sinje0816/stamping_press/SYEI_stamping_press_system/new_stamping_press/new/INVERTERBRACKET/EWR14S01-變頻器固定座.PDF

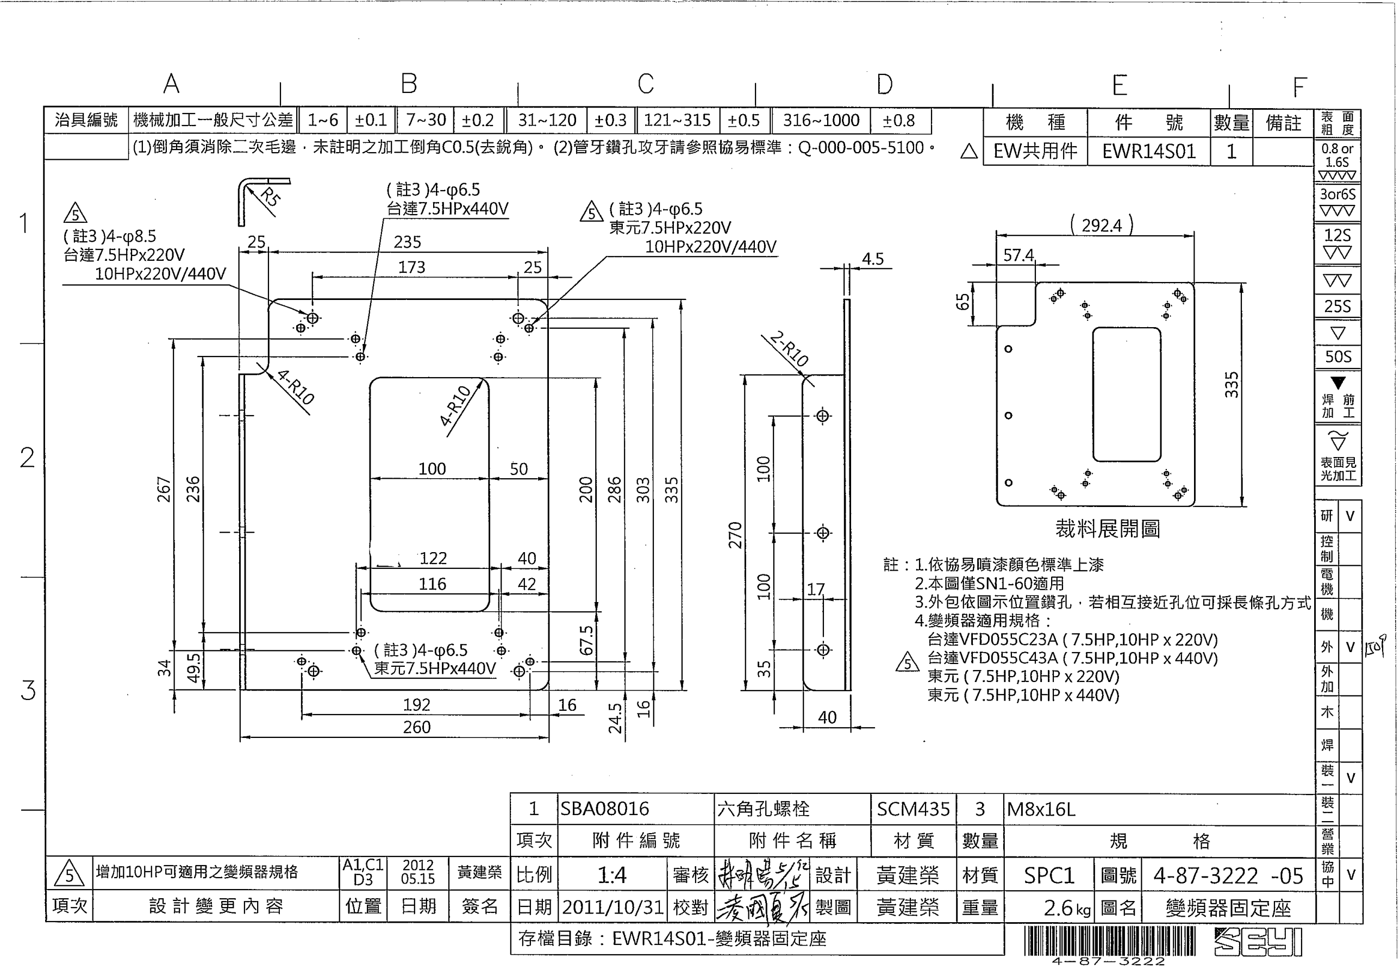
[picture p1: page 1]
