sinje0816/stamping_press/SYEI_stamping_press_system/協易杯bead/dist/seyi/T溝詳圖.png

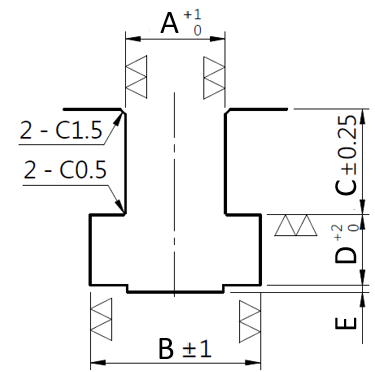
SYEI_stamping_press_system/協易杯bead/dist/seyi/T溝詳圖.png
