sinje0816/stamping_press/SYEI_stamping_press_system/組立尺寸.xlsx

Sheet: Assembly
編號 | 零件1 | 零件2 | 尺寸 | 平面 | 偏移方式
1 | FRAME35.1 | FRAME1.1 | 0 | xy plane | 1 | 0
2 | FRAME35.1 | FRAME1.1 | apv['FRAME1']["B"] | yz plane | 0
3 | FRAME35.1 | FRAME1.1 | (apv['FRAME22']['D']-Ass_A)/2+(apv['FRAME1']['CC']/2) | zx plane | 1
4 | FRAME2.1 | FRAME1.1 | 0 | xy plane | 0
5 | FRAME2.1 | FRAME1.1 | 0 | yz plane | 0
6 | FRAME2.1 | FRAME1.1 | -(apv['FRAME22']['D']+(apv['FRAME1']['CC']/2)+(apv['FRAME2']['CC']/2)) | zx plane | 0
7 | FRAME35.2 | FRAME2.1 | apv['FRAME35']['K']-apv['FRAME35']['L'] | xy plane | 0
8 | FRAME35.2 | FRAME2.1 | -(apv['FRAME2']['B']) | yz plane | 0
9 | FRAME35.2 | FRAME2.1 | (apv['FRAME22']['D']-Ass_A)/2+apv['FRAME2']['CC']/2 | zx plane | 0
10 | FRAME10.1 | FRAME1.1 | 0 | xy plane | 1
11 | FRAME10.1 | FRAME1.1 | -(apv['FRAME10']['B']) | yz plane | 0
12 | FRAME10.1 | FRAME1.1 | (apv['FRAME22']['D']-Ass_A)/2+apv['FRAME1']['CC']/2 | zx plane | 1
13 | FRAME10.2 | FRAME2.1 | apv["FRAME10"]["K(2)"] | xy plane | 0
14 | FRAME10.2 | FRAME2.1 | -(apv['FRAME10']['B']) | yz plane | 0
15 | FRAME10.2 | FRAME2.1 | (apv['FRAME22']['D']-Ass_A)/2+apv['FRAME2']['CC']/2 | zx plane | 0
16 | FRAME22.1 | FRAME35.1 | -((apv['FRAME1']['E']-apv['FRAME1']['DD'])-apv['FRAME22']['A(1)']-apv['FRAME22']['A(2)']) | xy plane | 1
17 | FRAME22.1 | FRAME35.1 | apv['FRAME22']['O'] | yz plane | 0
18 | FRAME22.1 | FRAME1.1 | apv['FRAME22']['D']+apv['FRAME1']['CC']/2 | zx plane | 0
19 | FRAME33.1 | FRAME1.1 | 0 | xy plane | 0
20 | FRAME33.1 | FRAME1.1 | -(apv['FRAME1']['B']-apv['FRAME33']['B']) | yz plane | 0
21 | FRAME33.1 | FRAME1.1 | -(apv['FRAME33']['K']+apv['FRAME1']['CC']/2) | zx plane | 0
22 | FRAME34.1 | FRAME2.1 | 0 | xy plane | 0
23 | FRAME34.1 | FRAME2.1 | -(apv['FRAME2']['B']-apv['FRAME34']['B']) | yz plane | 0
24 | FRAME34.1 | FRAME2.1 | apv['FRAME2']['CC']/2 | zx plane | 0
25 | FRAME7.1 | FRAME2.1 | -((apv['FRAME2']['E']-apv['FRAME2']['DD'])-apv['FRAME7']['A']-apv['FRAME7']['Y']) | xy plane | 0
26 | FRAME7.1 | FRAME2.1 | -(apv["FRAME2"]["B"]-Ass_B) | yz plane | 0
27 | FRAME7.1 | FRAME2.1 | Ass_E | zx plane | 0
28 | FRAME19.1 | FRAME1.1 | -((apv['FRAME1']['E']-apv['FRAME19']['D']) | xy plane | 0
29 | FRAME19.1 | FRAME1.1 | -(apv['FRAME1']['B']-Ass_C) | yz plane | 0
30 | FRAME19.1 | FRAME1.1 | -(apv['FRAME1']['CC']/2+apv['FRAME19']['AH']) | zx plane | 0
31 | FRAME19.2 | FRAME2.1 | -((apv['FRAME1']['E']-apv['FRAME19']['D']) | xy plane | 0
32 | FRAME19.2 | FRAME2.1 | -(apv['FRAME2']['B']-Ass_C) | yz plane | 0
33 | FRAME19.2 | FRAME2.1 | apv['FRAME2']['CC']/2 | zx plane | 0
34 | FRAME9.1 | FRAME2.1 | 0 | xy plane | 0
35 | FRAME9.1 | FRAME2.1 | 0 | yz plane | 0
36 | FRAME9.1 | FRAME2.1 | apv['FRAME2']['CC']/2 | zx plane | 0
37 | FRAME8.1 | FRAME1.1 | -Acc_D | xy plane | 0
38 | FRAME8.1 | FRAME1.1 | -(apv['FRAME1']['B']-Ass_B-apv['FRAME8']['B']) | yz plane | 0
39 | FRAME8.1 | FRAME1.1 | -Ass_E | zx plane | 1
40 | FRAME30.1 | FRAME2.1 | apv['FRAME2']['A']-apv['FRAME30']['A'] | xy plane | 0
41 | FRAME30.1 | FRAME2.1 | -(apv['FRAME2']['F']-(apv['FRAME30']['M']/2)) | yz plane | 0
42 | FRAME30.1 | FRAME2.1 | apv['FRAME2']['CC']/2 | zx plane | 0
43 | FRAME3.1 | FRAME1.1 | -(apv['FRAME1']['A']-apv['FRAME3']['A']) | xy plane | 0
44 | FRAME3.1 | FRAME1.1 | -(apv['FRAME1']['F']-Ass_F) | yz plane | 0
45 | FRAME3.1 | FRAME1.1 | -(apv['FRAME1']['CC']/2+apv['FRAME3']['B']) | zx plane | 0
46 | FRAME4.1 | FRAME2.1 | -(apv['FRAME2']['A']-apv['FRAME4']['A']) | xy plane | 0
47 | FRAME4.1 | FRAME2.1 | -(apv['FRAME2']['F']-Ass_G) | yz plane | 0
48 | FRAME4.1 | FRAME2.1 | apv['FRAME2']['CC']/2 | zx plane | 0
49 | FRAME31.1 | FRAME4.1 | -(apv['FRAME4']['A']-apv['FRAME4']['a']-apv['FRAME4']['b']/2) | xy plane | 0
50 | FRAME31.1 | FRAME4.1 | -(apv['FRAME4']['C']-Ass_H) | yz plane | 0
51 | FRAME31.1 | FRAME4.1 | apv['FRAME4']['B']/2-apv['FRAME4']['b']/2 | zx plane | 0
52 | FRAME27.1 | FRAME1.1 | -(apv['FRAME1']['A']-apv['FRAME27']['A']) | xy plane | 0
53 | FRAME27.1 | FRAME1.1 | -(apv['FRAME1']['F']-apv['FRAME27']['B']-apv['FRAME30']['M']-apv['FRAME27']['J']) | yz plane | 0
54 | FRAME27.1 | FRAME1.1 | -(apv['FRAME1']['CC']/2) | zx plane | 0
55 | FRAME27_1.1 | FRAME2.1 | -(apv['FRAME2']['A']-apv['FRAME27_1']['A']) | xy plane | 0
56 | FRAME27_1.1 | FRAME2.1 | -(apv['FRAME2']['F']-apv['FRAME27_1']['B']-apv['FRAME30']['M']-apv['FRAME27_1']['J']) | yz plane | 0
57 | FRAME27_1.1 | FRAME2.1 | apv['FRAME27_1']['I']+apv['FRAME2']['CC']/2 | zx plane | 0
58 | FRAME24.1 | FRAME30.1 | -(apv['FRAME30']['A']-apv['FRAME24']['B']) | xy plane | 0
59 | FRAME24.1 | FRAME30.1 | apv['FRAME24']['A']+apv['FRAME30']['M']/2 | yz plane | 0
60 | FRAME24.1 | FRAME30.1 | apv['FRAME30']['E']-(apv['FRAME24']['I']-apv['FRAME2']['CC']) | zx plane | 0
61 | FRAME24_1.1 | FRAME30.1 | -(apv['FRAME30']['A']-apv['FRAME24']['B']) | xy plane | 0
62 | FRAME24_1.1 | FRAME30.1 | apv['FRAME24']['A']+apv['FRAME30']['M']/2 | yz plane | 0
63 | FRAME24_1.1 | FRAME30.1 | (apv['FRAME24']['I']-apv['FRAME2']['CC']) | zx plane | 0
64 | FRAME11.1 | FRAME3.1 | -(apv['FRAME3']['A']-apv['FRAME3']['E']-apv['FRAME11']['A']/2) | xy plane | 0
65 | FRAME11.1 | FRAME3.1 | apv['FRAME3']['O']+Ass_I | yz plane | 0
66 | FRAME11.1 | FRAME3.1 | apv['FRAME3']['B']/2+apv['FRAME11']['A']/2 | zx plane | 0
67 | FRAME36.1 | FRAME4.1 | -((Ass_J-apv['FRAME36']['A']/2)+(apv['FRAME4']['A']-apv['FRAME4']['a'])) | xy plane | 0
68 | FRAME36.1 | FRAME4.1 | -(apv['FRAME4']['K']) | yz plane | 0
69 | FRAME36.1 | FRAME4.1 | apv['FRAME4']['B']-apv['FRAME36']['D'] | zx plane | 0
70 | FRAME5.1 | FRAME2.1 | -(apv['FRAME2']['A']-apv['FRAME2']['bbbbb']-Ass_K) | xy plane | 0
71 | FRAME5.1 | FRAME2.1 | apv['FRAME5']['A']+Ass_L+apv['FRAME32']['C'] | yz plane | 1
72 | FRAME5.1 | FRAME2.1 | apv['FRAME2']['CC'])/2 | zx plane | 0
73 | FRAME32.1 | FRAME2.1 | -(apv['FRAME2']['A']-apv['FRAME2']['bbbbb']-Ass_K-apv['FRAME32']['A']) | xy plane | 0
74 | FRAME32.1 | FRAME2.1 | -(Ass_L) | yz plane | 0
75 | FRAME32.1 | FRAME2.1 | apv['FRAME2']['CC'])/2 | zx plane | 0
76 | FRAME18.1 | FRAME1.1 | -(apv['FRAME1']['A']-apv['FRAME1']['bbbbb']-Ass_M-apv['FRAME18']['F']) | xy plane | 0
77 | FRAME18.1 | FRAME1.1 | -(apv['FRAME18']['A']+Ass_N) | yz plane | 0
78 | FRAME18.1 | FRAME1.1 | -(apv['FRAME1']['CC'])/2) | zx plane | 0
79 | FRAME26.1 | FRAME18.1 | apv['FRAME26']['B'] | xy plane | 0
80 | FRAME26.1 | FRAME18.1 | -Ass_O | yz plane | 1
81 | FRAME26.1 | FRAME18.1 | 0 | zx plane | 1
82 | FRAME26.2 | FRAME18.1 | apv['FRAME26']['B'] | xy plane | 0
83 | FRAME26.2 | FRAME18.1 | -(apv['FRAME18']['A']-(Ass_O+apv['FRAME26']['I'])) | yz plane | 1
84 | FRAME26.2 | FRAME18.1 | 0 | zx plane | 1
85 | FRAME25.1 | FRAME4.1 | -((Ass_J-apv['FRAME25']['B']/2)+(apv['FRAME4']['A']-apv['FRAME4']['a'])) | xy plane | 0
86 | FRAME25.1 | FRAME4.1 | -(apv['FRAME4']['K']) | yz plane | 0
87 | FRAME25.1 | FRAME4.1 | Ass_P+apv['FRAME4']['B']/2 | zx plane | 0
88 | FRAME6.1 | FRAME4.1 | Ass_Q-(apv['FRAME4']['A']-apv['FRAME4']['a'])-apv['FRAME6']['E']/2 | xy plane | 0
89 | FRAME6.1 | FRAME4.1 | 0 | yz plane | 1
90 | FRAME6.1 | FRAME4.1 | -(apv['FRAME4']['B']/2-apv['FRAME6']['f']) | zx plane | 1
91 | FRAME6.2 | FRAME4.1 | Ass_Q-(apv['FRAME4']['A']-apv['FRAME4']['a'])-apv['FRAME6']['E']/2 | xy plane | 0
92 | FRAME6.2 | FRAME4.1 | apv['FRAME6']['i'] | yz plane | 1
93 | FRAME6.2 | FRAME4.1 | apv['FRAME4']['B']/2+apv['FRAME6']['f'] | zx plane | 0
94 | FRAME29.1 | FRAME4.1 | -(Ass_Q+(apv['FRAME4']['A']-apv['FRAME4']['a'])-apv['FRAME29']['A']/2) | xy plane | 0
95 | FRAME29.1 | FRAME4.1 | apv['FRAME29']['B'] | yz plane | 0
96 | FRAME29.1 | FRAME4.1 | apv['FRAME4']['B']/2-apv['FRAME6']['e']+apv['FRAME29']['A']/2 | zx plane | 0
97 | FRAME29.2 | FRAME4.1 | -(Ass_Q+(apv['FRAME4']['A']-apv['FRAME4']['a'])-apv['FRAME29']['A']/2) | xy plane | 0
98 | FRAME29.2 | FRAME4.1 | apv['FRAME29']['B'] | yz plane | 0
99 | FRAME29.2 | FRAME4.1 | apv['FRAME4']['B']/2+apv['FRAME6']['e']+apv['FRAME29']['A']/2 | zx plane | 0
100 | FRAME20.1 | FRAME2.1 | -(apv['FRAME1']['A']-apv['FRAME1']['bbbbb']-Ass_R-apv['FRAME20']['H']) | xy plane | 0
101 | FRAME20.1 | FRAME2.1 | -(apv['FRAME20']['A']+Ass_N) | yz plane | 0
102 | FRAME20.1 | FRAME2.1 | apv['FRAME20']['B']+apv['FRAME1']['CC']/2 | zx plane | 0
103 | FRAME26.3 | FRAME20.1 | apv['FRAME26']['B'] | xy plane | 0
104 | FRAME26.3 | FRAME20.1 | Ass_O+apv['FRAME26']['I'] | yz plane | 0
105 | FRAME26.3 | FRAME20.1 | -(apv['FRAME20']['B']) | zx plane | 0
106 | FRAME26.4 | FRAME20.1 | apv['FRAME26']['B'] | xy plane | 0
107 | FRAME26.4 | FRAME20.1 | apv['FRAME20']['A']-Ass_O | yz plane | 0
108 | FRAME26.4 | FRAME20.1 | -(apv['FRAME20']['B']) | zx plane | 0
109 | FRAME14.1 | FRAME2.1 | -(apv['FRAME2']['A']-apv['FRAME30']['A']-Ass_S-apv['FRAME14']['g3']) | xy plane | 0
110 | FRAME14.1 | FRAME2.1 | apv['FRAME2']['F']-apv['FRAME2']['G']-apv['FRAME14']['B']-apv['FRAME2']['FF'] | yz plane | 1
111 | FRAME14.1 | FRAME2.1 | apv['FRAME14']['A']+apv['FRAME2']['CC']/2 | zx plane | 0
112 | FRAME17.1 | FRAME1.1 | -(apv['FRAME1']['A']-apv['FRAME30']['A']-Ass_S-apv['FRAME17']['g3']) | xy plane | 0
113 | FRAME17.1 | FRAME1.1 | apv['FRAME1']['F']-apv['FRAME1']['G']-apv['FRAME17']['B']-apv['FRAME2']['FF'] | yz plane | 1
114 | FRAME17.1 | FRAME1.1 | -(apv['FRAME2']['CC']/2) | zx plane | 0
115 | FRAME15.1 | FRAME1.1 | -(apv['FRAME1']['A']-apv['FRAME30']['A']-Ass_S-apv['FRAME17']['g3']) | xy plane | 0
116 | FRAME15.1 | FRAME1.1 | apv['FRAME1']['F']-apv['FRAME1']['G']-Ass_T | yz plane | 1
117 | FRAME15.1 | FRAME1.1 | apv['FRAME3']['B']/2-Ass_U+apv['FRAME1']['CC']/2-apv['FRAME15']['B'] | zx plane | 1
118 | FRAME15.2 | FRAME2.1 | -(apv['FRAME2']['A']-apv['FRAME30']['A']-Ass_S-apv['FRAME17']['g3']) | xy plane | 0
119 | FRAME15.2 | FRAME2.1 | apv['FRAME2']['F']-apv['FRAME2']['G']-Ass_T | yz plane | 1
120 | FRAME15.2 | FRAME2.1 | -(apv['FRAME3']['B']/2-Ass_U+apv['FRAME1']['CC']/2) | zx plane | 1
121 | FRAME13.1 | FRAME2.1 | -(apv['FRAME2']['A']-apv['FRAME30']['A']-(apv['FRAME17']['g3']-apv['FRAME17']['g2'])-apv['FRAME13']['k']-apv['FRAME13']['j']-Ass_V-Ass_S) | xy plane | 0
122 | FRAME13.1 | FRAME2.1 | apv['FRAME2']['F']-apv['FRAME2']['G']-apv['FRAME2']['FF'] | yz plane | 1
123 | FRAME13.1 | FRAME2.1 | -apv['FRAME1']['CC']/2 | zx plane | 1
124 | FRAME16.1 | FRAME1.1 | -(apv['FRAME2']['A']-apv['FRAME30']['A']-(apv['FRAME17']['g3']-apv['FRAME17']['g2'])-apv['FRAME13']['k']-apv['FRAME13']['j']-Ass_V-Ass_S) | xy plane | 0
125 | FRAME16.1 | FRAME1.1 | apv['FRAME2']['F']-apv['FRAME2']['G'] | yz plane | 1
126 | FRAME16.1 | FRAME1.1 | apv['FRAME1']['CC']/2+apv['FRAME13']['E'] | zx plane | 1
127 | FRAME21.1 | FRAME1.1 | apv['FRAME2']['A']-apv['FRAME30']['A']-(apv['FRAME17']['g3']-apv['FRAME17']['g2'])-apv['FRAME13']['k']-apv['FRAME13']['j']-Ass_V-Ass_S | xy plane | 1
128 | FRAME21.1 | FRAME1.1 | apv['FRAME2']['F']-apv['FRAME2']['G']-Ass_T-apv['FRAME21']['D'] | yz plane | 0
129 | FRAME21.1 | FRAME1.1 | -(apv['FRAME3']['B']/2-Ass_U+apv['FRAME1']['CC']/2-apv['FRAME21']['C']) | zx plane | 0
130 | FRAME21.2 | FRAME2.1 | apv['FRAME2']['A']-apv['FRAME30']['A']-(apv['FRAME17']['g3']-apv['FRAME17']['g2'])-apv['FRAME13']['k']-apv['FRAME13']['j']-Ass_V-Ass_S | xy plane | 1
131 | FRAME21.2 | FRAME2.1 | apv['FRAME2']['F']-apv['FRAME2']['G']-Ass_T-apv['FRAME21']['D'] | yz plane | 0
132 | FRAME21.2 | FRAME2.1 | -(apv['FRAME3']['B']/2-Ass_U+apv['FRAME1']['CC']/2) | zx plane | 0
133 | FRAME38.1 | FRAME19.2 | -(apv['FRAME19']['A']-Ass_W-apv['FRAME38']['A']-apv['FRAME3']['C']) | xy plane | 0
134 | FRAME38.1 | FRAME19.2 | Ass_X | yz plane | 1
135 | FRAME38.1 | FRAME19.2 | -(apv['FRAME19']['AH']+apv['FRAME38']['B']) | zx plane | 1
136 | FRAME12.1 | FRAME3.1 | 0 | xy plane | 0
137 | FRAME12.1 | FRAME3.1 | -(apv['FRAME3']['O']) | yz plane | 1
138 | FRAME12.1 | FRAME3.1 | apv['FRAME19']['AH'] | zx plane | 0
139 | FRAME38.2 | FRAME19.1 | -(apv['FRAME19']['A']-Ass_W-apv['FRAME38']['A']-apv['FRAME3']['C']) | xy plane | 0
140 | FRAME38.2 | FRAME19.1 | -(Ass_X+apv["FRAME38"]["C"]) | yz plane | 0
141 | FRAME38.2 | FRAME19.1 | -(apv['FRAME38']['B']) | zx plane | 0
142 | FRAME37.1 | FRAME2.1 | -(apv["FRAME2"]["A"]-apv["FRAME2"]["ffff"]-apv["FRAME37"]["A"]/2) | xy plane | 0
143 | FRAME37.1 | FRAME2.1 | -(apv["FRAME2"]["F"]-apv["FRAME2"]["eeee"]-apv["FRAME37"]["A"]/2) | yz plane | 0
144 | FRAME37.1 | FRAME2.1 | apv["FRAME2"]["CC"]/2 | zx plane | 0
145 | FRAME23.1 | FRAME1.1 | -(apv["FRAME1"]["E"]-apv["FRAME1"]["FF"]-apv["FRAME23"]["I"]) | xy plane | 0
146 | FRAME23.1 | FRAME1.1 | -(apv['FRAME1']['B']-apv['FRAME23']['B'])-zeta | yz plane | 0
147 | FRAME23.1 | FRAME1.1 | -(apv['FRAME1']['CC']/2+apv['FRAME23']['A']) | zx plane | 1
148 | FRAME23.2 | FRAME1.1 | -(apv["FRAME1"]["E"]-apv["FRAME1"]["FF"]-apv["FRAME23"]["I"]) | xy plane | 0
149 | FRAME23.2 | FRAME1.1 | -(apv["FRAME23"]["B"]/2+assmebly_par['Ass_Y']) | yz plane | 0
150 | FRAME23.2 | FRAME1.1 | -(apv['FRAME1']['CC']/2+apv['FRAME23']['A']) | zx plane | 1
151 | FRAME23.3 | FRAME2.1 | -(apv["FRAME1"]["E"]-apv["FRAME1"]["FF"]-apv["FRAME23"]["I"]) | xy plane | 0
152 | FRAME23.3 | FRAME2.1 | (apv['FRAME2']['B']-apv['FRAME23']['B'])+zeta | yz plane | 1
153 | FRAME23.3 | FRAME2.1 | -(apv['FRAME2']['CC']/2+apv['FRAME23']['A']) | zx plane | 0
154 | FRAME23.4 | FRAME2.1 | -(apv["FRAME1"]["E"]-apv["FRAME1"]["FF"]-apv["FRAME23"]["I"]) | xy plane | 0
155 | FRAME23.4 | FRAME2.1 | (apv["FRAME23"]["B"]/2+assmebly_par['Ass_Y']) | yz plane | 1
156 | FRAME23.4 | FRAME2.1 | -(apv['FRAME2']['CC']/2+apv['FRAME23']['A']) | zx plane | 0
158 | FRAME28.1 | FRAME30.1 | 0 | xy plane | 0
159 | FRAME28.1 | FRAME30.1 | apv["FRAME30"]["M"]/2+apv["FRAME28"]["A"] | yz plane | 0
160 | FRAME28.1 | FRAME30.1 | apv["FRAME27"]["I"] | zx plane | 0
161 | FRAME41.1 | FRAME1.1 |  | xy plane
162 | FRAME41.1 | FRAME1.1 |  | yz plane
163 | FRAME41.1 | FRAME1.1 |  | zx plane
164 | FRAME41.2 | FRAME2.1 |  | xy plane
165 | FRAME41.2 | FRAME2.1 |  | yz plane
166 | FRAME41.2 | FRAME2.1 |  | zx plane
167 | FRAME42.1 | FRAME1.1 |  | xy plane
168 | FRAME42.1 | FRAME1.1 |  | yz plane
169 | FRAME42.1 | FRAME1.1 |  | zx plane
170 | FRAME42.2 | FRAME2.1 |  | xy plane
171 | FRAME42.2 | FRAME2.1 |  | yz plane
172 | FRAME42.2 | FRAME2.1 |  | zx plane
173 | FRAME50.1 | FRAME4.1 |  | xy plane
174 | FRAME50.1 | FRAME4.1 |  | yz plane
175 | FRAME50.1 | FRAME4.1 |  | zx plane
176 | FRAME49.1 | FRAME4.1 |  | xy plane
177 | FRAME49.1 | FRAME4.1 |  | yz plane
178 | FRAME49.1 | FRAME4.1 |  | zx plane
179 | FRAME48.1 | FRAME8.1 |  | xy plane
180 | FRAME48.1 | FRAME8.1 |  | yz plane
181 | FRAME48.1 | FRAME8.1 |  | zx plane
182 | FRAME48.2 | FRAME8.1 |  | xy plane
183 | FRAME48.2 | FRAME8.1 |  | yz plane
184 | FRAME48.2 | FRAME8.1 |  | zx plane
185 | FRAME23.5 | FRAME22.1 |  | xy plane
186 | FRAME23.5 | FRAME22.1 |  | yz plane
187 | FRAME23.5 | FRAME22.1 |  | zx plane
188 | FRAME47.1 | FRAME22.1 |  | xy plane
189 | FRAME47.1 | FRAME7.1 |  | yz plane
190 | FRAME47.1 | FRAME22.1 |  | zx plane
191 | FRAME45.1 | FRAME13.1 |  | xy plane
192 | FRAME45.1 | FRAME13.1 |  | yz plane
193 | FRAME45.1 | FRAME13.1 |  | zx plane
194 | FRAME45.2 | FRAME13.2 |  | xy plane
195 | FRAME45.2 | FRAME13.2 |  | yz plane
196 | FRAME45.2 | FRAME13.2 |  | zx plane
197 | FRAME43.1 | FRAME13.1 |  | xy plane
198 | FRAME43.1 | FRAME13.1 |  | yz plane
199 | FRAME43.1 | FRAME13.1 |  | zx plane
200 | FRAME43.2 | FRAME13.2 |  | xy plane
201 | FRAME43.2 | FRAME13.2 |  | yz plane
202 | FRAME43.2 | FRAME13.2 |  | zx plane
203 | FRAME29.3 | FRAME4.1 |  | xy plane
204 | FRAME29.3 | FRAME4.1 |  | yz plane
205 | FRAME29.3 | FRAME4.1 |  | zx plane
206 | FRAME29.4 | FRAME4.1 |  | xy plane
207 | FRAME29.4 | FRAME4.1 |  | yz plane
208 | FRAME29.4 | FRAME4.1 |  | zx plane
209 | FRAME54.1 | FRAME30.1 |  | xy plane
210 | FRAME54.1 | FRAME30.1 |  | yz plane
211 | FRAME54.1 | FRAME30.1 |  | zx plane
212 | FRAME52.1 | FRAME22.1 |  | xy plane
213 | FRAME52.1 | FRAME22.1 |  | yz plane
214 | FRAME52.1 | FRAME22.1 |  | zx plane
215 | FRAME52.2 | FRAME22.1 |  | xy plane
216 | FRAME52.2 | FRAME22.1 |  | yz plane
217 | FRAME52.2 | FRAME22.1 |  | zx plane
218 | FRAME53.1 | FRAME11.1 |  | xy plane
219 | FRAME53.1 | FRAME11.1 |  | yz plane
220 | FRAME53.1 | FRAME11.1 |  | zx plane
221 | FRAME53_1.1 | FRAME11.1 |  | xy plane
222 | FRAME53_1.1 | FRAME11.1 |  | yz plane
223 | FRAME53_1.1 | FRAME11.1 |  | zx plane
224 | crankshaft.1 | FRAME30.1 |  | xy plane
225 | crankshaft.1 | FRAME30.2 |  | yz plane
226 | crankshaft.1 | FRAME30.3 |  | zx plane
227 | S_i.CON_ROD_CAP_list[i]+'.1' | crankshaft.1 |  | xy plane
228 | S_i.CON_ROD_CAP_list[i]+'.1' | crankshaft.1 |  | yz plane
229 | S_i.CON_ROD_CAP_list[i]+'.1' | crankshaft.1 |  | zx plane
230 | S_i.CON_ROD_BASE_list[i]+'.1' | crankshaft.1 |  | xy plane
231 | S_i.CON_ROD_BASE_list[i]+'.1' | crankshaft.1 |  | yz plane
232 | S_i.CON_ROD_BASE_list[i]+'.1' | crankshaft.1 |  | zx plane
233 | S_i.CON_ROD_list[i] | S_i.CON_ROD_CAP_list[i]+'.1' |  | xy plane
234 | S_i.CON_ROD_list[i] | S_i.CON_ROD_CAP_list[i]+'.1' |  | yz plane
235 | S_i.CON_ROD_list[i] | S_i.CON_ROD_CAP_list[i]+'.1' |  | zx plane
236 | S_i.PANEL_list[i]+'.1' | crankshaft.1 |  | xy plane
237 | S_i.PANEL_list[i]+'.1' | crankshaft.1 |  | yz plane
238 | S_i.PANEL_list[i]+'.1' | crankshaft.1 |  | zx plane
239 | S_i.POINTER_list[i]+'.1' | S_i.PANEL_list[i]+'.1' |  | xy plane
240 | S_i.POINTER_list[i]+'.1' | S_i.PANEL_list[i]+'.1' |  | yz plane
241 | S_i.POINTER_list[i]+'.1' | S_i.PANEL_list[i]+'.1' |  | zx plane
242 | S_i.COVER_list[i]+'.1' | FRAME1.1 |  | xy plane
243 | S_i.COVER_list[i]+'.1' | FRAME1.1 |  | yz plane
244 | S_i.COVER_list[i]+'.1' | FRAME1.1 |  | zx plane
245 | S_i.PLUG_list+'.1' | S_i.COVER_list[i]+'.1' |  | xy plane
246 | S_i.PLUG_list+'.1' | S_i.COVER_list[i]+'.1' |  | yz plane
247 | S_i.PLUG_list+'.1' | S_i.COVER_list[i]+'.1' |  | zx plane
248 | S_i.slide_gib_list_left+'.1' | FRAME1.1 |  | xy plane
249 | S_i.slide_gib_list_left+'.1' | FRAME1.1 |  | yz plane
250 | S_i.slide_gib_list_left+'.1' | FRAME1.1 |  | zx plane
251 | S_i.slide_gib_list_right+'.1' | S_i.slide_gib_list_left+'.1' |  | xy plane
252 | S_i.slide_gib_list_right+'.1' | S_i.slide_gib_list_left+'.1' |  | yz plane
253 | S_i.slide_gib_list_right+'.1' | S_i.slide_gib_list_left+'.1' |  | zx plane
254 | 'OGASKL060_OIL_LEVEL_GAUGE.1' | FRAME1.1 |  | xy plane
255 | 'OGASKL060_OIL_LEVEL_GAUGE.1' | FRAME1.1 |  | yz plane
256 | 'OGASKL060_OIL_LEVEL_GAUGE.1' | FRAME1.1 |  | zx plane
257 | S_i.OIL_LEVEL_GAUGE_list_CON_ROD+'.1' | S_i.CON_ROD_list[i]+'.1' |  | xy plane
258 | S_i.OIL_LEVEL_GAUGE_list_CON_ROD+'.1' | S_i.CON_ROD_list[i]+'.1' |  | yz plane
259 | S_i.OIL_LEVEL_GAUGE_list_CON_ROD+'.1' | S_i.CON_ROD_list[i]+'.1' |  | zx plane
260 | 'EWR60S01_ELECTRIC_BOX_PLATE.1' | 'FRAME2.1' |  | xy plane
261 | 'EWR60S01_ELECTRIC_BOX_PLATE.1' | 'FRAME2.1' |  | yz plane
262 | 'EWR60S01_ELECTRIC_BOX_PLATE.1' | 'FRAME2.1' |  | zx plane
263 | 'EWR60S01_ELECTRIC_BOX_PLATE.2' | 'EWR60S01_ELECTRIC_BOX_PLATE.1' |  | xy plane
264 | 'EWR60S01_ELECTRIC_BOX_PLATE.2' | 'EWR60S01_ELECTRIC_BOX_PLATE.1' |  | yz plane
265 | 'EWR60S01_ELECTRIC_BOX_PLATE.2' | 'EWR60S01_ELECTRIC_BOX_PLATE.1' |  | zx plane
266 | S_i.ELECTRIC_BOX_list_normal[i]+'.1' | 'EWR60S01_ELECTRIC_BOX_PLATE.1' |  | xy plane
267 | S_i.ELECTRIC_BOX_list_normal[i]+'.1' | 'EWR60S01_ELECTRIC_BOX_PLATE.1' |  | yz plane
268 | S_i.ELECTRIC_BOX_list_normal[i]+'.1' | 'EWR60S01_ELECTRIC_BOX_PLATE.1' |  | zx plane
269 | S_i.PANEL_BOX_BRACKET_list_normal[i] + '.1' | S_i.ELECTRIC_BOX_list_normal[i]+'.1' |  | xy plane
270 | S_i.PANEL_BOX_BRACKET_list_normal[i] + '.1' | S_i.ELECTRIC_BOX_list_normal[i]+'.1' |  | yz plane
271 | S_i.PANEL_BOX_BRACKET_list_normal[i] + '.1' | S_i.ELECTRIC_BOX_list_normal[i]+'.1' |  | zx plane
272 | S_i.PANEL_BOX_list_normal[i] + '.1' | S_i.PANEL_BOX_BRACKET_list_normal[i] + '.1' |  | xy plane
273 | S_i.PANEL_BOX_list_normal[i] + '.1' | S_i.PANEL_BOX_BRACKET_list_normal[i] + '.1' |  | yz plane
274 | S_i.PANEL_BOX_list_normal[i] + '.1' | S_i.PANEL_BOX_BRACKET_list_normal[i] + '.1' |  | zx plane
275 | S_i.CONTROL_PANEL_list_normal[i] + '.1' | S_i.PANEL_BOX_list_normal[i] + '.1' |  | xy plane
276 | S_i.CONTROL_PANEL_list_normal[i] + '.1' | S_i.PANEL_BOX_list_normal[i] + '.1' |  | yz plane
277 | S_i.CONTROL_PANEL_list_normal[i] + '.1' | S_i.PANEL_BOX_list_normal[i] + '.1' |  | zx plane
278 | EGPSSGD1000IS_MOUNT_FILTER | FRAME1.1 |  | xy plane
279 | EGPSSGD1000IS_MOUNT_FILTER | FRAME1.1 |  | yz plane
280 | EGPSSGD1000IS_MOUNT_FILTER | FRAME1.1 |  | zx plane
281 | S_i.TRADEMARK_NAMEPLATE_list_normal[i]+'.1' | FRAME1.1 |  | xy plane
282 | S_i.TRADEMARK_NAMEPLATE_list_normal[i]+'.1' | FRAME1.1 |  | yz plane
283 | S_i.TRADEMARK_NAMEPLATE_list_normal[i]+'.1' | FRAME1.1 |  | zx plane
284 | S_i.TRADEMARK_NAMEPLATE_list_normal[i]+'.2' | FRAME2.1 |  | xy plane
285 | S_i.TRADEMARK_NAMEPLATE_list_normal[i]+'.2' | FRAME2.1 |  | yz plane
286 | S_i.TRADEMARK_NAMEPLATE_list_normal[i]+'.2' | FRAME2.1 |  | zx plane
287 | S_i.NAME_PLATE_list_normal[i]+'.1' | FRAME1.1 |  | xy plane
288 | S_i.NAME_PLATE_list_normal[i]+'.1' | FRAME1.1 |  | yz plane
289 | S_i.NAME_PLATE_list_normal[i]+'.1' | FRAME1.1 |  | zx plane
290 | S_i.GUARD_FLYWHEEL_list_normal[i]+'.1' | FRAME30.1 |  | xy plane
291 | S_i.GUARD_FLYWHEEL_list_normal[i]+'.1' | FRAME30.1 |  | yz plane
292 | S_i.GUARD_FLYWHEEL_list_normal[i]+'.1' | FRAME30.1 |  | zx plane
293 | BALL_SCREW.1 | OGASKL060_OIL_LEVEL_GAUGE.1 |  | xy plane
294 | BALL_SCREW.1 | OGASKL060_OIL_LEVEL_GAUGE.1 |  | yz plane
295 | BALL_SCREW.1 | OGASKL060_OIL_LEVEL_GAUGE.1 |  | zx plane
296 | S_i.PORTABLE_STAND_list[stamping_press_type]+'.1' | 'FRAME22.1' |  | xy plane
297 | S_i.PORTABLE_STAND_list[stamping_press_type]+'.1' | 'FRAME22.1' |  | yz plane
298 | S_i.PORTABLE_STAND_list[stamping_press_type]+'.1' | 'FRAME22.1' |  | zx plane
299 | S_i.OPERATION_BOX_list_normal[stamping_press_type] + '.1' | S_i.PORTABLE_STAND_list[stamping_press_type] + '.1' |  | xy plane
300 | S_i.OPERATION_BOX_list_normal[stamping_press_type] + '.1' | S_i.PORTABLE_STAND_list[stamping_press_type] + '.1' |  | yz plane
301 | S_i.OPERATION_BOX_list_normal[stamping_press_type] + '.1' | S_i.PORTABLE_STAND_list[stamping_press_type] + '.1' |  | zx plane
302 | S_i.BEARING_HOUSING_list[stamping_press_type] + '.1' | FRAME30.1 |  | xy plane
303 | S_i.BEARING_HOUSING_list[stamping_press_type] + '.1' | FRAME30.1 |  | yz plane
304 | S_i.BEARING_HOUSING_list[stamping_press_type] + '.1' | FRAME30.1 |  | zx plane
305 | plate.1 | FRAME22.1 |  | xy plane
306 | plate.1 | FRAME22.1 |  | yz plane
307 | plate.1 | FRAME22.1 |  | zx plane
308 | S_i.SLIDE_list_normal[stamping_press_type] + '.1' | plate.1 |  | xy plane
309 | S_i.SLIDE_list_normal[stamping_press_type] + '.1' | plate.1 |  | yz plane
310 | S_i.SLIDE_list_normal[stamping_press_type] + '.1' | plate.1 |  | zx plane
311 | S_i.BALANCER_list[stamping_press_type] + '.1' | 'FRAME1.1' |  | xy plane
312 | S_i.BALANCER_list[stamping_press_type] + '.1' | 'FRAME1.1' |  | yz plane
313 | S_i.BALANCER_list[stamping_press_type] + '.1' | 'FRAME1.1' |  | zx plane
314 | S_i.BALANCER_list[stamping_press_type] + '.2' | S_i.BALANCER_list[stamping_press_type] + '.1' |  | xy plane
315 | S_i.BALANCER_list[stamping_press_type] + '.2' | S_i.BALANCER_list[stamping_press_type] + '.1' |  | yz plane
316 | S_i.BALANCER_list[stamping_press_type] + '.2' | S_i.BALANCER_list[stamping_press_type] + '.1' |  | zx plane
317 | S_i.OIL_LEVEL_GAUGE_list_SLIDE[stamping_press_type] + '.1' | S_i.SLIDE_list_normal[stamping_press_type] + '.1' |  | xy plane
318 | S_i.OIL_LEVEL_GAUGE_list_SLIDE[stamping_press_type] + '.1' | S_i.SLIDE_list_normal[stamping_press_type] + '.1' |  | yz plane
319 | S_i.OIL_LEVEL_GAUGE_list_SLIDE[stamping_press_type] + '.1' | S_i.SLIDE_list_normal[stamping_press_type] + '.1' |  | zx plane
320 | S_i.OIL_LEVEL_GAUGE_list_SLIDE[stamping_press_type] + '.2' | S_i.SLIDE_list_normal[stamping_press_type] + '.1' |  | xy plane
321 | S_i.OIL_LEVEL_GAUGE_list_SLIDE[stamping_press_type] + '.2' | S_i.SLIDE_list_normal[stamping_press_type] + '.1' |  | yz plane
322 | S_i.OIL_LEVEL_GAUGE_list_SLIDE[stamping_press_type] + '.2' | S_i.SLIDE_list_normal[stamping_press_type] + '.1' |  | zx plane
323 | S_i.MOTOR_BRACKET_HP_list[stamping_press_type]+'.1' | 'FRAME20.1' |  | xy plane
324 | S_i.MOTOR_BRACKET_HP_list[stamping_press_type]+'.1' | 'FRAME20.1' |  | yz plane
325 | S_i.MOTOR_BRACKET_HP_list[stamping_press_type]+'.1' | 'FRAME20.1' |  | zx plane
326 | S_i.MOTOR_list[stamping_press_type]+'.1' | S_i.MOTOR_BRACKET_HP_list[stamping_press_type]+'.1' |  | xy plane
327 | S_i.MOTOR_list[stamping_press_type]+'.1' | S_i.MOTOR_BRACKET_HP_list[stamping_press_type]+'.1' |  | yz plane
328 | S_i.MOTOR_list[stamping_press_type]+'.1' | S_i.MOTOR_BRACKET_HP_list[stamping_press_type]+'.1' |  | zx plane
329 | 'MZW8702_WIRE_CASING.1' | S_i.ELECTRIC_BOX_list_normal[stamping_press_type] + '.1' |  | xy plane
330 | 'MZW8702_WIRE_CASING.1' | S_i.ELECTRIC_BOX_list_normal[stamping_press_type] + '.1' |  | yz plane
331 | 'MZW8702_WIRE_CASING.1' | S_i.ELECTRIC_BOX_list_normal[stamping_press_type] + '.1' |  | zx plane
332 | '43N6603_WIRE_CASING.1.1' | 'FRAME2.1' |  | xy plane
333 | '43N6603_WIRE_CASING.1.1' | 'FRAME2.1' |  | yz plane
334 | '43N6603_WIRE_CASING.1.1' | 'FRAME2.1' |  | zx plane
335 | '43N6604_WIRE_CASING.1' | '43N6603_WIRE_CASING.1.1' |  | xy plane
336 | '43N6604_WIRE_CASING.1' | '43N6603_WIRE_CASING.1.1' |  | yz plane
337 | '43N6604_WIRE_CASING.1' | '43N6603_WIRE_CASING.1.1' |  | zx plane
338 | 'FRAME_WIRE_CASING.1' | 'FRAME2.1' |  | xy plane
339 | 'FRAME_WIRE_CASING.1' | 'FRAME2.1' |  | yz plane
340 | 'FRAME_WIRE_CASING.1' | 'FRAME2.1' |  | zx plane
341 | 防震腳 | FRAME10.1 |  | xy plane
342 | 防震腳 | FRAME10.1 |  | yz plane
343 | 防震腳 | FRAME10.1 |  | zx plane
344 | 防震腳 | FRAME10.2 |  | xy plane
345 | 防震腳 | FRAME10.2 |  | yz plane
346 | 防震腳 | FRAME10.2 |  | zx plane
347 | 防震腳 | FRAME35.1 |  | xy plane
348 | 防震腳 | FRAME35.1 |  | yz plane
349 | 防震腳 | FRAME35.1 |  | zx plane
350 | 防震腳 | FRAME35.2 |  | xy plane
351 | 防震腳 | FRAME35.2 |  | yz plane
352 | 防震腳 | FRAME35.2 |  | zx plane
353 | S_i.INVERTER_D_S_list[stamping_press_type] + '.1' | FRAME2.1 |  | xy plane
354 | S_i.INVERTER_D_S_list[stamping_press_type] + '.1' | FRAME2.1 |  | yz plane
355 | S_i.INVERTER_D_S_list[stamping_press_type] + '.1' | FRAME2.1 |  | zx plane
356 | FRAME6.1 | FRAME19.1 |  | xy plane
357 | FRAME6.1 | FRAME19.1 |  | yz plane
358 | FRAME6.1 | FRAME19.1 |  | zx plane
359 | FRAME6.2 | FRAME19.2 |  | xy plane
360 | FRAME6.2 | FRAME19.2 |  | yz plane
361 | FRAME6.2 | FRAME19.2 |  | zx plane
362 | FRAME3.1 | FRAME11.1 |  | xy plane
363 | FRAME3.1 | FRAME11.1 |  | yz plane
364 | FRAME3.1 | FRAME11.1 |  | zx plane
365 | FRAME23_1.1 | FRAME22.1 |  | xy plane
366 | FRAME23_1.1 | FRAME22.1 |  | yz plane
367 | FRAME23_1.1 | FRAME22.1 |  | zx plane
368 | FRAME15.1 | FRAME1.1 |  | xy plane
369 | FRAME15.1 | FRAME1.1 |  | yz plane
370 | FRAME15.1 | FRAME1.1 |  | zx plane
371 | FRAME15.2 | FRAME2.1 |  | xy plane
372 | FRAME15.2 | FRAME2.1 |  | yz plane
373 | FRAME15.2 | FRAME2.1 |  | zx plane
374 | FRAME15.3 | FRAME1.1 |  | xy plane
375 | FRAME15.3 | FRAME1.1 |  | yz plane
376 | FRAME15.3 | FRAME1.1 |  | zx plane
377 | FRAME15.4 | FRAME2.1 |  | xy plane
378 | FRAME15.4 | FRAME2.1 |  | yz plane
379 | FRAME15.4 | FRAME2.1 |  | zx plane
380 | FRAME29.1 | FRAME4.1 |  | xy plane
381 | FRAME29.1 | FRAME4.1 |  | yz plane
382 | FRAME29.1 | FRAME4.1 |  | zx plane
383 | FRAME29.2 | FRAME4.1 |  | xy plane
384 | FRAME29.2 | FRAME4.1 |  | yz plane
385 | FRAME29.2 | FRAME4.1 |  | zx plane
386 | FRAME43.1 | FRaME13.1 |  | xy plane
387 | FRAME43.1 | FRaME13.1 |  | yz plane
388 | FRAME43.1 | FRaME13.1 |  | zx plane
389 | FRAME43.2 | FRAME 13_1.1 |  | xy plane
390 | FRAME43.2 | FRAME 13_1.1 |  | yz plane
391 | FRAME43.2 | FRAME 13_1.1 |  | zx plane
392 | FRAME47.1 | FRAME22.1 |  | xy plane
393 | FRAME47.1 | FRAME7.1 |  | yz plane
394 | FRAME47.1 | FRAME22.1 |  | zx plane
395 | FRAME48.1 | FRAME8.1 |  | xy plane
396 | FRAME48.1 | FRAME8.1 |  | yz plane
397 | FRAME48.1 | FRAME8.1 |  | zx plane
398 | FRAME48.2 | FRAME8.1 |  | xy plane
399 | FRAME48.2 | FRAME8.1 |  | yz plane
400 | FRAME48.2 | FRAME8.1 |  | zx plane
401 | FRAME49.1 | FRAME4.1 |  | xy plane
402 | FRAME49.1 | FRAME4.1 |  | yz plane
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
 |  |  |  | yz plane
 |  |  |  | zx plane
 |  |  |  | xy plane
 |  |  |  | yz plane
 |  |  |  | zx plane
 |  |  |  | xy plane
 |  |  |  | yz plane
 |  |  |  | zx plane
 |  |  |  | xy plane
 |  |  |  | yz plane
 |  |  |  | zx plane
 |  |  |  | xy plane
 |  |  |  | yz plane
 |  |  |  | zx plane

Sheet: Assembly_value
 | 25 | 35 | 45 | 60 | 80 | 110 | 160 | 200 | 250
Ass_A | 464 | 566 | 570 | 544 | 544 | 674 | 740 | 890 | 970
Ass_B | 286 | 290 | 330 | 330 | 440 | 520 | 560 | 608 | 730
Ass_C | 631 | 655 | 706 | 748 | 827 | 1010 | 1109 | 1180 | 1360
Ass_D | 648 | 622 | 596 | 678 | 658 | 630 | 622 | 700 | 685
Ass_E | 59.5 | 61 | 67.5 | 74 | 22.5 | 115 | 27.5 | 135 | 137.5
Ass_F | 305 | 328 | 355 | 395 | 435 | 510 | 595 | 621 | 706
Ass_G | 628 | 665 | 712 | 768 | 810 | 1011 | 1124 | 1197 | 1340
Ass_H | 12 | 12 | 0 | 0 | 0 | 0 | 0 | 0 | 0
Ass_I | 10 | 8 | 5 | 8 | 16 | 33 | 24 | 44 | 20
Ass_J | 250 | 297 | 330 | 348 | 353.5 | 448 | 487 | 565 | 636
Ass_K | 820 | 950 | 1016 | 1080 | 1180 | 1340 | 1587 | 1814 | 1990
Ass_L | 8 | 8 | 8 | 8 | 8 | 8 | 8 | 8 | 8
Ass_M | 200 | 250 | 250 | 280 | 320 | 360 | 320 | 490 | 593
Ass_N | 25 | 54 | 37 | 92 | 161 | 180 | 221 | 204 | 228.5
Ass_O | 10 | 10 | 10 | 10 | 15 | 15 | 20 | 20 | 10
Ass_P | 98 | 94 | 88 | 88 | 0 | 0 | 0 | 0 | 0
Ass_Q | 191.5 | 231.73 | 260.4 | 272.24 | 272.24 | 272.24 | 470 | 395 | 315
Ass_R | 180 | 230 | 230 | 260 | 300 | 360 | 330 | 490 | 613
Ass_S | 115 | 115 | 110 | 105 | 125 | 120 | 128 | 150 | 150
Ass_T | 86.3 | 96.3 | 106.3 | 112 | 125 | 130 | 140 | 151 | 160.3
Ass_U | 167 | 217.5 | 224 | 245 | 285 | 335 | 365 | 443 | 490
Ass_V | 165 | 190 | 240 | 315 | 360 | 470 | 480 | 600 | 750
Ass_W | 392 | 408 | 400 | 416 | 452 | 470 | 550 | 570 | 740
Ass_X | 90 | 54 | 47 | 28 | 32 | 80 | 76 | 80 | 45
Ass_Y | 236 | 240 | 280 | 280 | 365 | 445 | 485 | 530 | 650
Ass_Z | 15 | 15 | 15 | 15 | 15 | 15 | 10 | 10 | 10
Ass_AA | 50 | 50 | 50 | 50 | 100 | 100 | 100 | 100 | 105
Ass_AB | 0 | 0 | 0 | 0 | 110 | 145 | 210 | 270 | 305
Ass_AC | 0 | 0 | 0 | 0 | 200 | 195 | 310 | 290 | 310
Ass_AD | 0 | 0 | 0 | 0 | 135 | 159 | 219 | 279 | 324
Ass_AE | 0 | 0 | 0 | 0 | 280 | 259 | 364 | 329 | 354
Ass_AF | 0 | 0 | 0 | 0 | 179 | 222 | 222 | 275 | 305
Ass_AI | 0 | 0 | 0 | 160 | 180 | 240 | 240 | 300 | 375
Ass_AJ | 0 | 0 | 0 | 0 | 0 | 80 | 0 | 51 | 80
Ass_AK | 0 | 0 | 0 | 0 | 0 | 700 | 0 | 900 | 1000
Ass_AL | 143 | 145 | 165 | 165 | 220 | 260 | 280 | 304 | 365
Ass_AM | 0 | 0 | 0 | 0 | 0 | 180 | 0 | 0 | 180
Ass_AN | 0 | 0 | 0 | 0 | 0 | 260 | 0 | 307.5 | 346

Sheet: STP_Assembly_value
 | 25 | 35 | 45 | 60 | 80 | 110 | 160 | 200 | 250
C_R_XY | 0 | 0 | 0 | 0 | 0 | 160 | 0 | 205 | 235
P_XY | 6 | 6 | 6 | 6 | 6 | 6 | 6 | 6 | 6
P_YZ | 0 | 0 | 0 | 0 | 0 | 250 | 0 | 280 | 305
P_ZX | 0 | 0 | 0 | 0 | 0 | 120 | 0 | 120 | 120
SGL_YZ | 0 | 0 | 0 | 0 | 0 | 22.5 | 0 | 22 | 24.4 | 24.4
SGL_ZX | 0 | 0 | 0 | 0 | 0 | 145 | 0 | 175 | 170
SGR_ZX | 0 | 0 | 0 | 0 | 0 | 805 | 0 | 1055 | 1140
OLG_F_XY | 0 | 0 | 0 | 0 | 0 | 15 | 0 | 15 | 15
OLG_F_YZ | 0 | 0 | 0 | 0 | 0 | 12.5 | 0 | 12.5 | 12.5
OLG_F_ZX | 0 | 0 | 0 | 0 | 0 | 13 | 0 | 13 | 13
PLG_C_XY | 0 | 0 | 0 | 0 | 0 | 90 | 0 | 111 | 178
PLG_C_YZ | 0 | 0 | 0 | 0 | 0 | 106 | 0 | 130.5 | 156
PLG_C_ZX | 0 | 0 | 0 | 0 | 0 | 14 | 0 | 14.11 | 14
EBP_XY | 0 | 0 | 0 | 0 | 0 | 72 | 0 | 72 | 72
EBP_YZ | 0 | 0 | 0 | 0 | 0 | 37.5 | 0 | 37.5 | 37.5
EB_XY | 0 | 0 | 0 | 0 | 0 | 1034 | 0 | 1037 | 1034
EB_YZ | 0 | 0 | 0 | 0 | 0 | 100 | 0 | 100 | 100
PBB_XY | 0 | 0 | 0 | 0 | 0 | 182 | 0 | 100 | 102 | 108
PBB_YZ | 0 | 0 | 0 | 0 | 0 | 297 | 0 | 1266 | 1527 | 1527
PBB_ZX | 0 | 0 | 0 | 0 | 0 | 241 | 0 | 316 | 316 | 321
PB_XY | 0 | 0 | 0 | 0 | 0 | 485 | 0 | 485 | 485
PB_YZ | 0 | 0 | 0 | 0 | 0 | 15 | 0 | 15 | 15
PB_ZX | 0 | 0 | 0 | 0 | 0 | 10 | 0 | 10 | 10
CP_XY | 0 | 0 | 0 | 0 | 0 | 4 | 0 | 4 | 4
CP_YZ | 0 | 0 | 0 | 0 | 0 | 137 | 0 | 137 | 137
CP_ZX | 0 | 0 | 0 | 0 | 0 | 4 | 0 | 4 | 4
TN_XY | 162 | 194 | 197 | 225 | 233 | 260 | 330 | 380 | 592
TN_YZ | 345 | 365 | 417 | 440 | 530 | 560 | 660 | 722 | 779
TN_2_YZ | 0 | 0 | 0 | 0 | 0 | 405 | 0 | 480 | 540
NP_XY | 29 | 50 | 50 | 55 | 60 | 178.1 | 110 | 141 | 297.4
NP_ZX | 0 | 0 | 0 | 0 | 0 | 734 | 0 | 843.5 | 907
NP_YZ | 0 | 0 | 0 | 0 | 0 | 0.1 | 0 | 0.1 | 0.1
GF_XY | 0 | 0 | 0 | 0 | 0 | 1570 | 0 | 1808 | 1907 |  | 1907
GF_ZX | 0 | 0 | 0 | 0 | 0 | 920 | 0 | 1190 | 1267.5 |  | 1257.5
C_YZ | 0 | 0 | 0 | 0 | 0 | 20 | 0 | 26 | 29
C_ZX | 0 | 0 | 0 | 0 | 0 | 15 | 0 | 15 | 22.5
PS_XY | 0 | 0 | 0 | 0 | 0 | 12.5 | 0 | 12.5 | 12.5
PS_ZX | 0 | 0 | 0 | 0 | 0 | 65 | 0 | 65 | 65
OB_YZ | 0 | 0 | 0 | 0 | 0 | 151.212 | 0 | 150.5 | 150.5 |  | 150.5
OB_ZX | 0 | 0 | 0 | 0 | 0 | 512.7 | 0 | 595.2 | 595.2
BH_YZ | 0 | 0 | 0 | 0 | 0 | 58 | 0 | 158 | 78.5 |  | 78.5
PANEL_YZ | 0 | 0 | 0 | 0 | 0 | 86 | 0 | -6 | 86
B_XY | 0 | 0 | 0 | 0 | 0 | 39 | 0 | 51 | 54 |  | 39
B_YZ | 0 | 0 | 0 | 0 | 0 | 70 | 0 | 90 | 90
B_ZX | 0 | 0 | 0 | 0 | 0 | 105 | 0 | 145 | 159.5 |  | 159.5
B2_ZX | 0 | 0 | 0 | 0 | 0 | 690 | 0 | 880 | 926
OLS_XY | 0 | 0 | 0 | 0 | 0 | 497 | 0 | 627 | 667
OLS_YZ | 0 | 0 | 0 | 0 | 0 | 0 | 0 | 0 | 100
OLS_ZX | 0 | 0 | 0 | 0 | 0 | 304 | 0 | 421 | 469
OLS2_XY | 0 | 0 | 0 | 0 | 0 | 353 | 0 | 375 | 407
OLS2_YZ | 0 | 0 | 0 | 0 | 0 | 0 | 0 | 0 | 100
OLS2_ZX | 0 | 0 | 0 | 0 | 0 | 181 | 0 | 261 | 271
MB_XY | 0 | 0 | 0 | 0 | 0 | 67 | 0 | 67 | 73
MB_YZ | 0 | 0 | 0 | 0 | 0 | 0 | 0 | 320 | 370
MB_ZX | 0 | 0 | 0 | 0 | 0 | 40 | 0 | 870 | 880
M_XY | 0 | 0 | 0 | 0 | 0 | 148 | 0 | 179 | 205
M_YZ | 0 | 0 | 0 | 0 | 0 | 113 | 0 | 505 | 550.5
M_ZX | 0 | 0 | 0 | 0 | 0 | 320 | 0 | 460 | 480
EW_XY | 0 | 0 | 0 | 0 | 0 | 900 | 0 | 900 | 900
EW_YZ | 0 | 0 | 0 | 0 | 0 | 300 | 0 | 300 | 300
EF_ZX | 0 | 0 | 0 | 0 | 0 | 42.5 | 0 | 42.5 | 42.5
EE_ZX | 0 | 0 | 0 | 0 | 0 | 42.5 | 0 | 42.5 | 42.5
AVG_E_XY | 0 | 0 | 0 | 0 | 0 | 79 | 0 | 0 | 107
AVG_U_XY | 0 | 0 | 0 | 0 | 0 | 98.425 | 0 | 0 | 130.175
AVG_S_XY | 0 | 0 | 0 | 0 | 0 | 55 | 0 | 0 | 95
BS_XY | 299 | 324 | 358 | 360 | 408 | 495 | 565 | 627 | 667
