sinje0816/stamping_press/SYEI_stamping_press_system/new_stamping_press/new/EJECTOR_UNIT/65.吹氣吹料組件/412RR02-吹氣吹料組件.SLDASM

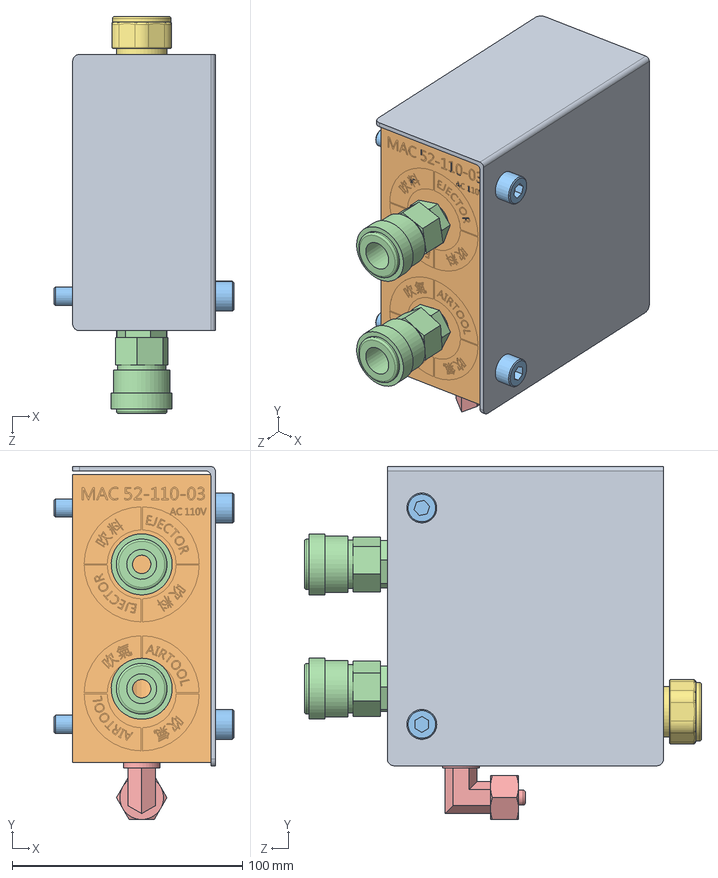
[picture p3: CAD file, 2024-01-15]
SYEI_stamping_press_system/new_stamping_press/new/EJECTOR_UNIT/65.吹氣吹料組件/412RR02-吹氣吹料組件.SLDASM
78.0 x 153.3 x 172.5 mm
複製 of 392P01-蓋板^412RR02-吹氣吹料組件
複製 of SVAMA220311-電磁閥^412RR02-吹氣吹料組件
複製 of SBA08070-六角孔螺栓^412RR02-吹氣吹料組件 x 2
複製 of QJA03-快速接頭^412RR02-吹氣吹料組件 x 2
複製 of TC08C0312-外牙肘管飛速接頭^412RR02-吹氣吹料組件
複製 of PLGS03-六角孔旋塞^412RR02-吹氣吹料組件 x 2
複製 of 01A021222SQ-電磁閥轉接頭^412RR02-吹氣吹料組件
