sinje0816/stamping_press/SYEI_stamping_press_system/new_stamping_press/new/SAFETY_BLOCK/40.安全桿/Y01A017209HQ-安全開關.sldasm

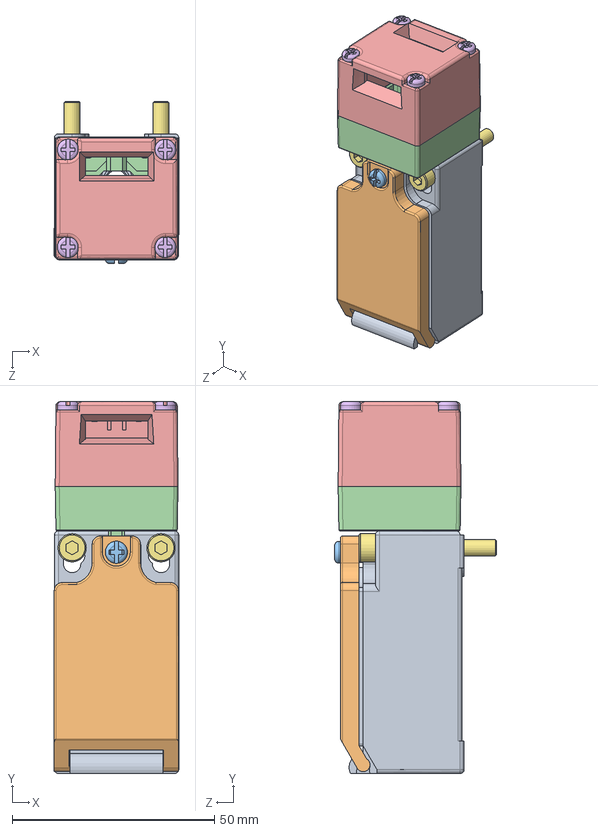
[picture p4: CAD file, 2023-12-20]
SYEI_stamping_press_system/new_stamping_press/new/SAFETY_BLOCK/40.安全桿/Y01A017209HQ-安全開關.sldasm
30.9 x 92.1 x 40.1 mm
複製 of EDH-CA-001R^複製 of 01A017209HQ-安全開關_Y01A017209HQ-安全開關
複製 of EDH-CO-002R^複製 of 01A017209HQ-安全開關_Y01A017209HQ-安全開關
複製 of EDH-TB-005^複製 of 01A017209HQ-安全開關_Y01A017209HQ-安全開關
複製 of EK-CA-003R_Issue_C-20140221-增加肋柱^複製 of 01A017209HQ-安全開關_Y01A017209HQ-安全開關
複製 of EK-CO-003_EK-CO-003_03^複製 of 01A017209HQ-安全開關_Y01A017209HQ-安全開關
複製 of PEKTB003^複製 of 01A017209HQ-安全開關_Y01A017209HQ-安全開關 x 4
複製 of SBA04030-六角孔螺栓^Y01A017209HQ-安全開關 x 2
