sinje0816/stamping_press/SYEI_stamping_press_system/new_stamping_press/new/KNOCK_OUT_BAR/Y32G3901-下料棒.STEP

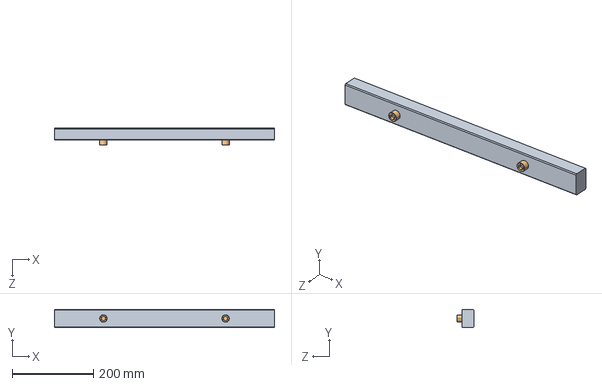
[picture p5: CAD file, 2024-01-15]
SYEI_stamping_press_system/new_stamping_press/new/KNOCK_OUT_BAR/Y32G3901-下料棒.STEP
540.0 x 45.0 x 42.0 mm
複製 of 32G3901-下料棒^Y32G3901-下料棒
ｽﾆｻs of SBA12016-､ｻｨ､､ﾕﾁｳｮ鷽Y32G3901-､Uｮﾆｴﾎ_SBA12016 x 2
