sinje0816/stamping_press/SYEI_stamping_press_system/new_stamping_press/new/SAFETY_BLOCK/160R13010-安全桿+YOCBR20-安全桿座.STEP

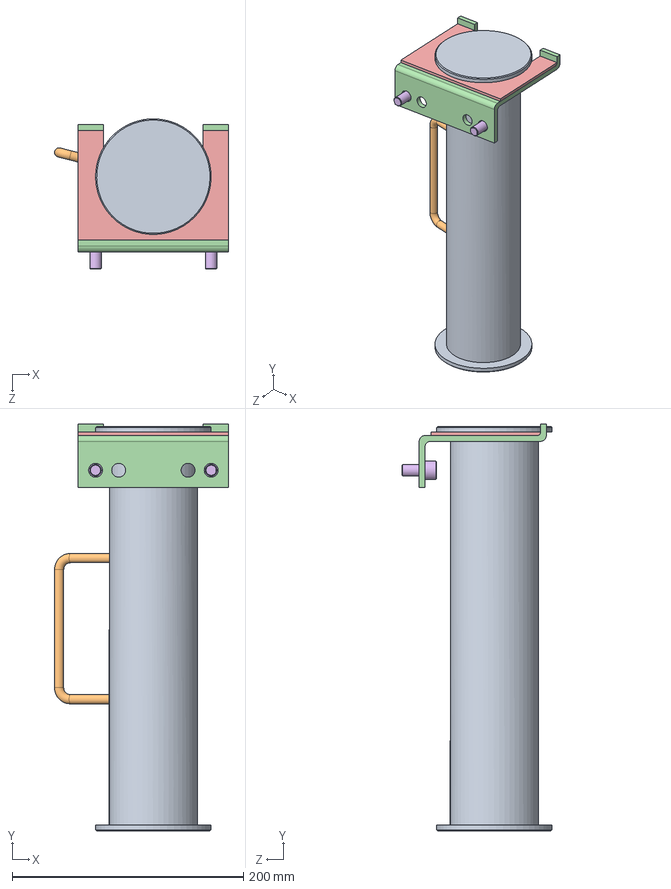
[picture p6: CAD file, 2023-12-20]
SYEI_stamping_press_system/new_stamping_press/new/SAFETY_BLOCK/160R13010-安全桿+YOCBR20-安全桿座.STEP
150.5 x 352.0 x 130.0 mm
複製 of 160R13010-安全桿^160R13010-安全桿+YOCBR20-安全桿座
複製 of OCBR20-安全桿座^複製 of YOCBR20-安全桿座_160R13010-安全桿+YOCBR20-安全桿座
複製 of SBA10020-六角孔螺栓^複製 of YOCBR20-安全桿座_160R13010-安全桿+YOCBR20-安全桿座_SBA10020-六角孔螺栓 x 2
