sinje0816/stamping_press/SYEI_stamping_press_system/new_stamping_press/new/SAFETY_BLOCK/40.安全桿/YOCBR20-安全桿座.STEP

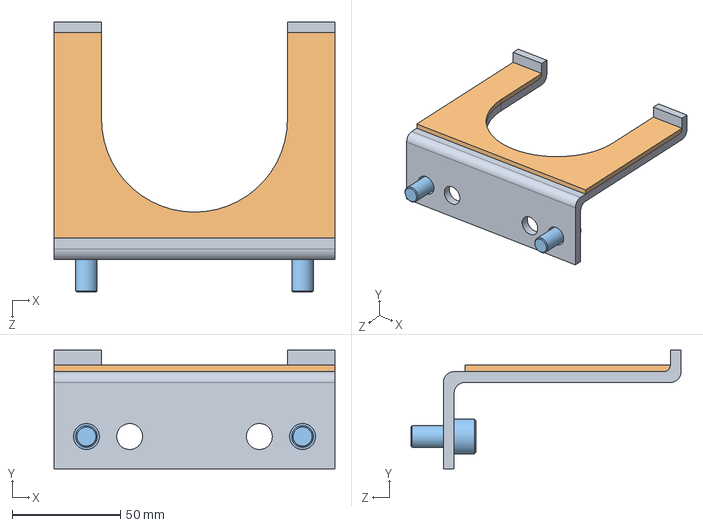
[picture p7: CAD file, 2023-12-20]
SYEI_stamping_press_system/new_stamping_press/new/SAFETY_BLOCK/40.安全桿/YOCBR20-安全桿座.STEP
130.0 x 55.0 x 125.0 mm
複製 of OCBR20-安全桿座^YOCBR20-安全桿座
複製 of SBA10020-六角孔螺栓^YOCBR20-安全桿座_SBA10020-六角孔螺栓 x 2
