sinje0816/stamping_press/SYEI_stamping_press_system/new_stamping_press/new/SlideKnockout_Bracket/Y32G4402-頂桿鎖緊座.STEP

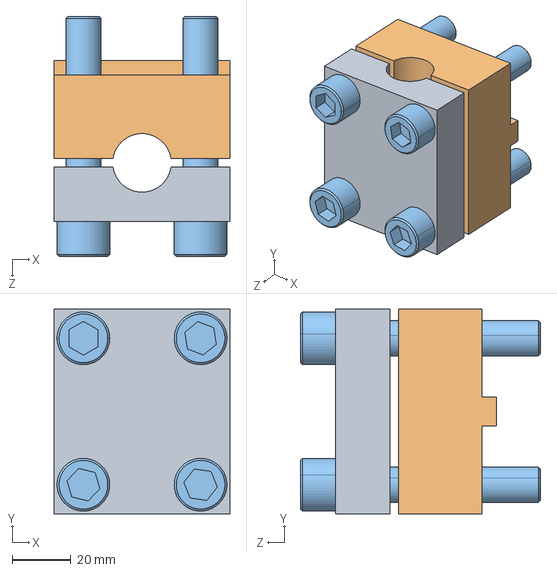
[picture p8: CAD file, 2024-01-15]
SYEI_stamping_press_system/new_stamping_press/new/SlideKnockout_Bracket/Y32G4402-頂桿鎖緊座.STEP
60.0 x 70.0 x 82.0 mm
狡籹 of 32G4402-郴膘玛候畒^Y32G4402-郴膘玛候畒
複製 of SBA12070-六角孔螺栓^Y32G4402-頂桿鎖緊座_SBA12070 x 4
