sinje0816/stamping_press/SYEI_stamping_press_system/new_stamping_press/new/SlideKnockout_StrikePin/YGAA3859-下料頂桿.STEP

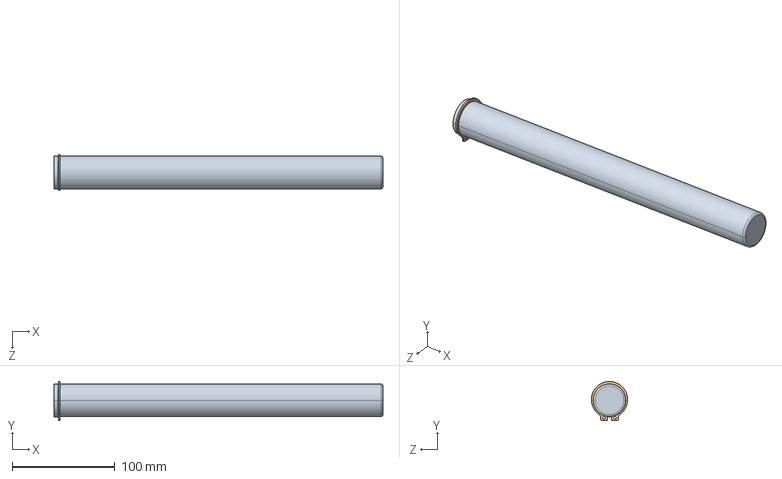
[picture p9: CAD file, 2024-01-15]
SYEI_stamping_press_system/new_stamping_press/new/SlideKnockout_StrikePin/YGAA3859-下料頂桿.STEP
320.0 x 38.0 x 35.3 mm
複製 of GAA3859-下料頂桿^YGAA3859-下料頂桿
複製 of CSS032-C型扣環(軸用)^YGAA3859-下料頂桿_16[Φ32軸用]
