sinje0816/stamping_press/SYEI_stamping_press_system/new_stamping_press/new/KNOCK_OUT_BAR/Y412G01-下料棒.STEP

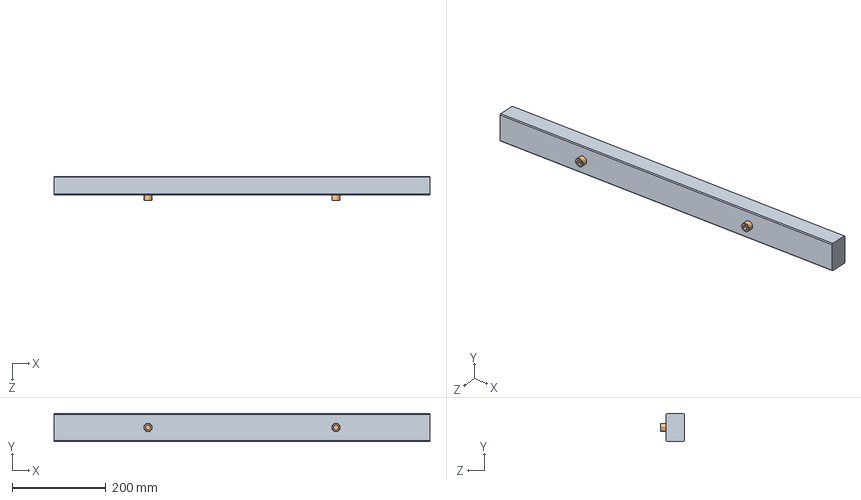
[picture p10: CAD file, 2024-01-15]
SYEI_stamping_press_system/new_stamping_press/new/KNOCK_OUT_BAR/Y412G01-下料棒.STEP
800.0 x 60.0 x 52.0 mm
複製 of 412G01-下料棒^Y412G01-下料棒
ｽﾆｻs of SBA12016-､ｻｨ､､ﾕﾁｳｮ鷽Y412G01-､Uｮﾆｴﾎ_SBA12016 x 2
