sinje0816/stamping_press/SYEI_stamping_press_system/new_stamping_press/new/SAFETY_BLOCK/30W71-安全桿+YOCBR20-安全桿座.STEP

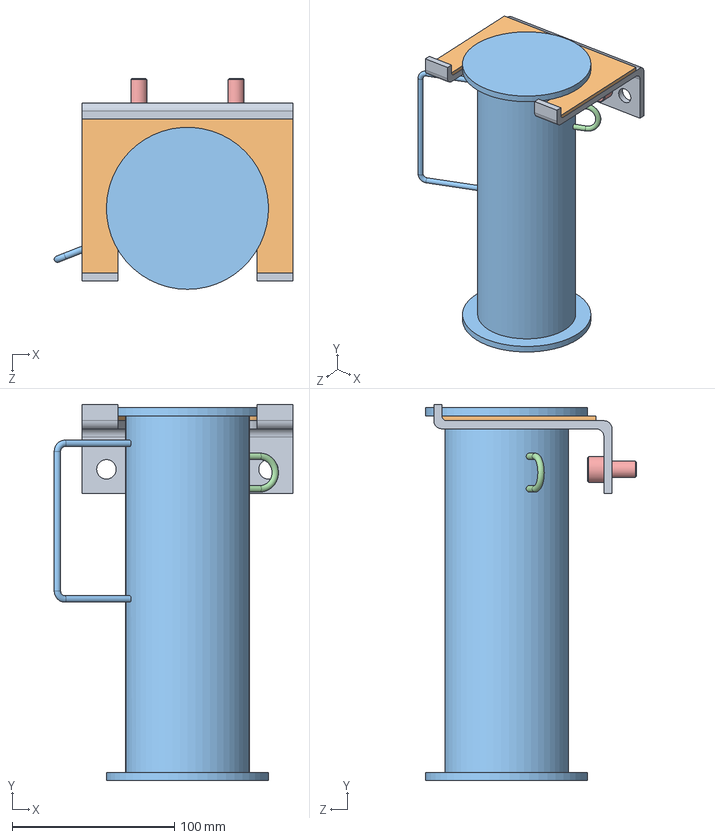
[picture p11: CAD file, 2023-12-20]
SYEI_stamping_press_system/new_stamping_press/new/SAFETY_BLOCK/30W71-安全桿+YOCBR20-安全桿座.STEP
147.2 x 232.0 x 130.0 mm
複製 of OCBR20-安全桿座^30W71-安全桿+YOCBR20-安全桿座
複製 of 30W71-安全桿^30W71-安全桿+YOCBR20-安全桿座
複製 of SBA10020-六角孔螺栓^30W71-安全桿+YOCBR20-安全桿座_SBA10020-六角孔螺栓 x 2
