sinje0816/stamping_press/SYEI_stamping_press_system/new_stamping_press/new/SAFETY_BLOCK/40.安全桿/160R13010-安全桿.STEP

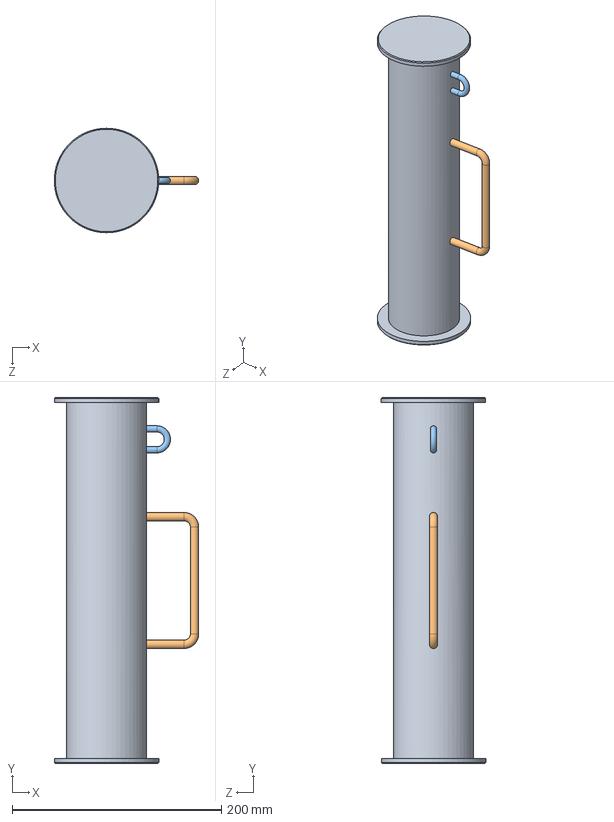
[picture p12: CAD file, 2023-12-20]
SYEI_stamping_press_system/new_stamping_press/new/SAFETY_BLOCK/40.安全桿/160R13010-安全桿.STEP
138.1 x 350.0 x 100.0 mm
