sinje0816/stamping_press/SYEI_stamping_press_system/new_stamping_press/new/SlideKnockout_Bracket/Y45G4402-頂桿鎖緊座.STEP

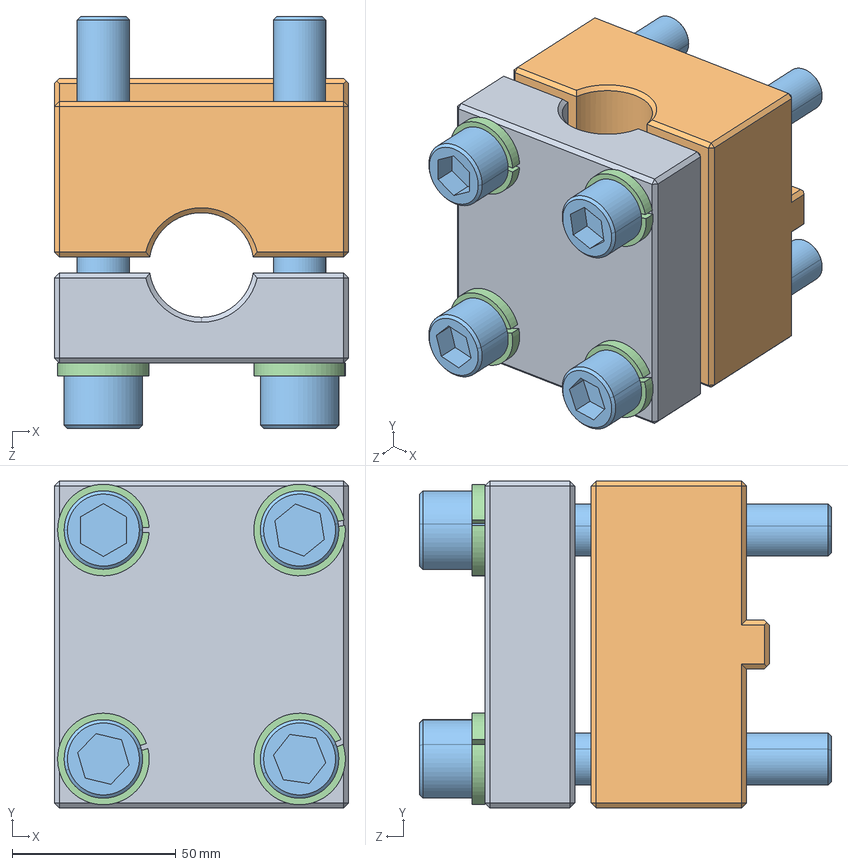
[picture p13: CAD file, 2024-01-15]
SYEI_stamping_press_system/new_stamping_press/new/SlideKnockout_Bracket/Y45G4402-頂桿鎖緊座.STEP
90.0 x 100.0 x 126.0 mm
狡籹 of 45G4402-郴膘玛候畒^Y45G4402-郴膘玛候畒
複製 of SBA16110-六角孔螺栓^Y45G4402-頂桿鎖緊座_SBA16110 x 4
狡籹 of SWA16-紆庐乖伴^Y45G4402-郴膘玛候畒_SWA16 x 4
