sinje0816/stamping_press/SYEI_stamping_press_system/new_stamping_press/new/SlideKnockout_StrikePin/Y30G0003S01-下料頂桿.STEP

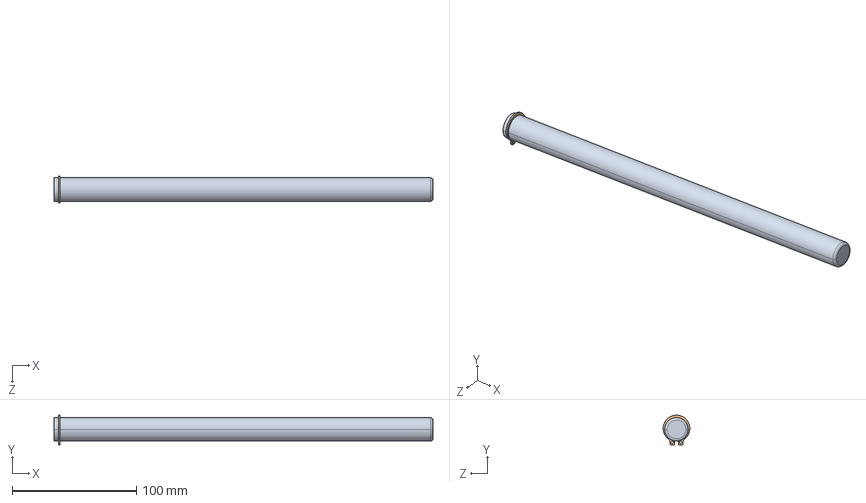
[picture p14: CAD file, 2024-01-15]
SYEI_stamping_press_system/new_stamping_press/new/SlideKnockout_StrikePin/Y30G0003S01-下料頂桿.STEP
305.0 x 23.9 x 21.5 mm
複製 of 30G0003S01-下料頂桿^Y30G0003S01-下料頂桿
複製 of CSS019-C型扣環(軸用)^Y30G0003S01-下料頂桿_10[Φ19軸用]
