sinje0816/stamping_press/SYEI_stamping_press_system/new_stamping_press/new/KNOCK_OUT_BAR/Y392G01-下料棒.STEP

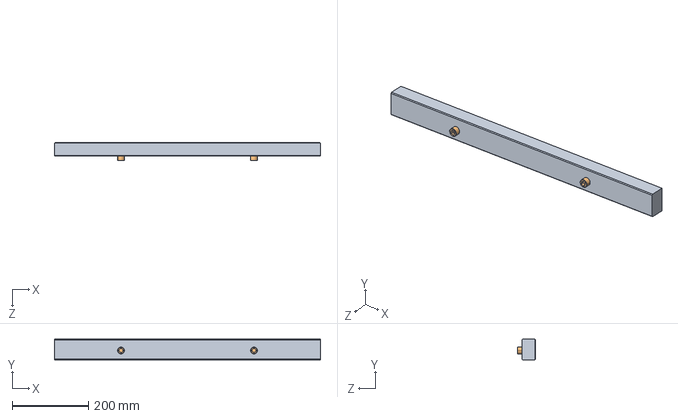
[picture p15: CAD file, 2024-01-15]
SYEI_stamping_press_system/new_stamping_press/new/KNOCK_OUT_BAR/Y392G01-下料棒.STEP
700.0 x 55.0 x 48.0 mm
複製 of 392G01-下料棒^Y392G01-下料棒
ｽﾆｻs of SBA12016-､ｻｨ､､ﾕﾁｳｮ鷽Y392G01-､Uｮﾆｴﾎ_SBA12016 x 2
