sinje0816/stamping_press/SYEI_stamping_press_system/new_stamping_press/new/SlideKnockout_Bracket/Y37G4402-頂桿鎖緊座.STEP

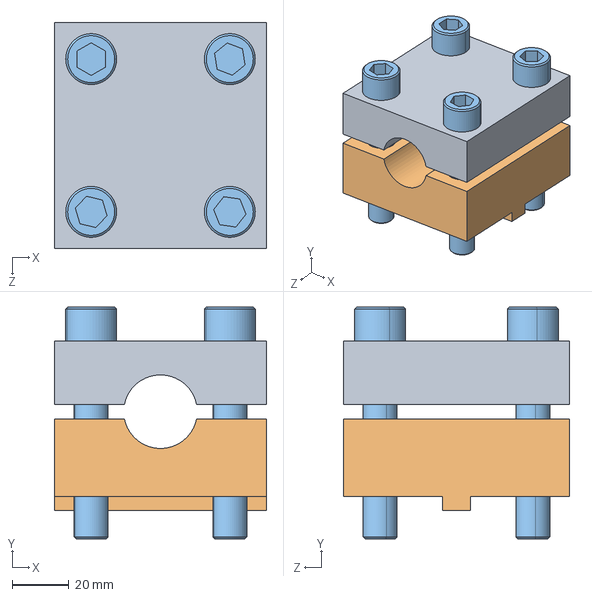
[picture p16: CAD file, 2024-01-15]
SYEI_stamping_press_system/new_stamping_press/new/SlideKnockout_Bracket/Y37G4402-頂桿鎖緊座.STEP
75.0 x 82.0 x 80.0 mm
狡籹 of 37G4402-郴膘玛候畒^Y372G01-郴膘玛候畒
複製 of SBA12070-六角孔螺栓^Y372G01-頂桿鎖緊座_SBA12070 x 4
