sinje0816/stamping_press/SYEI_stamping_press_system/new_stamping_press/new/KNOCK_OUT_BAR/Y47G0001-下料棒.STEP

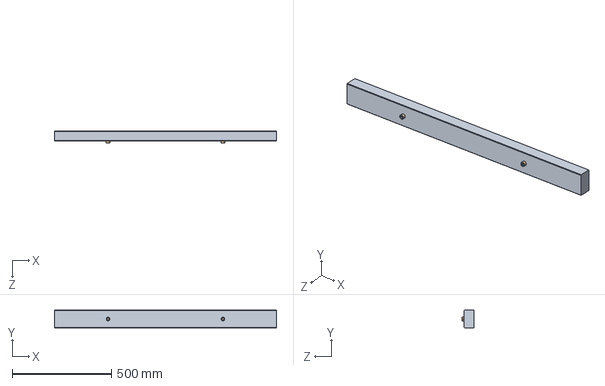
[picture p18: CAD file, 2024-01-15]
SYEI_stamping_press_system/new_stamping_press/new/KNOCK_OUT_BAR/Y47G0001-下料棒.STEP
1120.0 x 90.0 x 62.0 mm
複製 of 47G0001-下料棒^Y47G0001-下料棒
ｽﾆｻs of SBA12020-､ｻｨ､､ﾕﾁｳｮ鷽Y47G0001-､Uｮﾆｴﾎ_SBA12020 x 2
