sinje0816/stamping_press/SYEI_stamping_press_system/new_stamping_press/new/SAFETY_BLOCK/40.安全桿/30W71-安全桿.STEP

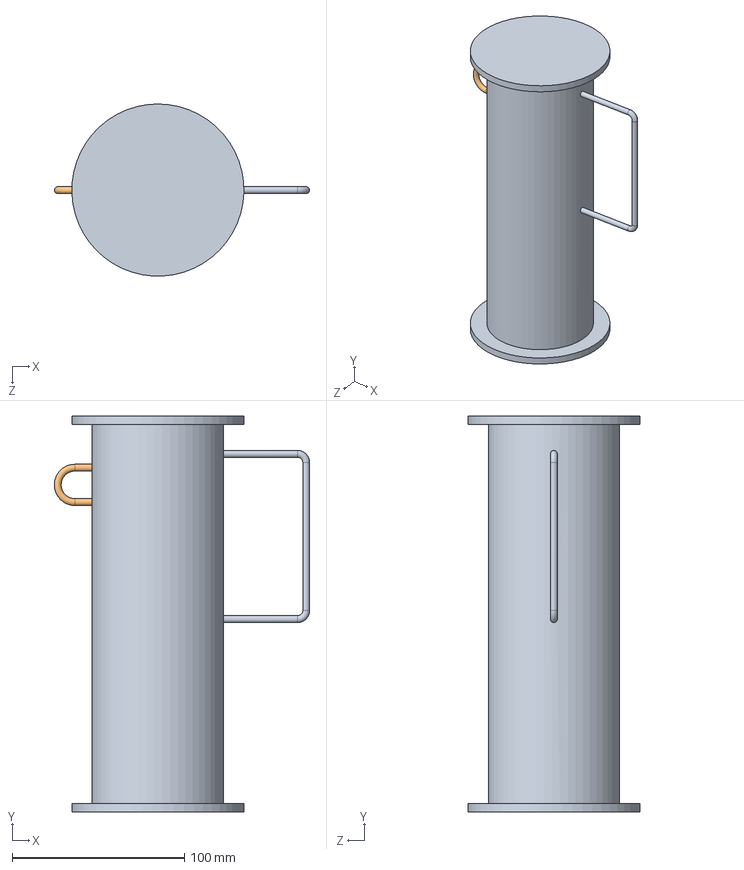
[picture p19: CAD file, 2023-12-20]
SYEI_stamping_press_system/new_stamping_press/new/SAFETY_BLOCK/40.安全桿/30W71-安全桿.STEP
148.3 x 230.0 x 99.9 mm
