sinje0816/stamping_press/SYEI_stamping_press_system/new_stamping_press/new/SlideKnockout_Bracket/Y472G02-頂桿座.STEP

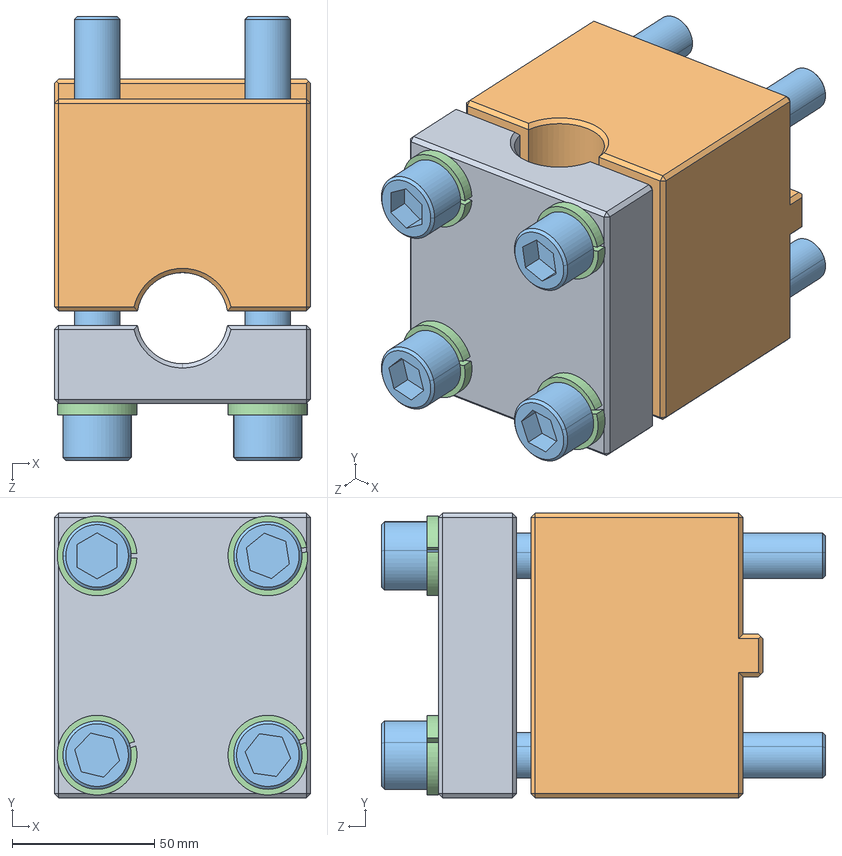
[picture p20: CAD file, 2024-01-15]
SYEI_stamping_press_system/new_stamping_press/new/SlideKnockout_Bracket/Y472G02-頂桿座.STEP
90.0 x 100.0 x 156.0 mm
472G02-頂桿座
複製 of SBA16140-六角孔螺栓^Y472G02-頂桿座_SBA16140 x 4
複製 of SWA16-彈簧墊圈^Y472G02-頂桿座_SWA16 x 4
