sinje0816/stamping_press/SYEI_stamping_press_system/new_stamping_press/new/SlideKnockout_StrikePin/Y39G0002S01-下料頂桿.STEP

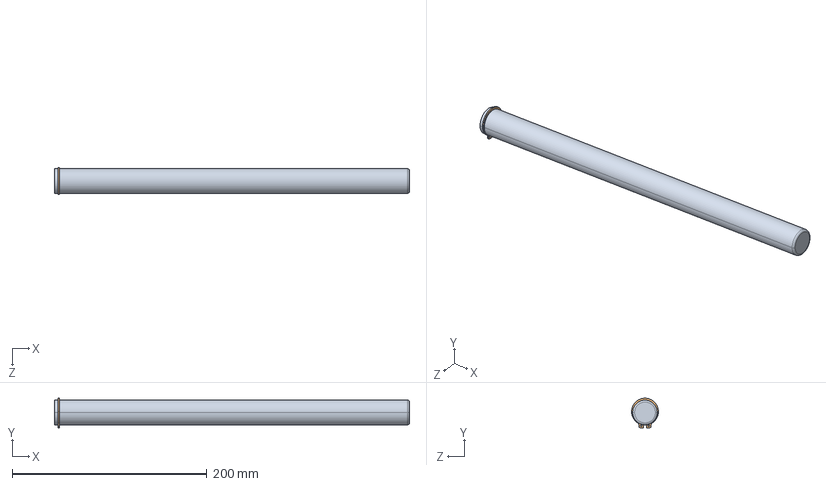
[picture p21: CAD file, 2024-01-15]
SYEI_stamping_press_system/new_stamping_press/new/SlideKnockout_StrikePin/Y39G0002S01-下料頂桿.STEP
365.0 x 30.5 x 27.7 mm
複製 of 39G0002S01-下料頂桿^Y39G0002S01-下料頂桿
複製 of CSS025-C型扣環(軸用)^Y39G0002S01-下料頂桿_13[Φ25軸用]
