sinje0816/stamping_press/SYEI_stamping_press_system/new_stamping_press/new/KNOCK_OUT_BAR/Y342G01-下料棒.STEP

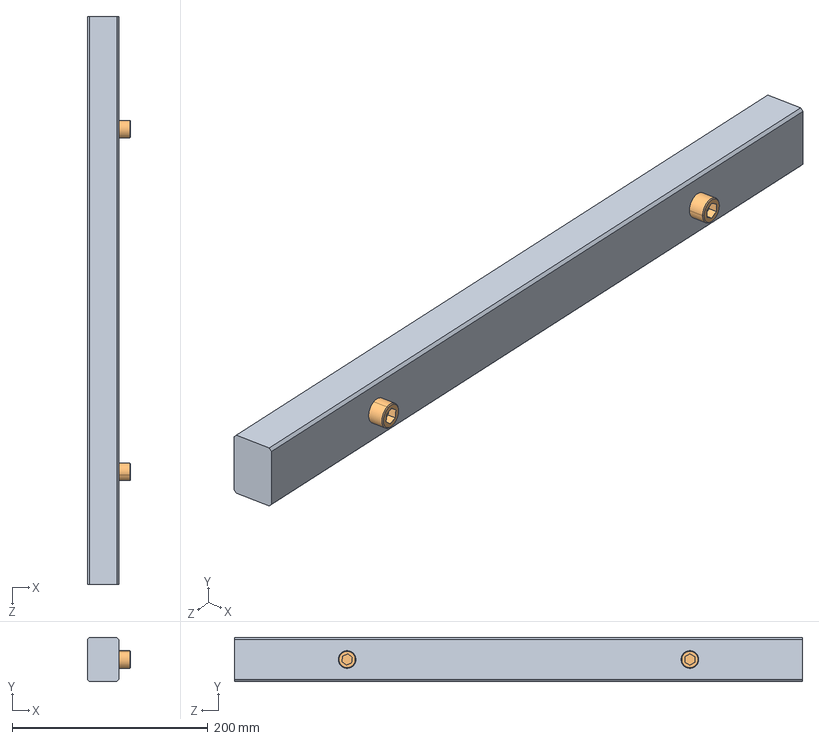
[picture p22: CAD file, 2024-01-15]
SYEI_stamping_press_system/new_stamping_press/new/KNOCK_OUT_BAR/Y342G01-下料棒.STEP
44.0 x 45.0 x 580.0 mm
複製 of 342G01-下料棒^Y342G01-下料棒
ｽﾆｻs of SBA12016-､ｻｨ､､ﾕﾁｳｮ鷽Y342G01-､Uｮﾆｴﾎ_SBA12016 x 2
