sinje0816/stamping_press/SYEI_stamping_press_system/new_stamping_press/new/SlideKnockout_StrikePin/YGAA3854S01-下料頂桿.STEP

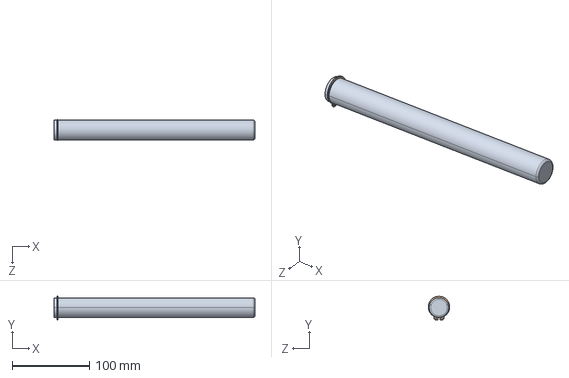
[picture p23: CAD file, 2024-01-15]
SYEI_stamping_press_system/new_stamping_press/new/SlideKnockout_StrikePin/YGAA3854S01-下料頂桿.STEP
260.0 x 30.5 x 27.7 mm
複製 of GAA3854S01-下料頂桿^YGAA3854S01-下料頂桿
複製 of CSS025-C型扣環(軸用)^YGAA3854S01-下料頂桿_13[Φ25軸用]
