sinje0816/stamping_press/SYEI_stamping_press_system/new_stamping_press/new/KNOCK_OUT_BAR/Y43G3901-下料棒.STEP

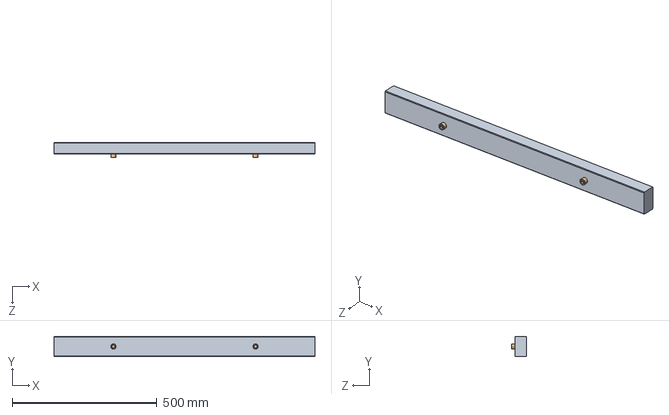
[picture p24: CAD file, 2024-01-15]
SYEI_stamping_press_system/new_stamping_press/new/KNOCK_OUT_BAR/Y43G3901-下料棒.STEP
900.0 x 70.0 x 52.0 mm
複製 of 43G3901-下料棒^Y43G3901-下料棒
ｽﾆｻs of SBA12020-､ｻｨ､､ﾕﾁｳｮ鷽Y43G3901-､Uｮﾆｴﾎ_SBA12020 x 2
