sinje0816/stamping_press/SYEI_stamping_press_system/new_stamping_press/new/SlideKnockout_StrikePin/472G05-下料頂桿(P).STEP

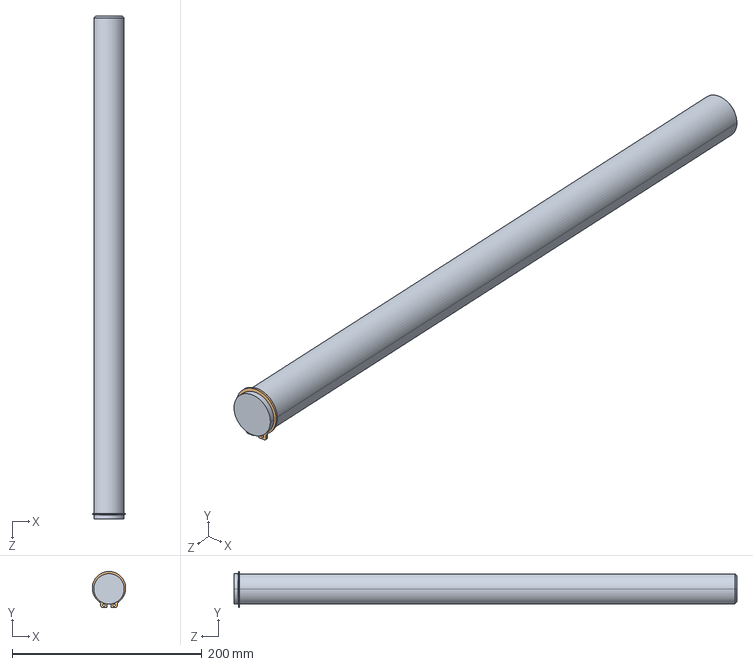
[picture p27: CAD file, 2024-01-15]
SYEI_stamping_press_system/new_stamping_press/new/SlideKnockout_StrikePin/472G05-下料頂桿(P).STEP
35.3 x 38.0 x 530.0 mm
複製 of 472G05-下料頂桿(P)^Y472G05-下料頂桿
複製 of CSS032-C型扣環(軸用)^Y472G05-下料頂桿_16[Φ32軸用]
