sinje0816/stamping_press/SYEI_stamping_press_system/new_stamping_press/new/KNOCK_OUT_BAR/Y452G01-下料棒.STEP

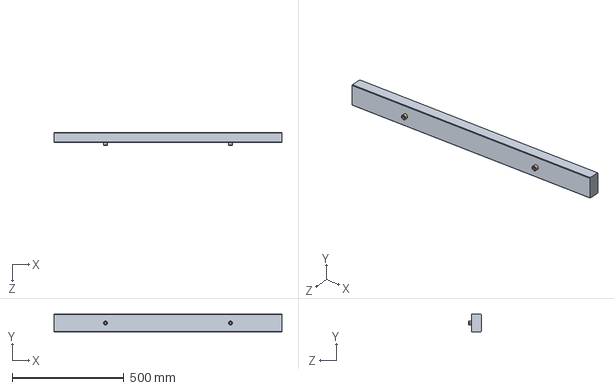
[picture p28: CAD file, 2024-01-15]
SYEI_stamping_press_system/new_stamping_press/new/KNOCK_OUT_BAR/Y452G01-下料棒.STEP
1020.0 x 80.0 x 57.0 mm
複製 of 452G01-下料棒^Y452G01-下料棒
ｽﾆｻs of SBA12020-､ｻｨ､､ﾕﾁｳｮ鷽Y452G01-､Uｮﾆｴﾎ_SBA12020 x 2
