sinje0816/stamping_press/SYEI_stamping_press_system/new_stamping_press/new/SlideKnockout_StrikePin/YGAA3850-下料頂桿.STEP

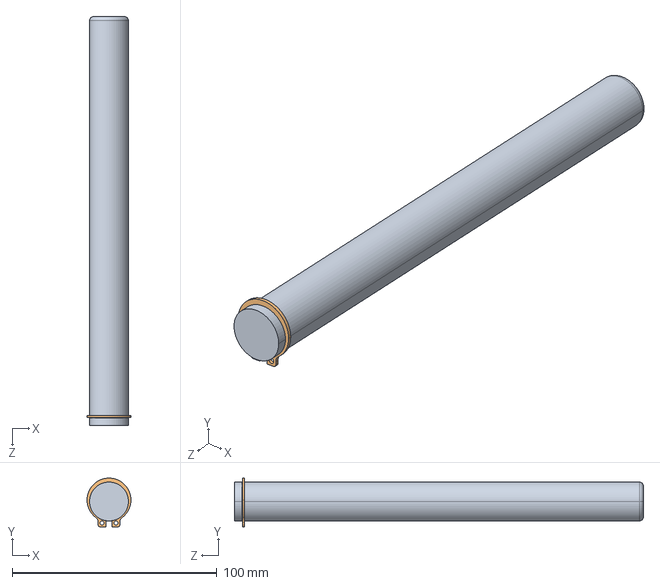
[picture p29: CAD file, 2024-01-15]
SYEI_stamping_press_system/new_stamping_press/new/SlideKnockout_StrikePin/YGAA3850-下料頂桿.STEP
21.5 x 23.9 x 200.0 mm
複製 of GAA3850-下料頂桿^YGAA3850
複製 of CSS019-C型扣環(軸用)^YGAA3850_10[Φ19軸用]
