sinje0816/stamping_press/SYEI_stamping_press_system/new_stamping_press/new/KNOCK_OUT_BAR/Y30G3901-下料棒.STEP

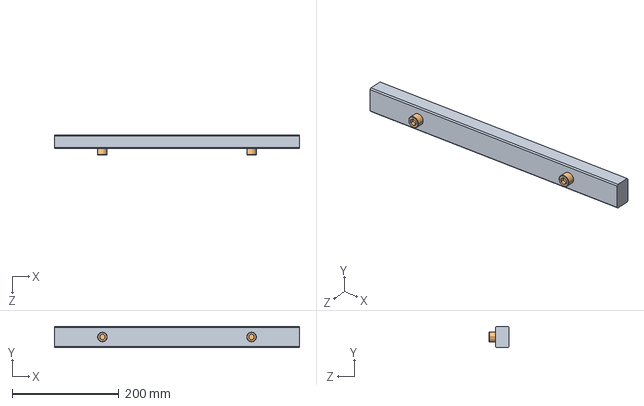
[picture p30: CAD file, 2024-01-15]
SYEI_stamping_press_system/new_stamping_press/new/KNOCK_OUT_BAR/Y30G3901-下料棒.STEP
460.0 x 40.0 x 38.0 mm
複製 of 30G3901-下料棒^30G3901-下料棒
ｽﾆｻs of SBA12016-､ｻｨ､､ﾕﾁｳｮ鷽30G3901-､Uｮﾆｴﾎ_SBA12016 x 2
