sinje0816/stamping_press/SYEI_stamping_press_system/new_stamping_press/new/SlideKnockout_StrikePin/47G0005-下料頂桿(H).STEP

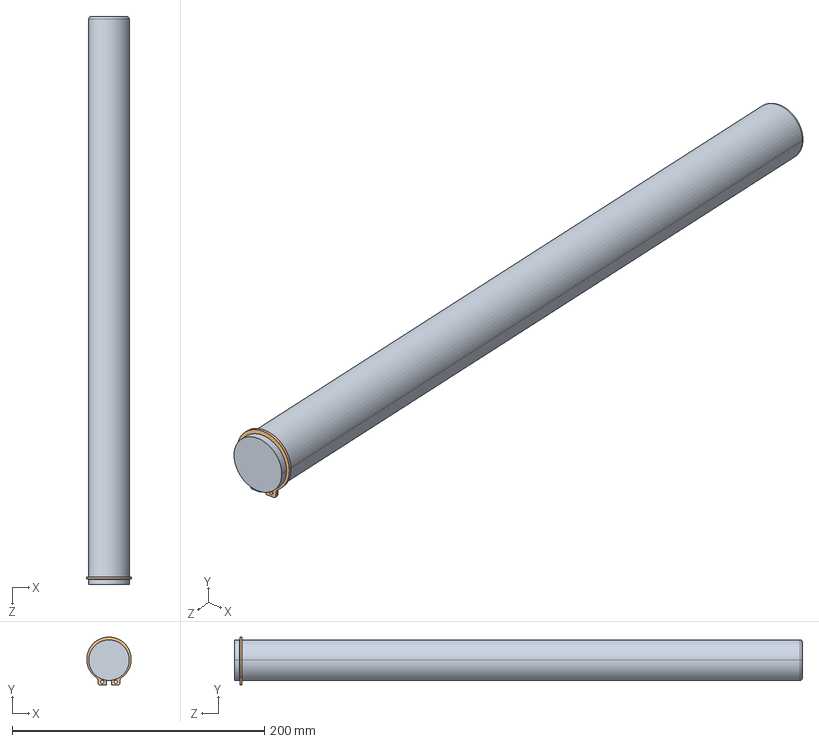
[picture p33: CAD file, 2024-01-15]
SYEI_stamping_press_system/new_stamping_press/new/SlideKnockout_StrikePin/47G0005-下料頂桿(H).STEP
35.3 x 38.0 x 450.0 mm
複製 of 47G0005-下料頂桿(H)^Y47G0005-下料頂桿
複製 of CSS032-C型扣環(軸用)^Y47G0005-下料頂桿_16[Φ32軸用]
