sinje0816/stamping_press/(list of files, cad)

Other CAD files:
SYEI_stamping_press_system/new_stamping_press/new/CON_ROD/452B04S02_CON_ROD.CATPart
SYEI_stamping_press_system/new_stamping_press/new/CON_ROD_CAP/452B02S01_CON_ROD_CAP.CATPart
SYEI_stamping_press_system/new_stamping_press/new/EJECTOR_UNIT/412RR02_EJECTOR_UNIT.CATPart
SYEI_stamping_press_system/new_stamping_press/new/EJECTOR_UNIT/65.吹氣吹料組件/412RR02-吹氣吹料組件.SLDPRT
SYEI_stamping_press_system/new_stamping_press/new/FRAME1.CATPart
SYEI_stamping_press_system/new_stamping_press/new/FRAME10.CATPart
SYEI_stamping_press_system/new_stamping_press/new/FRAME11.CATPart
SYEI_stamping_press_system/new_stamping_press/new/FRAME12.CATPart
SYEI_stamping_press_system/new_stamping_press/new/FRAME13.CATPart
SYEI_stamping_press_system/new_stamping_press/new/FRAME14.CATPart
SYEI_stamping_press_system/new_stamping_press/new/FRAME15.CATPart
SYEI_stamping_press_system/new_stamping_press/new/FRAME17.CATPart
SYEI_stamping_press_system/new_stamping_press/new/FRAME18.CATPart
SYEI_stamping_press_system/new_stamping_press/new/FRAME19.CATPart
SYEI_stamping_press_system/new_stamping_press/new/FRAME19_new.CATPart
SYEI_stamping_press_system/new_stamping_press/new/FRAME2.CATPart
SYEI_stamping_press_system/new_stamping_press/new/FRAME20.CATPart
SYEI_stamping_press_system/new_stamping_press/new/FRAME21.CATPart
SYEI_stamping_press_system/new_stamping_press/new/FRAME22.CATPart
SYEI_stamping_press_system/new_stamping_press/new/FRAME23.CATPart
SYEI_stamping_press_system/new_stamping_press/new/FRAME23_1.CATPart
SYEI_stamping_press_system/new_stamping_press/new/FRAME24.CATPart
SYEI_stamping_press_system/new_stamping_press/new/FRAME24_1.CATPart
SYEI_stamping_press_system/new_stamping_press/new/FRAME25.CATPart
SYEI_stamping_press_system/new_stamping_press/new/FRAME26.CATPart
SYEI_stamping_press_system/new_stamping_press/new/FRAME27.CATPart
SYEI_stamping_press_system/new_stamping_press/new/FRAME27_1.CATPart
SYEI_stamping_press_system/new_stamping_press/new/FRAME28.CATPart
SYEI_stamping_press_system/new_stamping_press/new/FRAME29.CATPart
SYEI_stamping_press_system/new_stamping_press/new/FRAME3.CATPart
SYEI_stamping_press_system/new_stamping_press/new/FRAME30.CATPart
SYEI_stamping_press_system/new_stamping_press/new/FRAME31.CATPart
SYEI_stamping_press_system/new_stamping_press/new/FRAME32.CATPart
SYEI_stamping_press_system/new_stamping_press/new/FRAME33.CATPart
SYEI_stamping_press_system/new_stamping_press/new/FRAME34.CATPart
SYEI_stamping_press_system/new_stamping_press/new/FRAME35.CATPart
SYEI_stamping_press_system/new_stamping_press/new/FRAME36.CATPart
SYEI_stamping_press_system/new_stamping_press/new/FRAME37.CATPart
SYEI_stamping_press_system/new_stamping_press/new/FRAME38.CATPart
SYEI_stamping_press_system/new_stamping_press/new/FRAME4.CATPart
SYEI_stamping_press_system/new_stamping_press/new/FRAME41.CATPart
SYEI_stamping_press_system/new_stamping_press/new/FRAME42.CATPart
SYEI_stamping_press_system/new_stamping_press/new/FRAME43.CATPart
SYEI_stamping_press_system/new_stamping_press/new/FRAME45.CATPart
SYEI_stamping_press_system/new_stamping_press/new/FRAME47.CATPart
SYEI_stamping_press_system/new_stamping_press/new/FRAME48.CATPart
SYEI_stamping_press_system/new_stamping_press/new/FRAME49.CATPart
SYEI_stamping_press_system/new_stamping_press/new/FRAME5.CATPart
SYEI_stamping_press_system/new_stamping_press/new/FRAME50.CATPart
SYEI_stamping_press_system/new_stamping_press/new/FRAME52.CATPart
SYEI_stamping_press_system/new_stamping_press/new/FRAME53.CATPart
SYEI_stamping_press_system/new_stamping_press/new/FRAME54.CATPart
SYEI_stamping_press_system/new_stamping_press/new/FRAME6.CATPart
SYEI_stamping_press_system/new_stamping_press/new/FRAME7.CATPart
SYEI_stamping_press_system/new_stamping_press/new/FRAME8.CATPart
SYEI_stamping_press_system/new_stamping_press/new/FRAME9.CATPart
SYEI_stamping_press_system/new_stamping_press/new/KNOCK_OUT_BAR/Y30G3901_KNOCK_OUT_BAR.CATPart
SYEI_stamping_press_system/new_stamping_press/new/KNOCK_OUT_BAR/Y32G3901_KNOCK_OUT_BAR.CATPart
SYEI_stamping_press_system/new_stamping_press/new/KNOCK_OUT_BAR/Y342G01_KNOCK_OUT_BAR.CATPart
SYEI_stamping_press_system/new_stamping_press/new/KNOCK_OUT_BAR/Y372G01_KNOCK_OUT_BAR.CATPart
SYEI_stamping_press_system/new_stamping_press/new/KNOCK_OUT_BAR/Y392G01_KNOCK_OUT_BAR.CATPart
SYEI_stamping_press_system/new_stamping_press/new/KNOCK_OUT_BAR/Y412G01_KNOCK_OUT_BAR.CATPart
SYEI_stamping_press_system/new_stamping_press/new/KNOCK_OUT_BAR/Y43G3901_KNOCK_OUT_BAR.CATPart
SYEI_stamping_press_system/new_stamping_press/new/KNOCK_OUT_BAR/Y452G01_KNOCK_OUT_BAR.CATPart
SYEI_stamping_press_system/new_stamping_press/new/KNOCK_OUT_BAR/Y47G0001_KNOCK_OUT_BAR.CATPart
SYEI_stamping_press_system/new_stamping_press/new/PORTABLE_STAND/EWR12S03_PORTABLE_STAND.CATPart
SYEI_stamping_press_system/new_stamping_press/new/SAFETY_BLOCK/160R13010_SAFETY_BLOCK_YOCBR20_BRACKET.CATPart
SYEI_stamping_press_system/new_stamping_press/new/SAFETY_BLOCK/30W71_SAFETY_BLOCK_YOCBR20_BRACKET.CATPart
SYEI_stamping_press_system/new_stamping_press/new/SAFETY_BLOCK/40.安全桿/160R13010-安全桿+YOCBR20-安全桿座.SLDASM
SYEI_stamping_press_system/new_stamping_press/new/SAFETY_BLOCK/40.安全桿/160R13010-安全桿.SLDPRT
SYEI_stamping_press_system/new_stamping_press/new/SAFETY_BLOCK/40.安全桿/30W71-安全桿+YOCBR20-安全桿座.SLDASM
SYEI_stamping_press_system/new_stamping_press/new/SAFETY_BLOCK/40.安全桿/30W71-安全桿.SLDPRT
SYEI_stamping_press_system/new_stamping_press/new/SAFETY_BLOCK/40.安全桿/YOCBR20-安全桿座.sldasm
SYEI_stamping_press_system/new_stamping_press/new/SAFETY_SWITCH/Y01A017209HQ_SAFETY_SWITCH.CATPart
SYEI_stamping_press_system/new_stamping_press/new/SlideKnockout_Bracket/Y32G4402_SlideKnockout_Bracket.CATPart
SYEI_stamping_press_system/new_stamping_press/new/SlideKnockout_Bracket/Y37G4402_SlideKnockout_Bracket.CATPart
SYEI_stamping_press_system/new_stamping_press/new/SlideKnockout_Bracket/Y45G4402_SlideKnockout_Bracket.CATPart
SYEI_stamping_press_system/new_stamping_press/new/SlideKnockout_Bracket/Y472G02_SlideKnockout_Bracket.CATPart
SYEI_stamping_press_system/new_stamping_press/new/SlideKnockout_StrikePin/Y30G0003S01_SlideKnockout_StrikePin.CATPart
SYEI_stamping_press_system/new_stamping_press/new/SlideKnockout_StrikePin/Y30G0003_SlideKnockout_StrikePin.CATPart
SYEI_stamping_press_system/new_stamping_press/new/SlideKnockout_StrikePin/Y39G0002S01_SlideKnockout_StrikePin.CATPart
SYEI_stamping_press_system/new_stamping_press/new/SlideKnockout_StrikePin/Y39G0002_SlideKnockout_StrikePin.CATPart
SYEI_stamping_press_system/new_stamping_press/new/SlideKnockout_StrikePin/Y412G02S01_SlideKnockout_StrikePin.CATPart
SYEI_stamping_press_system/new_stamping_press/new/SlideKnockout_StrikePin/Y43G0004S01_SlideKnockout_StrikePin.CATPart
SYEI_stamping_press_system/new_stamping_press/new/SlideKnockout_StrikePin/Y43G0004_SlideKnockout_StrikePin.CATPart
SYEI_stamping_press_system/new_stamping_press/new/SlideKnockout_StrikePin/Y472G05_SlideKnockout_StrikePin.CATPart
SYEI_stamping_press_system/new_stamping_press/new/SlideKnockout_StrikePin/Y47G0005_SlideKnockout_StrikePin.CATPart
SYEI_stamping_press_system/new_stamping_press/new/SlideKnockout_StrikePin/YGAA3850_SlideKnockout_StrikePin.CATPart
SYEI_stamping_press_system/new_stamping_press/new/SlideKnockout_StrikePin/YGAA3854S01_SlideKnockout_StrikePin.CATPart
SYEI_stamping_press_system/new_stamping_press/new/SlideKnockout_StrikePin/YGAA3859_SlideKnockout_StrikePin.CATPart
SYEI_stamping_press_system/new_stamping_press/new/plate.CATPart
SYEI_stamping_press_system/stamping_press/BALANCER_LEFT_All.CATPart
SYEI_stamping_press_system/stamping_press/BALANCER_RIGHT_ALL.CATPart
SYEI_stamping_press_system/stamping_press/BOLSTER1.CATPart
SYEI_stamping_press_system/stamping_press/BOLSTER2.CATPart
SYEI_stamping_press_system/stamping_press/BOLSTER3.CATPart
SYEI_stamping_press_system/stamping_press/CRANK_SHAFT.CATPart
SYEI_stamping_press_system/stamping_press/CRANK_SHAFT_CLOCK.CATPart
SYEI_stamping_press_system/stamping_press/FRAME1.CATPart
SYEI_stamping_press_system/stamping_press/FRAME10.CATPart
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
