sinje0816/stamping_press/SYEI_stamping_press_system/new_stamping_press/new/INVERTERBRACKET/EWR12S01-變頻器固定座.PDF

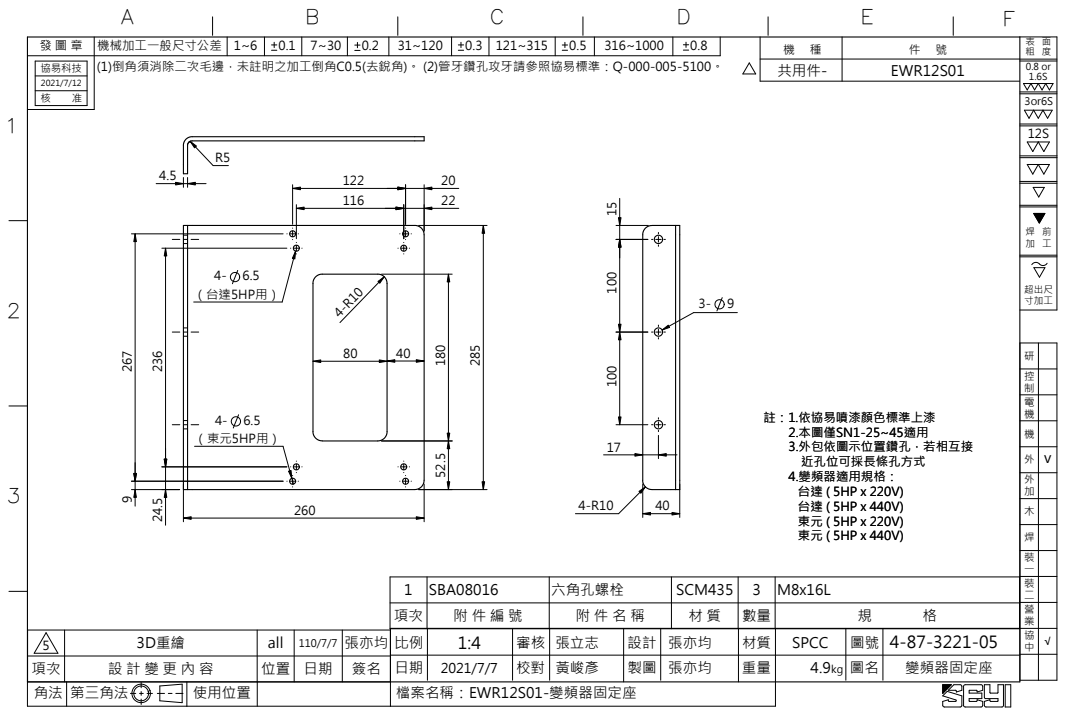
[picture p35: page 1]
協易科技; 註：1.依協易噴漆顏色標準上漆 2.本圖僅SN1-25~45適用 3.外包依圖示位置鑽孔，若相互接 近孔位可採⻑條孔⽅式 4.變頻器適用規格： 台達 ( 5HP x 220V) 台達 ( 5HP x 440V) 東元 ( 5HP x 220V) 東元 ( 5HP x 440V); 寸加工; 超出尺; 機械加工⼀般尺寸公差; 機 種 共用件-; 第三角法; 使用位置; EWR12S01; （東元5HP用）; （台達5HP用）

(1)倒角須消除二次毛邊，未註明之加工倒角C0.5(去銳角)。 (2)管牙鑽孔攻牙請參照協易標準：Q-000-005-5100。

控 制

外 加

裝⼀裝

1 | SBA08016 | 六角孔螺栓 | SCM435 | 3 | M8x16L | 二
項次 | 附 件 編 號 | 附 件 名 稱 | 材 質 | 數量 | 規 格 | 營 業

5 | 3D重繪 | all | 110/7/7 | 張亦均 | 比例 | 1:4 | 審核 | 張立志 | 設計 | 張亦均 | 材質 | SPCC | 圖號 | 4-87-3221-05 | 協 中 | √
項次 | 設 計 變 更 內 容 | 位置 | 日期 | 簽名 | 日期 | 2021/7/7 | 校對 | 黃峻彥 | 製圖 | 張亦均 | 重量 | 4.9 kg | 圖名 | 變頻器固定座

檔案名稱： EWR12S01-變頻器固定座
