sinje0816/stamping_press/SYEI_stamping_press_system/Assmebly_design.py

import main_program as mprog
import excel_parameter_change as epc
import STP_input as S_i
import parameter as par
def assembly(stamping_press_type, apv, path, alpha, beta, zeta, epsilon, specifications_close_working_height_value, specifications_travel_value, travel_type, GUM,INVERTER, power, slide):
    #excel匯入(匯入組立尺寸)
    excel = epc.ExcelOp('組立尺寸', 'Assembly_value')
    try:
        assmebly_par = excel.get_assmebly_sheet_par(stamping_press_type)
    except BaseException:
        print('Assembly_value Parameter change error')
    #匯入STP(固定零件)組立相關尺寸
    excel = epc.ExcelOp('組立尺寸', 'STP_Assembly_value')
    try:
        S_assmebly_par = excel.get_assmebly_sheet_par(stamping_press_type)
    except BaseException:
        print('STP_Assembly_value Parameter change error')
    #新增組立檔
    mprog.assembly_create()
    #將零件匯入組立檔
    part = epc.ExcelOp('尺寸整理表', '沖床機架零件清單')
    #讀取零件匯入數量
    part_name, part_quantity = part.get_assmebly_quantity(stamping_press_type)
    for name in range(len(part_name)):
        for x in range(int(part_quantity[name])):
            if part_name[name] == 'PANEL' or part_name[name] == 'CON_ROD' or part_name[name] == 'CON_ROD_BASE' or part_name[name] == 'CON_ROD_CAP' \
                    or part_name[name] == 'INVERTERBRACKET' or part_name[name] == 'POINTER' or part_name[name] == 'COVER' or part_name[name] == 'PLUG'\
                    or part_name[name] == 'feeding_shaft_cover' or part_name[name] == 'OIL_LEVEL_GAUGE' or part_name[name] == 'slide_gib'\
                    or part_name[name] == 'ELECTRIC_BOX_PLATE'or part_name[name] == 'MOUNT_FILTER'or part_name[name] == 'CONTROL_PANEL' or part_name[name] == 'PANEL_BOX'\
                    or part_name[name] == 'PANEL_BOX_BRACKET' or part_name[name] == 'ELECTRIC_BOX'or part_name[name] == 'GUARD_FLYWHEEL'or part_name[name] == 'NAME_PLATE'\
                    or part_name[name] == 'TRADEMARK_NAMEPLATE' or part_name[name] == 'OPERATION_BOX' or part_name[name] == 'PORTABLE_STAND' or part_name[name] == 'OPERATION_BOX'\
                    or part_name[name] == 'BEARING_HOUSING' or part_name[name] == 'SLIDE'or part_name[name] == 'BALANCER'or part_name[name] == 'MOTOR_BRACKET'\
                    or part_name[name] == 'MOTOR' or part_name[name] == 'WIRE_CASING' or part_name[name] == 'ANTI_VIBRATION_GUM' or part_name[name] == 'HANDEL_MOUNT_FILTER'\
                    or part_name[name] == 'INVERTER' or part_name[name] == 'SAFETY_SWITCH' or part_name[name] == 'SAFETY_BLOCK' or part_name[name] == 'EJECTOR_UNIT'\
                    or part_name[name] == 'KNOCK_OUT_BAR' or part_name[name] == 'SlideKnockout_StrikePin' or part_name[name] == 'SlideKnockout_Bracket':#固定零件匯入清單
                # 讀取其餘STP檔
                S_i.Assmebly(part_name[name], path + '\\' + 'machining', stamping_press_type, travel_type, GUM, INVERTER, power, slide)
                continue
            else:
                mprog.import_file_Part(path + '\\' + 'machining', part_name[name])
    try:
        mprog.import_file_Part(path + '\\' + 'plate', 'plate')
    except:
        pass
    #定義基準零件
    mprog.base_lock('FRAME1.1', 'FRAME1.1', 0)
    #開始進行組立，條件為:(零件1、零件2、距離、平面、組立方式、編號)
    mprog.add_offset_assembly('FRAME2.1', 'FRAME1.1', 0, 'XY plane', 0, 4)
    mprog.add_offset_assembly('FRAME2.1', 'FRAME1.1', 0, 'YZ plane', 0, 5)
    mprog.add_offset_assembly('FRAME2.1', 'FRAME1.1', -(apv['FRAME22']['D']+(apv['FRAME1']['CC']/2)+(apv['FRAME2']['CC']/2)), 'ZX plane', 0, 6)
    mprog.add_offset_assembly('FRAME3.1', 'FRAME1.1', -(apv['FRAME1']['A'] - apv['FRAME3']['A'])-zeta, 'XY plane', 0, 43)
    mprog.add_offset_assembly('FRAME3.1', 'FRAME1.1', -(apv['FRAME1']['F'] - assmebly_par['Ass_F']), 'YZ plane', 0, 44)
    mprog.add_offset_assembly('FRAME3.1', 'FRAME1.1', -(apv['FRAME1']['CC'] / 2 + apv['FRAME3']['B']), 'ZX plane', 0,
                              45)
    mprog.add_offset_assembly('FRAME4.1', 'FRAME2.1', -(apv['FRAME2']['A'] - apv['FRAME4']['A'])-zeta, 'XY plane', 0, 46)
    mprog.add_offset_assembly('FRAME4.1', 'FRAME2.1', -(apv['FRAME2']['F'] - assmebly_par['Ass_G']), 'YZ plane', 0, 47)
    mprog.add_offset_assembly('FRAME4.1', 'FRAME2.1', apv['FRAME2']['CC'] / 2, 'ZX plane', 0, 48)
    mprog.add_offset_assembly('FRAME5.1', 'FRAME2.1',
                              -(apv['FRAME2']['A'] - assmebly_par['Ass_K'])-zeta, 'XY plane', 0, 70)
    mprog.add_offset_assembly('FRAME5.1', 'FRAME2.1', apv['FRAME5']['A'] + assmebly_par['Ass_L'] + apv['FRAME32']['C'],
                              'YZ plane', 1, 71)
    mprog.add_offset_assembly('FRAME5.1', 'FRAME2.1', apv['FRAME2']['CC'] / 2, 'ZX plane', 0, 72)
    if stamping_press_type == 0 or stamping_press_type == 1 or stamping_press_type == 2 or stamping_press_type == 3:
        mprog.add_offset_assembly('FRAME7.1', 'FRAME2.1',
                              -((apv['FRAME2']['E'] - apv['FRAME2']['DD']) - apv['FRAME7']['A'] - apv['FRAME7']['Y']),
                              'XY plane', 0, 25)
    else:
        mprog.add_offset_assembly('FRAME7.1', 'FRAME2.1', 0, 'XY plane', 0, 25)
    mprog.add_offset_assembly('FRAME7.1', 'FRAME2.1', -(apv['FRAME2']['B'] - assmebly_par['Ass_B']), 'YZ plane', 0, 26)
    if stamping_press_type == 0 or stamping_press_type == 1 or stamping_press_type == 2 or stamping_press_type == 3:
        mprog.add_offset_assembly('FRAME7.1', 'FRAME2.1', assmebly_par['Ass_E'], 'ZX plane', 0, 27)
    else:
        mprog.add_offset_assembly('FRAME7.1', 'FRAME2.1',apv['FRAME2']['CC']/2 , 'ZX plane', 0, 27)
    mprog.add_offset_assembly('FRAME8.1', 'FRAME1.1', -assmebly_par['Ass_D'], 'XY plane', 0, 37)
    mprog.add_offset_assembly('FRAME8.1', 'FRAME1.1',
                              -(apv['FRAME1']['B'] - assmebly_par['Ass_B'] - apv['FRAME8']['B']), 'YZ plane', 0, 38)
    mprog.add_offset_assembly('FRAME8.1', 'FRAME1.1', -assmebly_par['Ass_E'], 'ZX plane', 0, 39)
    mprog.add_offset_assembly('FRAME9.1', 'FRAME2.1', 0, 'XY plane', 0, 34)
    mprog.add_offset_assembly('FRAME9.1', 'FRAME2.1', -assmebly_par['Ass_Z'], 'YZ plane', 0, 35)
    mprog.add_offset_assembly('FRAME9.1', 'FRAME2.1', apv['FRAME2']['CC'] / 2, 'ZX plane', 0, 36)
    if stamping_press_type == 0 or stamping_press_type == 1 or stamping_press_type == 2:
        mprog.add_offset_assembly('FRAME10.1', 'FRAME1.1', 0, 'XY plane', 1, 10)
        mprog.add_offset_assembly('FRAME10.1', 'FRAME1.1', -(apv['FRAME10']['B']), 'YZ plane', 0, 11)
        mprog.add_offset_assembly('FRAME10.1', 'FRAME1.1',
                                  (apv['FRAME1']['CC'] / 2+ assmebly_par['Ass_AA']), 'ZX plane',
                                  1, 12)
        mprog.add_offset_assembly('FRAME10.2', 'FRAME2.1', apv['FRAME10']['K(2)'], 'XY plane', 0, 13)
        mprog.add_offset_assembly('FRAME10.2', 'FRAME2.1', -(apv['FRAME10']['B']), 'YZ plane', 0, 14)
        mprog.add_offset_assembly('FRAME10.2', 'FRAME2.1',
                                  (apv['FRAME1']['CC'] / 2+ assmebly_par['Ass_AA']), 'ZX plane',
                                  0, 15)
    else:
        mprog.add_offset_assembly('FRAME10.1', 'FRAME2.1', 0, 'XY plane', 1, 10)
        mprog.add_offset_assembly('FRAME10.1', 'FRAME2.1', 0, 'YZ plane', 1, 11)
        mprog.add_offset_assembly('FRAME10.1', 'FRAME2.1',
                                  (apv['FRAME1']['CC'] / 2 + assmebly_par['Ass_AA']), 'ZX plane',
                                  0, 12)
        mprog.add_offset_assembly('FRAME10.2', 'FRAME1.1', apv['FRAME10']['K(2)'], 'XY plane', 0, 13)
        mprog.add_offset_assembly('FRAME10.2', 'FRAME1.1', 0, 'YZ plane', 1, 14)
        mprog.add_offset_assembly('FRAME10.2', 'FRAME1.1',
                                  (apv['FRAME1']['CC'] / 2 + assmebly_par['Ass_AA']), 'ZX plane',
                                  1, 15)
    mprog.add_offset_assembly('FRAME12.1', 'FRAME3.1', 0, 'XY plane', 0, 136)
    mprog.add_offset_assembly('FRAME12.1', 'FRAME3.1', -(apv['FRAME3']['O']), 'YZ plane', 1, 137)
    mprog.add_offset_assembly('FRAME12.1', 'FRAME3.1', apv['FRAME19']['AH'], 'ZX plane', 0, 138)
    mprog.add_offset_assembly('FRAME13.1', 'FRAME2.1', -(
                apv['FRAME2']['A'] - apv['FRAME30']['A'] - (apv['FRAME17']['g3'] - apv['FRAME17']['g2']) -
                apv['FRAME13']['k'] - apv['FRAME13']['j'] - assmebly_par['Ass_V'] - assmebly_par['Ass_S'])-zeta, 'XY plane',
                              0, 121)
    mprog.add_offset_assembly('FRAME13.1', 'FRAME2.1', apv['FRAME2']['F'] - apv['FRAME2']['G'] - apv['FRAME2']['FF'],
                              'YZ plane', 1, 122)
    mprog.add_offset_assembly('FRAME13.1', 'FRAME2.1', -apv['FRAME1']['CC'] / 2, 'ZX plane', 1, 123)
    mprog.add_offset_assembly('FRAME13_1.1', 'FRAME1.1', -(
                apv['FRAME2']['A'] - apv['FRAME30']['A'] - (apv['FRAME17']['g3'] - apv['FRAME17']['g2']) -
                apv['FRAME13']['k'] - apv['FRAME13']['j'] - assmebly_par['Ass_V'] - assmebly_par['Ass_S'])-zeta, 'XY plane',
                              0, 124)
    mprog.add_offset_assembly('FRAME13_1.1', 'FRAME1.1', apv['FRAME2']['F'] - apv['FRAME2']['G'] - apv['FRAME2']['FF'],
                              'YZ plane', 1, 125)
    mprog.add_offset_assembly('FRAME13_1.1', 'FRAME1.1', apv['FRAME1']['CC'] / 2 + apv['FRAME13']['E'], 'ZX plane', 1,
                              126)
    mprog.add_offset_assembly('FRAME14.1', 'FRAME2.1', -(
                apv['FRAME2']['A'] - apv['FRAME30']['A'] - assmebly_par['Ass_S'] - apv['FRAME14']['g3'])-zeta, 'XY plane', 0,
                              109)
    mprog.add_offset_assembly('FRAME14.1', 'FRAME2.1',
                              apv['FRAME2']['F'] - apv['FRAME2']['G'] - apv['FRAME14']['B'] - apv['FRAME2']['FF'],
                              'YZ plane', 1, 110)
    mprog.add_offset_assembly('FRAME14.1', 'FRAME2.1', apv['FRAME14']['A'] + apv['FRAME2']['CC'] / 2, 'ZX plane', 0,
                              111)
    mprog.add_offset_assembly('FRAME17.1', 'FRAME1.1', -(
                apv['FRAME1']['A'] - apv['FRAME30']['A'] - assmebly_par['Ass_S'] - apv['FRAME17']['g3'])-zeta, 'XY plane', 0,
                              112)
    mprog.add_offset_assembly('FRAME17.1', 'FRAME1.1',
                              apv['FRAME1']['F'] - apv['FRAME1']['G'] - apv['FRAME17']['B'] - apv['FRAME1']['FF'],
                              'YZ plane', 1, 113)
    mprog.add_offset_assembly('FRAME17.1', 'FRAME1.1', -(apv['FRAME2']['CC'] / 2), 'ZX plane', 0, 114)
    mprog.add_offset_assembly('FRAME18.1', 'FRAME1.1', -(
                apv['FRAME1']['A'] - assmebly_par['Ass_M'] - apv['FRAME18']['F'])-zeta, 'XY plane',
                              0, 76)
    mprog.add_offset_assembly('FRAME18.1', 'FRAME1.1', (assmebly_par['Ass_N']), 'YZ plane', 1,
                              77)
    mprog.add_offset_assembly('FRAME18.1', 'FRAME1.1', (apv['FRAME1']['CC'] / 2 + apv['FRAME18']['B']), 'ZX plane', 1, 78)
    mprog.add_offset_assembly('FRAME19.1', 'FRAME1.1', -((apv['FRAME1']['E'] - apv['FRAME19']['D'])), 'XY plane', 0, 28)
    mprog.add_offset_assembly('FRAME19.1', 'FRAME1.1', -(apv['FRAME1']['B'] - assmebly_par['Ass_C']), 'YZ plane', 0, 29)
    mprog.add_offset_assembly('FRAME19.1', 'FRAME1.1', -(apv['FRAME1']['CC'] / 2 + apv['FRAME19']['AH']), 'ZX plane', 0,30)
    mprog.add_offset_assembly('FRAME19.2', 'FRAME2.1', -((apv['FRAME1']['E'] - apv['FRAME19']['D'])), 'XY plane', 0, 31)
    mprog.add_offset_assembly('FRAME19.2', 'FRAME2.1', -(apv['FRAME2']['B'] - assmebly_par['Ass_C']), 'YZ plane', 0, 32)
    mprog.add_offset_assembly('FRAME19.2', 'FRAME2.1', apv['FRAME2']['CC'] / 2, 'ZX plane', 0, 33)
    mprog.add_offset_assembly('FRAME20.1', 'FRAME2.1', -(
                apv['FRAME1']['A'] - assmebly_par['Ass_R'] - apv['FRAME20']['H'])-zeta, 'XY plane',
                              0, 100)
    mprog.add_offset_assembly('FRAME20.1', 'FRAME2.1', -(apv['FRAME20']['A'] + assmebly_par['Ass_N']), 'YZ plane', 0,
                              101)
    mprog.add_offset_assembly('FRAME20.1', 'FRAME2.1', apv['FRAME20']['B'] + apv['FRAME1']['CC'] / 2, 'ZX plane', 0,
                              102)
    if stamping_press_type == 0 or stamping_press_type == 1 or stamping_press_type == 2 or stamping_press_type == 3:
        mprog.add_offset_assembly('FRAME22.1', 'FRAME35.1', -(
                (apv['FRAME1']['E'] - apv['FRAME1']['DD']) - (apv['FRAME22']['A(1)'] - apv['FRAME22']['A(2)'])),
                              'XY plane', 1, 16)
    else:
        mprog.add_offset_assembly('FRAME22.1', 'FRAME35.2', 0,'XY plane', 1, 16)
    if stamping_press_type == 0 or stamping_press_type == 1 or stamping_press_type == 2:
        mprog.add_offset_assembly('FRAME22.1', 'FRAME35.1', apv['FRAME22']['O'], 'YZ plane', 0, 17)
    else:
        mprog.add_offset_assembly('FRAME22.1', 'FRAME35.2', -(apv['FRAME35']['B'] - apv['FRAME22']['O']), 'YZ plane', 1, 17)
    if stamping_press_type == 0 or stamping_press_type == 1 or stamping_press_type == 2 or stamping_press_type == 3:
        mprog.add_offset_assembly('FRAME22.1', 'FRAME1.1', -(apv['FRAME22']['D'] + apv['FRAME1']['CC'] / 2), 'ZX plane', 0,
                              18)
    else:
        mprog.add_offset_assembly('FRAME22.1', 'FRAME2.1', apv['FRAME1']['CC'] / 2, 'ZX plane', 0, 18)
    mprog.add_offset_assembly('FRAME24.1', 'FRAME30.1', -(apv['FRAME30']['A'] - apv['FRAME24']['B']), 'XY plane', 0, 58)
    mprog.add_offset_assembly('FRAME24.1', 'FRAME30.1', apv['FRAME24']['A'] + apv['FRAME30']['M'] / 2, 'YZ plane', 0,
                              59)
    mprog.add_offset_assembly('FRAME24.1', 'FRAME30.1',
                              (apv['FRAME24']['I'] - apv['FRAME2']['CC'] + apv['FRAME24']['E']), 'ZX plane', 0, 60)
    mprog.add_offset_assembly('FRAME24_1.1', 'FRAME30.1', -(apv['FRAME30']['A'] - apv['FRAME24']['B']), 'XY plane', 0,
                              61)
    mprog.add_offset_assembly('FRAME24_1.1', 'FRAME30.1', apv['FRAME24']['A'] + apv['FRAME30']['M'] / 2, 'YZ plane', 0,
                              62)
    mprog.add_offset_assembly('FRAME24_1.1', 'FRAME30.1', (apv['FRAME30']['E'] - (apv['FRAME24']['I'] - apv['FRAME2']['CC'])), 'ZX plane', 0,
                              63)
    mprog.add_offset_assembly('FRAME26.1', 'FRAME18.1', apv['FRAME26']['B'], 'XY plane', 0, 79)
    mprog.add_offset_assembly('FRAME26.1', 'FRAME18.1', -assmebly_par['Ass_O'], 'YZ plane', 1, 80)
    mprog.add_offset_assembly('FRAME26.1', 'FRAME18.1', 0, 'ZX plane', 1, 81)
    mprog.add_offset_assembly('FRAME26.2', 'FRAME18.1', apv['FRAME26']['B'], 'XY plane', 0, 82)
    mprog.add_offset_assembly('FRAME26.2', 'FRAME18.1',
                              -(apv['FRAME18']['A'] - (assmebly_par['Ass_O'] + apv['FRAME26']['I'])), 'YZ plane', 1, 83)
    mprog.add_offset_assembly('FRAME26.2', 'FRAME18.1', 0, 'ZX plane', 1, 84)
    mprog.add_offset_assembly('FRAME26.3', 'FRAME20.1', apv['FRAME26']['B'], 'XY plane', 0, 103)
    mprog.add_offset_assembly('FRAME26.3', 'FRAME20.1', assmebly_par['Ass_O'] + apv['FRAME26']['I'], 'YZ plane', 0, 104)
    mprog.add_offset_assembly('FRAME26.3', 'FRAME20.1', -(apv['FRAME20']['B']), 'ZX plane', 0, 105)
    mprog.add_offset_assembly('FRAME26.4', 'FRAME20.1', apv['FRAME26']['B'], 'XY plane', 0, 106)
    mprog.add_offset_assembly('FRAME26.4', 'FRAME20.1', apv['FRAME20']['A'] - assmebly_par['Ass_O'], 'YZ plane', 0, 107)
    mprog.add_offset_assembly('FRAME26.4', 'FRAME20.1', -(apv['FRAME20']['B']), 'ZX plane', 0, 108)
    mprog.add_offset_assembly('FRAME28.1', 'FRAME30.1', 0, 'XY plane', 0, 158)
    mprog.add_offset_assembly('FRAME28.1', 'FRAME30.1', apv['FRAME30']['M'] / 2 + apv['FRAME28']['A'], 'YZ plane', 0,
                              159)
    if stamping_press_type == 0 or stamping_press_type == 1 or stamping_press_type == 2 or stamping_press_type == 3:
        mprog.add_offset_assembly('FRAME28.1', 'FRAME30.1', apv['FRAME27']['I'] + 1, 'ZX plane', 0, 160)
    else:
        mprog.add_offset_assembly('FRAME28.1', 'FRAME30.1', 0, 'ZX plane', 0, 160)
    mprog.add_offset_assembly('FRAME30.1', 'FRAME2.1', -(apv['FRAME2']['A'] - apv['FRAME30']['A'])-zeta, 'XY plane', 0, 40)
    mprog.add_offset_assembly('FRAME30.1', 'FRAME2.1', -(apv['FRAME2']['F'] - (apv['FRAME30']['M'] / 2)), 'YZ plane', 0,
                              41)
    mprog.add_offset_assembly('FRAME30.1', 'FRAME2.1', apv['FRAME2']['CC'] / 2, 'ZX plane', 0, 42)
    mprog.add_offset_assembly('FRAME32.1', 'FRAME2.1', -(
                apv['FRAME2']['A'] - assmebly_par['Ass_K'] - apv['FRAME32']['A'])-zeta, 'XY plane',
                              0, 73)
    mprog.add_offset_assembly('FRAME32.1', 'FRAME2.1', -(assmebly_par['Ass_L']), 'YZ plane', 0, 74)
    mprog.add_offset_assembly('FRAME32.1', 'FRAME2.1', apv['FRAME2']['CC'] / 2, 'ZX plane', 0, 75)
    if stamping_press_type == 0 or stamping_press_type == 1 or stamping_press_type == 2:
        mprog.add_offset_assembly('FRAME35.1', 'FRAME1.1', 0, 'XY plane', 1, 1)
        mprog.add_offset_assembly('FRAME35.1', 'FRAME1.1', -(apv['FRAME1']['B']), 'YZ plane', 0, 2)
        mprog.add_offset_assembly('FRAME35.1', 'FRAME1.1',
                                  (apv['FRAME22']['D'] - assmebly_par['Ass_A']) / 2 + (apv['FRAME1']['CC'] / 2), 'ZX plane',
                                  1, 3)
        mprog.add_offset_assembly('FRAME35.2', 'FRAME2.1', apv['FRAME35']['K'] - apv['FRAME35']['L'], 'XY plane', 0, 7)
        mprog.add_offset_assembly('FRAME35.2', 'FRAME2.1', -(apv['FRAME2']['B']), 'YZ plane', 0, 8)
        mprog.add_offset_assembly('FRAME35.2', 'FRAME2.1',
                                  (apv['FRAME22']['D'] - assmebly_par['Ass_A']) / 2 + apv['FRAME2']['CC'] / 2, 'ZX plane',
                                  0, 9)
    else:
        mprog.add_offset_assembly('FRAME35.1', 'FRAME1.1', apv['FRAME35']['K']-apv['FRAME35']['L'], 'XY plane', 0, 1)
        mprog.add_offset_assembly('FRAME35.1', 'FRAME1.1', (apv['FRAME1']['B'] - apv['FRAME35']['B']),
                                  'YZ plane',
                                  1, 2)
        mprog.add_offset_assembly('FRAME35.1', 'FRAME1.1',
                                  (apv['FRAME22']['D'] - assmebly_par['Ass_A']) / 2 + (apv['FRAME1']['CC'] / 2),
                                  'ZX plane',
                                  1, 3)
        mprog.add_offset_assembly('FRAME35.2', 'FRAME2.1', 0, 'XY plane', 1, 7)
        mprog.add_offset_assembly('FRAME35.2', 'FRAME2.1', (apv['FRAME2']['B'] - apv['FRAME35']['B']), 'YZ plane', 1, 8)
        mprog.add_offset_assembly('FRAME35.2', 'FRAME2.1',
                                  (apv['FRAME22']['D'] - assmebly_par['Ass_A']) / 2 + apv['FRAME2']['CC'] / 2,
                                  'ZX plane',
                                  0, 9)
    mprog.add_offset_assembly('FRAME38.1', 'FRAME19.2',
                              -(apv['FRAME19']['A'] - assmebly_par['Ass_W'] - apv['FRAME38']['A'] - apv['FRAME3']['C']),
                              'XY plane', 0, 133)
    mprog.add_offset_assembly('FRAME38.1', 'FRAME19.2', assmebly_par['Ass_X'], 'YZ plane', 1, 134)
    mprog.add_offset_assembly('FRAME38.1', 'FRAME19.2', -(apv['FRAME19']['AH'] + apv['FRAME38']['B']), 'ZX plane', 1,
                              135)
    mprog.add_offset_assembly('FRAME38.2', 'FRAME19.1',
                              -(apv['FRAME19']['A'] - assmebly_par['Ass_W'] - apv['FRAME38']['A'] - apv['FRAME3']['C']),
                              'XY plane', 0, 139)
    mprog.add_offset_assembly('FRAME38.2', 'FRAME19.1', -(assmebly_par['Ass_X'] + apv['FRAME38']['C']), 'YZ plane', 0,
                              140)
    mprog.add_offset_assembly('FRAME38.2', 'FRAME19.1', -(apv['FRAME38']['B']), 'ZX plane', 0, 141)
    mprog.add_offset_assembly('crankshaft.1', 'FRAME30.1', (apv['FRAME30']['h']), 'XY plane', 1, 224)
    mprog.add_offset_assembly('crankshaft.1', 'FRAME30.1', (assmebly_par['Ass_AN']-apv['FRAME30']['M']/2-apv['crankshaft']['Ah1']-apv['crankshaft']['Ah2']-apv['crankshaft']['Bh1']-apv['crankshaft']['Bh2']/2), 'YZ plane', 0, 225)
    mprog.add_offset_assembly('crankshaft.1', 'FRAME30.1', -(apv['FRAME30']['E']/2), 'ZX plane', 1, 226)
    mprog.add_offset_assembly(S_i.CON_ROD_CAP_list[stamping_press_type]+'.1', 'crankshaft.1', -apv['crankshaft']['Bx2']+alpha/2, 'XY plane', 1, 227)
    mprog.add_offset_assembly(S_i.CON_ROD_CAP_list[stamping_press_type]+'.1', 'crankshaft.1', (apv['crankshaft']['Ah1']+apv['crankshaft']['Ah2']+apv['crankshaft']['Bh1']+apv['crankshaft']['Bh2']/2), 'YZ plane', 0, 228)
    mprog.add_offset_assembly(S_i.CON_ROD_CAP_list[stamping_press_type]+'.1', 'crankshaft.1', 0, 'ZX plane', 1, 229)
    mprog.add_offset_assembly(S_i.PANEL_list[stamping_press_type]+'.1', S_i.BEARING_HOUSING_list[stamping_press_type] + '.1', 0, 'XY plane', 1, 236)
    mprog.add_offset_assembly(S_i.PANEL_list[stamping_press_type]+'.1', S_i.BEARING_HOUSING_list[stamping_press_type] + '.1', -S_assmebly_par['PANEL_YZ'], 'YZ plane', 0, 237)
    mprog.add_offset_assembly(S_i.PANEL_list[stamping_press_type]+'.1', S_i.BEARING_HOUSING_list[stamping_press_type] + '.1', 0, 'ZX plane', 0, 238)
    mprog.add_offset_assembly(S_i.POINTER_list[stamping_press_type]+'.1', S_i.PANEL_list[stamping_press_type]+'.1', 0, 'XY plane', 1, 239)
    mprog.add_offset_assembly(S_i.POINTER_list[stamping_press_type]+'.1', S_i.PANEL_list[stamping_press_type]+'.1', -10, 'YZ plane', 0, 240)
    mprog.add_offset_assembly(S_i.POINTER_list[stamping_press_type]+'.1', S_i.PANEL_list[stamping_press_type]+'.1', 0, 'ZX plane', 0, 241)
    mprog.add_offset_assembly(S_i.slide_gib_list_left[stamping_press_type]+'.1', 'FRAME1.1', -(apv['FRAME1']['E']+apv['FRAME1']['D']+ zeta), 'XY plane', 0, 248)
    mprog.add_offset_assembly(S_i.slide_gib_list_left[stamping_press_type]+'.1', 'FRAME1.1', (apv['FRAME1']['F']-apv['FRAME1']['G']+S_assmebly_par['SGL_YZ']), 'YZ plane', 1, 249)
    mprog.add_offset_assembly(S_i.slide_gib_list_left[stamping_press_type]+'.1', 'FRAME1.1', -(S_assmebly_par['SGL_ZX']-apv['FRAME1']['CC']/2), 'ZX plane', 0, 250)
    mprog.add_offset_assembly(S_i.slide_gib_list_right[stamping_press_type]+'.1', S_i.slide_gib_list_left[stamping_press_type]+'.1', 0, 'XY plane', 0, 251)
    mprog.add_offset_assembly(S_i.slide_gib_list_right[stamping_press_type]+'.1', S_i.slide_gib_list_left[stamping_press_type]+'.1', 0, 'YZ plane', 0, 252)
    mprog.add_offset_assembly(S_i.slide_gib_list_right[stamping_press_type]+'.1', S_i.slide_gib_list_left[stamping_press_type]+'.1', -(S_assmebly_par['SGR_ZX']), 'ZX plane', 0, 253)
    mprog.add_offset_assembly('OGASKL060_OIL_LEVEL_GAUGE.1', 'FRAME1.1', (apv['FRAME1']['A']-apv['FRAME1']['a1'])+S_assmebly_par['OLG_F_XY']+zeta, 'XY plane', 1, 254)
    mprog.add_offset_assembly('OGASKL060_OIL_LEVEL_GAUGE.1', 'FRAME1.1', -((apv['FRAME1']['F']-apv['FRAME1']['G']-apv['FRAME1']['b'])-S_assmebly_par['OLG_F_YZ']), 'YZ plane', 0, 255)
    mprog.add_offset_assembly('OGASKL060_OIL_LEVEL_GAUGE.1', 'FRAME1.1', -(apv['FRAME1']['CC']/2+S_assmebly_par['OLG_F_ZX']), 'ZX plane', 1, 256)
    mprog.add_offset_assembly('EWR60S01_ELECTRIC_BOX_PLATE.1', 'FRAME2.1', -(apv['FRAME2']['w4']-apv['FRAME2']['kk1']-S_assmebly_par['EBP_XY']), 'XY plane', 0, 260)
    mprog.add_offset_assembly('EWR60S01_ELECTRIC_BOX_PLATE.1', 'FRAME2.1', -(apv['FRAME2']['F']-apv['FRAME2']['G']-apv['FRAME2']['jj']+apv['FRAME2']['ll1']-S_assmebly_par['EBP_YZ']), 'YZ plane', 0, 261)
    mprog.add_offset_assembly('EWR60S01_ELECTRIC_BOX_PLATE.1', 'FRAME2.1', -(apv['FRAME2']['CC']/2), 'ZX plane', 0, 262)
    mprog.add_offset_assembly('EWR60S01_ELECTRIC_BOX_PLATE.2', 'EWR60S01_ELECTRIC_BOX_PLATE.1', 0, 'XY plane', 0, 263)
    mprog.add_offset_assembly('EWR60S01_ELECTRIC_BOX_PLATE.2', 'EWR60S01_ELECTRIC_BOX_PLATE.1', (apv['FRAME2']['ll1']+apv['FRAME2']['ll2']), 'YZ plane', 0, 264)
    mprog.add_offset_assembly('EWR60S01_ELECTRIC_BOX_PLATE.2', 'EWR60S01_ELECTRIC_BOX_PLATE.1', 0, 'ZX plane', 0, 265)
    mprog.add_offset_assembly(S_i.ELECTRIC_BOX_list_normal[stamping_press_type]+'.1', 'EWR60S01_ELECTRIC_BOX_PLATE.1', -(S_assmebly_par['EB_XY']), 'XY plane', 0, 266)
    mprog.add_offset_assembly(S_i.ELECTRIC_BOX_list_normal[stamping_press_type]+'.1', 'EWR60S01_ELECTRIC_BOX_PLATE.1', -(S_assmebly_par['EBP_YZ']+S_assmebly_par['EB_YZ']), 'YZ plane', 0, 267)
    mprog.add_offset_assembly(S_i.ELECTRIC_BOX_list_normal[stamping_press_type]+'.1', 'EWR60S01_ELECTRIC_BOX_PLATE.1', -5, 'ZX plane', 0, 268)
    mprog.add_offset_assembly('EGPSSGD1000IS_MOUNT_FILTER.1', 'FRAME1.1', (apv['FRAME1']['e4']+apv['FRAME1']['e3']), 'XY plane', 1, 278)
    mprog.add_offset_assembly('EGPSSGD1000IS_MOUNT_FILTER.1', 'FRAME1.1', -(apv['FRAME1']['g']-(apv['FRAME1']['d']-apv['FRAME1']['i'])), 'YZ plane', 0, 279)
    mprog.add_offset_assembly('EGPSSGD1000IS_MOUNT_FILTER.1', 'FRAME1.1', -(apv['FRAME1']['CC']/2), 'ZX plane', 1, 280)
    mprog.add_offset_assembly(S_i.TRADEMARK_NAMEPLATE_list_normal[stamping_press_type]+'.1', 'FRAME1.1', -(apv['FRAME1']['A']-S_assmebly_par['TN_XY'])-zeta, 'XY plane', 0, 281)
    mprog.add_offset_assembly(S_i.TRADEMARK_NAMEPLATE_list_normal[stamping_press_type]+'.1', 'FRAME1.1', -(apv['FRAME1']['F']-S_assmebly_par['TN_YZ']), 'YZ plane', 0, 282)
    mprog.add_offset_assembly(S_i.TRADEMARK_NAMEPLATE_list_normal[stamping_press_type]+'.1', 'FRAME1.1', -(apv['FRAME1']['CC']/2), 'ZX plane', 1, 283)
    mprog.add_offset_assembly(S_i.TRADEMARK_NAMEPLATE_list_normal[stamping_press_type]+'.2', 'FRAME2.1', -(apv['FRAME1']['A']-S_assmebly_par['TN_XY'])-zeta, 'XY plane', 0, 284)
    mprog.add_offset_assembly(S_i.TRADEMARK_NAMEPLATE_list_normal[stamping_press_type]+'.2', 'FRAME2.1', (apv['FRAME1']['F']-S_assmebly_par['TN_YZ']+S_assmebly_par['TN_2_YZ']), 'YZ plane', 1, 285)
    mprog.add_offset_assembly(S_i.TRADEMARK_NAMEPLATE_list_normal[stamping_press_type]+'.2', 'FRAME2.1', -(apv['FRAME1']['CC']/2), 'ZX plane', 0, 286)
    mprog.add_offset_assembly(S_i.NAME_PLATE_list_normal[stamping_press_type]+'.1', 'FRAME30.1', -(apv['FRAME30']['A']-S_assmebly_par['NP_XY'])-epsilon, 'XY plane', 0, 287)
    mprog.add_offset_assembly(S_i.NAME_PLATE_list_normal[stamping_press_type]+'.1', 'FRAME30.1', -(apv['FRAME30']['M']/2+S_assmebly_par['NP_YZ']), 'YZ plane', 0, 288)
    mprog.add_offset_assembly(S_i.NAME_PLATE_list_normal[stamping_press_type]+'.1', 'FRAME30.1', -(apv['FRAME30']['E']-S_assmebly_par['NP_ZX']), 'ZX plane', 1, 289)
    mprog.add_offset_assembly(S_i.GUARD_FLYWHEEL_list_normal[stamping_press_type]+'.1', 'FRAME1.1', (S_assmebly_par['GF_XY'])+zeta, 'XY plane', 1, 290)
    mprog.add_offset_assembly(S_i.GUARD_FLYWHEEL_list_normal[stamping_press_type]+'.1', 'FRAME1.1', 6, 'YZ plane', 0, 291)
    mprog.add_offset_assembly(S_i.GUARD_FLYWHEEL_list_normal[stamping_press_type]+'.1', 'FRAME1.1', (S_assmebly_par['GF_ZX']), 'ZX plane', 1, 292)
    mprog.add_offset_assembly(S_i.PORTABLE_STAND_list[stamping_press_type]+'.1', 'FRAME22.1', (apv['FRAME22']['A(1)']-apv['FRAME22']['a']+S_assmebly_par['PS_XY']), 'XY plane', 1, 296)
    mprog.add_offset_assembly(S_i.PORTABLE_STAND_list[stamping_press_type]+'.1', 'FRAME22.1', -apv['FRAME22']['O'], 'YZ plane', 0, 297)
    mprog.add_offset_assembly(S_i.PORTABLE_STAND_list[stamping_press_type]+'.1', 'FRAME22.1', -(apv['FRAME22']['D']-apv['FRAME22']['c']+S_assmebly_par['PS_ZX']), 'ZX plane', 1, 298)
    mprog.add_offset_assembly(S_i.OPERATION_BOX_list_normal[stamping_press_type] + '.1', S_i.PORTABLE_STAND_list[stamping_press_type] + '.1',
                              0, 'XY plane', 0, 299)
    mprog.add_offset_assembly(S_i.OPERATION_BOX_list_normal[stamping_press_type] + '.1', S_i.PORTABLE_STAND_list[stamping_press_type] + '.1', -S_assmebly_par['OB_YZ'],
                              'YZ plane', 0, 300)
    mprog.add_offset_assembly(S_i.OPERATION_BOX_list_normal[stamping_press_type] + '.1', S_i.PORTABLE_STAND_list[stamping_press_type] + '.1',
                              -(S_assmebly_par['OB_ZX']), 'ZX plane', 1,
                              301)
    mprog.add_offset_assembly(S_i.BEARING_HOUSING_list[stamping_press_type] + '.1', 'FRAME30.1', -apv['FRAME30']['h'], 'XY plane', 0, 302)
    mprog.add_offset_assembly(S_i.BEARING_HOUSING_list[stamping_press_type] + '.1', 'FRAME30.1', -(S_assmebly_par['BH_YZ']), 'YZ plane', 0, 303)
    mprog.add_offset_assembly(S_i.BEARING_HOUSING_list[stamping_press_type] + '.1', 'FRAME30.1', apv['FRAME30']['E'] / 2, 'ZX plane', 0, 304)
    mprog.add_offset_assembly('slide.1', 'plate.1', -(specifications_close_working_height_value+par.plate_all_parameter['C']+specifications_travel_value), 'XY plane', 0, 308)
    mprog.add_offset_assembly('slide.1', 'plate.1', (par.plate_length_width[1]/2), 'YZ plane', 1, 309)
    mprog.add_offset_assembly('slide.1', 'plate.1', par.plate_length_width[0]/2, 'ZX plane', 0, 310)
    mprog.add_offset_assembly(S_i.BALANCER_list[stamping_press_type] + '.1', 'FRAME1.1', -(apv['FRAME1']['A']-apv['FRAME1']['bbbbb']+S_assmebly_par['B_XY']+ zeta), 'XY plane', 0, 311)
    mprog.add_offset_assembly(S_i.BALANCER_list[stamping_press_type] + '.1', 'FRAME1.1', -(apv['FRAME1']['F']-apv['FRAME1']['fffff1'] + apv['FRAME1']['ddddd1'] - S_assmebly_par['B_YZ']), 'YZ plane', 0, 312)
    mprog.add_offset_assembly(S_i.BALANCER_list[stamping_press_type] + '.1', 'FRAME1.1', -S_assmebly_par['B_ZX'], 'ZX plane', 0, 313)
    mprog.add_offset_assembly(S_i.BALANCER_list[stamping_press_type] + '.2', S_i.BALANCER_list[stamping_press_type] + '.1', 0, 'XY plane', 0, 314)
    mprog.add_offset_assembly(S_i.BALANCER_list[stamping_press_type] + '.2', S_i.BALANCER_list[stamping_press_type] + '.1', 0, 'YZ plane', 0, 315)
    mprog.add_offset_assembly(S_i.BALANCER_list[stamping_press_type] + '.2', S_i.BALANCER_list[stamping_press_type] + '.1', -S_assmebly_par['B2_ZX'], 'ZX plane', 0, 316)
    mprog.add_offset_assembly(S_i.OIL_LEVEL_GAUGE_list_SLIDE[stamping_press_type] + '.1', 'slide.1', -S_assmebly_par['OLS_XY'], 'XY plane', 0, 317)
    mprog.add_offset_assembly(S_i.OIL_LEVEL_GAUGE_list_SLIDE[stamping_press_type] + '.1', 'slide.1', -S_assmebly_par['OLS_YZ'], 'YZ plane', 0, 318)
    mprog.add_offset_assembly(S_i.OIL_LEVEL_GAUGE_list_SLIDE[stamping_press_type] + '.1', 'slide.1', -S_assmebly_par['OLS_ZX'], 'ZX plane', 0, 319)
    mprog.add_offset_assembly(S_i.OIL_LEVEL_GAUGE_list_SLIDE[stamping_press_type] + '.2', 'slide.1', -S_assmebly_par['OLS2_XY'], 'XY plane', 0, 320)
    mprog.add_offset_assembly(S_i.OIL_LEVEL_GAUGE_list_SLIDE[stamping_press_type] + '.2', 'slide.1', -S_assmebly_par['OLS2_YZ'], 'YZ plane', 0, 321)
    mprog.add_offset_assembly(S_i.OIL_LEVEL_GAUGE_list_SLIDE[stamping_press_type] + '.2', 'slide.1', -S_assmebly_par['OLS2_ZX'], 'ZX plane', 0, 322)
    mprog.add_offset_assembly('MZW8702_WIRE_CASING.1', S_i.ELECTRIC_BOX_list_normal[stamping_press_type] + '.1', S_assmebly_par['EW_XY'], 'XY plane', 0, 329)
    mprog.add_offset_assembly('MZW8702_WIRE_CASING.1', S_i.ELECTRIC_BOX_list_normal[stamping_press_type] + '.1', S_assmebly_par['EW_YZ'], 'YZ plane', 0, 330)
    mprog.add_offset_assembly('MZW8702_WIRE_CASING.1', S_i.ELECTRIC_BOX_list_normal[stamping_press_type] + '.1', 0, 'ZX plane', 1, 331)
    mprog.add_offset_assembly('43N6603_WIRE_CASING.1', 'FRAME2.1', -(apv['FRAME2']['w4']-apv['FRAME2']['l2']-apv['FRAME2']['l3']-apv['FRAME2']['l4']-apv['FRAME2']['l5']/2), 'XY plane', 0, 332)
    mprog.add_offset_assembly('43N6603_WIRE_CASING.1', 'FRAME2.1', -(apv['FRAME2']['k']-15), 'YZ plane', 0, 333)
    mprog.add_offset_assembly('43N6603_WIRE_CASING.1', 'FRAME2.1', -(apv['FRAME2']['CC']/2+S_assmebly_par['EF_ZX']), 'ZX plane', 1, 334)
    mprog.add_offset_assembly('43N6604_WIRE_CASING.1', '43N6603_WIRE_CASING.1', 0, 'XY plane', 0, 335)
    mprog.add_offset_assembly('43N6604_WIRE_CASING.1', '43N6603_WIRE_CASING.1', 0, 'YZ plane', 0, 336)
    mprog.add_offset_assembly('43N6604_WIRE_CASING.1', '43N6603_WIRE_CASING.1', -(S_assmebly_par['EE_ZX']), 'ZX plane', 0, 337)
    mprog.add_offset_assembly('FRAME_WIRE_CASING.1', 'FRAME2.1', -(apv['FRAME2']['w4']-apv['FRAME_WIRE_CASING']['B']), 'XY plane', 0, 338)
    mprog.add_offset_assembly('FRAME_WIRE_CASING.1', 'FRAME2.1', -(apv['FRAME2']['k']-apv['FRAME_WIRE_CASING']['E']/2), 'YZ plane', 0, 339)
    mprog.add_offset_assembly('FRAME_WIRE_CASING.1', 'FRAME2.1', -(apv['FRAME2']['CC']/2), 'ZX plane', 1, 340)
    # 選配零件(用try防止沒有選配到該零件的時候跳錯)
    try:
        mprog.add_offset_assembly('plate.1', 'FRAME22.1', -(apv['FRAME22']['A(1)']-apv['FRAME22']['A(2)']), 'XY plane', 0, 305)
        mprog.add_offset_assembly('plate.1', 'FRAME22.1', (par.plate_length_width[1]/2-assmebly_par['Ass_AL']+apv['FRAME22']['O']), 'YZ plane', 1, 306)
        mprog.add_offset_assembly('plate.1', 'FRAME22.1', -(par.plate_length_width[0]/2-apv['FRAME22']['D']/2), 'ZX plane', 0, 307)
        if GUM == '穎益':
            mprog.add_offset_assembly(S_i.GUM_E_list[stamping_press_type] + '.1', 'FRAME10.1',
                                      (S_assmebly_par['AVG_E_XY']+apv['FRAME10']['K(2)']), 'XY plane', 1, 341)
            mprog.add_offset_assembly(S_i.GUM_E_list[stamping_press_type] + '.1', 'FRAME10.1',
                                      (apv['FRAME10']['B']/2),
                                      'YZ plane', 0, 342)
            mprog.add_offset_assembly(S_i.GUM_E_list[stamping_press_type] + '.1', 'FRAME10.1',
                                      -(apv['FRAME10']['A']-apv['FRAME10']['a']), 'ZX plane', 0, 343)
            mprog.add_offset_assembly(S_i.GUM_E_list[stamping_press_type] + '.2', 'FRAME10.2',
                                      (S_assmebly_par['AVG_E_XY']), 'XY plane', 0, 344)
            mprog.add_offset_assembly(S_i.GUM_E_list[stamping_press_type] + '.2', 'FRAME10.2',
                                      (apv['FRAME10']['B']/2),
                                      'YZ plane', 0, 345)
            mprog.add_offset_assembly(S_i.GUM_E_list[stamping_press_type] + '.2', 'FRAME10.2',
                                      (apv['FRAME10']['A']-apv['FRAME10']['a']), 'ZX plane', 1, 346)
            mprog.add_offset_assembly(S_i.GUM_E_list[stamping_press_type] + '.3', 'FRAME35.1',
                                      (S_assmebly_par['AVG_E_XY']), 'XY plane', 0, 347)
            mprog.add_offset_assembly(S_i.GUM_E_list[stamping_press_type] + '.3', 'FRAME35.1',
                                      (apv['FRAME35']['B']-apv['FRAME35']['a']-apv['FRAME35']['b']),
                                      'YZ plane', 0, 348)
            mprog.add_offset_assembly(S_i.GUM_E_list[stamping_press_type] + '.3', 'FRAME35.1',
                                      (apv['FRAME35']['A']-apv['FRAME35']['e']), 'ZX plane', 1, 349)
            mprog.add_offset_assembly(S_i.GUM_E_list[stamping_press_type] + '.4', 'FRAME35.2',
                                      (S_assmebly_par['AVG_E_XY']+apv['FRAME10']['K(2)']), 'XY plane', 1, 350)
            mprog.add_offset_assembly(S_i.GUM_E_list[stamping_press_type] + '.4', 'FRAME35.2',
                                      (apv['FRAME35']['B']-apv['FRAME35']['a']-apv['FRAME35']['b']),
                                      'YZ plane', 0, 351)
            mprog.add_offset_assembly(S_i.GUM_E_list[stamping_press_type] + '.4', 'FRAME35.2',
                                      -(apv['FRAME35']['A']-apv['FRAME35']['e']), 'ZX plane', 0, 352)
        elif GUM == 'UNISORB':
            mprog.add_offset_assembly(S_i.GUM_U_list[stamping_press_type] + '.1', 'FRAME10.1',
                                      (S_assmebly_par['AVG_U_XY']+apv['FRAME10']['K(2)']), 'XY plane', 1, 341)
            mprog.add_offset_assembly(S_i.GUM_U_list[stamping_press_type] + '.1', 'FRAME10.1',
                                      (apv['FRAME10']['B']/2),
                                      'YZ plane', 0, 342)
            mprog.add_offset_assembly(S_i.GUM_U_list[stamping_press_type] + '.1', 'FRAME10.1',
                                      -(apv['FRAME10']['A']-apv['FRAME10']['a']), 'ZX plane', 0, 343)
            mprog.add_offset_assembly(S_i.GUM_U_list[stamping_press_type] + '.2', 'FRAME10.2',
                                      (S_assmebly_par['AVG_U_XY']), 'XY plane', 0, 344)
            mprog.add_offset_assembly(S_i.GUM_U_list[stamping_press_type] + '.2', 'FRAME10.2',
                                      (apv['FRAME10']['B']/2),
                                      'YZ plane', 0, 345)
            mprog.add_offset_assembly(S_i.GUM_U_list[stamping_press_type] + '.2', 'FRAME10.2',
                                      (apv['FRAME10']['A']-apv['FRAME10']['a']), 'ZX plane', 1, 346)
            mprog.add_offset_assembly(S_i.GUM_U_list[stamping_press_type] + '.3', 'FRAME35.1',
                                      (S_assmebly_par['AVG_U_XY']), 'XY plane', 0, 347)
            mprog.add_offset_assembly(S_i.GUM_U_list[stamping_press_type] + '.3', 'FRAME35.1',
                                      (apv['FRAME35']['B']-apv['FRAME35']['a']-apv['FRAME35']['b']),
                                      'YZ plane', 0, 348)
            mprog.add_offset_assembly(S_i.GUM_U_list[stamping_press_type] + '.3', 'FRAME35.1',
                                      (apv['FRAME35']['A']-apv['FRAME35']['e']), 'ZX plane', 1, 349)
            mprog.add_offset_assembly(S_i.GUM_U_list[stamping_press_type] + '.4', 'FRAME35.2',
                                      (S_assmebly_par['AVG_U_XY']+apv['FRAME10']['K(2)']), 'XY plane', 1, 350)
            mprog.add_offset_assembly(S_i.GUM_U_list[stamping_press_type] + '.4', 'FRAME35.2',
                                      (apv['FRAME35']['B']-apv['FRAME35']['a']-apv['FRAME35']['b']),
                                      'YZ plane', 0, 351)
            mprog.add_offset_assembly(S_i.GUM_U_list[stamping_press_type] + '.4', 'FRAME35.2',
                                      -(apv['FRAME35']['A']-apv['FRAME35']['e']), 'ZX plane', 0, 352)
        elif GUM == '商定':
            mprog.add_offset_assembly(S_i.GUM_S_list[stamping_press_type] + '.1', 'FRAME10.1',
                                      (S_assmebly_par['AVG_S_XY']+apv['FRAME10']['K(2)']), 'XY plane', 1, 341)
            mprog.add_offset_assembly(S_i.GUM_S_list[stamping_press_type] + '.1', 'FRAME10.1',
                                      (apv['FRAME10']['B']/2),
                                      'YZ plane', 0, 342)
            mprog.add_offset_assembly(S_i.GUM_S_list[stamping_press_type] + '.1', 'FRAME10.1',
                                      -(apv['FRAME10']['A']-apv['FRAME10']['a']), 'ZX plane', 0, 343)
            mprog.add_offset_assembly(S_i.GUM_S_list[stamping_press_type] + '.2', 'FRAME10.2',
                                      (S_assmebly_par['AVG_S_XY']), 'XY plane', 0, 344)
            mprog.add_offset_assembly(S_i.GUM_S_list[stamping_press_type] + '.2', 'FRAME10.2',
                                      (apv['FRAME10']['B']/2),
                                      'YZ plane', 0, 345)
            mprog.add_offset_assembly(S_i.GUM_S_list[stamping_press_type] + '.2', 'FRAME10.2',
                                      (apv['FRAME10']['A']-apv['FRAME10']['a']), 'ZX plane', 1, 346)
            mprog.add_offset_assembly(S_i.GUM_S_list[stamping_press_type] + '.3', 'FRAME35.1',
                                      (S_assmebly_par['AVG_S_XY']), 'XY plane', 0, 347)
            mprog.add_offset_assembly(S_i.GUM_S_list[stamping_press_type] + '.3', 'FRAME35.1',
                                      (apv['FRAME35']['B']-apv['FRAME35']['a']-apv['FRAME35']['b']),
                                      'YZ plane', 0, 348)
            mprog.add_offset_assembly(S_i.GUM_S_list[stamping_press_type] + '.3', 'FRAME35.1',
                                      (apv['FRAME35']['A']-apv['FRAME35']['e']), 'ZX plane', 1, 349)
            mprog.add_offset_assembly(S_i.GUM_S_list[stamping_press_type] + '.4', 'FRAME35.2',
                                      (S_assmebly_par['AVG_S_XY']+apv['FRAME10']['K(2)']), 'XY plane', 1, 350)
            mprog.add_offset_assembly(S_i.GUM_S_list[stamping_press_type] + '.4', 'FRAME35.2',
                                      (apv['FRAME35']['B']-apv['FRAME35']['a']-apv['FRAME35']['b']),
                                      'YZ plane', 0, 351)
            mprog.add_offset_assembly(S_i.GUM_S_list[stamping_press_type] + '.4', 'FRAME35.2',
                                      -(apv['FRAME35']['A']-apv['FRAME35']['e']), 'ZX plane', 0, 352)
    except:
        pass
    #25頓
    if stamping_press_type == 0:
        mprog.add_offset_assembly('FRAME33.1', 'FRAME1.1', 0, 'XY plane', 0, 19)
        mprog.add_offset_assembly('FRAME33.1', 'FRAME1.1', -(apv['FRAME1']['B']-apv['FRAME33']['B']), 'YZ plane', 0, 20)
        mprog.add_offset_assembly('FRAME33.1', 'FRAME1.1', -(apv['FRAME33']['K']+apv['FRAME1']['CC']/2), 'ZX plane', 0, 21)
        mprog.add_offset_assembly('FRAME34.1', 'FRAME2.1', 0, 'XY plane', 0, 22)
        mprog.add_offset_assembly('FRAME34.1', 'FRAME2.1', -(apv['FRAME2']['B']-apv['FRAME34']['B']), 'YZ plane', 0, 23)
        mprog.add_offset_assembly('FRAME34.1', 'FRAME2.1', apv['FRAME2']['CC']/2, 'ZX plane', 0, 24)
        mprog.add_offset_assembly('FRAME31.1', 'FRAME4.1', -(apv['FRAME4']['A']-apv['FRAME4']['a']-apv['FRAME4']['b']/2), 'XY plane', 0, 49)
        mprog.add_offset_assembly('FRAME31.1', 'FRAME4.1', -(apv['FRAME4']['C']-assmebly_par['Ass_H']), 'YZ plane', 0, 50)
        mprog.add_offset_assembly('FRAME31.1', 'FRAME4.1', apv['FRAME4']['B']/2-apv['FRAME4']['b']/2, 'ZX plane', 0, 51)
        mprog.add_offset_assembly('FRAME11.1', 'FRAME3.1', -(apv['FRAME3']['A']-apv['FRAME3']['E']-apv['FRAME11']['A']/2), 'XY plane', 0, 64)
        mprog.add_offset_assembly('FRAME11.1', 'FRAME3.1', apv['FRAME3']['O']+assmebly_par['Ass_I'], 'YZ plane', 0, 65)
        mprog.add_offset_assembly('FRAME11.1', 'FRAME3.1', apv['FRAME3']['B']/2+apv['FRAME11']['A']/2, 'ZX plane', 0, 66)
        mprog.add_offset_assembly('FRAME36.1', 'FRAME4.1', -((assmebly_par['Ass_J']-apv['FRAME36']['A']/2)+(apv['FRAME4']['A']-apv['FRAME4']['a'])), 'XY plane', 0, 67)
        mprog.add_offset_assembly('FRAME36.1', 'FRAME4.1', -(apv['FRAME4']['K']+(apv['FRAME25']['A']-apv['FRAME36']['C'])), 'YZ plane', 0, 68)
        mprog.add_offset_assembly('FRAME36.1', 'FRAME4.1', apv['FRAME4']['B']-apv['FRAME36']['D'], 'ZX plane', 0, 69)
        mprog.add_offset_assembly('FRAME25.1', 'FRAME4.1', -((assmebly_par['Ass_J']-apv['FRAME25']['B'])+(apv['FRAME4']['A']-apv['FRAME4']['a'])), 'XY plane', 0, 85)
        mprog.add_offset_assembly('FRAME25.1', 'FRAME4.1', -(apv['FRAME4']['K']), 'YZ plane', 0, 86)
        mprog.add_offset_assembly('FRAME25.1', 'FRAME4.1', assmebly_par['Ass_P']+apv['FRAME4']['B']/2, 'ZX plane', 0, 87)
        mprog.add_offset_assembly('FRAME29.1', 'FRAME4.1', -(
                        assmebly_par['Ass_Q'] + (apv['FRAME4']['A'] - apv['FRAME4']['a']) - apv['FRAME29']['A'] / 2),
                                      'XY plane', 0, 94)
        mprog.add_offset_assembly('FRAME29.1', 'FRAME4.1', apv['FRAME29']['B'] - (apv['FRAME29']['B'] - apv['FRAME29']['F']), 'YZ plane', 0, 95)
        mprog.add_offset_assembly('FRAME29.1', 'FRAME4.1',
                                      apv['FRAME4']['B'] / 2 - apv['FRAME6']['e'] + apv['FRAME29']['A'] / 2, 'ZX plane', 0, 96)
        mprog.add_offset_assembly('FRAME29.2', 'FRAME4.1', -(
                        assmebly_par['Ass_Q'] + (apv['FRAME4']['A'] - apv['FRAME4']['a']) - apv['FRAME29']['A'] / 2),
                                      'XY plane', 0, 97)
        mprog.add_offset_assembly('FRAME29.2', 'FRAME4.1', apv['FRAME29']['B'] - (apv['FRAME29']['B'] - apv['FRAME29']['F']), 'YZ plane', 0, 98)
        mprog.add_offset_assembly('FRAME29.2', 'FRAME4.1',
                                      apv['FRAME4']['B'] / 2 + apv['FRAME6']['e'] + apv['FRAME29']['A'] / 2, 'ZX plane', 0, 99)
        mprog.add_offset_assembly('FRAME27.1', 'FRAME1.1', -(apv['FRAME1']['A'] - apv['FRAME27']['A']) - zeta,
                                  'XY plane', 0,
                                  52)
        mprog.add_offset_assembly('FRAME27.1', 'FRAME1.1', -(
                apv['FRAME1']['F'] - apv['FRAME27']['B'] - apv['FRAME30']['M'] - apv['FRAME27']['J']),
                                  'YZ plane',
                                  0, 53)
        mprog.add_offset_assembly('FRAME27.1', 'FRAME1.1', -(apv['FRAME1']['CC'] / 2), 'ZX plane', 0, 54)
        mprog.add_offset_assembly('FRAME27_1.1', 'FRAME2.1', -(apv['FRAME2']['A'] - apv['FRAME27_1']['A']) - zeta,
                                  'XY plane',
                                  0, 55)
        mprog.add_offset_assembly('FRAME27_1.1', 'FRAME2.1', -(
                apv['FRAME2']['F'] - apv['FRAME27_1']['B'] - apv['FRAME30']['M'] - apv['FRAME27_1']['J']),
                                  'YZ plane', 0, 56)
        mprog.add_offset_assembly('FRAME27_1.1', 'FRAME2.1', apv['FRAME27_1']['I'] + apv['FRAME2']['CC'] / 2,
                                  'ZX plane', 0, 57)
        mprog.add_offset_assembly('FRAME6.1', 'FRAME4.1', assmebly_par['Ass_Q']-(apv['FRAME4']['A']-apv['FRAME4']['a'])-apv['FRAME6']['E']/2, 'XY plane', 0, 88)
        mprog.add_offset_assembly('FRAME6.1', 'FRAME4.1', 0, 'YZ plane', 1, 89)
        mprog.add_offset_assembly('FRAME6.1', 'FRAME4.1', -(apv['FRAME4']['B']/2-apv['FRAME6']['f']), 'ZX plane', 1, 90)
        mprog.add_offset_assembly('FRAME6.2', 'FRAME4.1', assmebly_par['Ass_Q']-(apv['FRAME4']['A']-apv['FRAME4']['a'])-apv['FRAME6']['E']/2, 'XY plane', 0, 91)
        mprog.add_offset_assembly('FRAME6.2', 'FRAME4.1', apv['FRAME6']['i'], 'YZ plane', 0, 92)
        mprog.add_offset_assembly('FRAME6.2', 'FRAME4.1', apv['FRAME4']['B']/2+apv['FRAME6']['f'], 'ZX plane', 0, 93)
        mprog.add_offset_assembly('FRAME21.1', 'FRAME1.1',apv['FRAME2']['A']-apv['FRAME30']['A']-(apv['FRAME17']['g3']-apv['FRAME17']['g2'])-apv['FRAME13']['k']-apv['FRAME13']['j']-assmebly_par['Ass_V']-assmebly_par['Ass_S']+zeta, 'XY plane', 1, 127)
        mprog.add_offset_assembly('FRAME21.1', 'FRAME1.1',-(apv['FRAME2']['F']-apv['FRAME2']['G'] - apv['FRAME2']['FF'] -assmebly_par['Ass_T']-apv['FRAME21']['D']), 'YZ plane', 0, 128)
        mprog.add_offset_assembly('FRAME21.1', 'FRAME1.1',-(apv['FRAME3']['B']/2-assmebly_par['Ass_U']+apv['FRAME1']['CC']/2-apv['FRAME21']['C']), 'ZX plane', 0, 129)
        mprog.add_offset_assembly('FRAME21.2', 'FRAME2.1',apv['FRAME2']['A']-apv['FRAME30']['A']-(apv['FRAME17']['g3']-apv['FRAME17']['g2'])-apv['FRAME13']['k']-apv['FRAME13']['j']-assmebly_par['Ass_V']-assmebly_par['Ass_S']+zeta, 'XY plane', 1, 130)
        mprog.add_offset_assembly('FRAME21.2', 'FRAME2.1',-(apv['FRAME2']['F']-apv['FRAME2']['G'] - apv['FRAME2']['FF'] - assmebly_par['Ass_T']-apv['FRAME21']['D']), 'YZ plane', 0, 131)
        mprog.add_offset_assembly('FRAME21.2', 'FRAME2.1',(apv['FRAME3']['B']/2-assmebly_par['Ass_U']+apv['FRAME1']['CC']/2), 'ZX plane', 0, 132)
        mprog.add_offset_assembly('FRAME37.1', 'FRAME2.1', -(apv['FRAME2']['A']-apv['FRAME2']['ffff']-apv['FRAME37']['A']/2), 'XY plane', 0, 142)
        mprog.add_offset_assembly('FRAME37.1', 'FRAME2.1', -(apv['FRAME2']['F']-apv['FRAME2']['eeee']-apv['FRAME37']['A']/2), 'YZ plane', 0, 143)
        mprog.add_offset_assembly('FRAME37.1', 'FRAME2.1', apv['FRAME2']['CC']/2, 'ZX plane', 0, 144)
        mprog.add_offset_assembly('FRAME23.1', 'FRAME1.1',
                                  -(apv["FRAME1"]["E"] - apv["FRAME1"]["DD"] - apv["FRAME23"]["I"]), 'XY plane', 0, 145)
        mprog.add_offset_assembly('FRAME23.1', 'FRAME1.1', -(apv['FRAME1']['B'] - apv['FRAME23']['B']),
                                  'YZ plane', 0, 146)
        mprog.add_offset_assembly('FRAME23.1', 'FRAME1.1', -(apv['FRAME1']['CC'] / 2 + apv['FRAME23']['A']), 'ZX plane',
                                  1, 147)
        mprog.add_offset_assembly('FRAME23.2', 'FRAME1.1',
                                  -(apv["FRAME1"]["E"] - apv["FRAME1"]["DD"] - apv["FRAME23"]["I"]), 'XY plane', 0, 148)
        mprog.add_offset_assembly('FRAME23.2', 'FRAME1.1', -(apv["FRAME1"]["B"]-apv["FRAME23"]["B"] - assmebly_par['Ass_Y']),
                                  'YZ plane', 0, 149)
        mprog.add_offset_assembly('FRAME23.2', 'FRAME1.1', -(apv['FRAME1']['CC'] / 2 + apv['FRAME23']['A']), 'ZX plane',
                                  1, 150)
        mprog.add_offset_assembly('FRAME23.3', 'FRAME2.1',
                                  -(apv["FRAME1"]["E"] - apv["FRAME1"]["DD"] - apv["FRAME23"]["I"]), 'XY plane', 0, 151)
        mprog.add_offset_assembly('FRAME23.3', 'FRAME2.1', (apv['FRAME1']['B']),
                                  'YZ plane', 1, 152)
        mprog.add_offset_assembly('FRAME23.3', 'FRAME2.1', -(apv['FRAME1']['CC'] / 2 + apv['FRAME23']['A']), 'ZX plane',
                                  0, 153)
        mprog.add_offset_assembly('FRAME23.4', 'FRAME2.1',
                                  -(apv["FRAME1"]["E"] - apv["FRAME1"]["DD"] - apv["FRAME23"]["I"]), 'XY plane', 0, 154)
        mprog.add_offset_assembly('FRAME23.4', 'FRAME2.1', (apv["FRAME1"]["B"] - assmebly_par['Ass_Y']),
                                  'YZ plane', 1, 155)
        mprog.add_offset_assembly('FRAME23.4', 'FRAME2.1', -(apv['FRAME2']['CC'] / 2 + apv['FRAME23']['A']), 'ZX plane',
                                  0, 156)
        mprog.add_offset_assembly('FRAME15.1', 'FRAME1.1', -(
                apv['FRAME1']['A'] - apv['FRAME30']['A'] - assmebly_par['Ass_S'] - apv['FRAME17']['g3']) - zeta,
                                  'XY plane', 0,
                                  115)
        mprog.add_offset_assembly('FRAME15.1', 'FRAME1.1',
                                  apv['FRAME1']['F'] - apv['FRAME1']['G'] - apv['FRAME2']['FF'] - assmebly_par[
                                      'Ass_T'],
                                  'YZ plane', 1, 116)
        mprog.add_offset_assembly('FRAME15.1', 'FRAME1.1',
                                  apv['FRAME3']['B'] / 2 - assmebly_par['Ass_U'] + apv['FRAME1']['CC'] / 2 -
                                  apv['FRAME15'][
                                      'B'], 'ZX plane', 1, 117)
        mprog.add_offset_assembly('FRAME15.2', 'FRAME2.1', -(
                apv['FRAME2']['A'] - apv['FRAME30']['A'] - assmebly_par['Ass_S'] - apv['FRAME17']['g3']) - zeta,
                                  'XY plane', 0,
                                  118)
        mprog.add_offset_assembly('FRAME15.2', 'FRAME2.1',
                                  apv['FRAME2']['F'] - apv['FRAME2']['G'] - apv['FRAME2']['FF'] - assmebly_par[
                                      'Ass_T'],
                                  'YZ plane', 1, 119)
        mprog.add_offset_assembly('FRAME15.2', 'FRAME2.1',
                                  -(apv['FRAME3']['B'] / 2 - assmebly_par['Ass_U'] + apv['FRAME1']['CC'] / 2),
                                  'ZX plane',
                                  1, 120)
    #35頓
    elif stamping_press_type == 1:
        mprog.add_offset_assembly('FRAME33.1', 'FRAME1.1', 0, 'XY plane', 0, 19)
        mprog.add_offset_assembly('FRAME33.1', 'FRAME1.1', -(apv['FRAME1']['B']-apv['FRAME33']['B']), 'YZ plane', 0, 20)
        mprog.add_offset_assembly('FRAME33.1', 'FRAME1.1', -(apv['FRAME33']['K']+apv['FRAME1']['CC']/2), 'ZX plane', 0, 21)
        mprog.add_offset_assembly('FRAME34.1', 'FRAME2.1', 0, 'XY plane', 0, 22)
        mprog.add_offset_assembly('FRAME34.1', 'FRAME2.1', -(apv['FRAME2']['B']-apv['FRAME34']['B']), 'YZ plane', 0, 23)
        mprog.add_offset_assembly('FRAME34.1', 'FRAME2.1', apv['FRAME2']['CC']/2, 'ZX plane', 0, 24)
        mprog.add_offset_assembly('FRAME31.1', 'FRAME4.1', (apv['FRAME4']['A']-apv['FRAME4']['a']+apv['FRAME31']['F']/2), 'XY plane', 1, 49)
        mprog.add_offset_assembly('FRAME31.1', 'FRAME4.1', -assmebly_par['Ass_H'], 'YZ plane', 1, 50)
        mprog.add_offset_assembly('FRAME31.1', 'FRAME4.1', apv['FRAME4']['B']/2-apv['FRAME31']['F']/2, 'ZX plane', 0, 51)
        mprog.add_offset_assembly('FRAME11.1', 'FRAME3.1', -(apv['FRAME3']['A']-apv['FRAME3']['E']-apv['FRAME11']['A']/2), 'XY plane', 0, 64)
        mprog.add_offset_assembly('FRAME11.1', 'FRAME3.1', apv['FRAME3']['O']+assmebly_par['Ass_I'], 'YZ plane', 0, 65)
        mprog.add_offset_assembly('FRAME11.1', 'FRAME3.1', apv['FRAME3']['B']/2+apv['FRAME11']['A']/2, 'ZX plane', 0, 66)
        mprog.add_offset_assembly('FRAME36.1', 'FRAME4.1', -((assmebly_par['Ass_J']-apv['FRAME36']['F']/2)+(apv['FRAME4']['A']-apv['FRAME4']['a'])), 'XY plane', 0, 67)
        mprog.add_offset_assembly('FRAME36.1', 'FRAME4.1', -(apv['FRAME4']['K']+7.5), 'YZ plane', 0, 68)
        mprog.add_offset_assembly('FRAME36.1', 'FRAME4.1', apv['FRAME4']['B']-apv['FRAME36']['D'], 'ZX plane', 0, 69)
        mprog.add_offset_assembly('FRAME25.1', 'FRAME4.1', -((assmebly_par['Ass_J']-apv['FRAME25']['B'])+(apv['FRAME4']['A']-apv['FRAME4']['a'])), 'XY plane', 0, 85)
        mprog.add_offset_assembly('FRAME25.1', 'FRAME4.1', -(apv['FRAME4']['K']), 'YZ plane', 0, 86)
        mprog.add_offset_assembly('FRAME25.1', 'FRAME4.1', assmebly_par['Ass_P']+apv['FRAME4']['B']/2, 'ZX plane', 0, 87)
        mprog.add_offset_assembly('FRAME29.1', 'FRAME4.1', -(
                assmebly_par['Ass_Q'] + (apv['FRAME4']['A'] - apv['FRAME4']['a']) - apv['FRAME29']['A'] / 2),
                                  'XY plane', 0, 94)
        mprog.add_offset_assembly('FRAME29.1', 'FRAME4.1',
                                  apv['FRAME29']['B'] - (apv['FRAME29']['B'] - apv['FRAME29']['F']), 'YZ plane', 0, 95)
        mprog.add_offset_assembly('FRAME29.1', 'FRAME4.1',
                                  apv['FRAME4']['B'] / 2 - apv['FRAME6']['e'] + apv['FRAME29']['A'] / 2, 'ZX plane', 0,
                                  96)
        mprog.add_offset_assembly('FRAME29.2', 'FRAME4.1', -(
                assmebly_par['Ass_Q'] + (apv['FRAME4']['A'] - apv['FRAME4']['a']) - apv['FRAME29']['A'] / 2),
                                  'XY plane', 0, 97)
        mprog.add_offset_assembly('FRAME29.2', 'FRAME4.1',
                                  apv['FRAME29']['B'] - (apv['FRAME29']['B'] - apv['FRAME29']['F']), 'YZ plane', 0, 98)
        mprog.add_offset_assembly('FRAME29.2', 'FRAME4.1',
                                  apv['FRAME4']['B'] / 2 + apv['FRAME6']['e'] + apv['FRAME29']['A'] / 2, 'ZX plane', 0,
                                  99)
        mprog.add_offset_assembly('FRAME27.1', 'FRAME1.1', -(apv['FRAME1']['A'] - apv['FRAME27']['A']) - zeta,
                                  'XY plane', 0,
                                  52)
        mprog.add_offset_assembly('FRAME27.1', 'FRAME1.1', -(
                apv['FRAME1']['F'] - apv['FRAME27']['B'] - apv['FRAME30']['M'] - apv['FRAME27']['J']),
                                  'YZ plane',
                                  0, 53)
        mprog.add_offset_assembly('FRAME27.1', 'FRAME1.1', -(apv['FRAME1']['CC'] / 2), 'ZX plane', 0, 54)
        mprog.add_offset_assembly('FRAME27_1.1', 'FRAME2.1', -(apv['FRAME2']['A'] - apv['FRAME27_1']['A']) - zeta,
                                  'XY plane',
                                  0, 55)
        mprog.add_offset_assembly('FRAME27_1.1', 'FRAME2.1', -(
                apv['FRAME2']['F'] - apv['FRAME27_1']['B'] - apv['FRAME30']['M'] - apv['FRAME27_1']['J']),
                                  'YZ plane', 0, 56)
        mprog.add_offset_assembly('FRAME27_1.1', 'FRAME2.1', apv['FRAME27_1']['I'] + apv['FRAME2']['CC'] / 2,
                                  'ZX plane', 0, 57)
        mprog.add_offset_assembly('FRAME6.1', 'FRAME4.1', assmebly_par['Ass_Q']-(apv['FRAME4']['A']-apv['FRAME4']['a'])-apv['FRAME6']['E']/2, 'XY plane', 0, 88)
        mprog.add_offset_assembly('FRAME6.1', 'FRAME4.1', 0, 'YZ plane', 1, 89)
        mprog.add_offset_assembly('FRAME6.1', 'FRAME4.1', -(apv['FRAME4']['B']/2-apv['FRAME6']['f']), 'ZX plane', 1, 90)
        mprog.add_offset_assembly('FRAME6.2', 'FRAME4.1', assmebly_par['Ass_Q']-(apv['FRAME4']['A']-apv['FRAME4']['a'])-apv['FRAME6']['E']/2, 'XY plane', 0, 91)
        mprog.add_offset_assembly('FRAME6.2', 'FRAME4.1', apv['FRAME6']['i'], 'YZ plane', 0, 92)
        mprog.add_offset_assembly('FRAME6.2', 'FRAME4.1', apv['FRAME4']['B']/2+apv['FRAME6']['f'], 'ZX plane', 0, 93)
        mprog.add_offset_assembly('FRAME21.1', 'FRAME1.1',apv['FRAME2']['A']-apv['FRAME30']['A']-(apv['FRAME17']['g3']-apv['FRAME17']['g2'])-apv['FRAME13']['k']-apv['FRAME13']['j']-assmebly_par['Ass_V']-assmebly_par['Ass_S']+zeta, 'XY plane', 1, 127)
        mprog.add_offset_assembly('FRAME21.1', 'FRAME1.1',-(apv['FRAME2']['F']-apv['FRAME2']['G']-assmebly_par['Ass_T']-apv['FRAME21']['D']), 'YZ plane', 0, 128)
        mprog.add_offset_assembly('FRAME21.1', 'FRAME1.1',-(apv['FRAME3']['B']/2-assmebly_par['Ass_U']+apv['FRAME1']['CC']/2-apv['FRAME21']['C']), 'ZX plane', 0, 129)
        mprog.add_offset_assembly('FRAME21.2', 'FRAME2.1',apv['FRAME2']['A']-apv['FRAME30']['A']-(apv['FRAME17']['g3']-apv['FRAME17']['g2'])-apv['FRAME13']['k']-apv['FRAME13']['j']-assmebly_par['Ass_V']-assmebly_par['Ass_S']+zeta, 'XY plane', 1, 130)
        mprog.add_offset_assembly('FRAME21.2', 'FRAME2.1',-(apv['FRAME2']['F']-apv['FRAME2']['G']-assmebly_par['Ass_T']-apv['FRAME21']['D']), 'YZ plane', 0, 131)
        mprog.add_offset_assembly('FRAME21.2', 'FRAME2.1',(apv['FRAME3']['B']/2-assmebly_par['Ass_U']+apv['FRAME1']['CC']/2), 'ZX plane', 0, 132)
        mprog.add_offset_assembly('FRAME37.1', 'FRAME2.1', -(apv['FRAME2']['A']-apv['FRAME2']['ffff']-apv['FRAME37']['A']/2), 'XY plane', 0, 142)
        mprog.add_offset_assembly('FRAME37.1', 'FRAME2.1', -(apv['FRAME2']['F']-apv['FRAME2']['eeee']-apv['FRAME37']['A']/2), 'YZ plane', 0, 143)
        mprog.add_offset_assembly('FRAME37.1', 'FRAME2.1', apv['FRAME2']['CC']/2, 'ZX plane', 0, 144)
        mprog.add_offset_assembly('FRAME23.1', 'FRAME1.1',
                                  -(apv["FRAME1"]["E"] - apv["FRAME1"]["DD"] - apv["FRAME23"]["I"]), 'XY plane', 0, 145)
        mprog.add_offset_assembly('FRAME23.1', 'FRAME1.1', -(apv['FRAME1']['B'] - apv['FRAME23']['B']),
                                  'YZ plane', 0, 146)
        mprog.add_offset_assembly('FRAME23.1', 'FRAME1.1', -(apv['FRAME1']['CC'] / 2 + apv['FRAME23']['A']), 'ZX plane',
                                  1, 147)
        mprog.add_offset_assembly('FRAME23.2', 'FRAME1.1',
                                  -(apv["FRAME1"]["E"] - apv["FRAME1"]["DD"] - apv["FRAME23"]["I"]), 'XY plane', 0, 148)
        mprog.add_offset_assembly('FRAME23.2', 'FRAME1.1', -(apv["FRAME1"]["B"]-apv["FRAME23"]["B"] - assmebly_par['Ass_Y']),
                                  'YZ plane', 0, 149)
        mprog.add_offset_assembly('FRAME23.2', 'FRAME1.1', -(apv['FRAME1']['CC'] / 2 + apv['FRAME23']['A']), 'ZX plane',
                                  1, 150)
        mprog.add_offset_assembly('FRAME23.3', 'FRAME2.1',
                                  -(apv["FRAME1"]["E"] - apv["FRAME1"]["DD"] - apv["FRAME23"]["I"]), 'XY plane', 0, 151)
        mprog.add_offset_assembly('FRAME23.3', 'FRAME2.1', (apv['FRAME1']['B']),
                                  'YZ plane', 1, 152)
        mprog.add_offset_assembly('FRAME23.3', 'FRAME2.1', -(apv['FRAME1']['CC'] / 2 + apv['FRAME23']['A']), 'ZX plane',
                                  0, 153)
        mprog.add_offset_assembly('FRAME23.4', 'FRAME2.1',
                                  -(apv["FRAME1"]["E"] - apv["FRAME1"]["DD"] - apv["FRAME23"]["I"]), 'XY plane', 0, 154)
        mprog.add_offset_assembly('FRAME23.4', 'FRAME2.1', (apv["FRAME1"]["B"] - assmebly_par['Ass_Y']),
                                  'YZ plane', 1, 155)
        mprog.add_offset_assembly('FRAME23.4', 'FRAME2.1', -(apv['FRAME2']['CC'] / 2 + apv['FRAME23']['A']), 'ZX plane',
                                  0, 156)
        mprog.add_offset_assembly('FRAME41.2', 'FRAME2.1', (
                apv['FRAME2']['A']-apv['FRAME30']['A']-(apv['FRAME17']['g3']-apv['FRAME17']['g2'])-apv['FRAME13']['k']-apv['FRAME13']['j']-assmebly_par['Ass_V']-assmebly_par['Ass_S']+zeta+apv['FRAME41']['I']),
                                  'XY plane', 1,
                                  161)
        mprog.add_offset_assembly('FRAME41.2', 'FRAME3.1', 0, 'YZ plane', 0, 162)
        mprog.add_offset_assembly('FRAME41.2', 'FRAME3.1', 0, 'ZX plane', 0, 163)
        mprog.add_offset_assembly('FRAME41.1', 'FRAME1.1', -(
                apv['FRAME2']['A']-apv['FRAME30']['A']-(apv['FRAME17']['g3']-apv['FRAME17']['g2'])-apv['FRAME13']['k']-apv['FRAME13']['j']-assmebly_par['Ass_V']-assmebly_par['Ass_S']+zeta),
                                  'XY plane', 0,
                                  164)
        mprog.add_offset_assembly("FRAME41.1", "FRAME3.1", 0, 'YZ plane', 0, 165)
        mprog.add_offset_assembly('FRAME41.1', 'FRAME1.1', (apv['FRAME1']['CC']/2),'ZX plane', 1, 166)
        mprog.add_offset_assembly('FRAME15.1', 'FRAME1.1', -(
                apv['FRAME1']['A'] - apv['FRAME30']['A'] - assmebly_par['Ass_S'] - apv['FRAME17']['g3']) - zeta,
                                  'XY plane', 0,
                                  115)
        mprog.add_offset_assembly('FRAME15.1', 'FRAME1.1',
                                  apv['FRAME1']['F'] - apv['FRAME1']['G'] - apv['FRAME2']['FF'] - assmebly_par[
                                      'Ass_T'] ,
                                  'YZ plane', 1, 116)
        mprog.add_offset_assembly('FRAME15.1', 'FRAME1.1',
                                  apv['FRAME3']['B'] / 2 - assmebly_par['Ass_U'] + apv['FRAME1']['CC'] / 2 -
                                  apv['FRAME15'][
                                      'B'], 'ZX plane', 1, 117)
        mprog.add_offset_assembly('FRAME15.2', 'FRAME2.1', -(
                apv['FRAME2']['A'] - apv['FRAME30']['A'] - assmebly_par['Ass_S'] - apv['FRAME17']['g3']) - zeta,
                                  'XY plane', 0,
                                  118)
        mprog.add_offset_assembly('FRAME15.2', 'FRAME2.1',
                                  apv['FRAME2']['F'] - apv['FRAME2']['G'] - apv['FRAME2']['FF'] - assmebly_par[
                                      'Ass_T'],
                                  'YZ plane', 1, 119)
        mprog.add_offset_assembly('FRAME15.2', 'FRAME2.1',
                                  -(apv['FRAME3']['B'] / 2 - assmebly_par['Ass_U'] + apv['FRAME1']['CC'] / 2),
                                  'ZX plane',
                                  1, 120)
    #45頓
    elif stamping_press_type == 2:
        mprog.add_offset_assembly('FRAME6.1', 'FRAME4.1',
                                  assmebly_par['Ass_Q'] - (apv['FRAME4']['A'] - apv['FRAME4']['a']) - apv['FRAME6'][
                                      'E'] / 2, 'XY plane', 0, 88)
        mprog.add_offset_assembly('FRAME6.1', 'FRAME4.1', 0, 'YZ plane', 1, 89)
        mprog.add_offset_assembly('FRAME6.1', 'FRAME4.1', -(apv['FRAME4']['B'] / 2 - apv['FRAME6']['f']), 'ZX plane', 1,
                                  90)
        mprog.add_offset_assembly('FRAME6.2', 'FRAME4.1',
                                  assmebly_par['Ass_Q'] - (apv['FRAME4']['A'] - apv['FRAME4']['a']) - apv['FRAME6'][
                                      'E'] / 2, 'XY plane', 0, 91)
        mprog.add_offset_assembly('FRAME6.2', 'FRAME4.1', apv['FRAME6']['i'], 'YZ plane', 0, 92)
        mprog.add_offset_assembly('FRAME6.2', 'FRAME4.1', apv['FRAME4']['B'] / 2 + apv['FRAME6']['f'], 'ZX plane', 0,
                                  93)
        mprog.add_offset_assembly('FRAME11.1', 'FRAME3.1',
                                  -(apv['FRAME3']['A'] - apv['FRAME3']['E'] - apv['FRAME11']['A'] / 2), 'XY plane', 0,
                                  64)
        mprog.add_offset_assembly('FRAME11.1', 'FRAME3.1', apv['FRAME3']['O'] + assmebly_par['Ass_I'], 'YZ plane', 0,
                                  65)
        mprog.add_offset_assembly('FRAME11.1', 'FRAME3.1', apv['FRAME3']['B'] / 2 + apv['FRAME11']['A'] / 2, 'ZX plane',
                                  0, 66)
        mprog.add_offset_assembly('FRAME15.1', 'FRAME1.1', -(
                apv['FRAME1']['A'] - apv['FRAME30']['A'] - assmebly_par['Ass_S'] - apv['FRAME17']['g3']) - zeta,
                                  'XY plane', 0,
                                  115)
        mprog.add_offset_assembly('FRAME15.1', 'FRAME1.1',
                                  apv['FRAME1']['F'] - apv['FRAME1']['G'] - apv['FRAME2']['FF'] - assmebly_par[
                                      'Ass_T'],
                                  'YZ plane', 1, 116)
        mprog.add_offset_assembly('FRAME15.1', 'FRAME1.1',
                                  apv['FRAME3']['B'] / 2 - assmebly_par['Ass_U'] + apv['FRAME1']['CC'] / 2 -
                                  apv['FRAME15'][
                                      'B'], 'ZX plane', 1, 117)
        mprog.add_offset_assembly('FRAME15.2', 'FRAME2.1', -(
                apv['FRAME2']['A'] - apv['FRAME30']['A'] - assmebly_par['Ass_S'] - apv['FRAME17']['g3']) - zeta,
                                  'XY plane', 0,
                                  118)
        mprog.add_offset_assembly('FRAME15.2', 'FRAME2.1',
                                  apv['FRAME2']['F'] - apv['FRAME2']['G'] - apv['FRAME2']['FF'] - assmebly_par[
                                      'Ass_T'],
                                  'YZ plane', 1, 119)
        mprog.add_offset_assembly('FRAME15.2', 'FRAME2.1',
                                  -(apv['FRAME3']['B'] / 2 - assmebly_par['Ass_U'] + apv['FRAME1']['CC'] / 2),
                                  'ZX plane',
                                  1, 120)
        mprog.add_offset_assembly('FRAME15.3', 'FRAME1.1', apv['FRAME2']['A'] - apv['FRAME30']['A'] - (
                    apv['FRAME17']['g3'] - apv['FRAME17']['g2']) - apv['FRAME13']['k'] - apv['FRAME13']['j'] -
                                  assmebly_par['Ass_V'] - assmebly_par['Ass_S'] + apv['FRAME15']['A'] + zeta, 'XY plane', 1, 127)
        mprog.add_offset_assembly('FRAME15.3', 'FRAME1.1', -(
                    apv['FRAME2']['F'] - apv['FRAME2']['G'] - apv['FRAME2']['FF'] - assmebly_par['Ass_T'] -
                    apv['FRAME15']['C']), 'YZ plane', 0, 128)
        mprog.add_offset_assembly('FRAME15.3', 'FRAME1.1', (
                    apv['FRAME3']['B'] / 2 - assmebly_par['Ass_U'] + apv['FRAME1']['CC'] / 2 - apv['FRAME15']['B']),
                                  'ZX plane', 1, 129)
        mprog.add_offset_assembly('FRAME15.4', 'FRAME2.1', apv['FRAME2']['A'] - apv['FRAME30']['A'] - (
                    apv['FRAME17']['g3'] - apv['FRAME17']['g2']) - apv['FRAME13']['k'] - apv['FRAME13']['j'] -
                                  assmebly_par['Ass_V'] - assmebly_par['Ass_S'] + apv['FRAME15']['A'] + zeta, 'XY plane', 1, 130)
        mprog.add_offset_assembly('FRAME15.4', 'FRAME2.1', -(
                    apv['FRAME2']['F'] - apv['FRAME2']['G'] - apv['FRAME2']['FF'] - assmebly_par['Ass_T'] -
                    apv['FRAME15']['C']), 'YZ plane', 0, 131)
        mprog.add_offset_assembly('FRAME15.4', 'FRAME2.1',
                                  -(apv['FRAME3']['B'] / 2 - assmebly_par['Ass_U'] + apv['FRAME1']['CC'] / 2),
                                  'ZX plane', 1, 132)
        mprog.add_offset_assembly('FRAME25.1', 'FRAME4.1', -(
                    (assmebly_par['Ass_J'] - apv['FRAME25']['B']) + (apv['FRAME4']['A'] - apv['FRAME4']['a'])),
                                  'XY plane', 0, 85)
        mprog.add_offset_assembly('FRAME25.1', 'FRAME4.1', -(apv['FRAME4']['K']), 'YZ plane', 0, 86)
        mprog.add_offset_assembly('FRAME25.1', 'FRAME4.1', assmebly_par['Ass_P'] + apv['FRAME4']['B'] / 2, 'ZX plane',
                                  0, 87)
        mprog.add_offset_assembly('FRAME27.1', 'FRAME1.1', -(apv['FRAME1']['A'] - apv['FRAME27']['A']) - zeta,
                                  'XY plane', 0,
                                  52)
        mprog.add_offset_assembly('FRAME27.1', 'FRAME1.1', -(
                apv['FRAME1']['F'] - apv['FRAME27']['B'] - apv['FRAME30']['M'] - apv['FRAME27']['J']),
                                  'YZ plane',
                                  0, 53)
        mprog.add_offset_assembly('FRAME27.1', 'FRAME1.1', -(apv['FRAME1']['CC'] / 2), 'ZX plane', 0, 54)
        mprog.add_offset_assembly('FRAME27_1.1', 'FRAME2.1', -(apv['FRAME2']['A'] - apv['FRAME27_1']['A']) - zeta,
                                  'XY plane',
                                  0, 55)
        mprog.add_offset_assembly('FRAME27_1.1', 'FRAME2.1', -(
                apv['FRAME2']['F'] - apv['FRAME27_1']['B'] - apv['FRAME30']['M'] - apv['FRAME27_1']['J']),
                                  'YZ plane', 0, 56)
        mprog.add_offset_assembly('FRAME27_1.1', 'FRAME2.1', apv['FRAME27_1']['I'] + apv['FRAME2']['CC'] / 2,
                                  'ZX plane', 0, 57)
        mprog.add_offset_assembly('FRAME29.1', 'FRAME4.1', -(
                assmebly_par['Ass_Q'] + (apv['FRAME4']['A'] - apv['FRAME4']['a']) - apv['FRAME29']['A'] / 2),
                                  'XY plane', 0, 94)
        mprog.add_offset_assembly('FRAME29.1', 'FRAME4.1',
                                  apv['FRAME29']['B'] - (apv['FRAME29']['B'] - apv['FRAME29']['F']), 'YZ plane', 0, 95)
        mprog.add_offset_assembly('FRAME29.1', 'FRAME4.1',
                                  apv['FRAME4']['B'] / 2 - apv['FRAME6']['e'] + apv['FRAME29']['A'] / 2, 'ZX plane', 0,
                                  96)
        mprog.add_offset_assembly('FRAME29.2', 'FRAME4.1', -(
                assmebly_par['Ass_Q'] + (apv['FRAME4']['A'] - apv['FRAME4']['a']) - apv['FRAME29']['A'] / 2),
                                  'XY plane', 0, 97)
        mprog.add_offset_assembly('FRAME29.2', 'FRAME4.1',
                                  apv['FRAME29']['B'] - (apv['FRAME29']['B'] - apv['FRAME29']['F']), 'YZ plane', 0, 98)
        mprog.add_offset_assembly('FRAME29.2', 'FRAME4.1',
                                  apv['FRAME4']['B'] / 2 + apv['FRAME6']['e'] + apv['FRAME29']['A'] / 2, 'ZX plane', 0,
                                  99)
        mprog.add_offset_assembly('FRAME31.1', 'FRAME4.1',
                                  (apv['FRAME4']['A']-apv['FRAME4']['a']+apv['FRAME31']['F']/2), 'XY plane', 1, 49)
        mprog.add_offset_assembly('FRAME31.1', 'FRAME4.1', -(apv['FRAME4']['K']+apv['FRAME31']['C']-assmebly_par['Ass_H']), 'YZ plane', 0, 50)
        mprog.add_offset_assembly('FRAME31.1', 'FRAME4.1', -(apv['FRAME4']['B']/2+apv['FRAME31']['F']/2), 'ZX plane', 1, 51)
        mprog.add_offset_assembly('FRAME33.1', 'FRAME1.1', 0, 'XY plane', 0, 19)
        mprog.add_offset_assembly('FRAME33.1', 'FRAME1.1', -(apv['FRAME1']['B'] - apv['FRAME33']['B']),
                                  'YZ plane', 0, 20)
        mprog.add_offset_assembly('FRAME33.1', 'FRAME1.1', -(apv['FRAME33']['K'] + apv['FRAME1']['CC'] / 2), 'ZX plane',
                                  0, 21)
        mprog.add_offset_assembly('FRAME34.1', 'FRAME2.1', 0, 'XY plane', 0, 22)
        mprog.add_offset_assembly('FRAME34.1', 'FRAME2.1', -(apv['FRAME2']['B'] - apv['FRAME34']['B']),
                                  'YZ plane', 0, 23)
        mprog.add_offset_assembly('FRAME34.1', 'FRAME2.1', apv['FRAME2']['CC'] / 2, 'ZX plane', 0, 24)
        mprog.add_offset_assembly('FRAME36.1', 'FRAME4.1', -(
                    (assmebly_par['Ass_J'] - apv['FRAME36']['A'] / 2) + (apv['FRAME4']['A'] - apv['FRAME4']['a'])),
                                  'XY plane', 0, 67)
        mprog.add_offset_assembly('FRAME36.1', 'FRAME4.1',
                                  -(apv['FRAME4']['K']+7.5), 'YZ plane', 0,
                                  68)
        mprog.add_offset_assembly('FRAME36.1', 'FRAME4.1', apv['FRAME4']['B'] - apv['FRAME36']['D'], 'ZX plane', 0, 69)
        mprog.add_offset_assembly('FRAME37.1', 'FRAME2.1',
                                  -(apv['FRAME2']['A'] - apv['FRAME2']['ffff'] - apv['FRAME37']['A'] / 2), 'XY plane',
                                  0, 142)
        mprog.add_offset_assembly('FRAME37.1', 'FRAME2.1',
                                  -(apv['FRAME2']['F'] - apv['FRAME2']['eeee'] - apv['FRAME37']['A'] / 2),
                                  'YZ plane', 0, 143)
        mprog.add_offset_assembly('FRAME37.1', 'FRAME2.1', apv['FRAME2']['CC'] / 2, 'ZX plane', 0, 144)
        mprog.add_offset_assembly('FRAME23.1', 'FRAME1.1',
                                  -(apv["FRAME1"]["E"] - apv["FRAME1"]["DD"] - apv["FRAME23"]["I"]), 'XY plane', 0, 145)
        mprog.add_offset_assembly('FRAME23.1', 'FRAME1.1', -(apv['FRAME1']['B'] - apv['FRAME23']['B']),
                                  'YZ plane', 0, 146)
        mprog.add_offset_assembly('FRAME23.1', 'FRAME1.1', -(apv['FRAME1']['CC'] / 2 + apv['FRAME23']['A']), 'ZX plane',
                                  1, 147)
        mprog.add_offset_assembly('FRAME23.2', 'FRAME1.1',
                                  -(apv["FRAME1"]["E"] - apv["FRAME1"]["DD"] - apv["FRAME23"]["I"]), 'XY plane', 0, 148)
        mprog.add_offset_assembly('FRAME23.2', 'FRAME1.1',
                                  -(apv["FRAME1"]["B"] - apv["FRAME23"]["B"] - assmebly_par['Ass_Y']),
                                  'YZ plane', 0, 149)
        mprog.add_offset_assembly('FRAME23.2', 'FRAME1.1', -(apv['FRAME1']['CC'] / 2 + apv['FRAME23']['A']), 'ZX plane',
                                  1, 150)
        mprog.add_offset_assembly('FRAME23.3', 'FRAME2.1',
                                  -(apv["FRAME1"]["E"] - apv["FRAME1"]["DD"] - apv["FRAME23"]["I"]), 'XY plane', 0, 151)
        mprog.add_offset_assembly('FRAME23.3', 'FRAME2.1', (apv['FRAME1']['B']),
                                  'YZ plane', 1, 152)
        mprog.add_offset_assembly('FRAME23.3', 'FRAME2.1', -(apv['FRAME1']['CC'] / 2 + apv['FRAME23']['A']), 'ZX plane',
                                  0, 153)
        mprog.add_offset_assembly('FRAME23.4', 'FRAME2.1',
                                  -(apv["FRAME1"]["E"] - apv["FRAME1"]["DD"] - apv["FRAME23"]["I"]), 'XY plane', 0, 154)
        mprog.add_offset_assembly('FRAME23.4', 'FRAME2.1', (apv["FRAME1"]["B"] - assmebly_par['Ass_Y']),
                                  'YZ plane', 1, 155)
        mprog.add_offset_assembly('FRAME23.4', 'FRAME2.1', -(apv['FRAME2']['CC'] / 2 + apv['FRAME23']['A']), 'ZX plane',
                                  0, 156)
        mprog.add_offset_assembly('FRAME42.1', 'FRAME1.1', (apv['FRAME2']['A'] - apv['FRAME30']['A'] - (
                apv['FRAME17']['g3'] - apv['FRAME17']['g2']) - apv['FRAME13']['k'] - apv['FRAME13']['j'] -
                                  assmebly_par['Ass_V'] - assmebly_par['Ass_S'] + apv['FRAME15']['A'] / 2 -
                                  apv['FRAME42']['A'] / 2 + zeta), 'XY plane', 1, 167)
        mprog.add_offset_assembly('FRAME42.1', 'FRAME1.1', -(
                apv['FRAME2']['F'] - apv['FRAME2']['G'] - apv['FRAME2']['FF'] - assmebly_par['Ass_T'] -
                apv['FRAME15']['C'] - apv['FRAME42']['C']), 'YZ plane', 0, 168)
        mprog.add_offset_assembly('FRAME42.1', 'FRAME1.1', -(
                apv['FRAME1']['CC'] / 2 + apv['FRAME19']['AH']),
                                  'ZX plane', 0, 169)
        mprog.add_offset_assembly('FRAME42.2', 'FRAME2.1', apv['FRAME2']['A'] - apv['FRAME30']['A'] - (
                apv['FRAME17']['g3'] - apv['FRAME17']['g2']) - apv['FRAME13']['k'] - apv['FRAME13']['j'] -
                                  assmebly_par['Ass_V'] - assmebly_par['Ass_S'] + apv['FRAME15']['A'] / 2 -
                                  apv['FRAME42']['A'] / 2 + zeta, 'XY plane', 1, 170)
        mprog.add_offset_assembly('FRAME42.2', 'FRAME2.1', -(
                apv['FRAME2']['F'] - apv['FRAME2']['G'] - apv['FRAME2']['FF'] - assmebly_par['Ass_T'] -
                apv['FRAME15']['C'] - apv['FRAME42']['C']), 'YZ plane', 0, 171)
        mprog.add_offset_assembly('FRAME42.2', 'FRAME2.1', (
                apv['FRAME1']['CC'] / 2 + apv['FRAME19']['AH'] + apv['FRAME42']['B']),
                                  'ZX plane', 0, 172)
    #60頓待修
    elif stamping_press_type == 3:
        mprog.add_offset_assembly('FRAME6.1', 'FRAME4.1',
                                  assmebly_par['Ass_Q'] - (apv['FRAME4']['A'] - apv['FRAME4']['a']) + apv['FRAME6'][
                                      'E'] / 2, 'XY plane', 0, 88)
        mprog.add_offset_assembly('FRAME6.1', 'FRAME4.1', 28, 'YZ plane', 1, 89)
        mprog.add_offset_assembly('FRAME6.1', 'FRAME4.1', -(apv['FRAME4']['B'] / 2 - apv['FRAME6']['B']), 'ZX plane', 1,
                                  90)
        mprog.add_offset_assembly('FRAME6.2', 'FRAME4.1',
                                  assmebly_par['Ass_Q'] - (apv['FRAME4']['A'] - apv['FRAME4']['a']) - apv['FRAME6'][
                                      'E'] / 2, 'XY plane', 1, 91)
        mprog.add_offset_assembly('FRAME6.2', 'FRAME4.1', 28, 'YZ plane', 1, 92)
        mprog.add_offset_assembly('FRAME6.2', 'FRAME4.1', apv['FRAME4']['B'] - apv['FRAME6']['B'], 'ZX plane', 0,
                                  93)
        mprog.add_offset_assembly('FRAME11.1', 'FRAME3.1',
                                  -(apv['FRAME3']['A'] - apv['FRAME3']['E'] - apv['FRAME11']['A'] / 2), 'XY plane', 0,
                                  64)
        mprog.add_offset_assembly('FRAME11.1', 'FRAME3.1', apv['FRAME3']['O'] + assmebly_par['Ass_I'], 'YZ plane', 0,
                                  65)
        mprog.add_offset_assembly('FRAME11.1', 'FRAME3.1', apv['FRAME3']['B'] / 2 + apv['FRAME11']['A'] / 2, 'ZX plane',
                                  0, 66)
        mprog.add_offset_assembly('FRAME15.1', 'FRAME1.1', -(
                apv['FRAME1']['A'] - apv['FRAME30']['A'] - assmebly_par['Ass_S'] - apv['FRAME17']['g3']) - zeta,
                                  'XY plane', 0,
                                  115)
        mprog.add_offset_assembly('FRAME15.1', 'FRAME1.1',
                                  apv['FRAME1']['F'] - apv['FRAME1']['G'] - apv['FRAME2']['FF'] - assmebly_par[
                                      'Ass_T'],
                                  'YZ plane', 1, 116)
        mprog.add_offset_assembly('FRAME15.1', 'FRAME1.1',
                                  apv['FRAME3']['B'] / 2 - assmebly_par['Ass_U'] + apv['FRAME1']['CC'] / 2 -
                                  apv['FRAME15'][
                                      'B'], 'ZX plane', 1, 117)
        mprog.add_offset_assembly('FRAME15.2', 'FRAME2.1', -(
                apv['FRAME2']['A'] - apv['FRAME30']['A'] - assmebly_par['Ass_S'] - apv['FRAME17']['g3']) - zeta,
                                  'XY plane', 0,
                                  118)
        mprog.add_offset_assembly('FRAME15.2', 'FRAME2.1',
                                  apv['FRAME2']['F'] - apv['FRAME2']['G'] - apv['FRAME2']['FF'] - assmebly_par[
                                      'Ass_T'],
                                  'YZ plane', 1, 119)
        mprog.add_offset_assembly('FRAME15.2', 'FRAME2.1',
                                  -(apv['FRAME3']['B'] / 2 - assmebly_par['Ass_U'] + apv['FRAME1']['CC'] / 2),
                                  'ZX plane',
                                  1, 120)
        mprog.add_offset_assembly('FRAME15.3', 'FRAME1.1', apv['FRAME2']['A'] - apv['FRAME30']['A'] - (
                    apv['FRAME17']['g3'] - apv['FRAME17']['g2']) - apv['FRAME13']['k'] - apv['FRAME13']['j'] -
                                  assmebly_par['Ass_V'] - assmebly_par['Ass_S'] + apv['FRAME15']['A'] + zeta, 'XY plane', 1, 127)
        mprog.add_offset_assembly('FRAME15.3', 'FRAME1.1', -(
                    apv['FRAME2']['F'] - apv['FRAME2']['G'] - apv['FRAME2']['FF'] - assmebly_par['Ass_T'] -
                    apv['FRAME15']['C']), 'YZ plane', 0, 128)
        mprog.add_offset_assembly('FRAME15.3', 'FRAME1.1', (
                    apv['FRAME3']['B'] / 2 - assmebly_par['Ass_U'] + apv['FRAME1']['CC'] / 2 - apv['FRAME15']['B']),
                                  'ZX plane', 1, 129)
        mprog.add_offset_assembly('FRAME15.4', 'FRAME2.1', apv['FRAME2']['A'] - apv['FRAME30']['A'] - (
                    apv['FRAME17']['g3'] - apv['FRAME17']['g2']) - apv['FRAME13']['k'] - apv['FRAME13']['j'] -
                                  assmebly_par['Ass_V'] - assmebly_par['Ass_S'] + apv['FRAME15']['A'] + zeta, 'XY plane', 1, 130)
        mprog.add_offset_assembly('FRAME15.4', 'FRAME2.1', -(
                    apv['FRAME2']['F'] - apv['FRAME2']['G'] - apv['FRAME2']['FF'] - assmebly_par['Ass_T'] -
                    apv['FRAME15']['C']), 'YZ plane', 0, 131)
        mprog.add_offset_assembly('FRAME15.4', 'FRAME2.1',
                                  -(apv['FRAME3']['B'] / 2 - assmebly_par['Ass_U'] + apv['FRAME1']['CC'] / 2),
                                  'ZX plane', 1, 132)
        mprog.add_offset_assembly('FRAME25.1', 'FRAME4.1', -(
                    (assmebly_par['Ass_J'] - apv['FRAME25']['B']) + (apv['FRAME4']['A'] - apv['FRAME4']['a'])),
                                  'XY plane', 0, 85)
        mprog.add_offset_assembly('FRAME25.1', 'FRAME4.1', -(apv['FRAME4']['K']), 'YZ plane', 0, 86)
        mprog.add_offset_assembly('FRAME25.1', 'FRAME4.1', assmebly_par['Ass_P'] + apv['FRAME4']['B'] / 2, 'ZX plane',
                                  0, 87)
        mprog.add_offset_assembly('FRAME27.1', 'FRAME1.1', -(apv['FRAME1']['A'] - apv['FRAME27']['A']) - zeta,
                                  'XY plane', 0,
                                  52)
        mprog.add_offset_assembly('FRAME27.1', 'FRAME1.1', -(
                apv['FRAME1']['F'] - apv['FRAME27']['B'] - apv['FRAME30']['M'] - apv['FRAME27']['J']),
                                  'YZ plane',
                                  0, 53)
        mprog.add_offset_assembly('FRAME27.1', 'FRAME1.1', -(apv['FRAME1']['CC'] / 2), 'ZX plane', 0, 54)
        mprog.add_offset_assembly('FRAME27_1.1', 'FRAME2.1', -(apv['FRAME2']['A'] - apv['FRAME27_1']['A']) - zeta,
                                  'XY plane',
                                  0, 55)
        mprog.add_offset_assembly('FRAME27_1.1', 'FRAME2.1', -(
                apv['FRAME2']['F'] - apv['FRAME27_1']['B'] - apv['FRAME30']['M'] - apv['FRAME27_1']['J']),
                                  'YZ plane', 0, 56)
        mprog.add_offset_assembly('FRAME27_1.1', 'FRAME2.1', apv['FRAME27_1']['I'] + apv['FRAME2']['CC'] / 2,
                                  'ZX plane', 0, 57)
        mprog.add_offset_assembly('FRAME29.1', 'FRAME4.1', -(
                assmebly_par['Ass_Q'] + (apv['FRAME4']['A'] - apv['FRAME4']['a']) - apv['FRAME29']['A'] / 2),
                                  'XY plane', 0, 94)
        mprog.add_offset_assembly('FRAME29.1', 'FRAME4.1',
                                  apv['FRAME29']['B'] - (apv['FRAME29']['B'] - apv['FRAME29']['F']), 'YZ plane', 0, 95)
        mprog.add_offset_assembly('FRAME29.1', 'FRAME4.1',
                                  apv['FRAME4']['B'] / 2 - apv['FRAME6']['e'] + apv['FRAME29']['A'] / 2, 'ZX plane', 0,
                                  96)
        mprog.add_offset_assembly('FRAME29.2', 'FRAME4.1', -(
                assmebly_par['Ass_Q'] + (apv['FRAME4']['A'] - apv['FRAME4']['a']) - apv['FRAME29']['A'] / 2),
                                  'XY plane', 0, 97)
        mprog.add_offset_assembly('FRAME29.2', 'FRAME4.1',
                                  apv['FRAME29']['B'] - (apv['FRAME29']['B'] - apv['FRAME29']['F']), 'YZ plane', 0, 98)
        mprog.add_offset_assembly('FRAME29.2', 'FRAME4.1',
                                  apv['FRAME4']['B'] / 2 + apv['FRAME6']['e'] + apv['FRAME29']['A'] / 2, 'ZX plane', 0,
                                  99)
        mprog.add_offset_assembly('FRAME33.1', 'FRAME1.1', 0, 'XY plane', 0, 19)
        mprog.add_offset_assembly('FRAME33.1', 'FRAME1.1', -(apv['FRAME1']['B'] - apv['FRAME33']['B'] - apv['FRAME33']['M'] - apv['FRAME33']['O']),
                                  'YZ plane', 0, 20)
        mprog.add_offset_assembly('FRAME33.1', 'FRAME1.1', -(apv['FRAME33']['K'] + apv['FRAME1']['CC'] / 2), 'ZX plane',
                                  0, 21)
        mprog.add_offset_assembly('FRAME34.1', 'FRAME2.1', 0, 'XY plane', 0, 22)
        mprog.add_offset_assembly('FRAME34.1', 'FRAME2.1', -(apv['FRAME2']['B'] - apv['FRAME34']['B'] - apv['FRAME34']['Q'] - apv['FRAME34']['S']),
                                  'YZ plane', 0, 23)
        mprog.add_offset_assembly('FRAME34.1', 'FRAME2.1', apv['FRAME2']['CC'] / 2, 'ZX plane', 0, 24)
        mprog.add_offset_assembly('FRAME36.1', 'FRAME4.1', -(
                (assmebly_par['Ass_J'] - apv['FRAME36']['A'] / 2) + (apv['FRAME4']['A'] - apv['FRAME4']['a'])),
                                  'XY plane', 0, 67)
        mprog.add_offset_assembly('FRAME36.1', 'FRAME4.1',
                                  -(apv['FRAME4']['K'] + 7.5), 'YZ plane', 0,
                                  68)
        mprog.add_offset_assembly('FRAME36.1', 'FRAME4.1', apv['FRAME4']['B'] - apv['FRAME36']['D'], 'ZX plane', 0, 69)
        mprog.add_offset_assembly('FRAME37.1', 'FRAME2.1',
                                  -(apv['FRAME2']['A'] - apv['FRAME2']['ffff'] - apv['FRAME37']['A'] / 2), 'XY plane',
                                  0, 142)
        mprog.add_offset_assembly('FRAME37.1', 'FRAME2.1',
                                  -(apv['FRAME2']['F'] - apv['FRAME2']['eeee'] - apv['FRAME37']['A'] / 2),
                                  'YZ plane', 0, 143)
        mprog.add_offset_assembly('FRAME37.1', 'FRAME2.1', apv['FRAME2']['CC'] / 2, 'ZX plane', 0, 144)
        mprog.add_offset_assembly('FRAME23.1', 'FRAME1.1',
                                  -(apv["FRAME1"]["E"] - apv["FRAME1"]["DD"] - apv["FRAME23"]["I"]), 'XY plane', 0, 145)
        mprog.add_offset_assembly('FRAME23.1', 'FRAME1.1', -(apv['FRAME1']['B'] - apv['FRAME23']['B']),
                                  'YZ plane', 0, 146)
        mprog.add_offset_assembly('FRAME23.1', 'FRAME1.1', -(apv['FRAME1']['CC'] / 2 + apv['FRAME23']['A']), 'ZX plane',
                                  1, 147)
        mprog.add_offset_assembly('FRAME23.2', 'FRAME1.1',
                                  -(apv["FRAME1"]["E"] - apv["FRAME1"]["DD"] - apv["FRAME23"]["I"]), 'XY plane', 0, 148)
        mprog.add_offset_assembly('FRAME23.2', 'FRAME1.1',
                                  -(apv["FRAME1"]["B"] - apv["FRAME23"]["B"] - assmebly_par['Ass_Y']),
                                  'YZ plane', 0, 149)
        mprog.add_offset_assembly('FRAME23.2', 'FRAME1.1', -(apv['FRAME1']['CC'] / 2 + apv['FRAME23']['A']), 'ZX plane',
                                  1, 150)
        mprog.add_offset_assembly('FRAME23.3', 'FRAME2.1',
                                  -(apv["FRAME1"]["E"] - apv["FRAME1"]["DD"] - apv["FRAME23"]["I"]), 'XY plane', 0, 151)
        mprog.add_offset_assembly('FRAME23.3', 'FRAME2.1', (apv['FRAME1']['B']),
                                  'YZ plane', 1, 152)
        mprog.add_offset_assembly('FRAME23.3', 'FRAME2.1', -(apv['FRAME1']['CC'] / 2 + apv['FRAME23']['A']), 'ZX plane',
                                  0, 153)
        mprog.add_offset_assembly('FRAME23.4', 'FRAME2.1',
                                  -(apv["FRAME1"]["E"] - apv["FRAME1"]["DD"] - apv["FRAME23"]["I"]), 'XY plane', 0, 154)
        mprog.add_offset_assembly('FRAME23.4', 'FRAME2.1', (apv["FRAME1"]["B"] - assmebly_par['Ass_Y']),
                                  'YZ plane', 1, 155)
        mprog.add_offset_assembly('FRAME23.4', 'FRAME2.1', -(apv['FRAME2']['CC'] / 2 + apv['FRAME23']['A']), 'ZX plane',
                                  0, 156)
        mprog.add_offset_assembly('FRAME42.1', 'FRAME1.1', (apv['FRAME2']['A'] - apv['FRAME30']['A'] - (
                apv['FRAME17']['g3'] - apv['FRAME17']['g2']) - apv['FRAME13']['k'] - apv['FRAME13']['j'] -
                                                            assmebly_par['Ass_V'] - assmebly_par['Ass_S'] +
                                                            apv['FRAME15']['A'] / 2 -
                                                            apv['FRAME42']['A'] / 2 + zeta), 'XY plane', 1, 167)
        mprog.add_offset_assembly('FRAME42.1', 'FRAME1.1', -(
                apv['FRAME2']['F'] - apv['FRAME2']['G'] - apv['FRAME2']['FF'] - assmebly_par['Ass_T'] -
                apv['FRAME15']['C'] - apv['FRAME42']['C']), 'YZ plane', 0, 168)
        mprog.add_offset_assembly('FRAME42.1', 'FRAME1.1', -(
                apv['FRAME1']['CC'] / 2 + apv['FRAME19']['AH']),
                                  'ZX plane', 0, 169)
        mprog.add_offset_assembly('FRAME42.2', 'FRAME2.1', apv['FRAME2']['A'] - apv['FRAME30']['A'] - (
                apv['FRAME17']['g3'] - apv['FRAME17']['g2']) - apv['FRAME13']['k'] - apv['FRAME13']['j'] -
                                  assmebly_par['Ass_V'] - assmebly_par['Ass_S'] + apv['FRAME15']['A'] / 2 -
                                  apv['FRAME42']['A'] / 2 + zeta, 'XY plane', 1, 170)
        mprog.add_offset_assembly('FRAME42.2', 'FRAME2.1', -(
                apv['FRAME2']['F'] - apv['FRAME2']['G'] - apv['FRAME2']['FF'] - assmebly_par['Ass_T'] -
                apv['FRAME15']['C'] - apv['FRAME42']['C']), 'YZ plane', 0, 171)
        mprog.add_offset_assembly('FRAME42.2', 'FRAME2.1', (
                apv['FRAME1']['CC'] / 2 + apv['FRAME19']['AH'] + apv['FRAME42']['B']),
                                  'ZX plane', 0, 172)
    #110頓
    elif stamping_press_type == 5:
        mprog.add_offset_assembly('FRAME6.1', 'FRAME4.1',
                                  assmebly_par['Ass_Q'] - (apv['FRAME4']['A'] - apv['FRAME4']['a'] + apv['FRAME6']['E']/2) + apv['FRAME6']['E'], 'XY plane', 0, 88)
        mprog.add_offset_assembly('FRAME6.1', 'FRAME4.1', apv['FRAME19']['L'], 'YZ plane', 1, 89)
        mprog.add_offset_assembly('FRAME6.1', 'FRAME4.1', -(apv['FRAME6']['B']), 'ZX plane', 1,
                                  90)
        mprog.add_offset_assembly('FRAME6.2', 'FRAME4.1',
                                  -(assmebly_par['Ass_Q'] - (apv['FRAME4']['A'] - apv['FRAME4']['a']) - apv['FRAME6'][
                                      'E'] / 2), 'XY plane', 1, 91)
        mprog.add_offset_assembly('FRAME6.2', 'FRAME4.1', apv['FRAME19']['L'], 'YZ plane', 1, 92)
        mprog.add_offset_assembly('FRAME6.2', 'FRAME4.1', apv['FRAME4']['B'] - apv['FRAME6']['B'], 'ZX plane', 0,
                                  93)
        mprog.add_offset_assembly('FRAME11.1', 'FRAME3.1',
                                  -(apv['FRAME3']['A'] - apv['FRAME3']['E'] - apv['FRAME11']['A'] / 2), 'XY plane', 0,
                                  64)
        mprog.add_offset_assembly('FRAME11.1', 'FRAME3.1', apv['FRAME3']['O'] + assmebly_par['Ass_I'], 'YZ plane', 0,
                                  65)
        mprog.add_offset_assembly('FRAME11.1', 'FRAME3.1', apv['FRAME3']['B'] / 2 + apv['FRAME11']['A'] / 2, 'ZX plane',
                                  0, 66)
        mprog.add_offset_assembly('FRAME15.1', 'FRAME1.1', -(
                apv['FRAME1']['A'] - apv['FRAME30']['A'] - assmebly_par['Ass_S'] - apv['FRAME17']['g3']) - zeta,
                                  'XY plane', 0,
                                  115)
        mprog.add_offset_assembly('FRAME15.1', 'FRAME1.1',
                                  -(apv['FRAME1']['F'] - apv['FRAME1']['G'] - apv['FRAME2']['FF'] - assmebly_par[
                                      'Ass_T'] - apv['FRAME15']['F']),
                                  'YZ plane', 0, 116)
        mprog.add_offset_assembly('FRAME15.1', 'FRAME1.1',
                                  -(apv['FRAME3']['B'] / 2 - assmebly_par['Ass_U'] + apv['FRAME1']['CC'] / 2), 'ZX plane', 0, 117)
        mprog.add_offset_assembly('FRAME15.2', 'FRAME2.1', -(
                apv['FRAME2']['A'] - apv['FRAME30']['A'] - assmebly_par['Ass_S'] - apv['FRAME17']['g3']) - zeta,
                                  'XY plane', 0,
                                  118)
        mprog.add_offset_assembly('FRAME15.2', 'FRAME2.1',
                                  -(apv['FRAME2']['F'] - apv['FRAME2']['G'] - apv['FRAME2']['FF'] - assmebly_par[
                                      'Ass_T'] - apv['FRAME15']['F']),
                                  'YZ plane', 0, 119)
        mprog.add_offset_assembly('FRAME15.2', 'FRAME2.1',
                                  (apv['FRAME3']['B'] / 2 - assmebly_par['Ass_U'] + apv['FRAME1']['CC'] / 2 - apv['FRAME15']['B']),
                                  'ZX plane',
                                  0, 120)
        mprog.add_offset_assembly('FRAME15.3', 'FRAME1.1', apv['FRAME2']['A'] - apv['FRAME30']['A'] - (
                    apv['FRAME17']['g3'] - apv['FRAME17']['g2']) - apv['FRAME13']['k'] - apv['FRAME13']['j'] -
                                  assmebly_par['Ass_V'] - assmebly_par['Ass_S'] + apv['FRAME15']['A'] + zeta, 'XY plane', 1, 127)
        mprog.add_offset_assembly('FRAME15.3', 'FRAME1.1', -(
                    apv['FRAME2']['F'] - apv['FRAME2']['G'] - apv['FRAME2']['FF'] - assmebly_par['Ass_T'] -
                    apv['FRAME15']['F']), 'YZ plane', 0, 128)
        mprog.add_offset_assembly('FRAME15.3', 'FRAME1.1', (
                    apv['FRAME3']['B'] / 2 - assmebly_par['Ass_U'] + apv['FRAME1']['CC'] / 2 - apv['FRAME15']['B']),
                                  'ZX plane', 1, 129)
        mprog.add_offset_assembly('FRAME15.4', 'FRAME2.1', apv['FRAME2']['A'] - apv['FRAME30']['A'] - (
                    apv['FRAME17']['g3'] - apv['FRAME17']['g2']) - apv['FRAME13']['k'] - apv['FRAME13']['j'] -
                                  assmebly_par['Ass_V'] - assmebly_par['Ass_S'] + apv['FRAME15']['A'] + zeta, 'XY plane', 1, 130)
        mprog.add_offset_assembly('FRAME15.4', 'FRAME2.1', -(
                    apv['FRAME2']['F'] - apv['FRAME2']['G'] - apv['FRAME2']['FF'] - assmebly_par['Ass_T'] -
                    apv['FRAME15']['F']), 'YZ plane', 0, 131)
        mprog.add_offset_assembly('FRAME15.4', 'FRAME2.1',
                                  -(apv['FRAME3']['B'] / 2 - assmebly_par['Ass_U'] + apv['FRAME1']['CC'] / 2),
                                  'ZX plane', 1, 132)
        mprog.add_offset_assembly('FRAME29.1', 'FRAME4.1', -(
                assmebly_par['Ass_Q'] + (apv['FRAME4']['A'] - apv['FRAME4']['a']) - apv['FRAME29']['A'] / 2),
                                  'XY plane', 0, 94)
        mprog.add_offset_assembly('FRAME29.1', 'FRAME4.1',(apv['FRAME29']['B'] - apv['FRAME29']['F']), 'YZ plane', 1, 95)
        mprog.add_offset_assembly('FRAME29.1', 'FRAME4.1',
                                  -(apv['FRAME4']['B'] / 2 - apv['FRAME6']['e'] - apv['FRAME29']['A'] / 2), 'ZX plane', 1,
                                  96)
        mprog.add_offset_assembly('FRAME29.2', 'FRAME4.1', -(
                assmebly_par['Ass_Q'] + (apv['FRAME4']['A'] - apv['FRAME4']['a']) - apv['FRAME29']['A'] / 2),
                                  'XY plane', 0, 97)
        mprog.add_offset_assembly('FRAME29.2', 'FRAME4.1',(apv['FRAME29']['B'] - apv['FRAME29']['F']), 'YZ plane', 1, 98)
        mprog.add_offset_assembly('FRAME29.2', 'FRAME4.1',
                                  -(apv['FRAME4']['B'] / 2 + apv['FRAME6']['e'] - apv['FRAME29']['A'] / 2), 'ZX plane', 1,
                                  99)
        mprog.add_offset_assembly('FRAME23.1', 'FRAME1.1',
                                  -(apv["FRAME1"]["E"] - apv["FRAME1"]["DD"] - apv["FRAME23"]["I"]), 'XY plane', 0, 145)
        mprog.add_offset_assembly('FRAME23.1', 'FRAME1.1', -(apv['FRAME1']['B'] - apv['FRAME23']['B']),
                                  'YZ plane', 0, 146)
        mprog.add_offset_assembly('FRAME23.1', 'FRAME1.1', -(apv['FRAME1']['CC'] / 2 + apv['FRAME23']['A']), 'ZX plane',
                                  1, 147)
        mprog.add_offset_assembly('FRAME23.2', 'FRAME1.1',
                                  -(apv["FRAME1"]["E"] - apv["FRAME1"]["DD"] - apv["FRAME23"]["I"]), 'XY plane', 0, 148)
        mprog.add_offset_assembly('FRAME23.2', 'FRAME1.1',
                                  -(apv["FRAME1"]["B"] - apv["FRAME23"]["B"] - assmebly_par['Ass_Y']),
                                  'YZ plane', 0, 149)
        mprog.add_offset_assembly('FRAME23.2', 'FRAME1.1', -(apv['FRAME1']['CC'] / 2 + apv['FRAME23']['A']), 'ZX plane',
                                  1, 150)
        mprog.add_offset_assembly('FRAME23.3', 'FRAME2.1',
                                  -(apv["FRAME1"]["E"] - apv["FRAME1"]["DD"] - apv["FRAME23"]["I"]), 'XY plane', 0, 151)
        mprog.add_offset_assembly('FRAME23.3', 'FRAME2.1', (apv['FRAME1']['B']),
                                  'YZ plane', 1, 152)
        mprog.add_offset_assembly('FRAME23.3', 'FRAME2.1', -(apv['FRAME1']['CC'] / 2 + apv['FRAME23']['A']), 'ZX plane',
                                  0, 153)
        mprog.add_offset_assembly('FRAME23.4', 'FRAME2.1',
                                  -(apv["FRAME1"]["E"] - apv["FRAME1"]["DD"] - apv["FRAME23"]["I"]), 'XY plane', 0, 154)
        mprog.add_offset_assembly('FRAME23.4', 'FRAME2.1', (apv["FRAME1"]["B"] - assmebly_par['Ass_Y']),
                                  'YZ plane', 1, 155)
        mprog.add_offset_assembly('FRAME23.4', 'FRAME2.1', -(apv['FRAME2']['CC'] / 2 + apv['FRAME23']['A']), 'ZX plane',
                                  0, 156)
        mprog.add_offset_assembly('FRAME50.1', 'FRAME4.1',
                                  -(apv["FRAME4"]["k"] + assmebly_par['Ass_AC'] - apv["FRAME50"]["B"]/2), 'XY plane', 0, 173)
        mprog.add_offset_assembly('FRAME50.1', 'FRAME4.1', -(apv["FRAME50"]["c"]),
                                  'YZ plane', 1, 174)
        mprog.add_offset_assembly('FRAME50.1', 'FRAME4.1', -(apv['FRAME4']['B'] / 2 - assmebly_par['Ass_AB'] + apv['FRAME50']['B']/2), 'ZX plane',
                                  1, 175)
        mprog.add_offset_assembly('FRAME49.1', 'FRAME4.1',-(apv["FRAME4"]["k"] + assmebly_par['Ass_AE']), 'XY plane', 0, 176)
        mprog.add_offset_assembly('FRAME49.1', 'FRAME4.1', 0,
                                  'YZ plane', 1, 177)
        mprog.add_offset_assembly('FRAME49.1', 'FRAME4.1',
                                  -(apv['FRAME4']['B'] / 2 - assmebly_par['Ass_AD']),'ZX plane',1, 178)
        mprog.add_offset_assembly('FRAME48.1', 'FRAME8.1', (apv["FRAME48"]["B"]), 'XY plane', 0, 179)
        mprog.add_offset_assembly('FRAME48.1', 'FRAME8.1', apv["FRAME48"]["C"],'YZ plane', 1, 180)
        mprog.add_offset_assembly('FRAME48.1', 'FRAME8.1',0, 'ZX plane', 1, 181)
        mprog.add_offset_assembly('FRAME48.2', 'FRAME8.1', (apv["FRAME48"]["B"]), 'XY plane', 0, 182)
        mprog.add_offset_assembly('FRAME48.2', 'FRAME8.1', (assmebly_par['Ass_AF'] + apv["FRAME48"]["C"]), 'YZ plane', 1, 183)
        mprog.add_offset_assembly('FRAME48.2', 'FRAME8.1', 0, 'ZX plane', 1, 184)
        mprog.add_offset_assembly('FRAME23_1.1', 'FRAME22.1', -(apv["FRAME22"]["A(1)"] - apv["FRAME22"]["A(2)"] - apv["FRAME23"]["I"]), 'XY plane', 0, 185)
        mprog.add_offset_assembly('FRAME23_1.1', 'FRAME22.1', -(apv["FRAME22"]["O"] + apv["FRAME23"]["A"]), 'YZ plane',
                                  0, 186)
        mprog.add_offset_assembly('FRAME23_1.1', 'FRAME22.1', (apv["FRAME22"]["D"]/2 + apv["FRAME23"]["B"]/2), 'ZX plane', 0, 187)
        mprog.add_offset_assembly('FRAME47.1', 'FRAME22.1', -(apv["FRAME22"]["A(1)"] - apv["FRAME22"]["A(2)"] - apv["FRAME47"]["E"]), 'XY plane',
                                  0, 188)
        mprog.add_offset_assembly('FRAME47.1', 'FRAME7.1', -apv["FRAME47"]["B"], 'YZ plane',
                                  1, 189)
        mprog.add_offset_assembly('FRAME47.1', 'FRAME22.1', -(apv["FRAME22"]["D"] / 2 - apv["FRAME47"]["B"] / 2),
                                  'ZX plane', 1, 190)
        mprog.add_offset_assembly('FRAME45.1', 'FRAME13.1', 0, 'XY plane', 0, 191)
        mprog.add_offset_assembly('FRAME45.1', 'FRAME13.1', apv["FRAME45"]["A"] + apv["FRAME13"]["H"], 'YZ plane',
                                  1, 192)
        mprog.add_offset_assembly('FRAME45.1', 'FRAME13.1', -apv["FRAME45"]["C"]-(apv['FRAME13_1']['E']-apv['FRAME13_1']['I']),
                                  'ZX plane', 0, 193)
        mprog.add_offset_assembly('FRAME45.2', 'FRAME13_1.1', apv["FRAME45"]["H"], 'XY plane',
                                  1, 194)
        mprog.add_offset_assembly('FRAME45.2', 'FRAME13_1.1', apv["FRAME45"]["A"] + apv["FRAME13"]["H"], 'YZ plane',
                                  1, 195)
        mprog.add_offset_assembly('FRAME45.2', 'FRAME13_1.1', -(apv["FRAME45"]["C"] - apv["FRAME13"]["E"]),
                                  'ZX plane', 1, 196)
        mprog.add_offset_assembly('FRAME43.1', 'FRAME13.1', apv["FRAME13"]["j"] + apv["FRAME13"]["k"] + assmebly_par['Ass_AI'] + apv["FRAME43"]["C"]/2, 'XY plane',
                                  1, 197)
        mprog.add_offset_assembly('FRAME43.1', 'FRAME13.1', apv["FRAME43"]["B"], 'YZ plane',1, 198)
        mprog.add_offset_assembly('FRAME43.1', 'FRAME13.1', 0, 'ZX plane', 0, 199)
        mprog.add_offset_assembly('FRAME43.2', 'FRAME13_1.1',
                                  -(apv["FRAME13"]["j"] + apv["FRAME13"]["k"] + assmebly_par['Ass_AI'] - apv["FRAME43"][
                                      "C"]) , 'XY plane',
                                  0, 200)
        mprog.add_offset_assembly('FRAME43.2', 'FRAME13_1.1', apv["FRAME43"]["B"], 'YZ plane', 1, 201)
        mprog.add_offset_assembly('FRAME43.2', 'FRAME13_1.1', apv["FRAME13"]["I"] + (apv["FRAME13"]["E"] - apv["FRAME13"]["I"]), 'ZX plane', 1, 202)
        mprog.add_offset_assembly('FRAME52.1', 'FRAME22.1',
                                  -(apv["FRAME22"]["A(1)"] - apv["FRAME22"]["A(2)"] - apv["FRAME52"]["C"]), 'XY plane',
                                  0, 212)
        mprog.add_offset_assembly('FRAME52.1', 'FRAME22.1', 0, 'YZ plane', 0, 213)
        mprog.add_offset_assembly('FRAME52.1', 'FRAME22.1', apv["FRAME19"]["AH"]+apv["FRAME52"]["A"], 'ZX plane', 0, 214)
        mprog.add_offset_assembly('FRAME52.2', 'FRAME22.1',
                                  -(apv["FRAME22"]["A(1)"] - apv["FRAME22"]["A(2)"] - apv["FRAME52"]["C"]), 'XY plane',
                                  0, 215)
        mprog.add_offset_assembly('FRAME52.2', 'FRAME22.1', -(apv["FRAME52"]["B"]), 'YZ plane', 1, 216)
        mprog.add_offset_assembly('FRAME52.2', 'FRAME22.1', -(apv["FRAME22"]["D"] - apv["FRAME19"]["AH"]-apv["FRAME52"]["A"]), 'ZX plane', 1,
                                  217)
        #STP組立部分
        mprog.add_offset_assembly(S_i.PANEL_BOX_BRACKET_list_normal[stamping_press_type] + '.1', S_i.ELECTRIC_BOX_list_normal[stamping_press_type] + '.1',
                                  (S_assmebly_par['PBB_XY']), 'XY plane', 0, 269)
        mprog.add_offset_assembly(S_i.PANEL_BOX_BRACKET_list_normal[stamping_press_type] + '.1', S_i.ELECTRIC_BOX_list_normal[stamping_press_type] + '.1',
                                  -(S_assmebly_par['PBB_YZ']), 'YZ plane', 0, 270)
        mprog.add_offset_assembly(S_i.PANEL_BOX_BRACKET_list_normal[stamping_press_type] + '.1', S_i.ELECTRIC_BOX_list_normal[stamping_press_type] + '.1', (S_assmebly_par['PBB_ZX']),
                                  'ZX plane', 1, 271)
        mprog.add_offset_assembly(S_i.PANEL_BOX_list_normal[stamping_press_type] + '.1',S_i.PANEL_BOX_BRACKET_list_normal[stamping_press_type] + '.1',
                                  (S_assmebly_par['PB_XY']), 'XY plane', 0, 272)
        mprog.add_offset_assembly(S_i.PANEL_BOX_list_normal[stamping_press_type] + '.1',S_i.PANEL_BOX_BRACKET_list_normal[stamping_press_type] + '.1',
                                  (S_assmebly_par['PB_YZ']), 'YZ plane', 1, 273)
        mprog.add_offset_assembly(S_i.PANEL_BOX_list_normal[stamping_press_type] + '.1',S_i.PANEL_BOX_BRACKET_list_normal[stamping_press_type] + '.1', -(S_assmebly_par['PB_ZX']),
                                  'ZX plane', 1, 274)
        mprog.add_offset_assembly(S_i.CONTROL_PANEL_list_normal[stamping_press_type] + '.1',S_i.PANEL_BOX_list_normal[stamping_press_type] + '.1',
                                  (S_assmebly_par['CP_XY']), 'XY plane', 1, 275)
        mprog.add_offset_assembly(S_i.CONTROL_PANEL_list_normal[stamping_press_type] + '.1',S_i.PANEL_BOX_list_normal[stamping_press_type] + '.1',
                                  -(S_assmebly_par['CP_YZ']), 'YZ plane', 1, 276)
        mprog.add_offset_assembly(S_i.CONTROL_PANEL_list_normal[stamping_press_type] + '.1',S_i.PANEL_BOX_list_normal[stamping_press_type] + '.1', -(S_assmebly_par['CP_ZX']),
                                  'ZX plane', 1, 277)
        mprog.add_offset_assembly(S_i.CON_ROD_BASE_list[stamping_press_type]+'.1', 'crankshaft.1', (apv['crankshaft']['Bx2']+alpha/2), 'XY plane', 0, 230)
        mprog.add_offset_assembly(S_i.CON_ROD_BASE_list[stamping_press_type]+'.1', 'crankshaft.1', (apv['crankshaft']['Ah1']+apv['crankshaft']['Ah2']+apv['crankshaft']['Bh1']+apv['crankshaft']['Bh2']/2), 'YZ plane', 0, 231)
        mprog.add_offset_assembly(S_i.CON_ROD_BASE_list[stamping_press_type]+'.1', 'crankshaft.1', 0, 'ZX plane', 1, 232)
        mprog.add_offset_assembly(S_i.CON_ROD_list[stamping_press_type]+'.1', S_i.CON_ROD_CAP_list[stamping_press_type]+'.1', (S_assmebly_par['C_R_XY']-alpha/2), 'XY plane', 0, 233)
        mprog.add_offset_assembly(S_i.CON_ROD_list[stamping_press_type]+'.1', S_i.CON_ROD_CAP_list[stamping_press_type]+'.1', 0, 'YZ plane', 0, 234)
        mprog.add_offset_assembly(S_i.CON_ROD_list[stamping_press_type]+'.1', S_i.CON_ROD_CAP_list[stamping_press_type]+'.1', 0, 'ZX plane', 0, 235)
        mprog.add_offset_assembly(S_i.COVER_list[stamping_press_type]+'.1', 'FRAME1.1', -(apv['FRAME1']['A'])-zeta, 'XY plane', 0, 242)
        mprog.add_offset_assembly(S_i.COVER_list[stamping_press_type]+'.1', 'FRAME1.1', -(apv['FRAME1']['F']-(apv['FRAME1']['fffff1']+apv['FRAME1']['fffff2'])+S_assmebly_par['C_YZ']), 'YZ plane', 0, 243)
        mprog.add_offset_assembly(S_i.COVER_list[stamping_press_type]+'.1', 'FRAME1.1', -15, 'ZX plane', 1, 244)
        mprog.add_offset_assembly(S_i.PLUG_list+'.1', S_i.COVER_list[stamping_press_type]+'.1', -(S_assmebly_par['P_XY']), 'XY plane', 0, 245)
        mprog.add_offset_assembly(S_i.PLUG_list+'.1', S_i.COVER_list[stamping_press_type]+'.1', (S_assmebly_par['P_YZ']), 'YZ plane', 0, 246)
        mprog.add_offset_assembly(S_i.PLUG_list+'.1', S_i.COVER_list[stamping_press_type]+'.1', -(S_assmebly_par['P_ZX']), 'ZX plane', 1, 247)
        mprog.add_offset_assembly(S_i.OIL_LEVEL_GAUGE_list_CON_ROD[stamping_press_type]+'.1', S_i.CON_ROD_list[stamping_press_type]+'.1', -(S_assmebly_par['PLG_C_XY']), 'XY plane', 1, 257)
        mprog.add_offset_assembly(S_i.OIL_LEVEL_GAUGE_list_CON_ROD[stamping_press_type]+'.1', S_i.CON_ROD_list[stamping_press_type]+'.1', -(S_assmebly_par['PLG_C_YZ']), 'YZ plane', 0, 258)
        mprog.add_offset_assembly(S_i.OIL_LEVEL_GAUGE_list_CON_ROD[stamping_press_type]+'.1', S_i.CON_ROD_list[stamping_press_type]+'.1', (S_assmebly_par['PLG_C_ZX']), 'ZX plane', 0, 259)
        mprog.add_offset_assembly('BALL_SCREW.1', 'slide.1', -(S_assmebly_par['BS_XY']-apv['BALL_SCREW']['Z']/2), 'XY plane', 0, 293)
        mprog.add_offset_assembly('BALL_SCREW.1', S_i.CON_ROD_list[stamping_press_type]+'.1', 0, 'YZ plane', 0, 294)
        mprog.add_offset_assembly('BALL_SCREW.1', S_i.CON_ROD_list[stamping_press_type]+'.1', -apv['BALL_SCREW']['Z']/2, 'ZX plane', 0, 295)
        if travel_type == 1:
            mprog.add_offset_assembly(S_i.MOTOR_BRACKET_S_list[stamping_press_type]+'.1', 'FRAME20.1', -S_assmebly_par['MB_XY'], 'XY plane', 0, 323)
            mprog.add_offset_assembly(S_i.MOTOR_BRACKET_S_list[stamping_press_type]+'.1', 'FRAME20.1', S_assmebly_par['MB_YZ'], 'YZ plane', 0, 324)
            mprog.add_offset_assembly(S_i.MOTOR_BRACKET_S_list[stamping_press_type]+'.1', 'FRAME20.1', -S_assmebly_par['MB_ZX'], 'ZX plane', 0, 325)
            mprog.add_offset_assembly(S_i.MOTOR_list[stamping_press_type]+'.1', S_i.MOTOR_BRACKET_S_list[stamping_press_type]+'.1', S_assmebly_par['M_XY'], 'XY plane', 1, 326)
            mprog.add_offset_assembly(S_i.MOTOR_list[stamping_press_type]+'.1', S_i.MOTOR_BRACKET_S_list[stamping_press_type]+'.1', -S_assmebly_par['M_YZ'], 'YZ plane', 0, 327)
            mprog.add_offset_assembly(S_i.MOTOR_list[stamping_press_type]+'.1', S_i.MOTOR_BRACKET_S_list[stamping_press_type]+'.1', S_assmebly_par['M_ZX'], 'ZX plane', 0, 328)
        else:
            mprog.add_offset_assembly(S_i.MOTOR_BRACKET_HP_list[stamping_press_type]+'.1', 'FRAME20.1', S_assmebly_par['MB_XY'], 'XY plane', 1, 323)
            mprog.add_offset_assembly(S_i.MOTOR_BRACKET_HP_list[stamping_press_type]+'.1', 'FRAME20.1', S_assmebly_par['MB_YZ'], 'YZ plane', 0, 324)
            mprog.add_offset_assembly(S_i.MOTOR_BRACKET_HP_list[stamping_press_type]+'.1', 'FRAME20.1', -S_assmebly_par['MB_ZX'], 'ZX plane', 0, 325)
            mprog.add_offset_assembly(S_i.MOTOR_list[stamping_press_type]+'.1', S_i.MOTOR_BRACKET_HP_list[stamping_press_type]+'.1', S_assmebly_par['M_XY'], 'XY plane', 0, 326)
            mprog.add_offset_assembly(S_i.MOTOR_list[stamping_press_type]+'.1', S_i.MOTOR_BRACKET_HP_list[stamping_press_type]+'.1', -S_assmebly_par['M_YZ'], 'YZ plane', 0, 327)
            mprog.add_offset_assembly(S_i.MOTOR_list[stamping_press_type]+'.1', S_i.MOTOR_BRACKET_HP_list[stamping_press_type]+'.1', S_assmebly_par['M_ZX'], 'ZX plane', 0, 328)
        # 變頻器選配
        if INVERTER == '東元':
            if power == '220Vx60Hz' or power == '220x50Hz':
                if travel_type == 1:
                    mprog.add_offset_assembly(S_i.INVERTER_D_S_list[stamping_press_type] + '.1', 'FRAME2.1', -(
                                apv['FRAME2']['w4'] + apv['FRAME2']['w3'] + apv['FRAME2']['w2'] + apv['FRAME2'][
                            'bb1'] / 2), 'XY plane', 0, 353)
                    mprog.add_offset_assembly(S_i.INVERTER_D_S_list[stamping_press_type] + '.1', 'FRAME2.1',
                                              -(apv['FRAME2']['k']), 'YZ plane', 0, 354)
                    mprog.add_offset_assembly(S_i.INVERTER_D_S_list[stamping_press_type] + '.1', 'FRAME2.1',
                                              -(apv['FRAME2']['CC'] / 2), 'ZX plane', 0, 355)
                else:
                    mprog.add_offset_assembly(S_i.INVERTER_D_HP_list[stamping_press_type] + '.1', 'FRAME2.1', -(
                                apv['FRAME2']['w4'] + apv['FRAME2']['w3'] + apv['FRAME2']['w2'] + apv['FRAME2'][
                            'w1'] / 2), 'XY plane', 0, 353)
                    mprog.add_offset_assembly(S_i.INVERTER_D_HP_list[stamping_press_type] + '.1', 'FRAME2.1',
                                              -(apv['FRAME2']['k']), 'YZ plane', 0, 354)
                    mprog.add_offset_assembly(S_i.INVERTER_D_HP_list[stamping_press_type] + '.1', 'FRAME2.1',
                                              -(apv['FRAME2']['CC'] / 2), 'ZX plane', 0, 355)
            else:
                if travel_type == 1:
                    mprog.add_offset_assembly(S_i.INVERTER_440_D_S_list[stamping_press_type] + '.1', 'FRAME2.1', -(
                                apv['FRAME2']['w4'] + apv['FRAME2']['w3'] + apv['FRAME2']['w2'] + apv['FRAME2'][
                            'bb1'] / 2), 'XY plane', 0, 353)
                    mprog.add_offset_assembly(S_i.INVERTER_440_D_S_list[stamping_press_type] + '.1', 'FRAME2.1',
                                              -(apv['FRAME2']['k']), 'YZ plane', 0, 354)
                    mprog.add_offset_assembly(S_i.INVERTER_440_D_S_list[stamping_press_type] + '.1', 'FRAME2.1',
                                              -(apv['FRAME2']['CC'] / 2), 'ZX plane', 0, 355)
                else:
                    mprog.add_offset_assembly(S_i.INVERTER_440_D_HP_list[stamping_press_type] + '.1', 'FRAME2.1',-(
                                apv['FRAME2']['w4'] + apv['FRAME2']['w3'] + apv['FRAME2']['w2'] + apv['FRAME2'][
                            'bb1'] / 2), 'XY plane', 0, 353)
                    mprog.add_offset_assembly(S_i.INVERTER_440_D_HP_list[stamping_press_type] + '.1', 'FRAME2.1',
                                              -(apv['FRAME2']['k']), 'YZ plane', 0, 354)
                    mprog.add_offset_assembly(S_i.INVERTER_440_D_HP_list[stamping_press_type] + '.1', 'FRAME2.1',
                                              -(apv['FRAME2']['CC'] / 2), 'ZX plane', 0, 355)
        elif INVERTER == '台達':
            if power == '220Vx60Hz' or power == '220x50Hz':
                if travel_type == 1:
                    mprog.add_offset_assembly(S_i.INVERTER_T_S_list[stamping_press_type] + '.1', 'FRAME2.1', -(
                                apv['FRAME2']['w4'] + apv['FRAME2']['w3'] + apv['FRAME2']['w2'] + apv['FRAME2'][
                            'y1'] / 2 - apv['FRAME2']['bb2']), 'XY plane', 0, 353)
                    mprog.add_offset_assembly(S_i.INVERTER_T_S_list[stamping_press_type] + '.1', 'FRAME2.1',
                                              -(apv['FRAME2']['k']), 'YZ plane', 0, 354)
                    mprog.add_offset_assembly(S_i.INVERTER_T_S_list[stamping_press_type] + '.1', 'FRAME2.1',
                                              -(apv['FRAME2']['CC'] / 2), 'ZX plane', 0, 355)
                else:
                    mprog.add_offset_assembly(S_i.INVERTER_T_HP_list[stamping_press_type] + '.1', 'FRAME2.1', -(
                                apv['FRAME2']['w4'] + apv['FRAME2']['w3'] + apv['FRAME2']['w2'] + apv['FRAME2'][
                            'y1'] / 2 - apv['FRAME2']['bb2']), 'XY plane', 0, 353)
                    mprog.add_offset_assembly(S_i.INVERTER_T_HP_list[stamping_press_type] + '.1', 'FRAME2.1',
                                              -(apv['FRAME2']['k']), 'YZ plane', 0, 354)
                    mprog.add_offset_assembly(S_i.INVERTER_T_HP_list[stamping_press_type] + '.1', 'FRAME2.1',
                                              -(apv['FRAME2']['CC'] / 2), 'ZX plane', 0, 355)
            else:
                if travel_type == 1:
                    mprog.add_offset_assembly(S_i.INVERTER_440_T_S_list[stamping_press_type] + '.1', 'FRAME2.1', -(
                                apv['FRAME2']['w4'] + apv['FRAME2']['w3'] + apv['FRAME2']['w2'] + apv['FRAME2'][
                            'y1'] / 2 - apv['FRAME2']['bb2']), 'XY plane', 0, 353)
                    mprog.add_offset_assembly(S_i.INVERTER_440_T_S_list[stamping_press_type] + '.1', 'FRAME2.1',
                                              -(apv['FRAME2']['k']), 'YZ plane', 0, 354)
                    mprog.add_offset_assembly(S_i.INVERTER_440_T_S_list[stamping_press_type] + '.1', 'FRAME2.1',
                                              -(apv['FRAME2']['CC'] / 2), 'ZX plane', 0, 355)
                else:
                    mprog.add_offset_assembly(S_i.INVERTER_440_T_HP_list[stamping_press_type] + '.1', 'FRAME2.1', -(
                                apv['FRAME2']['w4'] + apv['FRAME2']['w3'] + apv['FRAME2']['w2'] + apv['FRAME2'][
                            'y1'] / 2 - apv['FRAME2']['bb2']), 'XY plane', 0, 353)
                    mprog.add_offset_assembly(S_i.INVERTER_440_T_HP_list[stamping_press_type] + '.1', 'FRAME2.1',
                                              -(apv['FRAME2']['k']), 'YZ plane', 0, 354)
                    mprog.add_offset_assembly(S_i.INVERTER_440_T_HP_list[stamping_press_type] + '.1', 'FRAME2.1',
                                              -(apv['FRAME2']['CC'] / 2), 'ZX plane', 0, 355)
        # 200頓  Same=0
    elif stamping_press_type == 7:
        mprog.add_offset_assembly('FRAME6.1', 'FRAME19.1', (apv["FRAME19"]["A"] - apv["FRAME19"]["J"]), 'XY plane',
                                  1, 356)
        mprog.add_offset_assembly('FRAME6.1', 'FRAME19.1', (apv["FRAME19"]["L"]), 'YZ plane', 1, 357)
        mprog.add_offset_assembly('FRAME6.1', 'FRAME19.1', (apv["FRAME19"]["AH"] - apv["FRAME6"]["B"]), 'ZX plane',
                                  0, 358)
        mprog.add_offset_assembly('FRAME6.2', 'FRAME19.2',
                                  -(apv["FRAME19"]["A"] - apv["FRAME19"]["J"] - apv["FRAME19"]["K"]), 'XY plane', 0,
                                  359)
        mprog.add_offset_assembly('FRAME6.2', 'FRAME19.2', (apv["FRAME19"]["L"]), 'YZ plane', 1, 360)
        mprog.add_offset_assembly('FRAME6.2', 'FRAME19.2', -(apv["FRAME6"]["B"]), 'ZX plane', 1, 361)
        mprog.add_offset_assembly('FRAME11.1', 'FRAME3.1',
                                  -(apv['FRAME3']['A'] - apv['FRAME3']['E'] - apv['FRAME11']['A'] / 2), 'XY plane',
                                  0, 362)
        mprog.add_offset_assembly('FRAME11.1', 'FRAME3.1', apv['FRAME3']['O'] + assmebly_par['Ass_I'], 'YZ plane',
                                  0, 363)
        mprog.add_offset_assembly('FRAME11.1', 'FRAME3.1', apv['FRAME3']['B'] / 2 + apv['FRAME11']['A'] / 2,
                                  'ZX plane', 0, 364)
        mprog.add_offset_assembly('FRAME23_1.1', 'FRAME22.1',
                                  -(apv["FRAME22"]["A(1)"] - apv["FRAME22"]["A(2)"] - apv["FRAME23"]["I"]),
                                  'XY plane', 0, 365)
        mprog.add_offset_assembly('FRAME23_1.1', 'FRAME22.1', -(apv["FRAME22"]["O"] + apv["FRAME23"]["A"]),
                                  'YZ plane', 0, 366)
        mprog.add_offset_assembly('FRAME23_1.1', 'FRAME22.1', (apv["FRAME22"]["D"] / 2 + apv["FRAME23"]["B"] / 2),
                                  'ZX plane', 0, 367)
        mprog.add_offset_assembly('FRAME15.1', 'FRAME1.1', -(
                apv['FRAME1']['A'] - apv['FRAME30']['A'] - assmebly_par['Ass_S'] - apv['FRAME17']['g3']) - beta,
                                  'XY plane', 0,
                                  368)
        mprog.add_offset_assembly('FRAME15.1', 'FRAME1.1', -(apv['FRAME1']['F'] - assmebly_par['Ass_F']) - zeta,
                                      'YZ plane', 0, 369)
        mprog.add_offset_assembly('FRAME15.1', 'FRAME1.1',
                                      -(apv['FRAME3']['B'] / 2 - assmebly_par['Ass_U'] + apv['FRAME1']['CC'] / 2),
                                      'ZX plane', 0, 370)
        mprog.add_offset_assembly('FRAME15.2', 'FRAME2.1', -(
                apv['FRAME2']['A'] - apv['FRAME30']['A'] - assmebly_par['Ass_S'] - apv['FRAME17']['g3']) - beta,
                                  'XY plane', 0,
                                  371)
        mprog.add_offset_assembly('FRAME15.2', 'FRAME2.1',
                                  -(apv['FRAME1']['F'] - assmebly_par['Ass_F']) - zeta,
                                  'YZ plane', 0, 372)
        mprog.add_offset_assembly('FRAME15.2', 'FRAME2.1',
                                  (apv['FRAME3']['B'] / 2 - assmebly_par['Ass_U'] + apv['FRAME1']['CC'] / 2 -
                                      apv['FRAME15']['B']),
                                  'ZX plane',
                                  0, 373)
        mprog.add_offset_assembly('FRAME15.3', 'FRAME1.1', apv['FRAME2']['A'] - apv['FRAME30']['A'] - (
                apv['FRAME17']['g3'] - apv['FRAME17']['g2']) - apv['FRAME13']['k'] - apv['FRAME13']['j'] -
                                  assmebly_par['Ass_V'] - assmebly_par['Ass_S'] + apv['FRAME15']['A'] + beta,
                                  'XY plane', 1, 374)
        mprog.add_offset_assembly('FRAME15.3', 'FRAME1.1', -(apv['FRAME1']['F'] - assmebly_par['Ass_F']) - zeta,
                                  'YZ plane', 0, 375)
        mprog.add_offset_assembly('FRAME15.3', 'FRAME1.1', (
                apv['FRAME3']['B'] / 2 - assmebly_par['Ass_U'] + apv['FRAME1']['CC'] / 2 - apv['FRAME15']['B']),
                                  'ZX plane', 1, 376)
        mprog.add_offset_assembly('FRAME15.4', 'FRAME2.1', apv['FRAME2']['A'] - apv['FRAME30']['A'] - (
                apv['FRAME17']['g3'] - apv['FRAME17']['g2']) - apv['FRAME13']['k'] - apv['FRAME13']['j'] -
                                  assmebly_par['Ass_V'] - assmebly_par['Ass_S'] + apv['FRAME15']['A'] + beta,
                                  'XY plane', 1, 377)
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
