sinje0816/stamping_press/SYEI_stamping_press_system/machining_part_TYPE_change.py

import main_program as mprog
import excel_parameter_change as epc
import sys


def modify_list_elements(enter_text, input_list):
    modified_list = [f'{item}%s' % (enter_text) for item in input_list]
    return modified_list


# 母檔變數變換
def change_machining_parameter(name, stamping_press_type, machiningdiepad, travel_type):
    all_part_list = epc.ExcelOp('尺寸整理表', '沖床機架零件清單').get_col_cell(1)
    if name == 'FRAME1':
        excel = epc.ExcelOp('尺寸整理表', 'FRAME1')
        parameter_name, parameter_value = excel.get_sheet_par('FRAME1', stamping_press_type)#更改變數，回傳變數名稱跟值
        if stamping_press_type == 0:
            mprog.partbodyfeatureactivate('before250_喉口')
            mprog.partbodyfeatureactivate('Z1')
            mprog.partbodyfeatureactivate('machining_DD')
            mprog.partbodyfeatureactivate('machining_E上方研磨')
            mprog.activatefeature('110通孔', 0)
            mprog.activatefeature('油面劑用', 0)
            mprog.activatefeature('60通孔', 0)
            mprog.activatefeature('電動黃油泵用', 0)
            mprog.activatefeature('吊孔', 0)
            mprog.activatefeature('光電裝置電線固定孔', 5)
            mprog.activatefeature('配管用(電動黃油泵→潤滑分配塊用)', 2)
            mprog.activatefeature('兩點組合', 0)
            mprog.activatefeature('machining_2x8_12通孔', 0)
            mprog.activatefeature('machining_aaaaa2', 0)
            mprog.activatefeature('machining_aaaaa4', 0)
            mprog.activatefeature('6_M10X12L', 0)
            mprog.partbodyfeatureactivate('JJ')
        elif stamping_press_type == 1:
            mprog.partbodyfeatureactivate('before250_喉口')
            mprog.partbodyfeatureactivate('Z1')
            mprog.partbodyfeatureactivate('machining_DD')
            mprog.partbodyfeatureactivate('machining_E上方研磨')
            mprog.activatefeature('110通孔', 0)
            mprog.activatefeature('油面劑用', 0)
            mprog.activatefeature('60通孔', 0)
            mprog.activatefeature('電動黃油泵用', 0)
            mprog.activatefeature('吊孔', 0)
            mprog.activatefeature('光電裝置電線固定孔', 5)
            mprog.activatefeature('配管用(電動黃油泵→潤滑分配塊用)', 3)
            mprog.activatefeature('兩點組合', 0)
            mprog.activatefeature('machining_2x8_12通孔', 0)
            mprog.activatefeature('machining_aaaaa2', 0)
            mprog.activatefeature('machining_aaaaa4', 0)
            mprog.activatefeature('6_M10X12L', 0)
            mprog.partbodyfeatureactivate('JJ')
        elif stamping_press_type == 2:
            mprog.partbodyfeatureactivate('before250_喉口')
            mprog.partbodyfeatureactivate('Z1')
            mprog.partbodyfeatureactivate('machining_DD')
            mprog.partbodyfeatureactivate('machining_E上方研磨')
            mprog.activatefeature('machining_2x8_12通孔', 0)
            mprog.activatefeature('machining_aaaaa2', 0)
            mprog.activatefeature('machining_aaaaa4', 0)
            mprog.activatefeature('110通孔', 0)
            mprog.activatefeature('油面劑用', 0)
            mprog.activatefeature('60通孔', 0)
            mprog.activatefeature('電動黃油泵用', 0)
            mprog.activatefeature('吊孔', 0)
            mprog.activatefeature('光電裝置電線固定孔', 5)
            mprog.activatefeature('配管用(電動黃油泵→潤滑分配塊用)', 2)
            mprog.activatefeature('兩點組合', 0)
            mprog.activatefeature('6_M10X12L', 0)
            mprog.partbodyfeatureactivate('JJ')
        elif stamping_press_type == 3:
            mprog.partbodyfeatureactivate('before250_喉口')
            mprog.partbodyfeatureactivate('Z1')
            mprog.partbodyfeatureactivate('machining_DD')
            mprog.partbodyfeatureactivate('machining_E上方研磨')
            mprog.activatefeature('machining_2x8_12通孔', 0)
            mprog.activatefeature('machining_aaaaa2', 0)
            mprog.activatefeature('machining_aaaaa4', 0)
            mprog.activatefeature('110通孔', 0)
            mprog.activatefeature('油面劑用', 0)
            mprog.activatefeature('60通孔', 0)
            mprog.activatefeature('電動黃油泵用', 0)
            mprog.activatefeature('吊孔', 0)
            mprog.activatefeature('光電裝置電線固定孔', 5)
            mprog.activatefeature('配管用(電動黃油泵→潤滑分配塊用)', 2)
            mprog.activatefeature('兩點組合', 0)
            mprog.activatefeature('6_M10X12L', 0)
            mprog.partbodyfeatureactivate('JJ')
        elif stamping_press_type == 4:
            mprog.partbodyfeatureactivate('before250_喉口')
            mprog.partbodyfeatureactivate('Z1')
            mprog.partbodyfeatureactivate('machining_DD')
            mprog.partbodyfeatureactivate('machining_E上方研磨')
            mprog.activatefeature('machining_2x8_12通孔', 0)
            mprog.activatefeature('machining_aaaaa2', 0)
            mprog.activatefeature('machining_aaaaa4', 0)
            mprog.activatefeature('1-M5X10L(配管用)', 0)
            mprog.activatefeature('油面劑用', 0)
            mprog.activatefeature('60通孔', 0)
            mprog.activatefeature('電動黃油泵用', 0)
            mprog.activatefeature('吊孔', 0)
            mprog.activatefeature('光電裝置電線固定孔', 5)
            mprog.activatefeature('配管用(電動黃油泵→潤滑分配塊用)', 3)
            mprog.activatefeature('兩點組合', 0)
            mprog.activatefeature('3-M5X10L(配管用)(r1)', 1)
        elif stamping_press_type == 5:
            mprog.partbodyfeatureactivate('before250_喉口')
            mprog.partbodyfeatureactivate('Z1')
            mprog.partbodyfeatureactivate('machining_DD')
            mprog.partbodyfeatureactivate('machining_E上方研磨')
            mprog.activatefeature('machining_2x8_12通孔', 0)
            mprog.activatefeature('machining_aaaaa2', 0)
            mprog.activatefeature('machining_aaaaa4', 0)
            mprog.activatefeature('1-M5X10L(配管用)', 0)
            mprog.activatefeature('油面劑用', 0)
            mprog.activatefeature('60通孔', 0)
            mprog.activatefeature('電動黃油泵用', 0)
            mprog.activatefeature('吊孔', 0)
            mprog.activatefeature('光電裝置電線固定孔', 0)
            mprog.activatefeature('配管用(電動黃油泵→潤滑分配塊用)', 3)
            mprog.activatefeature('兩點組合', 0)
            mprog.activatefeature('3-M5X10L(配管用)(r1)', 2)
        elif stamping_press_type == 6:
            mprog.partbodyfeatureactivate('before250_喉口')
            mprog.partbodyfeatureactivate('Z1')
            mprog.partbodyfeatureactivate('machining_DD')
            mprog.partbodyfeatureactivate('machining_E上方研磨')
            mprog.activatefeature('machining_2x8_12通孔', 0)
            mprog.activatefeature('machining_aaaaa2', 0)
            mprog.activatefeature('machining_aaaaa4', 0)
            mprog.activatefeature('1-M5X10L(配管用)', 0)
            mprog.activatefeature('3-M5X10L(配管用)(r1)', 0)
            mprog.activatefeature('油面劑用', 0)
            mprog.activatefeature('60通孔', 0)
            mprog.activatefeature('電動黃油泵用', 0)
            mprog.activatefeature('吊孔', 0)
            mprog.activatefeature('光電裝置電線固定孔', 0)
            mprog.activatefeature('配管用(電動黃油泵→潤滑分配塊用)', 5)
            mprog.activatefeature('兩點組合', 0)
        elif stamping_press_type == 7:
            mprog.partbodyfeatureactivate('before250_喉口')
            mprog.partbodyfeatureactivate('Z1')
            mprog.partbodyfeatureactivate('machining_DD')
            mprog.partbodyfeatureactivate('machining_E上方研磨')
            mprog.activatefeature('machining_2x8_12通孔', 0)
            mprog.activatefeature('machining_aaaaa2', 0)
            mprog.activatefeature('machining_aaaaa4', 0)
            mprog.activatefeature('1-M5X10L(配管用)', 0)
            mprog.activatefeature('3-M5X10L(配管用)(r1)', 2)
            mprog.activatefeature('油面劑用', 0)
            mprog.activatefeature('60通孔', 0)
            mprog.activatefeature('電動黃油泵用', 0)
            mprog.activatefeature('吊孔', 0)
            mprog.activatefeature('光電裝置電線固定孔', 0)
            mprog.activatefeature('配管用(電動黃油泵→潤滑分配塊用)', 5)
            mprog.activatefeature('兩點組合', 0)
        elif stamping_press_type == 8:
            mprog.partbodyfeatureactivate('T250')
            mprog.partbodyfeatureactivate('Z1')
            mprog.partbodyfeatureactivate('machining_DD_250')
            mprog.partbodyfeatureactivate('machining_E上方研磨')
            mprog.activatefeature('machining_2x8_12通孔', 0)
            mprog.activatefeature('machining_aaaaa2', 0)
            mprog.activatefeature('machining_aaaaa4', 0)
            mprog.activatefeature('1-M5X10L(配管用)', 0)
            mprog.activatefeature('3-M5X10L(配管用)(r1)', 0)
            mprog.activatefeature('油面劑用', 0)
            mprog.activatefeature('60通孔', 0)
            mprog.activatefeature('電動黃油泵用', 0)
            mprog.activatefeature('吊孔', 0)
            mprog.activatefeature('光電裝置電線固定孔', 0)
            mprog.activatefeature('配管用(電動黃油泵→潤滑分配塊用)', 0)
            mprog.activatefeature('兩點組合', 0)
        mprog.update()#更新
    elif name == 'FRAME2':
        excel = epc.ExcelOp('尺寸整理表', 'FRAME2')
        parameter_name, parameter_value = excel.get_sheet_par(
                'FRAME2', stamping_press_type)
        if stamping_press_type == 0:
            mprog.partbodyfeatureactivate('before250_喉口')
            mprog.partbodyfeatureactivate('Z1')
            mprog.partbodyfeatureactivate('machining_DD')
            mprog.partbodyfeatureactivate('machining_E上方研磨')
            mprog.activatefeature('machining_2x8_12通孔', 0)
            mprog.activatefeature('machining_aaaaa2', 0)
            mprog.activatefeature('machining_aaaaa4', 0)
            mprog.partbodyfeatureactivate('Z1')
            mprog.activatefeature('電線穿線孔', 0)
            mprog.activatefeature('電線護罩(長型)', 4)
            mprog.activatefeature('馬達電線固定孔', 0)
            mprog.activatefeature('吊孔', 0)
            mprog.activatefeature('風管、電線固定孔(吹氣吹料用)', 1)
            mprog.activatefeature('風管、電線穿線孔(吹氣吹料用)', 0)
            mprog.activatefeature('光電裝置電線固定孔', 0)
            mprog.activatefeature('氣壓錶箱用', 0)
            mprog.activatefeature('吹氣吹料(標配)', 0)
            mprog.activatefeature('電氣箱用', 0)
            mprog.activatefeature('安全開關', 0)
            mprog.activatefeature('安全桿', 0)
            mprog.activatefeature('解角器裝置線用', 0)
            mprog.activatefeature('解角器用', 0)
            mprog.activatefeature('變頻器用', 0)
            mprog.activatefeature('解角器護蓋用', 0)
            mprog.activatefeature('解碼器電線(蛇管)固定孔', 0)
            mprog.partbodyfeatureactivate('part_S')
            mprog.partbodyfeatureactivate('MM')
            mprog.activatefeature('解角器固定架用', 0)
            mprog.activatefeature('解角器固定架用_2', 0)
        elif stamping_press_type == 1:
            mprog.partbodyfeatureactivate('before250_喉口')
            mprog.partbodyfeatureactivate('Z1')
            mprog.partbodyfeatureactivate('machining_DD')
            mprog.partbodyfeatureactivate('machining_E上方研磨')
            mprog.activatefeature('machining_2x8_12通孔', 0)
            mprog.activatefeature('machining_aaaaa2', 0)
            mprog.activatefeature('machining_aaaaa4', 0)
            mprog.activatefeature('電線穿線孔', 0)
            mprog.activatefeature('電線護罩(長型)', 4)
            mprog.activatefeature('馬達電線固定孔', 0)
            mprog.activatefeature('吊孔', 0)
            mprog.activatefeature('風管、電線固定孔(吹氣吹料用)', 1)
            mprog.activatefeature('風管、電線穿線孔(吹氣吹料用)', 0)
            mprog.activatefeature('光電裝置電線固定孔', 0)
            mprog.activatefeature('氣壓錶箱用', 0)
            mprog.activatefeature('吹氣吹料(標配)', 0)
            mprog.activatefeature('電氣箱用', 0)
            mprog.activatefeature('安全開關', 0)
            mprog.activatefeature('安全桿', 0)
            mprog.activatefeature('解角器裝置線用', 0)
            mprog.activatefeature('解角器用', 0)
            mprog.activatefeature('變頻器用', 0)
            mprog.activatefeature('解角器護蓋用', 0)
            mprog.activatefeature('解碼器電線(蛇管)固定孔', 0)
            mprog.activatefeature('1-M5X10L(配管用)', 0)
            mprog.activatefeature('1-M5X10L底孔20L配管用', 0)
            mprog.partbodyfeatureactivate('part_S')
            mprog.partbodyfeatureactivate('MM')
            mprog.activatefeature('解角器固定架用', 0)
            mprog.activatefeature('解角器固定架用_2', 0)
        elif stamping_press_type == 2:
            mprog.partbodyfeatureactivate('before250_喉口')
            mprog.partbodyfeatureactivate('Z1')
            mprog.partbodyfeatureactivate('machining_DD')
            mprog.partbodyfeatureactivate('machining_E上方研磨')
            mprog.activatefeature('machining_2x8_12通孔', 0)
            mprog.activatefeature('machining_aaaaa2', 0)
            mprog.activatefeature('machining_aaaaa4', 0)
            mprog.activatefeature('電線穿線孔', 0)
            mprog.activatefeature('電線護罩(長型)', 4)
            mprog.activatefeature('馬達電線固定孔', 0)
            mprog.activatefeature('吊孔', 0)
            mprog.activatefeature('風管、電線固定孔(吹氣吹料用)', 2)
            mprog.activatefeature('風管、電線穿線孔(吹氣吹料用)', 0)
            mprog.activatefeature('光電裝置電線固定孔', 0)
            mprog.activatefeature('氣壓錶箱用', 0)
            mprog.activatefeature('吹氣吹料(標配)', 0)
            mprog.activatefeature('電氣箱用', 0)
            mprog.activatefeature('安全開關', 0)
            mprog.activatefeature('安全桿', 0)
            mprog.activatefeature('解角器裝置線用', 0)
            mprog.activatefeature('解角器用', 0)
            mprog.activatefeature('變頻器用', 0)
            mprog.activatefeature('解角器護蓋用', 0)
            mprog.activatefeature('解碼器電線(蛇管)固定孔', 0)
            mprog.activatefeature('1-M5X10L底孔20L配管用', 0)
            mprog.partbodyfeatureactivate('part_S')
            mprog.partbodyfeatureactivate('MM')
            mprog.activatefeature('解角器固定架用', 0)
            mprog.activatefeature('解角器固定架用_2', 0)
        elif stamping_press_type == 3:
            mprog.partbodyfeatureactivate('before250_喉口')
            mprog.partbodyfeatureactivate('Z1')
            mprog.partbodyfeatureactivate('machining_DD')
            mprog.partbodyfeatureactivate('machining_E上方研磨')
            mprog.activatefeature('machining_2x8_12通孔', 0)
            mprog.activatefeature('machining_aaaaa2', 0)
            mprog.activatefeature('machining_aaaaa4', 0)
            mprog.activatefeature('電線穿線孔', 0)
            mprog.activatefeature('電線護罩(長型)', 4)
            mprog.activatefeature('馬達電線固定孔', 0)
            mprog.activatefeature('吊孔', 0)
            mprog.activatefeature('風管、電線固定孔(吹氣吹料用)', 2)
            mprog.activatefeature('風管、電線穿線孔(吹氣吹料用)', 0)
            mprog.activatefeature('光電裝置電線固定孔', 0)
            mprog.activatefeature('氣壓錶箱用', 0)
            mprog.activatefeature('吹氣吹料(標配)', 0)
            mprog.activatefeature('電氣箱用', 0)
            mprog.activatefeature('安全開關', 0)
            mprog.activatefeature('安全桿', 0)
            mprog.activatefeature('解角器裝置線用', 0)
            mprog.activatefeature('解角器用', 0)
            mprog.activatefeature('變頻器用', 0)
            mprog.activatefeature('解角器護蓋用', 0)
            mprog.activatefeature('解碼器電線(蛇管)固定孔', 0)
            mprog.activatefeature('1-M5X10L(配管用)', 0)
            mprog.partbodyfeatureactivate('part_S')
            mprog.partbodyfeatureactivate('MM')
            mprog.activatefeature('解角器固定架用', 0)
            mprog.activatefeature('解角器固定架用_2', 0)
        elif stamping_press_type == 4:
            mprog.partbodyfeatureactivate('before250_喉口')
            mprog.partbodyfeatureactivate('Z1')
            mprog.partbodyfeatureactivate('machining_DD')
            mprog.partbodyfeatureactivate('machining_E上方研磨')
            mprog.partbodyfeatureactivate('jjj4')
            mprog.partbodyfeatureactivate('mmm4')
            mprog.activatefeature('machining_2x8_12通孔', 0)
            mprog.activatefeature('machining_aaaaa2', 0)
            mprog.activatefeature('machining_aaaaa4', 0)
            mprog.activatefeature('電線穿線孔', 0)
            mprog.activatefeature('電線護罩(長型)', 4)
            mprog.activatefeature('馬達電線固定孔', 0)
            mprog.activatefeature('吊孔', 0)
            mprog.activatefeature('風管、電線固定孔(吹氣吹料用)', 2)
            mprog.activatefeature('風管、電線穿線孔(吹氣吹料用)', 0)
            mprog.activatefeature('光電裝置電線固定孔', 5)
            mprog.activatefeature('氣壓錶箱用', 0)
            mprog.activatefeature('吹氣吹料(標配)', 0)
            mprog.activatefeature('電氣箱用', 0)
            mprog.activatefeature('安全開關', 0)
            mprog.activatefeature('安全桿', 0)
            mprog.activatefeature('解角器裝置線用', 0)
            mprog.activatefeature('1-M5X10L(配管用)', 0)
            mprog.activatefeature('4-M8X16L', 0)
            mprog.activatefeature('2-M5(配管用)', 0)
            mprog.activatefeature('台達變頻器用10HP', 0)
            mprog.activatefeature('東元變頻器用10HP', 0)
            mprog.activatefeature('電氣箱連桿', 2)
        elif stamping_press_type == 5:
            mprog.partbodyfeatureactivate('before250_喉口')
            mprog.partbodyfeatureactivate('Z1')
            mprog.partbodyfeatureactivate('machining_DD')
            mprog.partbodyfeatureactivate('machining_E上方研磨')
            mprog.partbodyfeatureactivate('dd4')
            mprog.partbodyfeatureactivate('x4')
            mprog.activatefeature('machining_2x8_12通孔', 0)
            mprog.activatefeature('machining_aaaaa2', 0)
            mprog.activatefeature('machining_aaaaa4', 0)
            mprog.activatefeature('電線穿線孔', 0)
            mprog.activatefeature('電線護罩(長型)', 5)
            mprog.activatefeature('馬達電線固定孔', 0)
            mprog.activatefeature('吊孔', 0)
            mprog.activatefeature('風管、電線固定孔(吹氣吹料用)', 0)
            mprog.activatefeature('風管、電線穿線孔(吹氣吹料用)', 0)
            mprog.activatefeature('光電裝置電線固定孔', 0)
            mprog.activatefeature('氣壓錶箱用', 0)
            mprog.activatefeature('吹氣吹料(標配)', 0)
            mprog.activatefeature('電氣箱用', 0)
            mprog.activatefeature('安全開關', 0)
            mprog.activatefeature('安全桿', 0)
            mprog.activatefeature('1-M5X10L(配管用)', 0)
            mprog.activatefeature('4-M8X16L', 0)
            mprog.activatefeature('2-M5(配管用)', 0)
            mprog.activatefeature('電氣箱連桿', 0)
            mprog.activatefeature('東元變頻器10,15HP440V用', 0)
            mprog.activatefeature('台達變頻器10,15HP', 0)
            mprog.activatefeature('東元變頻器,15HP220V', 0)
        elif stamping_press_type == 6:
            mprog.partbodyfeatureactivate('before250_喉口')
            mprog.partbodyfeatureactivate('Z1')
            mprog.partbodyfeatureactivate('machining_DD')
            mprog.partbodyfeatureactivate('machining_E上方研磨')
            mprog.partbodyfeatureactivate('ggg4')
            mprog.partbodyfeatureactivate('xx3')
            mprog.partbodyfeatureactivate('iii4')
            mprog.partbodyfeatureactivate('fff4')
            mprog.activatefeature('machining_2x8_12通孔', 0)
            mprog.activatefeature('machining_aaaaa2', 0)
            mprog.activatefeature('machining_aaaaa4', 0)
            mprog.activatefeature('電線穿線孔', 0)
            mprog.activatefeature('電線護罩(長型)', 5)
            mprog.activatefeature('馬達電線固定孔', 0)
            mprog.activatefeature('吊孔', 0)
            mprog.activatefeature('風管、電線固定孔(吹氣吹料用)', 2)
            mprog.activatefeature('風管、電線穿線孔(吹氣吹料用)', 0)
            mprog.activatefeature('光電裝置電線固定孔', 0)
            mprog.activatefeature('氣壓錶箱用', 0)
            mprog.activatefeature('吹氣吹料(標配)', 0)
            mprog.activatefeature('電氣箱用', 0)
            mprog.activatefeature('安全開關', 0)
            mprog.activatefeature('安全桿', 0)
            mprog.activatefeature('4-M8X16L', 0)
            mprog.activatefeature('2-M5(配管用)', 0)
            mprog.activatefeature('電氣箱連桿', 0)
            mprog.activatefeature('東元變頻器440V,15,20HP', 0)
            mprog.activatefeature('台達變頻器440V,15,20HP；220V15HP', 0)
            mprog.activatefeature('台達變頻器220V,20HP', 0)
            mprog.activatefeature('東元變頻器220V,15,20HP', 0)
        elif stamping_press_type == 7:
            mprog.partbodyfeatureactivate('before250_喉口')
            mprog.partbodyfeatureactivate('Z1')
            mprog.partbodyfeatureactivate('machining_DD')
            mprog.partbodyfeatureactivate('machining_E上方研磨')
            mprog.partbodyfeatureactivate('iii4')
            mprog.partbodyfeatureactivate('ssss4')
            mprog.partbodyfeatureactivate('sss4')
            mprog.activatefeature('machining_2x8_12通孔', 0)
            mprog.activatefeature('machining_aaaaa2', 0)
            mprog.activatefeature('machining_aaaaa4', 0)
            mprog.activatefeature('電線穿線孔', 0)
            mprog.activatefeature('電線護罩(長型)', 5)
            mprog.activatefeature('馬達電線固定孔', 0)
            mprog.activatefeature('吊孔', 0)
            mprog.activatefeature('風管、電線固定孔(吹氣吹料用)', 0)
            mprog.activatefeature('風管、電線穿線孔(吹氣吹料用)', 0)
            mprog.activatefeature('光電裝置電線固定孔', 0)
            mprog.activatefeature('氣壓錶箱用', 0)
            mprog.activatefeature('吹氣吹料(標配)', 0)
            mprog.activatefeature('電氣箱用', 0)
            mprog.activatefeature('安全開關', 0)
            mprog.activatefeature('安全桿', 0)
            mprog.activatefeature('1-M5X10L(配管用)', 0)
            mprog.activatefeature('4-M8X16L', 0)
            mprog.activatefeature('2-M5(配管用)', 0)
            mprog.activatefeature('電氣箱連桿', 0)
            mprog.activatefeature('台達變頻器220V,20HP', 0)
            mprog.activatefeature('東元變頻器220V/440V,20HP', 0)
            mprog.activatefeature('台達變頻器440V,20HP', 0)
        elif stamping_press_type == 8:
            mprog.partbodyfeatureactivate('T250')
            mprog.partbodyfeatureactivate('Z1')
            mprog.partbodyfeatureactivate('machining_DD_250')
            mprog.partbodyfeatureactivate('machining_E上方研磨')
            mprog.activatefeature('machining_2x8_12通孔', 0)
            mprog.activatefeature('machining_aaaaa2', 0)
            mprog.activatefeature('machining_aaaaa4', 0)
            mprog.activatefeature('電線穿線孔', 0)
            mprog.activatefeature('電線護罩(長型)', 5)
            mprog.activatefeature('馬達電線固定孔', 0)
            mprog.activatefeature('吊孔', 0)
            mprog.activatefeature('風管、電線固定孔(吹氣吹料用)', 2)
            mprog.activatefeature('風管、電線穿線孔(吹氣吹料用)', 0)
            mprog.activatefeature('光電裝置電線固定孔', 0)
            mprog.activatefeature('氣壓錶箱用', 0)
            mprog.activatefeature('吹氣吹料(標配)', 0)
            mprog.activatefeature('電氣箱用', 0)
            mprog.activatefeature('安全開關', 0)
            mprog.activatefeature('安全桿', 0)
            mprog.activatefeature('1-M5X10L(配管用)', 0)
            mprog.activatefeature('4-M8X16L', 0)
            mprog.activatefeature('2-M5(配管用)', 0)
            mprog.activatefeature('電氣箱連桿', 0)
            mprog.activatefeature('東元變頻器25HP', 0)
            mprog.activatefeature('台達變頻器25HP', 0)
        mprog.update()
    elif name == 'FRAME3':
        excel = epc.ExcelOp('尺寸整理表', 'FRAME3')
        parameter_name, parameter_value = excel.get_sheet_par('FRAME3', stamping_press_type)
        if stamping_press_type == 0:
            mprog.activatefeature('SN1_25250_Body', 1)
            mprog.activatefeature('Hole_1', 1)
            mprog.activatefeature('Hole_2', 0)
            mprog.partbodyfeatureactivate('FRAME_SN1_25250_PQ')
            mprog.partbodyfeatureactivate('FRAME_SN1_2560_S')
            mprog.partbodyfeatureactivate('FRAME_SN1_2560_U')
            mprog.partbodyfeatureactivate('machining_AA')
            mprog.partbodyfeatureactivate('machining_L')
            mprog.partbodyfeatureactivate('machining_bbbbb')
            mprog.activatefeature('M10X20L(不可貫穿)', 0)
        elif stamping_press_type == 1:
            mprog.activatefeature('SN1_25250_Body', 1)
            mprog.activatefeature('Hole_1', 1)
            mprog.activatefeature('Hole_2', 0)
            mprog.partbodyfeatureactivate('FRAME_SN1_25250_PQ')
            mprog.partbodyfeatureactivate('FRAME_SN1_2560_S')
            mprog.partbodyfeatureactivate('FRAME_SN1_2560_U')
            mprog.partbodyfeatureactivate('machining_AA')
            mprog.partbodyfeatureactivate('machining_L')
            mprog.partbodyfeatureactivate('machining_bbbbb')
            mprog.activatefeature('M10X20L(不可貫穿)', 0)
        elif stamping_press_type == 2:
            mprog.activatefeature('SN1_25250_Body', 1)
            mprog.activatefeature('Hole_1', 1)
            mprog.activatefeature('Hole_2', 0)
            mprog.partbodyfeatureactivate('FRAME_SN1_25250_PQ')
            mprog.partbodyfeatureactivate('FRAME_SN1_2560_S')
            mprog.partbodyfeatureactivate('FRAME_SN1_2560_U')
            mprog.partbodyfeatureactivate('machining_AA')
            mprog.partbodyfeatureactivate('machining_L')
            mprog.partbodyfeatureactivate('machining_bbbbb')
            mprog.activatefeature('M10X20L(不可貫穿)', 0)
        elif stamping_press_type == 3:
            mprog.activatefeature('SN1_25250_Body', 1)
            mprog.activatefeature('Hole_1', 1)
            mprog.activatefeature('Hole_2', 0)
            mprog.partbodyfeatureactivate('FRAME_SN1_25250_PQ')
            mprog.partbodyfeatureactivate('FRAME_SN1_2560_S')
            mprog.partbodyfeatureactivate('FRAME_SN1_2560_U')
            mprog.partbodyfeatureactivate('machining_AA')
            mprog.partbodyfeatureactivate('machining_L')
            mprog.partbodyfeatureactivate('machining_bbbbb')
            mprog.activatefeature('M10X20L(不可貫穿)', 0)
        elif stamping_press_type == 4:
            mprog.activatefeature('SN1_25250_Body', 1)
            mprog.activatefeature('Hole_1', 1)
            mprog.activatefeature('Hole_2', 0)
            mprog.partbodyfeatureactivate('FRAME_SN1_25250_PQ')
            mprog.partbodyfeatureactivate('FRAME_SN1_80250_R')
            mprog.partbodyfeatureactivate('machining_AA')
            mprog.partbodyfeatureactivate('machining_L')
            mprog.partbodyfeatureactivate('machining_bbbbb')
            mprog.activatefeature('M10X20L(不可貫穿)', 0)
        elif stamping_press_type == 5:
            mprog.activatefeature('SN1_25250_Body', 1)
            mprog.activatefeature('Hole_1', 1)
            mprog.activatefeature('Hole_2', 0)
            mprog.partbodyfeatureactivate('FRAME_SN1_25250_PQ')
            mprog.partbodyfeatureactivate('FRAME_SN1_80250_R')
            mprog.partbodyfeatureactivate('machining_AA')
            mprog.partbodyfeatureactivate('machining_L')
            mprog.partbodyfeatureactivate('machining_bbbbb')
            mprog.activatefeature('M10X20L(不可貫穿)', 0)
        elif stamping_press_type == 6:
            mprog.activatefeature('SN1_25250_Body', 1)
            mprog.activatefeature('Hole_1', 1)
            mprog.activatefeature('Hole_2', 0)
            mprog.partbodyfeatureactivate('FRAME_SN1_25250_PQ')
            mprog.partbodyfeatureactivate('FRAME_SN1_80250_R')
            mprog.partbodyfeatureactivate('machining_AA')
            mprog.partbodyfeatureactivate('machining_bbbbb')
            mprog.partbodyfeatureactivate('machining_L')
            mprog.activatefeature('M10X20L(不可貫穿)', 0)
        elif stamping_press_type == 7:
            mprog.activatefeature('SN1_25250_Body', 1)
            mprog.activatefeature('Hole_1', 1)
            mprog.activatefeature('Hole_2', 0)
            mprog.partbodyfeatureactivate('FRAME_SN1_25250_PQ')
            mprog.partbodyfeatureactivate('FRAME_SN1_80250_R')
            mprog.partbodyfeatureactivate('machining_AA')
            mprog.partbodyfeatureactivate('machining_bbbbb')
            mprog.partbodyfeatureactivate('machining_L')
        elif stamping_press_type == 8:
            mprog.activatefeature('SN1_25250_Body', 1)
            mprog.activatefeature('Hole_1', 1)
            mprog.activatefeature('Hole_2', 0)
            mprog.partbodyfeatureactivate('FRAME_SN1_25250_PQ')
            mprog.partbodyfeatureactivate('FRAME_SN1_80250_R')
            mprog.partbodyfeatureactivate('machining_AA')
            mprog.partbodyfeatureactivate('machining_L')
            mprog.partbodyfeatureactivate('machining_bbbbb')
        mprog.Update()
    elif name == 'FRAME4':  # 已更改
        excel = epc.ExcelOp('尺寸整理表', 'FRAME4')
        parameter_name, parameter_value = excel.get_sheet_par('FRAME4', stamping_press_type)
        if stamping_press_type == 0:
            mprog.activatefeature('SN1_25250_Body', 1)
            mprog.activatefeature('Hole_1', 1)
            mprog.activatefeature('CLUCTH_AIR_HOLE', 0)
            mprog.partbodyfeatureactivate("machining_P")
            mprog.partbodyfeatureactivate("machining_bbbbb")
        elif stamping_press_type == 1:
            mprog.activatefeature('SN1_25250_Body', 1)
            mprog.activatefeature('Hole_1', 1)
            mprog.activatefeature('CLUCTH_AIR_HOLE', 0)
            mprog.partbodyfeatureactivate("machining_P")
            mprog.partbodyfeatureactivate("machining_O")
            mprog.partbodyfeatureactivate("machining_bbbbb")
        elif stamping_press_type == 2:
            mprog.activatefeature('SN1_25250_Body', 1)
            mprog.activatefeature('Hole_1', 1)
            mprog.activatefeature('CLUCTH_AIR_HOLE', 0)
            mprog.partbodyfeatureactivate("machining_P")
            mprog.partbodyfeatureactivate("machining_O")
            mprog.partbodyfeatureactivate("machining_bbbbb")
        elif stamping_press_type == 3:
            mprog.activatefeature('SN1_25250_Body', 1)
            mprog.activatefeature('Hole_1', 1)
            mprog.activatefeature('CLUCTH_AIR_HOLE', 0)
            mprog.activatefeature('Hole_3', 2)
            mprog.partbodyfeatureactivate("machining_N")
            mprog.partbodyfeatureactivate("machining_O")
            mprog.partbodyfeatureactivate("machining_M")
            mprog.partbodyfeatureactivate("machining_P")
            mprog.partbodyfeatureactivate("machining_bbbbb")
        elif stamping_press_type == 4:
            mprog.activatefeature('SN1_25250_Body', 1)
            mprog.activatefeature('Hole_1', 1)
            mprog.activatefeature('CLUCTH_AIR_HOLE', 0)
            mprog.activatefeature('Hole_3', 2)
            mprog.activatefeature('Hole_4', 0)
            mprog.partbodyfeatureactivate("machining_N")
            mprog.partbodyfeatureactivate("machining_O")
            mprog.partbodyfeatureactivate("machining_M")
            mprog.partbodyfeatureactivate("machining_P")
            mprog.partbodyfeatureactivate("machining_bbbbb")
        elif stamping_press_type == 5:
            mprog.activatefeature('SN1_25250_Body', 1)
            mprog.activatefeature('Hole_1', 1)
            mprog.activatefeature('CLUCTH_AIR_HOLE', 0)
            mprog.activatefeature('Hole_3', 2)
            mprog.activatefeature('Hole_4', 0)
            mprog.partbodyfeatureactivate("machining_N")
            mprog.partbodyfeatureactivate("machining_O")
            mprog.partbodyfeatureactivate("machining_M")
            mprog.partbodyfeatureactivate("machining_P")
            mprog.partbodyfeatureactivate("machining_bbbbb")
        elif stamping_press_type == 6:
            mprog.activatefeature('SN1_25250_Body', 1)
            mprog.activatefeature('Hole_1', 1)
            mprog.activatefeature('CLUCTH_AIR_HOLE', 0)
            mprog.activatefeature('Hole_3', 2)
            mprog.activatefeature('Hole_4', 0)
            mprog.partbodyfeatureactivate("machining_N")
            mprog.partbodyfeatureactivate("machining_O")
            mprog.partbodyfeatureactivate("machining_M")
            mprog.partbodyfeatureactivate("machining_P")
            mprog.partbodyfeatureactivate("machining_bbbbb")
        elif stamping_press_type == 7:
            mprog.activatefeature('SN1_25250_Body', 1)
            mprog.activatefeature('Hole_1', 1)
            mprog.activatefeature('CLUCTH_AIR_HOLE', 0)
            mprog.activatefeature('Hole_3', 2)
            mprog.activatefeature('Hole_4', 0)
            mprog.partbodyfeatureactivate("machining_N")
            mprog.partbodyfeatureactivate("machining_O")
            mprog.partbodyfeatureactivate("machining_M")
            mprog.partbodyfeatureactivate("machining_P")
            mprog.partbodyfeatureactivate("machining_bbbbb")
        elif stamping_press_type == 8:
            mprog.activatefeature('SN1_25250_Body', 1)
            mprog.activatefeature('Hole_1', 1)
            mprog.activatefeature('CLUCTH_AIR_HOLE', 0)
            mprog.activatefeature('Hole_3', 4)
            mprog.activatefeature('Hole_4', 0)
            mprog.partbodyfeatureactivate("machining_N")
            mprog.partbodyfeatureactivate("machining_O")
            mprog.partbodyfeatureactivate("machining_M")
            mprog.partbodyfeatureactivate("machining_P")
            mprog.partbodyfeatureactivate("machining_bbbbb")
        mprog.Update()
    elif name == 'FRAME5':  # 已更改
        excel = epc.ExcelOp('尺寸整理表', 'FRAME5')
        parameter_name, parameter_value = excel.get_sheet_par('FRAME5', stamping_press_type)
        if stamping_press_type == 0:
            mprog.partbodyfeatureactivate('SN1-25_X')
            mprog.partbodyfeatureactivate('CD')
            mprog.partbodyfeatureactivate('SN1_25_H')
            mprog.activatefeature('2-M8通孔', 0)
            mprog.activatefeature('TY牌電磁閥用', 0)
            mprog.activatefeature('M6通孔LED', 0)
            mprog.activatefeature('PT1/2', 0)
        elif stamping_press_type == 1:
            mprog.partbodyfeatureactivate('CD')
            mprog.partbodyfeatureactivate("SN1_3545_H")
            mprog.activatefeature('2-M8通孔', 0)
            mprog.activatefeature('TY牌電磁閥用', 0)
            mprog.activatefeature('M6通孔LED', 0)
            mprog.activatefeature('PT1/2', 0)
        elif stamping_press_type == 2:
            mprog.partbodyfeatureactivate('CD')
            mprog.partbodyfeatureactivate("SN1_3545_H")
            mprog.activatefeature('2-M8通孔', 0)
            mprog.activatefeature('TY牌電磁閥用', 0)
            mprog.activatefeature('M6通孔LED', 0)
            mprog.activatefeature('PT1/2', 0)
        elif stamping_press_type == 3:
            mprog.partbodyfeatureactivate('CD')
            mprog.partbodyfeatureactivate('NM')
            mprog.partbodyfeatureactivate('SN1_60_R')
            mprog.activatefeature('2-M8通孔', 0)
            mprog.activatefeature('TY牌電磁閥用', 0)
            mprog.activatefeature('M6通孔LED', 0)
        elif stamping_press_type == 4:
            mprog.partbodyfeatureactivate('SN1_80250_OP')
            mprog.partbodyfeatureactivate('SN1_80250_Q')
            mprog.activatefeature('2-M8通孔', 0)
            mprog.activatefeature('TY牌電磁閥用', 0)
            mprog.activatefeature('M6通孔LED', 0)
        elif stamping_press_type == 5:
            mprog.partbodyfeatureactivate('SN1_80250_OP')
            mprog.partbodyfeatureactivate('SN1_80250_Q')
            mprog.partbodyfeatureactivate('6-M6通C5')
            mprog.activatefeature('6-M6通', 0)
            mprog.activatefeature('M6通孔LED', 0)
        elif stamping_press_type == 6:
            mprog.partbodyfeatureactivate('SN1_80250_OP')
            mprog.partbodyfeatureactivate('SN1_80250_Q')
            mprog.partbodyfeatureactivate('3-M8通_C5')
            mprog.activatefeature('3-M8通', 0)
            mprog.activatefeature('M6通孔LED', 0)
        elif stamping_press_type == 7:
            mprog.partbodyfeatureactivate('SN1_80250_OP')
            mprog.partbodyfeatureactivate('SN1_80250_Q')
            mprog.partbodyfeatureactivate('5-M8通_C5')
            mprog.activatefeature('5-M8通', 0)
            mprog.activatefeature('M6通孔LED', 0)
        elif stamping_press_type == 8:
            mprog.partbodyfeatureactivate('SN1_80250_OP')
            mprog.partbodyfeatureactivate('SN1_80250_Q')
            mprog.partbodyfeatureactivate('5-M8通_C5')
            mprog.activatefeature('5-M8通', 0)
            mprog.activatefeature('M6通孔LED', 0)
        mprog.Update()
    elif name == 'FRAME6':
        excel = epc.ExcelOp('尺寸整理表', 'FRAME6')
        parameter_name, parameter_value = excel.get_sheet_par('FRAME6', stamping_press_type)
        if stamping_press_type == 0:
            mprog.activatefeature('FRAME_SN1_2545_Body', 0)
            mprog.activatefeature('M16_i', 0)
        elif stamping_press_type == 1:
            mprog.activatefeature('FRAME_SN1_2545_Body', 0)
            mprog.activatefeature('M16_i', 0)
        elif stamping_press_type == 2:
            mprog.activatefeature('FRAME_SN1_2545_Body', 0)
            mprog.activatefeature('M16_i', 0)
        elif stamping_press_type == 3:
            mprog.activatefeature('FRAME_SN1_60_Body', 0)
            mprog.activatefeature('M16_h FRAME9_L', 0)
        elif stamping_press_type == 4:
            mprog.activatefeature('FRAME_SN1_80110_Body', 0)
            mprog.activatefeature('M16_h FRAME9_L', 0)
        elif stamping_press_type == 5:
            mprog.activatefeature('FRAME_SN1_80110_Body', 0)
            mprog.activatefeature('M16_h FRAME9_L', 0)
        elif stamping_press_type == 7:
            mprog.activatefeature('FRAME_SN1_200_Body', 0)
            mprog.activatefeature('M16_h FRAME9_L', 0)
        mprog.Update()
    elif name == 'FRAME7':  # 已更改
        excel = epc.ExcelOp('尺寸整理表', 'FRAME7')
        parameter_name, parameter_value = excel.get_sheet_par('FRAME7', stamping_press_type)
        if stamping_press_type == 0:
            mprog.activatefeature('SN1_2560_Body', 1)
            mprog.partbodyfeatureactivate('SN1_25_VWX')
            mprog.partbodyfeatureactivate('DD')
        elif stamping_press_type == 1:
            mprog.activatefeature('SN1_2560_Body', 1)
            mprog.partbodyfeatureactivate('DD')
        elif stamping_press_type == 2:
            mprog.activatefeature('SN1_2560_Body', 1)
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
        excel = epc.ExcelOp('尺寸整理表', 'FRAME12')
        parameter_name, parameter_value = excel.get_sheet_par('FRAME12', stamping_press_type)
        if stamping_press_type == 0:  # 25N
            mprog.partbodyfeatureactivate('Chamfer.1')
            mprog.activatefeature('Pipe_clamp', 2)
            mprog.activatefeature('drain_hole', 0)
        elif stamping_press_type == 1:  # 35N
            mprog.partbodyfeatureactivate('Chamfer.1')
            mprog.activatefeature('Pipe_clamp', 2)
            mprog.activatefeature('drain_hole', 0)
        elif stamping_press_type == 2:  # 45N
            mprog.partbodyfeatureactivate('Chamfer.1')
            mprog.activatefeature('Pipe_clamp', 2)
            mprog.activatefeature('drain_hole', 0)
        elif stamping_press_type == 3:  # 60N
            mprog.partbodyfeatureactivate('Chamfer.1')
            mprog.activatefeature('Pipe_clamp', 2)
            mprog.activatefeature('drain_hole', 0)
        elif stamping_press_type == 4:  # 80N
            mprog.partbodyfeatureactivate('Chamfer.1')
            mprog.activatefeature('Pipe_clamp', 2)
            mprog.activatefeature('drain_hole', 0)
        elif stamping_press_type == 5:  # 110N
            mprog.partbodyfeatureactivate('Chamfer.1')
            mprog.activatefeature('Pipe_clamp', 2)
            mprog.activatefeature('drain_hole', 0)
        elif stamping_press_type == 6:  # 160N
            mprog.partbodyfeatureactivate('C8_160')
            mprog.activatefeature('Pipe_clamp', 2)
            mprog.activatefeature('drain_hole', 0)
        elif stamping_press_type == 7:  # 200N
            mprog.partbodyfeatureactivate('Chamfer.1')
            mprog.activatefeature('Pipe_clamp', 0)
            mprog.activatefeature('drain_hole', 0)
        elif stamping_press_type == 8:  # 250N
            mprog.partbodyfeatureactivate('Chamfer.1')
            mprog.activatefeature('Pipe_clamp', 0)
            mprog.activatefeature('drain_hole', 0)
        mprog.Update()
    elif name == 'FRAME13':
        excel = epc.ExcelOp('尺寸整理表', 'FRAME13')
        parameter_name, parameter_value = excel.get_sheet_par('FRAME13', stamping_press_type)
        if stamping_press_type == 0:
            mprog.partbodyfeatureactivate('AB')
            mprog.partbodyfeatureactivate('SN1_25_45_CD')
            mprog.partbodyfeatureactivate('SN1_25_45_G')
            mprog.activatefeature('GIB_OIL_HOLE', 1)
            mprog.activatefeature('SLIDE_LINER_FIX_HOLE_1', 0)
            mprog.activatefeature('SLIDE_LINER_FIX_HOLE_2', 0)
            mprog.activatefeature('Hole_4', 0)
            mprog.partbodyfeatureactivate("H")
            mprog.partbodyfeatureactivate("I")
        elif stamping_press_type == 1:
            mprog.partbodyfeatureactivate('AB')
            mprog.activatefeature('GIB_OIL_HOLE', 1)
            mprog.activatefeature('SLIDE_LINER_FIX_HOLE_1', 0)
            mprog.activatefeature('SLIDE_LINER_FIX_HOLE_2', 0)
            mprog.activatefeature('Hole_4', 0)
            mprog.partbodyfeatureactivate("H")
            mprog.partbodyfeatureactivate("I")
        elif stamping_press_type == 2:
            mprog.partbodyfeatureactivate('AB')
            mprog.partbodyfeatureactivate('SN1_25_45_CD')
            mprog.partbodyfeatureactivate('SN1_25_45_G')
            mprog.activatefeature('GIB_OIL_HOLE', 1)
            mprog.activatefeature('SLIDE_LINER_FIX_HOLE_1', 0)
            mprog.activatefeature('SLIDE_LINER_FIX_HOLE_2', 0)
            mprog.activatefeature('Hole_4', 0)
            mprog.partbodyfeatureactivate("H")
            mprog.partbodyfeatureactivate("I")
        elif stamping_press_type == 3:
            mprog.partbodyfeatureactivate('AB')
            mprog.activatefeature('GIB_OIL_HOLE', 1)
            mprog.activatefeature('SLIDE_LINER_FIX_HOLE_1', 0)
            mprog.activatefeature('SLIDE_LINER_FIX_HOLE_2', 0)
            mprog.activatefeature('Hole_4', 0)
            mprog.partbodyfeatureactivate("H")
            mprog.partbodyfeatureactivate("I")
        elif stamping_press_type == 4:
            mprog.partbodyfeatureactivate('AB')
            mprog.activatefeature('GIB_OIL_HOLE', 0)
            mprog.activatefeature('SLIDE_LINER_FIX_HOLE_1', 0)
            mprog.activatefeature('SLIDE_LINER_FIX_HOLE_2', 0)
            mprog.activatefeature('Hole_4', 0)
            mprog.partbodyfeatureactivate("H")
            mprog.partbodyfeatureactivate("I")
        elif stamping_press_type == 5:
            mprog.partbodyfeatureactivate('AB')
            mprog.activatefeature('GIB_OIL_HOLE', 0)
            mprog.activatefeature('SLIDE_LINER_FIX_HOLE_1', 0)
            mprog.activatefeature('SLIDE_LINER_FIX_HOLE_2', 0)
            mprog.activatefeature('Hole_4', 0)
            mprog.partbodyfeatureactivate("H")
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
            mprog.activatefeature('GIB_OIL_HOLE', 0)
            mprog.activatefeature('SLIDE_LINER_FIX_HOLE_1', 0)
            mprog.activatefeature('SLIDE_LINER_FIX_HOLE_2', 0)
            mprog.activatefeature('Hole_4', 0)
            mprog.partbodyfeatureactivate("H")
            mprog.partbodyfeatureactivate("I")
        elif stamping_press_type == 7:
            mprog.partbodyfeatureactivate('AB')
            mprog.activatefeature('GIB_OIL_HOLE', 0)
            mprog.activatefeature('SLIDE_LINER_FIX_HOLE_1', 0)
            mprog.activatefeature('SLIDE_LINER_FIX_HOLE_2', 0)
            mprog.activatefeature('Hole_4', 0)
            mprog.partbodyfeatureactivate("H")
            mprog.partbodyfeatureactivate("I")
        elif stamping_press_type == 8:
            mprog.partbodyfeatureactivate('AB')
            mprog.activatefeature('SLIDE_LINER_FIX_HOLE_1', 0)
            mprog.activatefeature('SLIDE_LINER_FIX_HOLE_2', 0)
            mprog.activatefeature('GIB_OIL_HOLE', 0)
            mprog.activatefeature('Hole_4', 0)
            mprog.partbodyfeatureactivate("H")
            mprog.partbodyfeatureactivate("I")
        mprog.Update()
    elif name == 'FRAME14':
        excel = epc.ExcelOp('尺寸整理表', 'FRAME14')
        parameter_name, parameter_value = excel.get_sheet_par('FRAME14', stamping_press_type)
        if stamping_press_type == 0:  # 25N
            mprog.activatefeature('inside_hole', 0)
            mprog.activatefeature('processing_h', 0)
            mprog.activatefeature('processing_i', 0)
            mprog.activatefeature('processing_m', 0)
            mprog.partbodyfeatureactivate("H")
            mprog.partbodyfeatureactivate("I")
        elif stamping_press_type == 1:  # 35N
            mprog.activatefeature('inside_hole', 0)
            mprog.activatefeature('processing_h', 0)
            mprog.activatefeature('processing_i', 0)
            mprog.activatefeature('processing_m', 0)
            mprog.partbodyfeatureactivate("H")
            mprog.partbodyfeatureactivate("I")
        elif stamping_press_type == 2:  # 45N
            mprog.activatefeature('inside_hole', 0)
            mprog.activatefeature('processing_h', 0)
            mprog.activatefeature('processing_i', 0)
            mprog.activatefeature('processing_m', 0)
            mprog.partbodyfeatureactivate("H")
            mprog.partbodyfeatureactivate("I")
        elif stamping_press_type == 3:  # 60N
            mprog.activatefeature('inside_hole', 0)
            mprog.activatefeature('processing_h', 0)
            mprog.activatefeature('processing_i', 0)
            mprog.activatefeature('processing_m', 0)
            mprog.partbodyfeatureactivate("H")
            mprog.partbodyfeatureactivate("I")
        elif stamping_press_type == 4:  # 80N
            mprog.activatefeature('inside_hole', 0)
            mprog.activatefeature('outside_hole', 0)
            mprog.activatefeature('outside_hole_E', 0)
            mprog.activatefeature('processing_h', 0)
            mprog.activatefeature('processing_i', 0)
            mprog.activatefeature('processing_m', 0)
            mprog.partbodyfeatureactivate("H")
            mprog.partbodyfeatureactivate("I")
        elif stamping_press_type == 5:  # 110N
            mprog.activatefeature('inside_hole', 0)
            mprog.activatefeature('outside_hole', 0)
            mprog.activatefeature('processing_h', 0)
            mprog.activatefeature('processing_i', 0)
            mprog.activatefeature('processing_m', 0)
            mprog.partbodyfeatureactivate("H")
            mprog.partbodyfeatureactivate("I")
        elif stamping_press_type == 6:  # 160N
            mprog.activatefeature('inside_hole', 0)
            mprog.activatefeature('outside_hole', 0)
            mprog.activatefeature('processing_h', 0)
            mprog.activatefeature('processing_i', 0)
            mprog.activatefeature('processing_m', 0)
            mprog.partbodyfeatureactivate("H")
            mprog.partbodyfeatureactivate("I")
        elif stamping_press_type == 7:  # 200N
            mprog.activatefeature('outside_hole_E', 0)
            mprog.activatefeature('processing_h', 0)
            mprog.activatefeature('processing_i', 0)
            mprog.activatefeature('processing_m', 0)
            mprog.partbodyfeatureactivate("H")
            mprog.partbodyfeatureactivate("I")
        elif stamping_press_type == 8:  # 250N
            mprog.partbodyfeatureactivate("250N")
            mprog.activatefeature('inside_hole', 0)
            mprog.activatefeature('outside_hole', 0)
            mprog.activatefeature('processing_h', 0)
            mprog.activatefeature('processing_i', 0)
            mprog.activatefeature('processing_m', 0)
            mprog.partbodyfeatureactivate("H")
            mprog.partbodyfeatureactivate("I")
        mprog.Update()
    elif name == 'FRAME15':
        excel = epc.ExcelOp('尺寸整理表', 'FRAME15')
        parameter_name, parameter_value = excel.get_sheet_par('FRAME15', stamping_press_type)
        if stamping_press_type == 0:  # 25N
            mprog.activatefeature('Hole', 0)
            mprog.partbodyfeatureactivate('F')
        elif stamping_press_type == 1:  # 35N
            mprog.activatefeature('Hole', 0)
            mprog.partbodyfeatureactivate('F')
        elif stamping_press_type == 2:  # 45N
            mprog.activatefeature('Hole', 0)
            mprog.partbodyfeatureactivate('F')
        elif stamping_press_type == 3:  # 60N
            mprog.activatefeature('Hole', 0)
            # mprog.partbodyfeatureactivate('F')
        elif stamping_press_type == 4:  # 80N
            mprog.activatefeature('Hole', 0)
            # mprog.partbodyfeatureactivate('F')
        elif stamping_press_type == 5:  # 110N
            mprog.activatefeature('Hole', 0)
            mprog.partbodyfeatureactivate('F')
        elif stamping_press_type == 6:  # 160N
            mprog.activatefeature('Hole', 0)
            # mprog.partbodyfeatureactivate('F')
        elif stamping_press_type == 7:  # 200N
            mprog.activatefeature('Hole', 0)
            mprog.partbodyfeatureactivate('F')
        elif stamping_press_type == 8:  # 250N
            # mprog.partbodyfeatureactivate('SN1_200250')
            mprog.activatefeature('Hole', 0)
            mprog.partbodyfeatureactivate('F')
        mprog.Update()
    elif name == 'FRAME16':
        excel = epc.ExcelOp('尺寸整理表', 'FRAME16')
        parameter_name, parameter_value = excel.get_sheet_par('FRAME16', stamping_press_type)
        if stamping_press_type == 0:
            mprog.partbodyfeatureactivate('AB')
            mprog.partbodyfeatureactivate('SN1_25_45_CD')
            mprog.partbodyfeatureactivate('SN1_25_45_G')
            mprog.activatefeature('GIB_OIL_HOLE', 1)
            mprog.activatefeature('SLIDE_LINER_FIX_HOLE_1', 0)
            mprog.activatefeature('SLIDE_LINER_FIX_HOLE_2', 0)
            mprog.activatefeature('Hole_4', 0)
        elif stamping_press_type == 1:
            mprog.partbodyfeatureactivate('AB')
            mprog.activatefeature('GIB_OIL_HOLE', 1)
            mprog.activatefeature('SLIDE_LINER_FIX_HOLE_1', 0)
            mprog.activatefeature('SLIDE_LINER_FIX_HOLE_2', 0)
            mprog.activatefeature('Hole_4', 0)
        elif stamping_press_type == 2:
            mprog.partbodyfeatureactivate('AB')
            mprog.partbodyfeatureactivate('SN1_25_45_CD')
            mprog.partbodyfeatureactivate('SN1_25_45_G')
            mprog.activatefeature('GIB_OIL_HOLE', 1)
            mprog.activatefeature('SLIDE_LINER_FIX_HOLE_1', 0)
            mprog.activatefeature('SLIDE_LINER_FIX_HOLE_2', 0)
            mprog.activatefeature('Hole_4', 0)
        elif stamping_press_type == 3:
            mprog.partbodyfeatureactivate('AB')
            mprog.activatefeature('GIB_OIL_HOLE', 1)
            mprog.activatefeature('SLIDE_LINER_FIX_HOLE_1', 0)
            mprog.activatefeature('SLIDE_LINER_FIX_HOLE_2', 0)
            mprog.activatefeature('Hole_4', 0)
        elif stamping_press_type == 4:
            mprog.partbodyfeatureactivate('AB')
            mprog.activatefeature('GIB_OIL_HOLE', 0)
            mprog.activatefeature('SLIDE_LINER_FIX_HOLE_1', 0)
            mprog.activatefeature('SLIDE_LINER_FIX_HOLE_2', 0)
            mprog.activatefeature('Hole_4', 0)
        elif stamping_press_type == 5:
            mprog.partbodyfeatureactivate('AB')
            mprog.activatefeature('GIB_OIL_HOLE', 0)
            mprog.activatefeature('SLIDE_LINER_FIX_HOLE_1', 0)
            mprog.activatefeature('SLIDE_LINER_FIX_HOLE_2', 0)
            mprog.activatefeature('Hole_4', 0)
        elif stamping_press_type == 6:
            mprog.partbodyfeatureactivate('AB')
            mprog.activatefeature('GIB_OIL_HOLE', 0)
            mprog.activatefeature('SLIDE_LINER_FIX_HOLE_1', 0)
            mprog.activatefeature('SLIDE_LINER_FIX_HOLE_2', 0)
            mprog.activatefeature('Hole_4', 0)
        elif stamping_press_type == 7:
            mprog.partbodyfeatureactivate('AB')
            mprog.activatefeature('GIB_OIL_HOLE', 0)
            mprog.activatefeature('SLIDE_LINER_FIX_HOLE_1', 0)
            mprog.activatefeature('SLIDE_LINER_FIX_HOLE_2', 0)
            mprog.activatefeature('Hole_4', 0)
        elif stamping_press_type == 8:
            mprog.partbodyfeatureactivate('AB')
            mprog.activatefeature('SLIDE_LINER_FIX_HOLE_1', 0)
            mprog.activatefeature('SLIDE_LINER_FIX_HOLE_2', 0)
            mprog.activatefeature('GIB_OIL_HOLE', 0)
            mprog.activatefeature('Hole_4', 0)
        mprog.Update()
    elif name == 'FRAME17':
        excel = epc.ExcelOp('尺寸整理表', 'FRAME17')
        parameter_name, parameter_value = excel.get_sheet_par('FRAME17', stamping_press_type)
        if stamping_press_type == 0:  # 25N
            mprog.activatefeature('inside_hole', 0)
            mprog.activatefeature('processing_h', 0)
            mprog.activatefeature('processing_i', 0)
            mprog.activatefeature('processing_m', 0)
            mprog.partbodyfeatureactivate("H")
            mprog.partbodyfeatureactivate("I")
        elif stamping_press_type == 1:  # 35N
            mprog.activatefeature('inside_hole', 0)
            mprog.activatefeature('processing_h', 0)
            mprog.activatefeature('processing_i', 0)
            mprog.activatefeature('processing_m', 0)
            mprog.partbodyfeatureactivate("H")
            mprog.partbodyfeatureactivate("I")
        elif stamping_press_type == 2:  # 45N
            mprog.activatefeature('inside_hole', 0)
            mprog.activatefeature('processing_h', 0)
            mprog.activatefeature('processing_i', 0)
            mprog.activatefeature('processing_m', 0)
            mprog.partbodyfeatureactivate("H")
            mprog.partbodyfeatureactivate("I")
        elif stamping_press_type == 3:  # 60N
            mprog.activatefeature('inside_hole', 0)
            mprog.activatefeature('processing_h', 0)
            mprog.activatefeature('processing_i', 0)
            mprog.activatefeature('processing_m', 0)
            mprog.partbodyfeatureactivate("H")
            mprog.partbodyfeatureactivate("I")
        elif stamping_press_type == 4:  # 80N
            mprog.activatefeature('inside_hole', 0)
            mprog.activatefeature('outside_hole', 0)
            mprog.activatefeature('outside_hole_E', 0)
            mprog.activatefeature('processing_h', 0)
            mprog.activatefeature('processing_i', 0)
            mprog.activatefeature('processing_m', 0)
            mprog.partbodyfeatureactivate("H")
            mprog.partbodyfeatureactivate("I")
        elif stamping_press_type == 5:  # 110N
            mprog.activatefeature('inside_hole', 0)
            mprog.activatefeature('outside_hole', 0)
            mprog.activatefeature('processing_h', 0)
            mprog.activatefeature('processing_i', 0)
            mprog.activatefeature('processing_m', 0)
            mprog.partbodyfeatureactivate("H")
            mprog.partbodyfeatureactivate("I")
        elif stamping_press_type == 6:  # 160N
            mprog.activatefeature('inside_hole', 0)
            mprog.activatefeature('outside_hole', 0)
            mprog.activatefeature('processing_h', 0)
            mprog.activatefeature('processing_i', 0)
            mprog.activatefeature('processing_m', 0)
            mprog.partbodyfeatureactivate("H")
            mprog.partbodyfeatureactivate("I")
        elif stamping_press_type == 7:  # 200N
            mprog.activatefeature('outside_hole_E', 0)
            mprog.activatefeature('processing_h', 0)
            mprog.activatefeature('processing_i', 0)
            mprog.activatefeature('processing_m', 0)
            mprog.partbodyfeatureactivate("H")
            mprog.partbodyfeatureactivate("I")
        elif stamping_press_type == 8:  # 250N
            mprog.partbodyfeatureactivate("250N")
            mprog.activatefeature('inside_hole', 0)
            mprog.activatefeature('outside_hole', 0)
            mprog.activatefeature('processing_h', 0)
            mprog.activatefeature('processing_i', 0)
            mprog.activatefeature('processing_m', 0)
            mprog.partbodyfeatureactivate("H")
            mprog.partbodyfeatureactivate("I")
        mprog.Update()
    elif name == 'FRAME18':
        excel = epc.ExcelOp('尺寸整理表', 'FRAME18')
        parameter_name, parameter_value = excel.get_sheet_par('FRAME18', stamping_press_type)
        if stamping_press_type == 0:
            mprog.partbodyfeatureactivate('Pad.2')
            mprog.partbodyfeatureactivate('HollowCylinder')
        elif stamping_press_type == 1:
            mprog.partbodyfeatureactivate('Pad.2')
            mprog.partbodyfeatureactivate('HollowCylinder')
        elif stamping_press_type == 2:
            mprog.partbodyfeatureactivate('Pad.2')
            mprog.partbodyfeatureactivate('HollowCylinder')
        elif stamping_press_type == 3:
            mprog.partbodyfeatureactivate('Pad.2')
            mprog.partbodyfeatureactivate('HollowCylinder')
        elif stamping_press_type == 4:
            mprog.partbodyfeatureactivate('Pad.2')
            mprog.partbodyfeatureactivate('HollowCylinder')
            mprog.partbodyfeatureactivate('EdgeFillet.1')
        elif stamping_press_type == 5:
            mprog.activatefeature('Hole.1', 0)
            mprog.partbodyfeatureactivate('EdgeFillet.1')
        elif stamping_press_type == 6:
            mprog.activatefeature('Hole.1', 0)
            mprog.partbodyfeatureactivate('EdgeFillet.1')
        elif stamping_press_type == 7:
            mprog.activatefeature('Hole.1', 0)
            mprog.partbodyfeatureactivate('EdgeFillet.1')
        elif stamping_press_type == 8:
            mprog.activatefeature('Hole.1', 0)
            mprog.partbodyfeatureactivate('EdgeFillet.1')
        mprog.Update()
    elif name == 'FRAME19':  # 已更改
        excel = epc.ExcelOp('尺寸整理表', 'FRAME19')
        parameter_name, parameter_value = excel.get_sheet_par('FRAME19', stamping_press_type)
        if stamping_press_type == 0:
            mprog.activatefeature('SN1_2545_Body', 6)
            mprog.partbodyfeatureactivate('SN1_25_X')
            mprog.partbodyfeatureactivate('SN1_2535_Y')
            mprog.partbodyfeatureactivate("machining_AI")
        elif stamping_press_type == 1:
            mprog.activatefeature('SN1_2545_Body', 6)
            mprog.partbodyfeatureactivate('SN1_2535_Y')
            mprog.partbodyfeatureactivate("SN1_3545_AD")
            mprog.partbodyfeatureactivate("machining_AI")
        elif stamping_press_type == 2:
            mprog.activatefeature('SN1_2545_Body', 6)
            mprog.partbodyfeatureactivate('SN1_45_Y')
            mprog.partbodyfeatureactivate('SN1_45_X')
            mprog.partbodyfeatureactivate("SN1_3545_AD")
            mprog.partbodyfeatureactivate("machining_AI")
        elif stamping_press_type == 3:
            mprog.activatefeature('SN1_60_Body', 8)
            mprog.partbodyfeatureactivate("machining_AI")
        elif stamping_press_type == 4:
            mprog.activatefeature('SN1_80110_Body', 5)
            mprog.partbodyfeatureactivate("machining_AI")
        elif stamping_press_type == 5:
            mprog.activatefeature('SN1_80110_Body', 5)
            mprog.partbodyfeatureactivate("machining_AI")
        elif stamping_press_type == 6:
            mprog.activatefeature('FRAME_SN1_160_Body', 0)
            mprog.activatefeature('FRAME_34_Hole_1', 0)
            mprog.partbodyfeatureactivate("machining_AI")
        elif stamping_press_type == 7:
            mprog.activatefeature('SN1_200_Body', 4)
            mprog.partbodyfeatureactivate("machining_AI")
        elif stamping_press_type == 8:
            mprog.activatefeature('SN1_250_Body', 3)
            mprog.partbodyfeatureactivate("machining_AI")
        mprog.Update()
    elif name == 'FRAME20':
        excel = epc.ExcelOp('尺寸整理表', 'FRAME20')
        parameter_name, parameter_value = excel.get_sheet_par('FRAME20', stamping_press_type)
        if stamping_press_type == 0:
            mprog.partbodyfeatureactivate('AB')
            mprog.activatefeature('MOTOR_FIX_ADJUSTMENT_HOLE', 0)
        elif stamping_press_type == 1:
            mprog.partbodyfeatureactivate('AB')
            mprog.activatefeature('MOTOR_FIX_ADJUSTMENT_HOLE', 0)
        elif stamping_press_type == 2:
            mprog.partbodyfeatureactivate('AB')
            mprog.activatefeature('MOTOR_FIX_ADJUSTMENT_HOLE', 0)
        elif stamping_press_type == 3:
            mprog.partbodyfeatureactivate('AB')
            mprog.partbodyfeatureactivate('SN1_60250_C')
            mprog.activatefeature('MOTOR_FIX_ADJUSTMENT_HOLE', 0)
        elif stamping_press_type == 4:
            mprog.partbodyfeatureactivate('AB')
            mprog.partbodyfeatureactivate('SN1_60250_C')
            mprog.partbodyfeatureactivate('SN1_80250_DEF')
            mprog.partbodyfeatureactivate('SN1_80250_G')
            mprog.activatefeature('MOTOR_FIX_ADJUSTMENT_HOLE', 0)
        elif stamping_press_type == 5:
            mprog.partbodyfeatureactivate('AB')
            mprog.partbodyfeatureactivate('SN1_60250_C')
            mprog.partbodyfeatureactivate('SN1_80250_DEF')
            mprog.partbodyfeatureactivate('SN1_80250_G')
            mprog.partbodyfeatureactivate('SN1_110160_ijk')
            mprog.activatefeature('Hole_2', 0)
        elif stamping_press_type == 6:
            mprog.partbodyfeatureactivate('AB')
            mprog.partbodyfeatureactivate('SN1_60250_C')
            mprog.partbodyfeatureactivate('SN1_80250_DEF')
            mprog.partbodyfeatureactivate('SN1_80250_G')
            mprog.partbodyfeatureactivate('SN1_110160_ijk')
            mprog.activatefeature('Hole_2', 0)
        elif stamping_press_type == 7:
            mprog.partbodyfeatureactivate('AB')
            mprog.partbodyfeatureactivate('SN1_60250_C')
            mprog.partbodyfeatureactivate('SN1_80250_DEF')
            mprog.partbodyfeatureactivate('SN1_80250_G')
            mprog.partbodyfeatureactivate('SN1_200250_hij')
            mprog.activatefeature('Hole_2', 1)
        elif stamping_press_type == 8:
            mprog.partbodyfeatureactivate('AB')
            mprog.partbodyfeatureactivate('SN1_60250_C')
            mprog.partbodyfeatureactivate('SN1_80250_DEF')
            mprog.partbodyfeatureactivate('SN1_80250_G')
            mprog.partbodyfeatureactivate('SN1_200250_hij')
            mprog.activatefeature('Hole_2', 1)
        mprog.Update()
    elif name == 'FRAME21':
        excel = epc.ExcelOp('尺寸整理表', 'FRAME21')
        parameter_name, parameter_value = excel.get_sheet_par('FRAME21', stamping_press_type)
        mprog.partdeactivate("H")
        if stamping_press_type == 0:  # 25
            mprog.activatefeature('Hole', 0)
        elif stamping_press_type == 1:  # 35
            mprog.activatefeature('Hole', 0)
        mprog.Update()
    elif name == 'FRAME22':
        excel = epc.ExcelOp('尺寸整理表', 'FRAME22')
        parameter_name, parameter_value = excel.get_sheet_par('FRAME22', stamping_press_type)
        if stamping_press_type == 0:
            mprog.partbodyfeatureactivate('A(1)D')
            mprog.partbodyfeatureactivate('SN1-2560_BE')
            mprog.partbodyfeatureactivate('SN1_2545_I')
            mprog.activatefeature('OPERATION_BOX_FIX_HOLE', 0)
            mprog.activatefeature('SN1_2560_6_M8X16L_底孔27L', 0)
        elif stamping_press_type == 1:
            mprog.partbodyfeatureactivate('A(1)D')
            mprog.partbodyfeatureactivate('SN1-2560_BE')
            mprog.partbodyfeatureactivate('SN1_2545_I')
            mprog.activatefeature('OPERATION_BOX_FIX_HOLE', 0)
            mprog.activatefeature('SN1_2560_6_M8X16L_底孔27L', 0)
        elif stamping_press_type == 2:
            mprog.partbodyfeatureactivate('A(1)D')
            mprog.partbodyfeatureactivate('SN1-2560_BE')
            mprog.partbodyfeatureactivate('SN1_2545_I')
            mprog.activatefeature('OPERATION_BOX_FIX_HOLE', 0)
            mprog.activatefeature('SN1_2560_6_M8X16L_底孔27L', 0)
        elif stamping_press_type == 3:
            mprog.partbodyfeatureactivate('A(1)D')
            mprog.partbodyfeatureactivate('A(2)')
            mprog.partbodyfeatureactivate('SN1-2560_BE')
            mprog.partbodyfeatureactivate('SN1_60_I')
            mprog.activatefeature('OPERATION_BOX_FIX_HOLE', 0)
            mprog.activatefeature('Hole_3', 0)
            mprog.activatefeature('SN1_2560_6_M8X16L_底孔27L', 0)
        elif stamping_press_type == 4:
            mprog.partbodyfeatureactivate('SN1_80250_A(1)D')
            mprog.partbodyfeatureactivate('A(2)')
            mprog.partbodyfeatureactivate('SN1_80250_FEBC')
            mprog.partbodyfeatureactivate('SN1_80250_IN')
            mprog.activatefeature('OPERATION_BOX_FIX_HOLE', 0)
            mprog.activatefeature('SN1_80250_6_M8X16L_底孔27L', 0)
            mprog.activatefeature('Hole_3', 0)
        elif stamping_press_type == 5:
            mprog.partbodyfeatureactivate('SN1_80250_A(1)D')
            mprog.partbodyfeatureactivate('A(2)')
            mprog.partbodyfeatureactivate('SN1_80250_FEBC')
            mprog.partbodyfeatureactivate('SN1_80250_IN')
            mprog.activatefeature('OPERATION_BOX_FIX_HOLE', 0)
            mprog.activatefeature('SN1_80250_6_M8X16L_底孔27L', 0)
            mprog.activatefeature('Hole_3', 0)
        elif stamping_press_type == 6:
            mprog.partbodyfeatureactivate('SN1_80250_A(1)D')
            mprog.partbodyfeatureactivate('A(2)')
            mprog.partbodyfeatureactivate('SN1_80250_FEBC')
            mprog.partbodyfeatureactivate('SN1_80250_IN')
            mprog.activatefeature('OPERATION_BOX_FIX_HOLE', 0)
            mprog.activatefeature('SN1_80250_6_M8X16L_底孔27L', 0)
            mprog.activatefeature('Hole_3', 0)
        elif stamping_press_type == 7:
            mprog.partbodyfeatureactivate('SN1_80250_A(1)D')
            mprog.partbodyfeatureactivate('A(2)')
            mprog.partbodyfeatureactivate('SN1_80250_FEBC')
            mprog.partbodyfeatureactivate('SN1_80250_IN')
            mprog.activatefeature('OPERATION_BOX_FIX_HOLE', 0)
            mprog.activatefeature('SN1_80250_6_M8X16L_底孔27L', 0)
            mprog.activatefeature('Hole_3', 0)
        elif stamping_press_type == 8:
            mprog.partbodyfeatureactivate('SN1_80250_A(1)D')
            mprog.partbodyfeatureactivate('A(2)')
            mprog.partbodyfeatureactivate('SN1_80250_FEBC')
            mprog.partbodyfeatureactivate('SN1_80250_IN')
            mprog.activatefeature('OPERATION_BOX_FIX_HOLE', 0)
            mprog.activatefeature('SN1_80250_6_M8X16L_底孔27L', 0)
            mprog.activatefeature('Hole_3', 0)
        mprog.Update()
    elif name == 'FRAME23':
        excel = epc.ExcelOp('尺寸整理表', 'FRAME23')
        parameter_name, parameter_value = excel.get_sheet_par('FRAME23', stamping_press_type)
        if stamping_press_type == 0:
            mprog.partbodyfeatureactivate('25至60除料')
            mprog.partbodyfeatureactivate('25至60導圓角')
        elif stamping_press_type == 1:
            mprog.partbodyfeatureactivate('25至60除料')
            mprog.partbodyfeatureactivate('25至60導圓角')
        elif stamping_press_type == 2:
            mprog.partbodyfeatureactivate('25至60除料')
            mprog.partbodyfeatureactivate('25至60導圓角')
        elif stamping_press_type == 3:
            mprog.partbodyfeatureactivate('25至60除料')
            mprog.partbodyfeatureactivate('25至60導圓角')
        elif stamping_press_type == 4:
            mprog.partbodyfeatureactivate('80至250除料')
            mprog.partbodyfeatureactivate('80至250導圓角(除160和200)')
        elif stamping_press_type == 5:
            mprog.partbodyfeatureactivate('80至250除料')
            mprog.partbodyfeatureactivate('80至250導圓角(除160和200)')
        elif stamping_press_type == 6:
            mprog.partbodyfeatureactivate('80至250除料')
        elif stamping_press_type == 7:
            mprog.partbodyfeatureactivate('80至250除料')
        elif stamping_press_type == 8:
            mprog.partbodyfeatureactivate('80至250除料')
            mprog.partbodyfeatureactivate('80至250導圓角(除160和200)')
        mprog.Update()
    elif name == 'FRAME23_1':
        excel = epc.ExcelOp('尺寸整理表', 'FRAME23_1')
        parameter_name, parameter_value = excel.get_sheet_par('FRAME23_1', stamping_press_type)
        if stamping_press_type == 0:
            mprog.partbodyfeatureactivate('25至60除料')
            mprog.partbodyfeatureactivate('25至60導圓角')
        elif stamping_press_type == 1:
            mprog.partbodyfeatureactivate('25至60除料')
            mprog.partbodyfeatureactivate('25至60導圓角')
        elif stamping_press_type == 2:
            mprog.partbodyfeatureactivate('25至60除料')
            mprog.partbodyfeatureactivate('25至60導圓角')
        elif stamping_press_type == 3:
            mprog.partbodyfeatureactivate('25至60除料')
            mprog.partbodyfeatureactivate('25至60導圓角')
        elif stamping_press_type == 4:
            mprog.partbodyfeatureactivate('80至250除料')
            mprog.partbodyfeatureactivate('80至250導圓角(除160和200)')
        elif stamping_press_type == 5:
            mprog.partbodyfeatureactivate('80至250除料')
            mprog.partbodyfeatureactivate('80至250導圓角(除160和200)')
        elif stamping_press_type == 6:
            mprog.partbodyfeatureactivate('80至250除料')
        elif stamping_press_type == 7:
            mprog.partbodyfeatureactivate('80至250除料')
        elif stamping_press_type == 8:
            mprog.partbodyfeatureactivate('80至250除料')
            mprog.partbodyfeatureactivate('80至250導圓角(除160和200)')
        mprog.Update()
    elif name == 'FRAME24':
        excel = epc.ExcelOp('尺寸整理表', 'FRAME24')
        parameter_name, parameter_value = excel.get_sheet_par(
                'FRAME24', stamping_press_type)
        if stamping_press_type == 0:
            mprog.partbodyfeatureactivate('Pad.2')
            mprog.activatefeature('M5', 0)
            mprog.partbodyfeatureactivate('machining_bbbbb')
            mprog.partbodyfeatureactivate('machining_bbbbb_2')
            mprog.activatefeature('machining_Hole_1', 0)
        elif stamping_press_type == 1:
            mprog.partbodyfeatureactivate('Pad.2')
            mprog.activatefeature('M5', 0)
            mprog.partbodyfeatureactivate('machining_bbbbb')
            mprog.partbodyfeatureactivate('machining_bbbbb_2')
            mprog.activatefeature('machining_Hole_1', 0)
        elif stamping_press_type == 2:
            mprog.partbodyfeatureactivate('Pad.2')
            mprog.activatefeature('M5', 0)
            mprog.partbodyfeatureactivate('machining_bbbbb')
            mprog.partbodyfeatureactivate('machining_bbbbb_2')
            mprog.activatefeature('machining_Hole_1', 0)
        elif stamping_press_type == 3:
            mprog.partbodyfeatureactivate('Pad.2')
            mprog.activatefeature('M5', 0)
            mprog.partbodyfeatureactivate('machining_bbbbb')
            mprog.partbodyfeatureactivate('machining_bbbbb_2')
            mprog.activatefeature('machining_Hole_1', 0)
        elif stamping_press_type == 4:
            mprog.partbodyfeatureactivate('Pad.2')
            mprog.activatefeature('M5', 0)
            mprog.partbodyfeatureactivate('machining_bbbbb')
            mprog.partbodyfeatureactivate('machining_bbbbb_2')
            mprog.activatefeature('machining_Hole_1', 0)
        elif stamping_press_type == 5:
            mprog.partbodyfeatureactivate('Pad.2')
            mprog.activatefeature('M5', 0)
            mprog.partbodyfeatureactivate('machining_bbbbb')
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
            mprog.partbodyfeatureactivate('machining_aaaaa2')
        elif stamping_press_type == 3:
            mprog.partbodyfeatureactivate('Pocket.1')
            mprog.activatefeature('Hole', 0)
            mprog.activatefeature('Piping', 0)
            mprog.activatefeature('machining_ddddd', 0)
            mprog.partbodyfeatureactivate('machining_aaaaa2')
        mprog.Update()
    elif name == 'FRAME27_1':
        excel = epc.ExcelOp('尺寸整理表', 'FRAME27_1')
        parameter_name, parameter_value = excel.get_sheet_par('FRAME27_1', stamping_press_type)
        if stamping_press_type == 0:
            mprog.partbodyfeatureactivate('35N前')
            mprog.activatefeature('Hole', 0)
            mprog.activatefeature('Piping', 0)
            mprog.partbodyfeatureactivate('machining_aaaaa2')
        elif stamping_press_type == 1:
            mprog.partbodyfeatureactivate('35N前')
            mprog.activatefeature('Hole', 0)
            mprog.activatefeature('Piping', 0)
            mprog.partbodyfeatureactivate('machining_aaaaa2')
        elif stamping_press_type == 2:
            mprog.partbodyfeatureactivate('Pocket.1')
            mprog.activatefeature('Hole', 0)
            mprog.activatefeature('Piping', 0)
            mprog.activatefeature('machining_ddddd', 0)
            mprog.partbodyfeatureactivate('machining_aaaaa2')
        elif stamping_press_type == 3:
            mprog.partbodyfeatureactivate('Pocket.1')
            mprog.activatefeature('Hole', 0)
            mprog.activatefeature('Piping', 0)
            mprog.activatefeature('machining_ddddd', 0)
            mprog.partbodyfeatureactivate('machining_aaaaa2')
        mprog.Update()
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
