sinje0816/stamping_press/SYEI_stamping_press_system/DEMO.py

from PyQt5 import QtCore, QtGui, QtWidgets
from PyQt5.QtWidgets import QVBoxLayout, QWidget, QPushButton, QLabel, QTableWidgetItem, QHeaderView, QComboBox, QAbstractItemView, QMessageBox, QHBoxLayout, QLineEdit, QCheckBox
from PyQt5.QtCore import Qt
from PyQt5.QtGui import QColor, QBrush, QPixmap, QFont
from DEMOGUI import Ui_Dialog
from PAD_main import Ui_Form as pad_main_Form
from PAD_MACHINING import Ui_Form as pad_machining_Form
from PAD_dimension import Ui_Form as pad_dimension_Form
from pad_feeding_hole import Ui_Form as pad_feeding_hole_Form
from cutout_hole_GUI import Ui_Form as cutout_hole_machining_form
from plate_main_first import Ui_Form as plate_main_first_form
from pad_main_simple import Ui_Form as pad_main_simple_form
from slide_main_simple import Ui_Form as slide_main_form
from slide_main import Ui_Form as slide_secend_form
from window_main import Ui_Form
from select_item import Ui_Form as select_item_form
from io import StringIO
import main_program as mprog
import file_path as fp
import parameter as par
import Assmebly_design as Ad
import machining_part_TYPE_change as mptc
import welding_part_TYPE_change as wptc
import excel_parameter_change as epc
import parameter_design_part as pdp
import interference as itf
import test_T as tT
import sys
import datetime
import os
import time
import traceback
import check as ch
import STP_input as S_i

par.test_stop = False

class main(QtWidgets.QWidget, Ui_Form):
    def __init__(self):
        super(main, self).__init__()
        self.ui = Ui_Form()
        self.ui.setupUi(self)
        self.setWindowTitle('沖床自動化設計系統')
        self.setting()
        self.ui.start.clicked.connect(self.start)
        self.previous_value()

    def setting(self):
        # 设置额外的宽度和高度来容纳其他界面元素
        extra_width = 800
        extra_height = 150
        # 获取表格的大小
        table_size = self.ui.window_main_table.size()
        # 设置窗口的大小为表格大小加上额外的宽度和高度
        self.setFixedSize(table_size.width() + extra_width, table_size.height() + extra_height)
        window_size = self.size()
        # 调整表格的大小以填充整个窗口
        self.ui.window_main_table.setGeometry(0, 0, window_size.width(), window_size.height())
        for x in range(0, 2):
            self.ui.window_main_table.setSpan(x, 0, 1, 5) #以某格為基準向下向右合併儲存格
            newItem = QTableWidgetItem(par.series1[x]) #儲存格內文字
            newItem.setTextAlignment(Qt.AlignHCenter | Qt.AlignVCenter) #設定置中
            newItem.setFlags(newItem.flags() & ~Qt.ItemIsEditable) #不可編輯化
            self.ui.window_main_table.setItem(x, 0, newItem) #指定文字放置位置
        for x in range(2, 8):
            self.ui.window_main_table.setSpan(x, 0, 1, 3)
            newItem = QTableWidgetItem(par.series2[x-2])
            newItem.setTextAlignment(Qt.AlignHCenter | Qt.AlignVCenter)
            newItem.setFlags(newItem.flags() & ~Qt.ItemIsEditable)
            self.ui.window_main_table.setItem(x, 0, newItem)
        for x in range(2, 6):
            self.ui.window_main_table.setSpan(x, 3, 1, 2)
        combo_box_unit = QComboBox()
        combo_box_unit.setEditable(False)
        combo_box_unit.addItem('公制')
        combo_box_unit.addItem('英制')
        self.ui.window_main_table.setCellWidget(2, 3, combo_box_unit)
        combo_box_law = QComboBox()
        combo_box_law.setEditable(False)
        combo_box_law.addItem('一般內銷')
        combo_box_law.addItem('一般外銷')
        combo_box_law.addItem('美國(ASME)')
        combo_box_law.addItem('加拿大')
        combo_box_law.addItem('巴西')
        combo_box_law.addItem('歐洲(CE)')
        self.ui.window_main_table.setCellWidget(3, 3, combo_box_law)
        combo_box_machine = QComboBox()
        combo_box_machine.setEditable(False)
        combo_box_machine.addItem('SN1-25')
        combo_box_machine.addItem('SN1-35')
        combo_box_machine.addItem('SN1-45')
        combo_box_machine.addItem('SN1-60')
        combo_box_machine.addItem('SN1-80')
        combo_box_machine.addItem('SN1-110')
        combo_box_machine.addItem('SN1-160')
        combo_box_machine.addItem('SN1-200')
        combo_box_machine.addItem('SN1-250')
        self.ui.window_main_table.setCellWidget(4, 3, combo_box_machine)
        combo_box_type = QComboBox()
        combo_box_type.setEditable(False)
        combo_box_type.addItem('S')
        combo_box_type.addItem('H')
        combo_box_type.addItem('P')
        self.ui.window_main_table.setCellWidget(5, 3, combo_box_type)
        plate_setup = QPushButton('設定') #括號內為按鈕名稱
        self.ui.window_main_table.setCellWidget(6, 3, plate_setup)
        slide_setup = QPushButton('設定')
        self.ui.window_main_table.setCellWidget(7, 3, slide_setup)
        pad_finish = QtWidgets.QLabel('未設定')
        pad_finish.setAlignment(Qt.AlignHCenter | Qt.AlignVCenter)
        self.ui.window_main_table.setCellWidget(6, 4, pad_finish)
        slide_finish = QtWidgets.QLabel('未設定')
        slide_finish.setAlignment(Qt.AlignHCenter | Qt.AlignVCenter)
        self.ui.window_main_table.setCellWidget(7, 4, slide_finish)
        for x in range(8, 12):
            self.ui.window_main_table.setSpan(x, 0, 1, 2)
            newItem = QTableWidgetItem(par.series3[x - 8])
            newItem.setTextAlignment(Qt.AlignHCenter | Qt.AlignVCenter)
            newItem.setFlags(newItem.flags() & ~Qt.ItemIsEditable)
            self.ui.window_main_table.setItem(x, 0, newItem)
        self.ui.window_main_table.setSpan(12, 0, 2, 1)
        newItem = QTableWidgetItem('主馬達')
        newItem.setTextAlignment(Qt.AlignHCenter | Qt.AlignVCenter)
        newItem.setFlags(newItem.flags() & ~Qt.ItemIsEditable)
        self.ui.window_main_table.setItem(12, 0, newItem)
        self.ui.window_main_table.setSpan(14, 0, 2, 1)
        newItem = QTableWidgetItem('變頻器')
        newItem.setTextAlignment(Qt.AlignHCenter | Qt.AlignVCenter)
        newItem.setFlags(newItem.flags() & ~Qt.ItemIsEditable)
        self.ui.window_main_table.setItem(14, 0, newItem)
        for x in range(12, 16):
            newItem = QTableWidgetItem(par.series4[x - 12])
            newItem.setTextAlignment(Qt.AlignHCenter | Qt.AlignVCenter)
            newItem.setFlags(newItem.flags() & ~Qt.ItemIsEditable)
            self.ui.window_main_table.setItem(x, 1, newItem)
        self.ui.window_main_table.setSpan(16, 0, 2, 2)
        newItem = QTableWidgetItem('上模吊重')
        newItem.setTextAlignment(Qt.AlignHCenter | Qt.AlignVCenter)
        newItem.setFlags(newItem.flags() & ~Qt.ItemIsEditable)
        self.ui.window_main_table.setItem(16, 0, newItem)
        self.ui.window_main_table.setSpan(18, 0, 2, 1)
        newItem = QTableWidgetItem('防震腳')
        newItem.setTextAlignment(Qt.AlignHCenter | Qt.AlignVCenter)
        newItem.setFlags(newItem.flags() & ~Qt.ItemIsEditable)
        self.ui.window_main_table.setItem(18, 0, newItem)
        newItem = QTableWidgetItem('廠牌')
        newItem.setTextAlignment(Qt.AlignHCenter | Qt.AlignVCenter)
        newItem.setFlags(newItem.flags() & ~Qt.ItemIsEditable)
        self.ui.window_main_table.setItem(18, 1, newItem)
        newItem = QTableWidgetItem('規格')
        newItem.setTextAlignment(Qt.AlignHCenter | Qt.AlignVCenter)
        newItem.setFlags(newItem.flags() & ~Qt.ItemIsEditable)
        self.ui.window_main_table.setItem(19, 1, newItem)
        for x in range(20, 22):
            self.ui.window_main_table.setSpan(x, 0, 1, 2)
            newItem = QTableWidgetItem(par.series5[x - 20])
            newItem.setTextAlignment(Qt.AlignHCenter | Qt.AlignVCenter)
            newItem.setFlags(newItem.flags() & ~Qt.ItemIsEditable)
            self.ui.window_main_table.setItem(x, 0, newItem)
        for x in range(22, 24):
            self.ui.window_main_table.setSpan(x, 0, 1, 3)
            newItem = QTableWidgetItem(par.series6[x - 22])
            newItem.setTextAlignment(Qt.AlignHCenter | Qt.AlignVCenter)
            newItem.setFlags(newItem.flags() & ~Qt.ItemIsEditable)
            self.ui.window_main_table.setItem(x, 0, newItem)
        self.ui.window_main_table.setSpan(16, 2, 2, 1)
        for x in range(8, 17):
            newItem = QTableWidgetItem(par.series7[x - 8])
            newItem.setTextAlignment(Qt.AlignHCenter | Qt.AlignVCenter)
            newItem.setFlags(newItem.flags() & ~Qt.ItemIsEditable)
            self.ui.window_main_table.setItem(x, 2, newItem)
        for x in range(18, 22):
            newItem = QTableWidgetItem(par.series8[x - 18])
            newItem.setTextAlignment(Qt.AlignHCenter | Qt.AlignVCenter)
            newItem.setFlags(newItem.flags() & ~Qt.ItemIsEditable)
            self.ui.window_main_table.setItem(x, 2, newItem)
        newItem = QTableWidgetItem('標準')
        newItem.setTextAlignment(Qt.AlignHCenter | Qt.AlignVCenter)
        newItem.setFlags(newItem.flags() & ~Qt.ItemIsEditable)
        self.ui.window_main_table.setItem(8, 3, newItem)
        newItem = QTableWidgetItem('客戶自訂')
        newItem.setTextAlignment(Qt.AlignHCenter | Qt.AlignVCenter)
        newItem.setFlags(newItem.flags() & ~Qt.ItemIsEditable)
        self.ui.window_main_table.setItem(8, 4, newItem)
        slide_stroke = QTableWidgetItem('80')
        slide_stroke.setTextAlignment(Qt.AlignHCenter | Qt.AlignVCenter)
        slide_stroke.setFlags(slide_stroke.flags() & ~Qt.ItemIsEditable)
        self.ui.window_main_table.setItem(9, 3, slide_stroke)
        slide_cycle = QTableWidgetItem('70~110')
        slide_cycle.setTextAlignment(Qt.AlignHCenter | Qt.AlignVCenter)
        slide_cycle.setFlags(slide_cycle.flags() & ~Qt.ItemIsEditable)
        self.ui.window_main_table.setItem(10, 3, slide_cycle)
        slide_DH = QTableWidgetItem('230')
        slide_DH.setTextAlignment(Qt.AlignHCenter | Qt.AlignVCenter)
        slide_DH.setFlags(slide_DH.flags() & ~Qt.ItemIsEditable)
        self.ui.window_main_table.setItem(11, 3, slide_DH)
        motor_company = QTableWidgetItem('東元')
        motor_company.setTextAlignment(Qt.AlignHCenter | Qt.AlignVCenter)
        motor_company.setFlags(motor_company.flags() & ~Qt.ItemIsEditable)
        self.ui.window_main_table.setItem(12, 3, motor_company)
        motor_power = QTableWidgetItem('3.7×4')
        motor_power.setTextAlignment(Qt.AlignHCenter | Qt.AlignVCenter)
        motor_power.setFlags(motor_power.flags() & ~Qt.ItemIsEditable)
        self.ui.window_main_table.setItem(13, 3, motor_power)
        frequency_company = QTableWidgetItem('東元')
        frequency_company.setTextAlignment(Qt.AlignHCenter | Qt.AlignVCenter)
        frequency_company.setFlags(frequency_company.flags() & ~Qt.ItemIsEditable)
        self.ui.window_main_table.setItem(14, 3, frequency_company)
        frequency_power = QTableWidgetItem('3.7×4')
        frequency_power.setTextAlignment(Qt.AlignHCenter | Qt.AlignVCenter)
        frequency_power.setFlags(frequency_power.flags() & ~Qt.ItemIsEditable)
        self.ui.window_main_table.setItem(15, 3, frequency_power)
        upper_kg = QTableWidgetItem('54')
        upper_kg.setTextAlignment(Qt.AlignHCenter | Qt.AlignVCenter)
        upper_kg.setFlags(upper_kg.flags() & ~Qt.ItemIsEditable)
        self.ui.window_main_table.setItem(16, 3, upper_kg)
        for x in range(17, 22):
            self.ui.window_main_table.setSpan(x, 3, 1, 2)
        upper_extra = QTableWidgetItem('PC加大型平衡汽缸')
        upper_extra.setTextAlignment(Qt.AlignHCenter | Qt.AlignVCenter)
        upper_extra.setFlags(upper_extra.flags() & ~Qt.ItemIsEditable)
        self.ui.window_main_table.setItem(17, 3, upper_extra)
        shockproof_company = QComboBox()
        shockproof_company.setEditable(False)
        shockproof_company.addItem('無')
        shockproof_company.addItem('穎益')
        shockproof_company.addItem('UNISORB')
        shockproof_company.addItem('商定')
        self.ui.window_main_table.setCellWidget(18, 3, shockproof_company)
        shockproof_size = QTableWidgetItem('_')
        shockproof_size.setTextAlignment(Qt.AlignHCenter | Qt.AlignVCenter)
        shockproof_size.setFlags(shockproof_size.flags() & ~Qt.ItemIsEditable)
        self.ui.window_main_table.setItem(19, 3, shockproof_size)
        work_height = QTableWidgetItem('800')
        work_height.setTextAlignment(Qt.AlignHCenter | Qt.AlignVCenter)
        work_height.setFlags(work_height.flags() & ~Qt.ItemIsEditable)
        self.ui.window_main_table.setItem(20, 3, work_height)
        power = QComboBox()
        power.setEditable(False)
        power.addItem('200Vx50Hz')
        power.addItem('200Vx60Hz')
        power.addItem('220Vx50Hz')
        power.addItem('220Vx60Hz')
        power.addItem('380Vx50Hz')
        power.addItem('380Vx60Hz')
        power.addItem('415Vx50Hz')
        power.addItem('440Vx60Hz')
        power.addItem('460Vx60Hz')
        power.addItem('480Vx60Hz')
        power.addItem('575Vx60Hz')
        self.ui.window_main_table.setCellWidget(21, 3, power)
        select_setup = QPushButton('設定')
        self.ui.window_main_table.setCellWidget(22, 3, select_setup)
        spare_parts_setup = QPushButton('設定')
        self.ui.window_main_table.setCellWidget(23, 3, spare_parts_setup)
        select_finish = QtWidgets.QLabel('未設定')
        select_finish.setAlignment(Qt.AlignHCenter | Qt.AlignVCenter)
        self.ui.window_main_table.setCellWidget(22, 4, select_finish)
        spare_parts_finish = QtWidgets.QLabel('未設定')
        spare_parts_finish.setAlignment(Qt.AlignHCenter | Qt.AlignVCenter)
        self.ui.window_main_table.setCellWidget(23, 4, spare_parts_finish)
        slide_stroke_customize = QLineEdit('')
        slide_stroke_customize.setAlignment(Qt.AlignHCenter | Qt.AlignVCenter)
        slide_stroke_customize.setStyleSheet('background-color:#ffe4c4;') # 背景色
        self.ui.window_main_table.setCellWidget(9, 4, slide_stroke_customize)
        slide_cycle_customize = QLineEdit('')
        slide_cycle_customize.setAlignment(Qt.AlignHCenter | Qt.AlignVCenter)
        slide_cycle_customize.setStyleSheet('background-color:#ffe4c4;')
        self.ui.window_main_table.setCellWidget(10, 4, slide_cycle_customize)
        slide_DH_customize = QLineEdit('')
        slide_DH_customize.setAlignment(Qt.AlignHCenter | Qt.AlignVCenter)
        slide_DH_customize.setStyleSheet('background-color:#ffe4c4;')
        self.ui.window_main_table.setCellWidget(11, 4, slide_DH_customize)
        motor_company_customize = QLineEdit('')
        motor_company_customize.setAlignment(Qt.AlignHCenter | Qt.AlignVCenter)
        motor_company_customize.setStyleSheet('background-color:#ffe4c4;')
        self.ui.window_main_table.setCellWidget(12, 4, motor_company_customize)
        motor_power_customize = QLineEdit('')
        motor_power_customize.setAlignment(Qt.AlignHCenter | Qt.AlignVCenter)
        motor_power_customize.setStyleSheet('background-color:#ffe4c4;')
        self.ui.window_main_table.setCellWidget(13, 4, motor_power_customize)
        frequency_company_customize = QLineEdit('')
        frequency_company_customize.setAlignment(Qt.AlignHCenter | Qt.AlignVCenter)
        frequency_company_customize.setStyleSheet('background-color:#ffe4c4;')
        self.ui.window_main_table.setCellWidget(14, 4, frequency_company_customize)
        frequency_power_customize = QLineEdit('')
        frequency_power_customize.setAlignment(Qt.AlignHCenter | Qt.AlignVCenter)
        frequency_power_customize.setStyleSheet('background-color:#ffe4c4;')
        self.ui.window_main_table.setCellWidget(15, 4, frequency_power_customize)
        upper_kg_customize = QLineEdit('')
        upper_kg_customize.setAlignment(Qt.AlignHCenter | Qt.AlignVCenter)
        upper_kg_customize.setStyleSheet('background-color:#ffe4c4;')
        self.ui.window_main_table.setCellWidget(16, 4, upper_kg_customize)

        self.ui.window_main_table.setSpan(0, 5, 24, 9)

        # 在初始化函数中创建 QWidget 和 QLabel
        machine_picture_widget = QWidget()
        machine_picture = QLabel(machine_picture_widget)

        # 加载图像
        pixmap = QPixmap('machine_picture.png')
        machine_picture.setPixmap(pixmap)

        scaled_pixmap = pixmap.scaled(pixmap.width()-100, pixmap.height()-110)
        machine_picture.setPixmap(scaled_pixmap)

        # # 设置 QLabel 居中
        machine_picture.setAlignment(Qt.AlignCenter)

        # 添加 QLabel 到 QWidget
        machine_picture_layout = QVBoxLayout()
        machine_picture_layout.addWidget(machine_picture)
        machine_picture_widget.setLayout(machine_picture_layout)

        # 将 QWidget 添加到表格单元格
        self.ui.window_main_table.setCellWidget(0, 5, machine_picture_widget)
        # 将 QLabel 添加到表格单元格
        self.ui.window_main_table.setCellWidget(0, 5, machine_picture)
        # 创建一个 QWidget 作为容器
        button_container = QWidget()
        button_layout = QHBoxLayout()  # 创建一个水平布局对象
        button_container.setLayout(button_layout)  # 将布局附加到button_container上

        self.ui.window_main_table.cellWidget(2, 3).currentIndexChanged.connect(lambda :self.unit_change())
        self.ui.window_main_table.cellWidget(4, 3).currentIndexChanged.connect(lambda :self.choose_stamping_press_type())
        self.ui.window_main_table.cellWidget(5, 3).currentIndexChanged.connect(lambda :self.choose_stamping_press_type())
        self.ui.window_main_table.cellWidget(9, 4).textChanged.connect(lambda :self.customize_typing('stroke'))
        self.ui.window_main_table.cellWidget(10, 4).textChanged.connect(lambda :self.customize_typing('cycle'))
        self.ui.window_main_table.cellWidget(11, 4).textChanged.connect(lambda :self.customize_typing('DH'))


        plate_setup.clicked.connect(lambda:self.switch_to_plate(par.stamping_press_type))
        slide_setup.clicked.connect(lambda :self.switch_to_slide(par.stamping_press_type))
        select_setup.clicked.connect(lambda: self.switch_to_select_item())
        # spare_parts_setup.clicked.connect()

        # 若平板或沖頭按下完成設定，則將按鈕設定為不可按及改為綠色和顯示已完成
        if par.plate_finish == True:
            # 文字設定
            plate_finish = QtWidgets.QLabel('已完成')
            plate_finish.setEnabled(False)
            plate_finish.setStyleSheet('font-family: "微軟正黑體"; font-size: 12px; background-color:#7fff00;')
            plate_finish.setAlignment(Qt.AlignHCenter | Qt.AlignVCenter)
            self.ui.window_main_table.setCellWidget(6, 4, plate_finish)
            # 按鈕設定
            plate_setup = QtWidgets.QPushButton('設定')
            plate_setup.setStyleSheet('font-family: "微軟正黑體"; font-size: 12px; background-color:#7fff00;')
            plate_setup.setEnabled(False)  # 使按鈕不可操作
            plate_setup.setFlat(True)  # 使按鈕不顯示為可按下的外觀
            self.ui.window_main_table.setCellWidget(6, 3, plate_setup)
        if par.slide_finish == True:
            # 文字設定
            slide_finish = QtWidgets.QLabel('已完成')
            slide_finish.setEnabled(False)
            slide_finish.setStyleSheet('font-family: "微軟正黑體"; font-size: 12px; background-color:#7fff00;')
            slide_finish.setAlignment(Qt.AlignHCenter | Qt.AlignVCenter)
            self.ui.window_main_table.setCellWidget(7, 4, slide_finish)
            # 按鈕設定
            slide_setup = QtWidgets.QPushButton('設定')
            slide_setup.setStyleSheet('font-family: "微軟正黑體"; font-size: 12px; background-color:#7fff00;')
            slide_setup.setEnabled(False)  # 使按鈕不可操作
            slide_setup.setFlat(True)  # 使按鈕不顯示為可按下的外觀
            self.ui.window_main_table.setCellWidget(7, 3, slide_setup)
    def previous_value(self):
        if par.main_change == '':
            print('This is your first time enter main window')
        elif par.main_change == '1':
            if par.unit_keep == '公制':
                self.ui.window_main_table.cellWidget(2, 3).setCurrentIndex(0)
            elif par.unit_keep == '英制':
                self.ui.window_main_table.cellWidget(2, 3).setCurrentIndex(1)
            if par.type_keep == 'SN1-25':
                self.ui.window_main_table.cellWidget(4, 3).setCurrentIndex(0)
            elif par.type_keep == 'SN1-35':
                self.ui.window_main_table.cellWidget(4, 3).setCurrentIndex(1)
            elif par.type_keep == 'SN1-45':
                self.ui.window_main_table.cellWidget(4, 3).setCurrentIndex(2)
            elif par.type_keep == 'SN1-60':
                self.ui.window_main_table.cellWidget(4, 3).setCurrentIndex(3)
            elif par.type_keep == 'SN1-80':
                self.ui.window_main_table.cellWidget(4, 3).setCurrentIndex(4)
            elif par.type_keep == 'SN1-110':
                self.ui.window_main_table.cellWidget(4, 3).setCurrentIndex(5)
            elif par.type_keep == 'SN1-160':
                self.ui.window_main_table.cellWidget(4, 3).setCurrentIndex(6)
            elif par.type_keep == 'SN1-200':
                self.ui.window_main_table.cellWidget(4, 3).setCurrentIndex(7)
            elif par.type_keep == 'SN1-250':
                self.ui.window_main_table.cellWidget(4, 3).setCurrentIndex(8)
            if par.style_keep == 'S':
                self.ui.window_main_table.cellWidget(5, 3).setCurrentIndex(0)
            elif par.style_keep == 'H':
                self.ui.window_main_table.cellWidget(5, 3).setCurrentIndex(1)
            elif par.style_keep == 'P':
                self.ui.window_main_table.cellWidget(5, 3).setCurrentIndex(2)
            self.ui.window_main_table.cellWidget(9, 4).setText(par.stroke_keep)
            self.ui.window_main_table.cellWidget(10, 4).setText(par.cycle_keep)
            self.ui.window_main_table.cellWidget(11, 4).setText(par.DH_keep)

            for x in range(0, len(par.keep_items)):
                par.keep_items[x] = ''

    def switch_to_plate(self, stamping_press_type):
        self.window_main_keep()
        self.hide()
        if par.get_pad_select_name == '特殊平板':
            self.nw = plate_secend_windows(stamping_press_type)
        else:
            self.nw = plate_first_windows(stamping_press_type)
        self.nw.show()

    # 切換至沖頭介面
    def switch_to_slide(self, stamping_press_type):
        self.window_main_keep()
        self.hide()
        if par.get_pad_select_name == '特殊衝頭':
            self.nw = slide_secend_windows(stamping_press_type)
        else:
            self.nw = slide_first_windows(stamping_press_type)
        self.nw.show()

    def switch_to_select_item(self):
        self.window_main_keep()
        self.hide()
        self.nw = select_item_window()
        self.nw.show()

    def unit_change(self):
        unit_type = self.ui.window_main_table.cellWidget(2, 3).currentText()
        if unit_type == '公制':
            for x in range(9, 22):
                if x != 17:
                    newItem = QTableWidgetItem(par.unit_metric[x - 9])
                    newItem.setTextAlignment(Qt.AlignHCenter | Qt.AlignVCenter)
                    newItem.setFlags(newItem.flags() & ~Qt.ItemIsEditable)
                    self.ui.window_main_table.setItem(x, 2, newItem)
                else:
                    pass
        elif unit_type == '英制':
            for x in range(9, 22):
                if x != 17:
                    newItem = QTableWidgetItem(par.unit_english[x - 9])
                    newItem.setTextAlignment(Qt.AlignHCenter | Qt.AlignVCenter)
                    newItem.setFlags(newItem.flags() & ~Qt.ItemIsEditable)
                    self.ui.window_main_table.setItem(x, 2, newItem)
                else:
                    pass

    def customize_typing(self, parameter_type):
        # 目前只製作行程、行程數、閉合
        if parameter_type == 'stroke':
            current_text = self.ui.window_main_table.cellWidget(9, 4).text()
            if current_text != '':
                item = self.ui.window_main_table.item(9, 3).text()
                slide_stroke = QTableWidgetItem(item)
                slide_stroke.setTextAlignment(Qt.AlignHCenter | Qt.AlignVCenter)
                font = QtGui.QFont()
                font.setStrikeOut(True)
                font.setKerning(True)
                slide_stroke.setFont(font)
                self.ui.window_main_table.setItem(9, 3, slide_stroke)
            elif current_text == '':
                item = self.ui.window_main_table.item(9, 3).text()
                slide_stroke = QTableWidgetItem(item)
                slide_stroke.setTextAlignment(Qt.AlignHCenter | Qt.AlignVCenter)
                font = QtGui.QFont()
                font.setStrikeOut(False)
                font.setKerning(True)
                slide_stroke.setFont(font)
                self.ui.window_main_table.setItem(9, 3, slide_stroke)
        elif parameter_type == 'cycle':
            current_text = self.ui.window_main_table.cellWidget(10, 4).text()
            if current_text != '':
                item = self.ui.window_main_table.item(10, 3).text()
                slide_stroke = QTableWidgetItem(item)
                slide_stroke.setTextAlignment(Qt.AlignHCenter | Qt.AlignVCenter)
                font = QtGui.QFont()
                font.setStrikeOut(True)
                font.setKerning(True)
                slide_stroke.setFont(font)
                self.ui.window_main_table.setItem(10, 3, slide_stroke)
            elif current_text == '':
                item = self.ui.window_main_table.item(10, 3).text()
                slide_stroke = QTableWidgetItem(item)
                slide_stroke.setTextAlignment(Qt.AlignHCenter | Qt.AlignVCenter)
                font = QtGui.QFont()
                font.setStrikeOut(False)
                font.setKerning(True)
                slide_stroke.setFont(font)
                self.ui.window_main_table.setItem(10, 3, slide_stroke)
        elif parameter_type == 'DH':
            current_text = self.ui.window_main_table.cellWidget(11, 4).text()
            if current_text != '':
                item = self.ui.window_main_table.item(11, 3).text()
                slide_stroke = QTableWidgetItem(item)
                slide_stroke.setTextAlignment(Qt.AlignHCenter | Qt.AlignVCenter)
                font = QtGui.QFont()
                font.setStrikeOut(True)
                font.setKerning(True)
                slide_stroke.setFont(font)
                self.ui.window_main_table.setItem(11, 3, slide_stroke)
            elif current_text == '':
                item = self.ui.window_main_table.item(11, 3).text()
                slide_stroke = QTableWidgetItem(item)
                slide_stroke.setTextAlignment(Qt.AlignHCenter | Qt.AlignVCenter)
                font = QtGui.QFont()
                font.setStrikeOut(False)
                font.setKerning(True)
                slide_stroke.setFont(font)
                self.ui.window_main_table.setItem(11, 3, slide_stroke)

    def customize_dimension_check(self):
        # 目前只製作行程、行程數、閉合
        check_item = []
        for x in range(9, 17):
            check_item.append(self.ui.window_main_table.cellWidget(x, 4).text())
        if check_item[0] != '':
            par.customize_stroke = self.ui.window_main_table.cellWidget(9, 4).text()
        elif check_item[0] == '':
            par.customize_stroke = self.ui.window_main_table.item(9, 3).text()
        if check_item[1] != '':
            par.customize_cycle = self.ui.window_main_table.cellWidget(10, 4).text()
        elif check_item[1] == '':
            par.customize_cycle = self.ui.window_main_table.item(10, 3).text()
        if check_item[2] != '':
            par.customize_DH = self.ui.window_main_table.cellWidget(11, 4).text()
        elif check_item[2] == '':
            par.customize_DH = self.ui.window_main_table.item(11, 3).text()
        if check_item[5] !='':
            par.INVERTER = self.ui.window_main_table.cellWidget(14, 4).text()
        elif check_item[5] == '':
            par.INVERTER = self.ui.window_main_table.item(14, 3).text()
        par.GUM = self.ui.window_main_table.cellWidget(18, 3).currentText()#防震繳
        par.power = self.ui.window_main_table.cellWidget(21, 3).currentText()#電源
        print(check_item, par.customize_stroke, par.customize_cycle, par.customize_DH)
        return par.customize_stroke , par.customize_DH , par.GUM, par.INVERTER, par.power

    def window_main_keep(self):
        par.main_change = '1'
        par.unit_keep = self.ui.window_main_table.cellWidget(2, 3).currentText()
        par.type_keep = self.ui.window_main_table.cellWidget(4, 3).currentText()
        par.style_keep = self.ui.window_main_table.cellWidget(5, 3).currentText()
        par.stroke_keep = self.ui.window_main_table.cellWidget(9, 4).text()
        par.cycle_keep = self.ui.window_main_table.cellWidget(10, 4).text()
        par.DH_keep = self.ui.window_main_table.cellWidget(11, 4).text()
        print(par.unit_keep, par.type_keep, par.style_keep, par.stroke_keep, par.cycle_keep, par.DH_keep)

    def start(self):
        start_time = time.time()
        #讀取介面輸入數值
        specifications_travel_value,  specifications_close_working_height_value, self.GUM, self.INVERTER, self.power= self.customize_dimension_check()
        type = self.ui.window_main_table.cellWidget(4, 3).currentText()
        travel_type = str(self.ui.window_main_table.cellWidget(5, 3).currentText())
        processing = '是'  # 模墊加工
        print(type, travel_type, specifications_travel_value, specifications_close_working_height_value)
        if specifications_travel_value == "":
            self.specifications_travel_value = 0
        else:
            self.specifications_travel_value = int(specifications_travel_value)
        if specifications_close_working_height_value == "":
            self.specifications_close_working_height_value = 0
        else:
            self.specifications_close_working_height_value = int(specifications_close_working_height_value)
        self.stamping_press_type = self.choose_stamping_press_type()
        self.p, self.travel_type = self.choos(processing, travel_type)

        self.alpha, self.beta, self.zeta, self.epsilon = self.frame_calculate(self.stamping_press_type, self.specifications_travel_value,
                                                                              self.specifications_close_working_height_value,
                                                                              self.travel_type)
        if par.test_stop == False:
            self.create_txt(path, type, travel_type, self.specifications_travel_value,
                            self.specifications_close_working_height_value, self.alpha, self.beta, self.zeta,
                            self.epsilon, self.power)
            self.change_dir(self.stamping_press_type, self.p, self.alpha, self.beta, self.zeta, self.epsilon, machining,
                            welding, self.travel_type, self.specifications_close_working_height_value, self.specifications_travel_value, self.GUM, self.INVERTER, self.power)
            TOTAL_time = time.time() - start_time
            print(TOTAL_time)
    def choose_stamping_press_type(self):
        type = self.ui.window_main_table.cellWidget(4, 3).currentText()
        style = self.ui.window_main_table.cellWidget(5, 3).currentText()
        if type == "SN1-25":
            stamping_press_type = 0
        elif type == "SN1-35":
            stamping_press_type = 1
        elif type == "SN1-45":
            stamping_press_type = 2
        elif type == "SN1-60":
            stamping_press_type = 3
        elif type == "SN1-80":
            stamping_press_type = 4
        elif type == "SN1-110":
            stamping_press_type = 5
        elif type == "SN1-160":
            stamping_press_type = 6
        elif type == "SN1-200":
            stamping_press_type = 7
        elif type == "SN1-250":
            stamping_press_type = 8
        slide_stroke = QTableWidgetItem(par.stamping_press_stroke[style][stamping_press_type])
        slide_stroke.setTextAlignment(Qt.AlignHCenter | Qt.AlignVCenter)
        slide_stroke.setFlags(slide_stroke.flags() & ~Qt.ItemIsEditable)
        self.ui.window_main_table.setItem(9, 3, slide_stroke)
        slide_cycle = QTableWidgetItem(par.stamping_press_cycle[style][stamping_press_type])
        slide_cycle.setTextAlignment(Qt.AlignHCenter | Qt.AlignVCenter)
        slide_cycle.setFlags(slide_cycle.flags() & ~Qt.ItemIsEditable)
        self.ui.window_main_table.setItem(10, 3, slide_cycle)
        slide_DH = QTableWidgetItem(par.stamping_press_DH[style][stamping_press_type])
        slide_DH.setTextAlignment(Qt.AlignHCenter | Qt.AlignVCenter)
        slide_DH.setFlags(slide_DH.flags() & ~Qt.ItemIsEditable)
        self.ui.window_main_table.setItem(11, 3, slide_DH)
        motor_power = QTableWidgetItem(par.stamping_press_motor_power[style][stamping_press_type])
        motor_power.setTextAlignment(Qt.AlignHCenter | Qt.AlignVCenter)
        motor_power.setFlags(motor_power.flags() & ~Qt.ItemIsEditable)
        self.ui.window_main_table.setItem(13, 3, motor_power)
        frequency_power = QTableWidgetItem(par.stamping_press_frequency_power[style][stamping_press_type])
        frequency_power.setTextAlignment(Qt.AlignHCenter | Qt.AlignVCenter)
        frequency_power.setFlags(frequency_power.flags() & ~Qt.ItemIsEditable)
        self.ui.window_main_table.setItem(15, 3, frequency_power)
        Upper_mold_lifting_weight = QTableWidgetItem(par.stamping_press_Upper_mold_lifting_weight[style][stamping_press_type])
        Upper_mold_lifting_weight.setTextAlignment(Qt.AlignHCenter | Qt.AlignVCenter)
        Upper_mold_lifting_weight.setFlags(Upper_mold_lifting_weight.flags() & ~Qt.ItemIsEditable)
        self.ui.window_main_table.setItem(16, 3, Upper_mold_lifting_weight)
        Working_surface_height = QTableWidgetItem(par.stamping_press_Working_surface_height[style][stamping_press_type])
        Working_surface_height.setTextAlignment(Qt.AlignHCenter | Qt.AlignVCenter)
        Working_surface_height.setFlags(Working_surface_height.flags() & ~Qt.ItemIsEditable)
        self.ui.window_main_table.setItem(20, 3, Working_surface_height)


        par.stamping_press_type = stamping_press_type
        par.stamping_press_style = style

        return stamping_press_type


    def choos(self,prossing, travel_type):
        # 確認型號"輸入型號"
        # 確認加工方式
        if prossing == '是':
            p = 0
        elif prossing == '否':
            p = 1
        # 確認行程類型
        if travel_type == 'S':
            travel_type = 1
        elif travel_type == 'H':
            travel_type = 2
        elif travel_type == 'P':
            travel_type = 3
        return p, travel_type

    def frame_calculate(self, stamping_press_type, specifications_travel_value, specifications_close_working_height_value, travel_type):
        Form = QtWidgets.QWidget()
        # Form.setWindowTitle('警告')
        Form.resize(400, 300)
        mbox = QtWidgets.QMessageBox(Form)

        # 讀取標準資料
        excel = epc.ExcelOp('尺寸整理表', '標準資料')
        type_name, travel_value, close_working_height_value, specifications_travel_min_value, specifications_travel_max_value, specifications_close_working_height_min_value, specifications_close_working_height_max_value = excel.get_standard_parts(
            stamping_press_type * 3)

        # 噸數&行程類型
        all_type = stamping_press_type * 3 + travel_type - 1
        # 行程
        alpha = int(specifications_travel_value) - travel_value[all_type]
        # 牙球伸長量
        epsilon_1 = (-alpha / 2) + (
                close_working_height_value[all_type] - int(specifications_close_working_height_value))
        elsilon_2 = (alpha / 2)
        epsilon_3 = 0
        epsilon = max(epsilon_1, elsilon_2, epsilon_3)
        # 喉部拉高量
        zeta = (alpha / 2) + epsilon + specifications_close_working_height_value - close_working_height_value[all_type]
        print(zeta)
        # 閉合工作高度驗證公式
        verification_specifications_close_working_height_value = close_working_height_value[all_type] - (
                alpha / 2) - epsilon + zeta
        print(verification_specifications_close_working_height_value)

        par.test_stop = False

        # 驗證行程
        if specifications_travel_value >= specifications_travel_min_value[all_type] and specifications_travel_value <= \
                specifications_travel_max_value[all_type]:
            print('行程尺寸在允許範圍: %s <= %s <= %s' % (
                specifications_travel_min_value[all_type], specifications_travel_value,
                specifications_travel_max_value[all_type]))
        else:
            print('行程尺寸不再允許範圍: %s <= %s <= %s' % (
                specifications_travel_min_value[all_type], specifications_travel_value,
                specifications_travel_max_value[all_type]))
            mbox.warning(Form, '警告', '行程超出範圍')
            par.test_stop = True
            self.ui.window_main_table.cellWidget(9, 4).clear()

        # 驗證閉合工作高度
        if specifications_close_working_height_value >= specifications_close_working_height_min_value[
            all_type] and specifications_close_working_height_value <= specifications_close_working_height_max_value[all_type]:
            print('閉合工作高度在允許範圍: %s <= %s <= %s' % (
                specifications_close_working_height_min_value[all_type], specifications_close_working_height_value,
                specifications_close_working_height_max_value[all_type]))
        else:
            print('閉合工作高度不在允許範圍: %s <= %s <= %s' % (
                specifications_close_working_height_min_value[all_type], specifications_close_working_height_value,
                specifications_close_working_height_max_value[all_type]))
            mbox.warning(Form, '警告', '閉合工作高度超出範圍')
            par.test_stop = True
            self.ui.window_main_table.cellWidget(11, 4).clear()

        # 驗證閉合工作高度是否符合客戶需求
        if verification_specifications_close_working_height_value == specifications_close_working_height_value:
            print('閉合工作高度符合要求: %s = %s' % (
                verification_specifications_close_working_height_value, specifications_close_working_height_value))
        else:
            print(
                'verification_specifications_close_working_height_value: %s；specifications_close_working_height_value: %s' % (
                    verification_specifications_close_working_height_value, specifications_close_working_height_value))
            mbox.warning(Form, '警告', '閉合工作高度不符合客戶需求')
            par.test_stop = True
            self.ui.window_main_table.cellWidget(9, 4).clear()
            self.ui.window_main_table.cellWidget(11, 4).clear()

        # 驗證牙球伸長量
        if epsilon >= 0:
            print('牙球伸長量: %s >= 0' % epsilon)
        else:
            print('牙球伸長量: %s <= 0' % epsilon)
            mbox.warning(Form, '警告', '牙球伸長量小於0')
            par.test_stop = True
            self.ui.window_main_table.cellWidget(9, 4).clear()
            self.ui.window_main_table.cellWidget(11, 4).clear()

        # 驗證機架拉高量
        if zeta >= 0:
            print('機架拉高量: %s >= 0' % zeta)
        else:
            print('機架拉高量: %s <= 0' % zeta)
            mbox.warning(Form, '警告', '機架拉高量小於0')
            par.test_stop = True
            self.ui.window_main_table.cellWidget(9, 4).clear()
            self.ui.window_main_table.cellWidget(11, 4).clear()

        # 驗證喉部拉高量
        if epsilon >= (alpha / 2):
            print('喉部拉高量: %s >= %s' % (epsilon, (alpha / 2)))
        else:
            mbox.warning(Form, '警告', '衝頭縮進導軌內部')
            par.test_stop = True
            self.ui.window_main_table.cellWidget(9, 4).clear()
            self.ui.window_main_table.cellWidget(11, 4).clear()

        alpha = alpha  # 行程差
        beta = (specifications_close_working_height_value - close_working_height_value[all_type])  # 閉合工作高度
        zeta = zeta  # 喉部拉高量
        epsilon = epsilon  # 牙球伸長量
        return alpha, beta, zeta, epsilon

    # 建立txt檔
    def create_txt(self, path, type, travel_type, specifications_travel_value, specifications_close_working_height_value,
                alpha, beta, zeta, epsilon, power):
        file_txt = path
        txt_name = "生成參數.txt"
        with open(file_txt + "\\" + txt_name, "w") as f:#創建文字檔
            f.write("噸數=%s\n" % type)
            f.write("型式:%s\n" % travel_type)
            f.write("本次行程=%s\n" % specifications_travel_value)
            f.write("本次閉合工作高度=%s\n" % specifications_close_working_height_value)
            f.write("行程=%s\n" % alpha)
            f.write("閉合工作高度=%s\n" % beta)
            f.write("喉部拉高量=%s\n" % zeta)
            f.write("牙球伸長量=%s\n" % epsilon)
            f.write('電源=%s\n'% power)

    def create_dir(self):  # 創建資料夾
        time_now = datetime.datetime.now()
        dir_name = '{}_{}_{}_{}'.format(time_now.day, time_now.hour, time_now.minute, time_now.second)#確認資料夾名稱
        desktop = os.path.join(os.path.join(os.environ['USERPROFILE']), 'Desktop')#確認桌面路徑
        path = desktop + '\\' + dir_name#給程式一個創建資料夾的路徑
        os.mkdir(path)#創建資料夾
        machining = path + "\\" + "machining"
        welding = path + "\\" + "welding"
        plate = path + "\\" + "plate"
        slide = path + "\\" + "slide"
        os.mkdir(machining)
        os.mkdir(welding)
        os.mkdir(plate)
        os.mkdir(slide)
        self.path = path
        self.machining = machining
        self.welding = welding
        self.plate = plate
        self.slide = slide

        return  path , machining , welding, slide, plate

    # def finish(self, machining_file_change_error, welding_file_change_error):
    #     Form = QtWidgets.QWidget()
    #     Form.setWindowTitle('oxxo.studio')
    #     Form.resize(500, 200)
    #     mbox = QtWidgets.QMessageBox(Form)
    #     mbox.information(Form, '完成', '生成完成\nmachining_file_change_error:%s\nwelding_file_change_error:%s\n' % (
    #         machining_file_change_error, welding_file_change_error))
    #     self.ui.lineEdit_5.clear()
    #     self.ui.lineEdit_2.clear()

    # def label_7_change_data(self):
    #     label_7_data = {250: {"S": "標準:80", "H": ("標準:50"), "P": ("標準:35")},
    #                     350: {"S": ("標準:90"), "H": ("標準:60"), "P": ("標準:40")},
    #                     450: {"S": ("標準:110"), "H": ("標準:70"), "P": ("標準:45")},
    #                     600: {"S": ("標準:130"), "H": ("標準:80"), "P": ("標準:50")},
    #                     800: {"S": ("標準:150"), "H": ("標準:100"), "P": ("標準:60")},
    #                     1100: {"S": ("標準:180"), "H": ("標準:110"), "P": ("標準:70")},
    #                     1600: {"S": ("標準:200"), "H": ("標準:130"), "P": ("標準:80")},
    #                     2000: {"S": ("標準:220"), "H": ("標準:150"), "P": ("標準:90")},
    #                     2500: {"S": ("標準:250"), "H": ("標準:180"), "P": ("標準:100")},
    #                     }
    #     return label_7_data
    #
    # def change_label_7(self):
    #     label_7_data = self.label_7_change_data()
    #     type = str(self.ui.comboBox_4.currentText())
    #     travel_type = str(self.ui.comboBox_2.currentText())
    #     ton = int(type.split('-')[-1] + '0')
    #     travel_standard = label_7_data[ton][travel_type]
    #     travel_standard = str(travel_standard)
    #
    #     self.ui.label_7.clear()
    #     self.ui.label_7.setText(travel_standard)

    # def label_9_data(self):
    #     label_9_data = {250: {"S": ("標準:230"), "H": ("標準:200"), "P": ("標準:200")},
    #                     350: {"S": ("標準:250"), "H": ("標準:220"), "P": ("標準:220")},
    #                     450: {"S": ("標準:270"), "H": ("標準:240"), "P": ("標準:240")},
    #                     600: {"S": ("標準:300"), "H": ("標準:270"), "P": ("標準:270")},
    #                     800: {"S": ("標準:330"), "H": ("標準:300"), "P": ("標準:300")},
    #                     1100: {"S": ("標準:350"), "H": ("標準:320"), "P": ("標準:320")},
    #                     1600: {"S": ("標準:400"), "H": ("標準:360"), "P": ("標準:360")},
    #                     2000: {"S": ("標準:450"), "H": ("標準:400"), "P": ("標準:400")},
    #                     2500: {"S": ("標準:450"), "H": ("標準:400"), "P": ("標準:400")}, }
    #
    #     return label_9_data

    # def change_label_9(self):
    #     label_9_data = self.label_9_data()
    #     type = str(self.ui.comboBox_4.currentText())
    #     travel_type = str(self.ui.comboBox_2.currentText())
    #     ton = int(type.split('-')[-1] + '0')
    #     close_h = label_9_data[ton][travel_type]
    #     close_h = str(close_h)
    #
    #     self.ui.label_9.clear()
    #     self.ui.label_9.setText(close_h)

    def change_dir(self, stamping_press_type, p, alpha, beta, zeta, epsilon, machining, welding, travel_type, specifications_close_working_height_value, specifications_travel_value,  GUM, INVERTER, power):
        start_time = time.time()
        all_part_name = {}#零件名稱
        all_part_value = {}#零件變數名稱
        all_parameter_save = {}
        all_parameter_value = {}#零件變數的職
        # 開啟CATIA
        env = mprog.set_CATIA_workbench_env()
        machining_file_change_error = []
        machining_file_change_pass = []
        welding_file_change_error = []
        welding_file_change_pass = []
        # 開啟零件檔更改變數後儲存並關閉
        for name in epc.ExcelOp('尺寸整理表', '沖床機架零件清單').get_col_cell(1):
            # print(name)
            file_list_name, file_list_value = epc.ExcelOp('尺寸整理表', '沖床機架零件清單').get_sheet_par('沖床機架零件清單', stamping_press_type)
            file_list_name_index = file_list_name.index(name)#之後問泓毅
            if file_list_value[file_list_name_index] == 0:
                pass
            else:
                try:
                    # # 保存原始的sys.stdout
                    # original_stdout = sys.stdout
                    # # 创建一个新的StringIO对象来捕获输出
                    # captured_output = StringIO()
                    # sys.stdout = captured_output
                    #判斷其是否為STP(直接匯入)之零件
                    if name == 'PANEL' or name == 'CON_ROD' or name == 'CON_ROD_BASE' or name == 'CON_ROD_CAP' or name == 'INVERTERBRACKET' \
                            or name == 'POINTER' or name == 'COVER' or name == 'PLUG' or name == 'feeding_shaft_cover' or name == 'OIL_LEVEL_GAUGE' \
                            or name == 'slide_gib' or name == 'ELECTRIC_BOX_PLATE' or name == 'MOUNT_FILTER'or name == 'CONTROL_PANEL' or name == 'PANEL_BOX'\
                            or name == 'PANEL_BOX_BRACKET' or name == 'ELECTRIC_BOX' or name == 'GUARD_FLYWHEEL' or name == 'NAME_PLATE'\
                            or name == 'TRADEMARK_NAMEPLATE'or name == 'OPERATION_BOX' or name == 'PORTABLE_STAND' or name == 'OPERATION_BOX'\
                            or name == 'BEARING_HOUSING'or name == 'SLIDE' or name == 'BALANCER'or name == 'MOTOR'or name == 'MOTOR_BRACKET' or name == 'WIRE_CASING'\
                            or name == 'ANTI_VIBRATION_GUM'or name == 'HANDEL_MOUNT_FILTER'or name == 'INVERTER' or name == 'SAFETY_SWITCH' or name == 'SAFETY_BLOCK'\
                            or name == 'EJECTOR_UNIT' or name == 'KNOCK_OUT_BAR' or name == 'SlideKnockout_StrikePin' or name == 'SlideKnockout_Bracket':
                        # 讀取其餘STP檔
                        S_i.STP(name, stamping_press_type, machining, travel_type, GUM, INVERTER, power)
                        continue
                    else:
                        # 讀取機架零件
                        mprog.import_part(fp.system_root + fp.DEMO_part, name)
                    #判斷FRAME52是否需模墊加工
                    if name == 'FRAME52' and p == 0:
                        #輸入行程調整量等客製化參數
                        try:
                            mprog.param_change(name, "alpha", alpha)
                            mprog.param_change(name, "beta", beta)
                            mprog.param_change(name, 'zeta', zeta)
                            mprog.param_change(name, 'epsilon', epsilon)
                        except:
                            pass
                        # 加工圖零件
                        parameter_name, parameter_value = mptc.change_machining_parameter(name, stamping_press_type, 0, travel_type)
                        all_part_name[name] = parameter_name
                        all_part_value[name] = parameter_value
                        for x in range(len(parameter_name)):
                            all_parameter_save.setdefault(parameter_name[x], parameter_value[x])
                            all_parameter_list = all_parameter_save.copy()
                            all_parameter_value[name] = all_parameter_list
                            apv = all_parameter_value
                        all_parameter_save.clear()

                        # # 恢复原始的sys.stdout
                        # sys.stdout = original_stdout
                        # # 从捕获的输出中获取文本
                        # output_text = captured_output.getvalue()

                        # 判断文本内容
                        # if "error" in output_text:
                        #     machining_file_change_error.append(name)
                        # else:
                        #     machining_file_change_pass.append(name)
                            # mprog.close_file(name)
                    else:
                        try:
                            mprog.param_change(name, "alpha", alpha)
                            mprog.param_change(name, "beta", beta)
                            mprog.param_change(name, 'zeta', zeta)
                            mprog.param_change(name, 'epsilon', epsilon)
                        except:
                            pass

                        # 加工圖零件
                        parameter_name, parameter_value = mptc.change_machining_parameter(name, stamping_press_type, 1, travel_type)
                        all_part_name[name] = parameter_name#路人甲
                        all_part_value[name] = parameter_value#乙
                        for x in range(len(parameter_name)):
                            all_parameter_save.setdefault(parameter_name[x], parameter_value[x])
                            all_parameter_list = all_parameter_save.copy()
                            all_parameter_value[name] = all_parameter_list
                            apv = all_parameter_value
                        all_parameter_save.clear()

                        # # 恢复原始的sys.stdout
                        # sys.stdout = original_stdout
                        # output_text = captured_output.getvalue()
                        # # 判断文本内容
                        # if "error" in output_text:
                        #     machining_file_change_error.append(name)
                        # else:
                        #     machining_file_change_pass.append(name)
                    # 儲存加工圖零件檔
                    # mprog.save_file_stp(machining, name)
                    mprog.save_stpfile_part(machining, name)
                    # 進行裁料圖特徵變更
                    wptc.change_welding_feature(name, stamping_press_type)
                    # # print(output_text)
                    # if "error" in output_text:
                    #     welding_file_change_error.append(name)
                    # else:
                    #     welding_file_change_pass.append(name)
                    # 儲存裁料圖零件檔
                    # mprog.save_file_stp(welding, name)
                    mprog.save_stpfile_part(welding, name)
                    mprog.close_file(name)
                except:
                    pass
        # print(stamping_press_type)
        # print('all_part_name', all_part_name)
        # print('all_part_value', all_part_value)
        # print('machining_file_change_error', machining_file_change_error)
        # print('machining_file_change_pass', machining_file_change_pass)
        # print('welding_file_change_error', welding_file_change_error)
        # print('welding_file_change_pass', welding_file_change_pass)
        # print('總用時%s' % (time.time() - start_time))  # 建立3D組立
        Ad.assembly(stamping_press_type, apv, path, alpha, beta, zeta, epsilon, specifications_close_working_height_value, specifications_travel_value, travel_type, GUM,INVERTER, power, slide)

        return machining_file_change_error, welding_file_change_error
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
