sinje0816/stamping_press/SYEI_stamping_press_system/Test_2024.py

from PyQt5 import QtCore, QtGui, QtWidgets
from PyQt5.QtWidgets import QVBoxLayout, QWidget, QPushButton, QLabel, QTableWidgetItem, QHeaderView, QComboBox, QAbstractItemView, QMessageBox, QHBoxLayout, QLineEdit, QCheckBox
from PyQt5.QtCore import Qt
from PyQt5.QtGui import QColor, QBrush, QPixmap, QFont
import sys
from T_test import Ui_Form as T_test_form

type = 0
default_posision_Y = {0: ['50', '0', '-50'], 1: ['75', '0', '-75'], 2: ['100', '0', '-100']}
total_position_y = []
total_t_slot_h_type = []
total_LL = []
total_LR = []
total_SL = []
total_SR = []

class main(QtWidgets.QWidget):
    def __init__(self):
        super(main, self).__init__()
        self.ui = T_test_form()
        self.ui.setupUi(self)
        self.setWindowTitle('測試')
        self.increasing = False
        self.decreasing = False
        self.item_setting = False
        self.item_rearrange = False
        self.error = False
        self.table_setup()
        self.ui.AddNewRow.clicked.connect(self.add_new_row)
        # self.ui.T_solt.itemChanged.connect(self.table_item_change) # 當表格改變時相關功能(暫無作用)
        self.default() # 給予預設值
        self.ui.rearrange.clicked.connect(self.rearrange)

    def default(self):
        self.item_setting = True  # 標籤:正在設定單位格
        if type == 0:
            for x in range(0, len(default_posision_Y[type])):
                self.add_new_row()
                item = QTableWidgetItem(default_posision_Y[type][x])
                self.ui.T_solt.setItem(x+1, 1, item)
        else:
            pass
        self.item_setting = False  # 標籤:完成設定單位格

    def table_setup(self):
        self.ui.T_solt.verticalHeader().setVisible(False)
        self.ui.T_solt.horizontalHeader().setVisible(False)
        self.ui.T_solt.horizontalHeader().setSectionResizeMode(QHeaderView.Stretch)
        self.ui.T_solt.setEditTriggers(QAbstractItemView.AllEditTriggers)
        # 第一行
        for col in range(8):  # 假设有8列
            newItem = QTableWidgetItem(
                "編號" if col == 0 else "位置(Y)" if col == 1 else "形式" if col == 2 else "LL" if col == 3 else "LR" if col == 4 else "SL" if col == 5 else "SR" if col == 6 else "")
            newItem.setTextAlignment(Qt.AlignCenter)  # 可以根据需要设置文本对齐方式
            self.ui.T_solt.setItem(0, col, newItem)
            newItem.setFlags(newItem.flags() & ~Qt.ItemIsEditable)  # 設定為不可編輯
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
