sinje0816/stamping_press/(commit log)

2022-11-11 註:新增機架組立
2022-11-14 註:新增機架組立，平面和組合線隱藏
2022-11-14 改完路徑了
2022-11-14 改完路徑了1
2022-11-14 程式結合
2022-11-15 看一下跳錯的地方跟你的組合檔打開方式
2022-11-15 新增test機架零件變數變換和機架組和更新
2022-11-16 新增test1機架組合和組合檔結合
2022-11-17 FRAME2_lower_depth有改
2022-11-17 FRAME_Assembly_change更改部分缺失結合尺寸及結合方式
2022-11-19 GUI改了
2022-11-19 GUI改了QQ
2022-11-20 UI大概弄好了~嗎?
2022-11-22 SP移除閉合部分 main_GUI新增判斷條件
2022-12-07 N_teat測試檔
2022-12-08 N_teat測試檔 N1 測試
2022-12-08 N_teat測試檔 N1 測試 drafting 2 test檔
2022-12-17 建立及測試圈碼圖 (Y方向卡關)
2022-12-18 完成零件6圈碼圖建立
2022-12-27 N1及drafting_test更新
2022-12-28 N1及N_test圈馬程式更新
2023-01-16 材料圖bom表建立
2023-01-17 N1及N_test圈馬位置更新，新增一個開啟圖面副程式
2023-01-17 圖框文字刪除部分更新，開啟圖檔2副程式套用至N1
2023-02-06 drafting_part.py細節修改
2023-02-06 main_GUI.py增加零件圖生成 drafting_part_calculate.py修改
2023-02-06 修改FRAME31.1~4的位置
2023-02-06 檔案位置變更 將圖檔加入程式資料夾中
    [BALANCER1.CATPart, BALANCER10.CATPart, BALANCER2.CATPart, BALANCER3.CATPart, BALANCER4.2.CATPart, BALANCER4.CATPart, BALANCER5.CATPart, BALANCER6.CATPart]
2023-02-08 新增檔案路徑py檔 爆炸圖新增1.5
    [FRAME20.CATPart]
2023-02-09 主程式組立部分修正 資料儲存副程式修正 母檔修改
    [FRAME1.CATPart, FRAME10.CATPart, FRAME11.CATPart, FRAME13.CATPart, FRAME14.CATPart, FRAME17.CATPart, FRAME2.CATPart, FRAME20.CATPart]
2023-02-09 FRAME44修正
    [FRAME44.CATPart]
2023-02-09 完成剖面圖投影 局部放大圖Section view F-F需先切換視窗關閉零件再進行投影
    [FRAME44.CATPart]
2023-02-10 圖檔修正 零件圖副程式修改
    [FRAME1.CATPart, FRAME11.CATPart, FRAME13.CATPart, FRAME14.CATPart, FRAME17.CATPart, FRAME2.CATPart, FRAME20.CATPart, FRAME22.CATPart]
2023-02-10 零件母檔更新及組立變更 變數調用方式統一
    [FRAME1.CATPart, FRAME10.CATPart, FRAME11.CATPart, FRAME13.CATPart, FRAME14.CATPart, FRAME17.CATPart, FRAME2.CATPart, FRAME20.CATPart]
2023-02-13 零件母檔更新及組立問題變更 測試檔更改
    [FRAME6.CATPart, FRAME7.CATPart]
2023-02-13 完成焊接符號建立
    [FRAME6.CATPart, FRAME7.CATPart]
2023-02-14 SN1-80部分暫時去除
2023-02-14 剖視圖型號部分修改
2023-02-18 修改main_GUI爆炸圖Bug
2023-02-20 SN1-80部分母黨修改 主程式組立部分新增SN1-80例外情形
    [FRAME20.CATPart, FRAME30.CATPart, FRAME44.CATPart]
2023-02-20 SN1-80部分母檔修改 修改GUI
    [BOLSTER1.CATPart, FRAME41.CATPart]
2023-02-20 新建高度浮動值alpha組立程式
    [BOLSTER1.CATPart, FRAME1.CATPart, FRAME10.CATPart, FRAME11.CATPart, FRAME2.CATPart, FRAME41.CATPart]
2023-02-20 修改GUI與參數匯入alpha
2023-02-21 修改組立無法讀取alpha問題 新建焊接圖圈碼圖 FRAME1, 2 相關高度待確認
    [FRAME1.CATPart, FRAME11.CATPart, FRAME2.CATPart]
2023-02-21 更改與高度相關組立跟參數 母檔更改
    [FRAME1.CATPart, FRAME2.CATPart, FRAME20.CATPart, FRAME30.CATPart, FRAME44.CATPart]
2023-02-21 改FRAME11跟10的XY平面 主程式修改
    [FRAME10.CATPart, FRAME11.CATPart]
2023-02-21 主程式修改
2023-02-21 修改FRAME1,2,10,11之alpha值相關組立尺寸
    [FRAME1.CATPart, FRAME10.CATPart, FRAME11.CATPart, FRAME2.CATPart, FRAME20.CATPart]
2023-02-21 GUI介面更改
2023-02-22 零件圖圈碼位置調整 主介面修改
2023-02-22 主介面修改
2023-02-23 爆改主程式
    [FRAME11.CATPart]
2023-02-24 修整主程式資料位置
2023-07-05 修改part_design中函式activatefeature()中，新增草圖激活
2023-07-05 修改activatefeature修改至main_program，修改此函數內容。 新增FRAME5相關變數
2023-07-06 part_TYPE_change2.py檔資料更新
2023-07-06 新增FRAME5
    [FRAME1.CATPart, FRAME1_new.CATPart, FRAME2.CATPart, FRAME2_new.CATPart, FRAME5.CATPart]
2023-07-12 part_TYPE_change2.py零件更新
2023-07-12 完成FRAME1程式撰寫；進行FRAME2噸數整理
    [尺寸整理表.xlsx]
2023-07-20 FRAME_part_TYPE_change_2.py新增加工圖零件 part_TYPE_change2.py改為顯示裁料圖
2023-07-31 excel_parameter_change_1.py新增牙球(暫定)副程式 FRAME_part_TYPE_change_2.py更新 part_TYPE_change2.py更新
2023-08-03 DEMO人機介面更新 尺寸統整 加上學弟的py檔
    [尺寸整理表_2.xlsx]
2023-08-04 DEMO人機介面更新 尺寸統整 加上學弟的py檔 檔案的開啟跟儲存
    [尺寸整理表_2.xlsx]
2023-08-04 整理完成我得部分及少量學弟
    [FRAME1.CATPart, FRAME11.CATPart, FRAME18.CATPart, FRAME2.CATPart, FRAME21.CATPart, FRAME23.CATPart, FRAME24.CATPart, FRAME26.CATPart]
2023-08-09 DEMO更新及圖檔上傳
    [BALL_SCREW.CATPart, FRAME10.CATPart, FRAME13.CATPart, FRAME15.CATPart, FRAME19.CATPart, FRAME20.CATPart, FRAME22.CATPart, FRAME25.CATPart]
2023-08-09 51圖檔上傳
    [FRAME51.CATPart, FRAME6.CATPart]
2023-08-09 合併零件檔案及程式，已完成加工圖合併
    [BALL_SCREW.CATPart, FRAME1.CATPart, FRAME10.CATPart, FRAME11.CATPart, FRAME11_new.CATPart, FRAME12.CATPart, FRAME13.CATPart, FRAME14.CATPart]
2023-08-09 材料圖py檔更新，學弟的部分接手零件更新
    [FRAME10.CATPart, FRAME15.CATPart, FRAME20.CATPart, FRAME31.CATPart, FRAME33.CATPart, FRAME34.CATPart, FRAME36.CATPart, FRAME37.CATPart]
2023-08-09 零件錯誤修改
    [尺寸整理表_2.xlsx]
2023-08-14 更新介面
    [FRAME18.CATPart, FRAME20.CATPart, FRAME49.CATPart]
2023-08-14 更新介面圖片
2023-08-14 增加一點點驗證
2023-08-16 更新人機介面
2023-08-17 增加客製化尺寸相關限制公式
2023-08-17 FRAME22更新
    [FRAME22.CATPart]
2023-08-17 FRAME22、33、34更新
    [FRAME10.CATPart, FRAME22.CATPart, FRAME33.CATPart, FRAME34.CATPart]
2023-08-17 FRAME6.CATPart更新
    [FRAME6.CATPart]
2023-08-17 應該都De完了吧?
    [FRAME6.CATPart]
2023-08-17 FRAME1、19、33、34.CATPart更新
    [FRAME1.CATPart, FRAME19.CATPart, FRAME33.CATPart, FRAME34.CATPart]
2023-08-18 到底怎麼用github，為啥總是推到你的帳號上
    [FRAME1.CATPart]
2023-08-18 FRAME1、7、9、19變更及加工圖程式更改
    [FRAME1.CATPart, FRAME19.CATPart, FRAME7.CATPart, FRAME9.CATPart, 組立尺寸.xlsx]
2023-08-21 FRAME3、4、8變更及加工圖程式更改
    [FRAME3.CATPart, FRAME4.CATPart, FRAME8.CATPart, 組立尺寸.xlsx]
2023-08-22 FRAME11、24、27、27_1變更及加工圖程式更改，新增FRAME24_1
    [FRAME11.CATPart, FRAME24.CATPart, FRAME24_1.CATPart, FRAME27.CATPart, FRAME27_1.CATPart, 組立尺寸.xlsx]
2023-08-23 FRAME3、4、5、24變更及加工圖程式更改
    [FRAME24.CATPart, FRAME24_1.CATPart, FRAME3.CATPart, FRAME4.CATPart, FRAME5.CATPart]
2023-08-25 介面及FRAME6、14、15、17...更新，新增FRAME16
    [FRAME14.CATPart, FRAME15.CATPart, FRAME16.CATPart, FRAME17.CATPart, FRAME25.CATPart, FRAME26.CATPart, FRAME29.CATPart, FRAME6.CATPart]
2023-09-11 組立資訊修改，FRAME19更新
    [FRAME19.CATPart, 組立尺寸.xlsx]
2023-09-11 加工圖副程式更動
2023-09-11 新增專案requirements.txt
2023-09-11 夾頭螺栓、鎖模螺栓、六角孔螺栓、螺栓尺寸表上傳
    [螺栓尺寸表.xlsx]
2023-09-11 螺栓尺寸表更新
    [螺栓尺寸表.xlsx]
2023-09-11 防震螺栓上傳
2023-09-11 T形槽建立成功
    [BALL_SCREW.CATPart, FRAME1.CATPart, FRAME10.CATPart, FRAME11.CATPart, FRAME11_new.CATPart, FRAME12.CATPart, FRAME13.CATPart, FRAME14.CATPart]
2023-09-11 DEMO組立部份上傳
    [FRAME19.CATPart, 組立尺寸.xlsx]
2023-09-13 DEMOparameter讀值修改，組立更新
    [FRAME1.CATPart, FRAME2.CATPart, FRAME3.CATPart, 組立尺寸.xlsx]
2023-09-14 零件基準平面新增，FRAME1修改，組立更新
    [FRAME1.CATPart, FRAME10.CATPart, FRAME11.CATPart, FRAME12.CATPart, FRAME13.CATPart, FRAME14.CATPart, FRAME15.CATPart, FRAME16.CATPart]
2023-09-14 防震螺栓更新、鎖模夾頭尺寸表上傳
    [鎖模夾頭尺寸表.xlsx]
2023-09-14 鎖模夾頭上傳
2023-09-14 FRAME1、2修改，組立更新
    [FRAME1.CATPart, FRAME2.CATPart]
2023-09-15 T形槽可運作
    [ALL.CATProduct, PUNCH.CATPart, T.CATPart, blank.CATPart, crankshaft.CATPart, cutout_funnel.CATPart, cutout_hole_circle.CATPart, cutout_hole_square.CATPart]
2023-09-15 完成下料孔設定介面
2023-09-15 FRAME13、14、17、27、27_1修改
    [FRAME13.CATPart, FRAME14.CATPart, FRAME17.CATPart, FRAME27.CATPart, FRAME27_1.CATPart]
2023-09-18 平板excel更新
    [blank.CATPart, die-2.CATPart, holder.CATPart, 平板.xlsx]
2023-09-18 母檔修改
    [FRAME1.CATPart, FRAME12.CATPart, FRAME19.CATPart, FRAME2.CATPart, FRAME21.CATPart, FRAME23.CATPart, FRAME27.CATPart, FRAME27_1.CATPart]
2023-09-25 零件更新及組立修改
    [FRAME13.CATPart, FRAME14.CATPart, FRAME15.CATPart, FRAME17.CATPart, FRAME2.CATPart, FRAME21.CATPart, FRAME25.CATPart, FRAME29.CATPart]
2023-09-25 刪除測試用指令
2023-09-25 組立更新
2023-10-02 下料孔介面更新、下料孔生成新增
2023-10-02 母黨更新、組立更新
    [FRAME19.CATPart, FRAME4.CATPart, FRAME41.CATPart, FRAME7.CATPart, 組立尺寸.xlsx]
2023-10-03 FRAME1母檔更新、組立更新
    [FRAME1.CATPart]
2023-10-12 SN1-35、45組立上傳
    [FRAME19.CATPart, FRAME42.CATPart, FRAME5.CATPart, 組立尺寸.xlsx]
2023-10-12 下料孔生成新增功能
2023-10-12 T形槽介面更新
    [ALL.CATProduct, PUNCH.CATPart, blank.CATPart, die-2.CATPart, holder.CATPart, product-2.CATPart]
2023-10-16 平板人機介面更新
2023-10-17 SN1-110組立上傳及零件母檔更新
    [FRAME19.CATPart, FRAME26.CATPart, FRAME33.CATPart, FRAME43.CATPart, FRAME45.CATPart, FRAME47.CATPart, FRAME48.CATPart, 組立尺寸.xlsx]
2023-10-17 補傳沖床新零件23_1
    [FRAME23_1.CATPart]
2023-10-18 零件母檔新增、組立更新
    [FRAME1.CATPart, FRAME13_1.CATPart, FRAME19.CATPart, FRAME51.CATPart, FRAME51_1.CATPart, FRAME53.CATPart, FRAME53_1.CATPart, 組立尺寸.xlsx]
2023-10-23 T溝母檔與相關變數更新
    [T.CATPart]
2023-10-23 組立程式更新
    [FRAME1.CATPart, FRAME13_1.CATPart, FRAME14.CATPart, FRAME17.CATPart, FRAME19.CATPart, FRAME2.CATPart, FRAME51_1.CATPart, FRAME53.CATPart]
2023-10-24 母檔更新及組立程式微調
    [FRAME7.CATPart]
2023-10-26 簡單平板介面、衝頭介面(簡單+完整)、整機介面製作中
2023-10-26 平板第二頁相關功能完成
    [ALL.CATProduct, PUNCH.CATPart, T.CATPart, blank.CATPart, die-2.CATPart, holder.CATPart, product-2.CATPart]
2023-10-30 STP檔更新上傳
    [01A0532335Q-操作面板箱(PPC9100).SLDPRT, 01A0532335Q-操作面板箱(PPC9100).STEP, 01A0532335Q_PANEL_BOX.CATPart, 01A0532505Q-電器控制箱(PPC9100).SLDPRT, 01A0532505Q-電器控制箱(PPC9100).STEP, 01A0532505Q_PANEL_BOX.CATPart, 01A0532515Q-電器控制箱(PPC9100).SLDPRT, 01A0532515Q-電器控制箱(PPC9100).STEP]
2023-10-30 注油器STP檔補傳
2023-10-30 平板第一頁大致完成，剩缺解決資料夾路徑相關問題
    [cutout_funnel.CATPart, cutout_hole_circle.CATPart, cutout_hole_square.CATPart]
2023-10-30 整機介面製作中
2023-10-30 主頁面製作完成
2023-10-31 電氣箱名稱變更，組立程式更新
    [01A0534375P-電控箱.STEP, 01A0534375P_CONTROL_UNIT_BOX.CATPart, 01A0534375P_ELECTRIC_BOX.CATPart, 01A0534395P-電控箱.STEP, 01A0534395P_CONTROL_UNIT_BOX.CATPart, 01A0534395P_ELECTRIC_BOX.CATPart, 01A0534405P-電控箱.STEP, 01A0534405P_CONTROL_UNIT_BOX.CATPart]
2023-10-31 完成平板第一頁及第二頁相關功能
    [cutout_molded_cushion.CATPart, plate.CATPart]
2023-10-31 主頁面一點點小更新
2023-10-31 SN1-110初步組立更新
    [412R24S03_PANEL_BOX_BRACKET.CATPart, FRAME1.CATPart, 組立尺寸.xlsx]
2023-10-31 拯救曲軸py檔大作戰
2023-10-31 沖床噸數的代號替換
2023-10-31 主頁面更新
2023-11-01 組立程式更新，110標準完成，250標準調整中
    [472B04S02_CON_ROD.CATPart, FRAME2.CATPart, 組立尺寸.xlsx]
2023-11-02 主頁面更新(單位連動)
2023-11-03 完成公司提出平板介面修改需求
    [punch_200_lv1.CATPart, punch_200_normal.CATPart, punch_60_lv1.CATPart, punch_60_lv2.CATPart, punch_60_normal.CATPart]
2023-11-03 新增馬達、馬達固定板、曲軸黃銅座，更新組立程式
    [302CC4S02_BEARING_HOUSING.CATPart, 302CC4S02_曲軸合銅座.STEP, 302M01S02_MOTOR_BASE.CATPart, 302M01S02_馬達固定座.STEP, 322CC4S02_BEARING_HOUSING.CATPart, 322CC4S02_曲軸合銅座.STEP, 322M01S02_MOTOR_BASE.CATPart, 322M01S02_馬達固定座.STEP]
2023-11-06 平板存檔路徑更新，組立程式更新
    [BALL_SCREW.CATPart, KM_145_ANTI_VIBRATION_GUM.CATPart, KM_200_ANTI_VIBRATION_GUM.CATPart, KM_250_ANTI_VIBRATION_GUM.CATPart, L19_25_24_ANTI_VIBRATION_GUM.CATPart, L29_29_24_ANTI_VIBRATION_GUM.CATPart, L39_32_30_ANTI_VIBRATION_GUM.CATPart, L69_38_39_ANTI_VIBRATION_GUM.CATPart]
2023-11-06 平板漏斗形R角修改
    [cutout_funnel.CATPart, cutout_hole_square.CATPart]
2023-11-07 存檔方式修改，組立程式更新(平衡氣壓缸)
    [plate.CATPart]
2023-11-07 平板算正式完成
2023-11-08 主頁面功能更新
2023-11-08 正在改沖頭
2023-11-13 110噸組立更新，新增馬達及固定板
    [FAC063160W_BALANCER.CATPart, FAC063170W_BALANCER.CATPart, FAC070205W_BALANCER.CATPart, FAC080235W_BALANCER.CATPart, FAC100280W_BALANCER.CATPart, FAC120320W_BALANCER.CATPart, FAC140360W_BALANCER.CATPart, FAC180390WA_BALANCER.CATPart]
2023-11-13 衝頭變數不見了QQ有人在搓，小丑竟是我自己
2023-11-14 漏網之魚:方孔變數
2023-11-16 新增電線護罩，阻力程式更新，零件更換print刪掉
    [412M01S03_MOTOR_BASE.CATPart, 41M4701_MOTOR_BASE.CATPart, 43N6603_WIRE_CASING.CATPart, 43N6604_WIRE_CASING.CATPart, FRAME2.CATPart, FRAME_WIRE_CASING.CATPart, MZW8702_WIRE_CASING.CATPart, punch_200_normal.CATPart]
2023-11-20 組立程式更新，完成110跟250整機
    [BALL_SCREW.CATPart, FRAME_WIRE_CASING.CATPart, 組立尺寸.xlsx]
2023-11-20 完成沖頭相關功能(缺恢復資料)
    [T_solt_slide.CATPart, punch_200_lv1.CATPart, punch_200_normal.CATPart, punch_60_lv1.CATPart, punch_60_lv2.CATPart, punch_60_normal.CATPart, slide_0_lv1.CATPart, slide_0_lv2.CATPart]
2023-11-23 組立程式更新，新匯入變頻器，新增需讀取數值GUM(防震腳廠牌)、INVERTER(變頻器廠牌)
    [HOPCLA8RCY_HANDEL_MOUNT_FILTER.CATPart, KM_200_ANTI_VIBRATION_GUM.CATPart, SAV0102B1T_INVERTER.CATPart, SAV0102BUS_INVERTER.CATPart, SAV0152A1T_INVERTER.CATPart, SAV0152B1T_INVERTER.CATPart, SAV0152BUS_INVERTER.CATPart, SAV0252B1T_INVERTER.CATPart]
2023-11-24 將變頻器剩餘噸數補齊
    [SAV0052A1T_INVERTER.CATPart, SAV0052AUS_INVERTER.CATPart, SAV0052B1T_INVERTER.CATPart, SAV0052BUS_INVERTER.CATPart, SAV0072A1T_INVERTER.CATPart, SAV0072AUS_INVERTER.CATPart, SAV0072B1T_INVERTER.CATPart, SAV0072BUS_INVERTER.CATPart]
2023-11-24 選配頁面
2023-11-27 奇怪的idea為保存內容
    [43N6603_WIRE_CASING.CATPart, 43N6604_WIRE_CASING.CATPart, FRAME_WIRE_CASING.CATPart, MZW8702_WIRE_CASING.CATPart, punch_3_normal.CATPart, punch_7_normal.CATPart]
2023-11-27 馬達、變頻器功率連動變換
2023-11-27 更新變頻器與電源的連動
2023-11-29 完成沖頭第一頁功能
2023-11-29 沖頭基準平面建立，新增註解
    [slide_0_lv1.CATPart, slide_0_lv2.CATPart, slide_0_normal.CATPart, slide_1_lv1.CATPart, slide_1_lv2.CATPart, slide_1_normal.CATPart, slide_2_lv1.CATPart, slide_2_lv2.CATPart]
2023-12-04 dist所有檔案上傳及組立程式更新
    [01A0535755P-電器控制箱(WPC2000).SLDPRT, 01A0541785Q-控制面板.SLDPRT, 01A0543735P_CONTROL_PANEL.CATPart, 20213220S008-飛輪護罩.STEP, 20213720S003-飛輪護罩.STEP, 20214720S008-飛輪護罩.STEP, 302B03-衝桿座.STEP, 302CC4S02_BEARING_HOUSING.CATPart]
2023-12-04 修復平板及沖頭相關bug
2023-12-04 新增平板即衝頭按下完成主頁面按鈕關閉即顯示完成
2023-12-04 200頓FRAME6組立
2023-12-06 特殊平板標準類無法抓取當前平板面積大小之問題，已解決
    [01A0535755P-電器控制箱(WPC2000).SLDPRT, 01A0541785Q-控制面板.SLDPRT, 01A0543735P_CONTROL_PANEL.CATPart, 20213220S008-飛輪護罩.STEP, 20213720S003-飛輪護罩.STEP, 20214720S008-飛輪護罩.STEP, 302B03-衝桿座.STEP, 302CC4S02_BEARING_HOUSING.CATPart]
2023-12-07 整機零件_安全桿整理
    [160R13010-安全桿+YOCBR20-安全桿座.SLDASM, 160R13010-安全桿+YOCBR20-安全桿座.STEP, 160R13010-安全桿.SLDPRT, 160R13010-安全桿.STEP, 160R13010_SAFETY_BLOCK_YOCBR20_BRACKET.CATPart, 30W71-安全桿+YOCBR20-安全桿座.SLDASM, 30W71-安全桿+YOCBR20-安全桿座.STEP, 30W71-安全桿.SLDPRT]
2023-12-11 新稱組立另存STP存檔
2023-12-11 更新零件frame29，移除F
    [FRAME29.CATPart]
2023-12-14 更新7.5HP馬達平面，組立除錯
2023-12-18 組立尺寸修正，STP匯出方式更新
    [FRAME23_1.CATPart, 組立尺寸.xlsx]
2023-12-19 曲軸組立位置更新
2023-12-20 平板相關內容修正
    [01A0532335Q-操作面板箱(PPC9100).SLDPRT, 01A0532335Q-操作面板箱(PPC9100).STEP, 01A0532335Q_PANEL_BOX.CATPart, 01A0532505Q-電器控制箱(PPC9100).SLDPRT, 01A0532505Q-電器控制箱(PPC9100).STEP, 01A0532505Q_PANEL_BOX.CATPart, 01A0532515Q-電器控制箱(PPC9100).SLDPRT, 01A0532515Q-電器控制箱(PPC9100).STEP]
2023-12-26 把原本前後向的喉部變動量zeta砍了，把zeta變為高度的喉部伸長量，計算公式也重新填寫過
    [EWR12S03_PORTABLE_STAND.CATPart, FRAME1.CATPart, FRAME19.CATPart, FRAME2.CATPart, FRAME30.CATPart, FRAME5.CATPart, 組立尺寸.xlsx]
2023-12-27 平板、衝頭大量bug更新
    [01A0532335Q-操作面板箱(PPC9100).SLDPRT, 01A0532335Q-操作面板箱(PPC9100).STEP, 01A0532335Q_PANEL_BOX.CATPart, 01A0532505Q-電器控制箱(PPC9100).SLDPRT, 01A0532505Q-電器控制箱(PPC9100).STEP, 01A0532505Q_PANEL_BOX.CATPart, 01A0532515Q-電器控制箱(PPC9100).SLDPRT, 01A0532515Q-電器控制箱(PPC9100).STEP]
2023-12-27 刪去宣告及FRAME19zeta輸入
    [FRAME19.CATPart, 組立尺寸.xlsx]
2024-01-15 變頻器固定座、安全桿、安全開關、下料頂桿、下料棒、頂桿鎖緊座、吹氣吹料組建(STP件整理)
    [41.頂料裝置.xlsx, 412RR02-吹氣吹料組件.SLDASM, 412RR02-吹氣吹料組件.SLDPRT, 412RR02_EJECTOR_UNIT.CATPart, 43G0004-下料頂桿(H).STEP, 472G05-下料頂桿(P).STEP, 47G0005-下料頂桿(H).STEP, 65.吹氣吹料組件.xlsx]
2024-01-18 200頓組立(缺防震腳
    [452B02S01_CON_ROD_CAP.CATPart, 452B04S02_CON_ROD.CATPart, 組立尺寸.xlsx]
2024-02-02 T溝表格測試檔上傳
